amandalal143/github-demo-noval/Grooving Servo Machine/1. Legal/2. Costing Sheet Servo control panel Maadhave.xlsx

Sheet: Sheet6
Row Labels | Sum of Total Price | last quotation
HMI PANEL | 22544.225 | 25000
MAIN PANEL | 180148.9196 | 155000
SERVO PACKAGE | 49295.4 | 72000
(blank)
Grand Total | 251988.5446 | 252000
 |  | 20000

Sheet: BOM
Sr. No. | Item Description | Drawing Nomenculture | Item Specification | Item make | QTY
1 | PLC | PLC | FX5U-32MT/ES | MITSUBISH | 1
2 | HMI | HMI | GS2107-WTBDN | MITSUBISH | 1
3 | SERVO AMPLIFIER | X AXIS SERVO | MR-J4-70C | MITSUBISH | 1
4 | SERVO MOTOR | - | HG-KR73J | MITSUBISH | 1
5 | SERVO MOTOR POWER CABLE | - | MR-PWS2CBL05M-A2-L | MITSUBISH | 1
6 | SERVO MOTOR ENCODER CABLE | - | MR-J3ENCBL5M-A2-L | MITSUBISH | 1
7 | SERVO AMPLIFIER BATTERY | - | MR-J3CN1 | MITSUBISH | 1
8 | VFD | VFD 01 | FR-D740-050-E16 (2.2K) | MITSUBISH | 1
9 | Proximity Sensors | PH01~PH03 | E2B-M12KS04-WP-C1 | OMRON | 3
10 | REED SWITCH | RS1 ~ RS6 | D-M9ML (NPN) | SMC | 6
11 | REED SWITCH BRACKET | - | BM5-020 | SMC | 2
12 | REED SWITCH BRACKET | - | BJ6-016 | SMC | 2
13 | REED SWITCH BRACKET | - | BMB5-032 | SMC | 2
14 | SMPS | SMPS | S8VK-C06024/ED2 | OMORN | 1
15 | MAIN RCCB | RCCB01 | A9N19668 | SCH | 1
16 | SPINDLE MCB | MCB03 | A9N3P10C | SCH | 1
17 | SERVO POWER MCB | MCB04 | A9N2P06C | SCH | 1
18 | UTILITY MCB | MCB01 | A9N2P06C | SCH | 1
19 | SPINDLE BRAKE MCB | MCB06 | A9N2P06C | SCH | 1
20 | MCB PLC & SMPS | MCB05 | A9N2P06C | SCH | 1
21 | MCB EXHAUST FAN | MCB02 | A9N2P06C | SCH | 1
22 | Main Contactor |  | LC1D32M7 220V AC | SCH | 1
23 | Ethernet HUB | HUB01 | FL1005 | Phoenix | 1
24 | 24DC CP | CP01 | CP30FI2A | FUJI | 1
25 | PANEL EX FAN |  | 4" | GM | 1
26 | FAN FILTER WITH ZALI |  | 4" | GM | 2
27 | PANEL LIGHT |  | ASTRA LINE 5-WATT 1-FEET LED | PHILIPS | 1
28 | DOOR SWITCH |  | ESSOS | ESSOS | 1
29 | TOWER LIGHT |  | MR4-302B-RYG | PATLIGHT | 1
30 | EMG Switch |  | XB5AW74B2N | SCH | 1
31 | RELAY MY2N |  | MY4N WITH BASE | Omron | 9
32 | PUSH BUTTON |  | XB5AA42N | SCH | 3
33 | SELECTOR SWITCH |  | XB5AD53N | SCH | 3
34 | NOISE FILTER | NF01 | RSHN-2006 | TDK | 1

Sheet: Sheet1
Sr. No. | Item Description | Item Specification | Item make | Required Quantity | Item List Price | List Total | Discount | Price | LPP | Profit | Final Price | Total Price | Type | Head | Supplier
1 | PLC | FX5U-32MT/ES | MITSUBISH | 1 | 51300 | 51300 | 60 | 20520 | 21033 | 10 | 22572 | 22572 | SPARE | MAIN PANEL | SK
2 | HMI | GS2107-WTBDN | MITSUBISH | 1 | 13000 | 13000 | 0 | 13000 | 13000 | 10 | 14300 | 14300 | SPARE | HMI PANEL | SK
3 | SERVO AMPLIFIER | MR-J4-70C | MITSUBISH | 1 | 52800 | 52800 | 58 | 22176 | NEW | 10 | 24393.6 | 24393.6 | SPARE | SERVO PACKAGE | SK
4 | SERVO MOTOR | HG-KR73J | MITSUBISH | 1 | 45700 | 45700 | 58 | 19194 | NEW | 10 | 21113.4 | 21113.4 | SPARE | SERVO PACKAGE | SK
5 | SERVO MOTOR POWER CABLE | MR-PWS2CBL05M-A2-L | MITSUBISH | 1 | 1800 | 1800 | 58 | 756 | 4300 | 10 | 831.6 | 831.6 | SPARE | SERVO PACKAGE | SK
6 | SERVO MOTOR ENCODER CABLE | MR-J3ENCBL5M-A2-L | MITSUBISH | 1 | 4300 | 4300 | 58 | 1806 | 4300 | 10 | 1986.6 | 1986.6 | SPARE | SERVO PACKAGE | SK
7 | SERVO AMPLIFIER BATTERY | MR-J3CN1 | MITSUBISH | 1 | 2100 | 2100 | 58 | 882 | 1450 | 10 | 970.2 | 970.2 | SPARE | SERVO PACKAGE | SK
8 | VFD | FR-D740-050-E16 (2.2K) | MITSUBISH | 1 | 41200 | 41200 | 65 | 14420 | 0 | 20 | 17304 | 17304 | SPARE | MAIN PANEL
9 | Proximity Sensors |  | OMRON | 3 | 1700 | 5100 | 0 | 1700 |  | 10 | 1870 | 5610 | SPARE | MAIN PANEL
10 | REED SWITCH | D-M9ML (NPN) | SMC | 6 | 1356 | 8136 | 3 | 1315.32 | 0 | 10 | 1446.852 | 8681.112 | SPARE | MAIN PANEL
11 | REED SWITCH BRACKET | BM5-020 | SMC | 2 | 307 | 614 | 3 | 297.79 | 0 | 10 | 327.569 | 655.138 | SPARE | MAIN PANEL
12 | REED SWITCH BRACKET | BJ6-016 | SMC | 2 | 297 | 594 | 3 | 288.09 | 0 | 10 | 316.899 | 633.798 | SPARE | MAIN PANEL
13 | REED SWITCH BRACKET | BMB5-032 | SMC | 2 | 169 | 338 | 3 | 163.93 | 0 | 10 | 180.323 | 360.646 | SPARE | MAIN PANEL
14 | SMPS | S8VK-C06024/ED2 | OMORN | 1 | 1350 | 1350 | 0 | 1350 | 1350 | 10 | 1485 | 1485 | SPARE | MAIN PANEL | IN STOCK
15 | MAIN RCCB | A9N19668 | SCH | 1 | 6465 | 6465 | 72 | 1810.2 | NEW | 10 | 1991.22 | 1991.22 | SPARE | MAIN PANEL | MUNDHRA
16 | SPINDLE MCB | A9N3P10C | FUJI | 1 | 1355 | 1355 | 75 | 338.75 | 544.25 | 10 | 372.625 | 372.625 | SPARE | MAIN PANEL | MUNDHRA
17 | SERVO POWER MCB | A9N2P06C | FUJI | 1 | 1312 | 1312 | 75 | 328 | 338.75 | 10 | 360.8 | 360.8 | SPARE | MAIN PANEL | MUNDHRA
18 | UTILITY MCB | A9N2P06C | SCH | 2 | 1312 | 2624 | 75 | 328 | 338.75 | 10 | 360.8 | 721.6 | SPARE | MAIN PANEL | IN STOCK
19 | SPINDLE BRAKE MCB |  | SCH | 2 | 1312 | 2624 | 75 | 328 | 0 | 10 | 360.8 | 721.6 | SPARE | MAIN PANEL
20 | Main Contactor | LC1D32M7 220V AC | SCH | 1 | 6015 | 6015 | 62 | 2285.7 | 0 | 10 | 2514.27 | 2514.27 | SPARE | MAIN PANEL
21 | Ethernet HUB | FL1005 | Phoenix | 1 | 4500 | 4500 | 0 | 4500 | 0 | 10 | 4950 | 4950 | SPARE | MAIN PANEL
22 | 24DC CP | CP30FI2A | FUJI | 1 | 2256 | 2256 | 0 | 2256 | 2256 | 10 | 2481.6 | 2481.6 | SPARE | MAIN PANEL | IN STOCK
23 | PANEL EX FAN | 4" | HICOOL | 1 | 300 | 300 | 0 | 300 | 300 | 10 | 330 | 330 | SPARE | MAIN PANEL | MUNDHRA
24 | FAN FILTER WITH ZALI | 4" | GM | 2 | 50 | 100 | 0 | 50 | 50 | 10 | 55 | 110 | SPARE | MAIN PANEL | MUNDHRA
25 | PANEL LIGHT | 4" | PHILIPS | 1 | 279 | 279 | 0 | 279 | 200 | 10 | 306.9 | 306.9 | SPARE | MAIN PANEL | MUNDHRA
26 | DOOR SWITCH | ESSOS | ESSOS | 1 | 250 | 250 | 0 | 250 | 276 | 10 | 275 | 275 | SPARE | MAIN PANEL | IN STOCK
27 | TOWER LIGHT | MR4-302B-RYG | PATLIGHT | 1 | 2860 | 2860 | 0 | 2860 | 2650 | 10 | 3146 | 3146 | SPARE | HMI PANEL | SHEORON CONTROLS
28 | CONTROL PANEL | 600x1000x300 | BCH | 1 | 14555 | 14555 | 35 | 14130 | 9485 | 10 | 15543 | 15543 | SPARE | MAIN PANEL | MUNDHRA
29 | MISCELLIONOUS | (Cables, Thimbles, Duct, Channel etc.) | MAINTICS | 1 | 5000 | 5000 | 0 | 5000 | NA | 10 | 5500 | 5500 | SPARE | MAIN PANEL | MUNDHRA
30 | GOT BOX | 300X400X200 | BCH | 1 | 4855 | 4855 | 35 | 3155.75 | NEW | 10 | 3471.325 | 3471.325 | SPARE | HMI PANEL | MUNDHRA
31 | TERMINALS | UKK5 | Phoenix | 100 | 52.87 | 5287 | 30 | 37.009 | 33.15 | 10 | 40.7099 | 4070.99 | SPARE | MAIN PANEL | MUNDHRA
32 | Terminals | TB16 EI | Phoenix | 6 | 33.13 | 198.78 | 30 | 23.191 | 21.53 | 10 | 25.5101 | 153.0606 | SPARE | MAIN PANEL | MUNDHRA
33 | EMG Switch | RED | SCH | 1 | 1086 | 1086 | 50 | 543 | 490 | 10 | 597.3 | 597.3 | SPARE | HMI PANEL | MUNDHRA
34 | RELAY MY4N | MY4N WITH BASE | Omron | 0 | 210 | 0 | 0 | 210 | 230 | 10 | 231 | 0 | SPARE | MAIN PANEL | IN STOCK
35 | RELAY MY2N | MY4N WITH BASE | Omron | 9 | 210 | 1890 | 0 | 210 | 230 | 10 | 231 | 2079 | SPARE | MAIN PANEL | IN STOCK
36 | PUSH BUTTON | MULTICOLOR | SCH | 3 | 180 | 540 | 50 | 90 | 190 | 10 | 99 | 297 | SPARE | HMI PANEL | MUNDHRA
37 | SELECTOR SWITCH | 2 POS | SCH | 3 | 444 | 1332 | 50 | 222 | 190 | 10 | 244.2 | 732.6 | SPARE | HMI PANEL | MUNDHRA
38 | SPINLDE BRAKE CONTACTOR | SC 11 A G-E 10 | FUJI | 1 | 3770 | 3770 | 52 | 1809.6 | NEW | 10 | 1990.56 | 1990.56 | SPARE | MAIN PANEL | MUNDHRA
39 | NOISE FILTER | RSHN-2006 | TDK | 1 | 3250 | 3250 | 0 | 3250 | 3250 | 10 | 3575 | 3575 | SPARE | MAIN PANEL | IN STOCK
40 | PANEL LABOUR |  | MAINTICS | 0 | 22000 | 0 | 10 | 19800 | NA | 0 | 19800 | 0 | SERVICE | MAIN PANEL | MAINTICS
41 | PROGRAMMING LABOUR |  | MAINTICS | 1 | 80000 | 80000 | 6.5 | 74800 | NA | 0 | 74800 | 74800 | SERVICE | MAIN PANEL | MAINTICS
