amandalal143/github-demo-noval/Grooving Servo Machine/4. Drawing and Manual/PLC IO MAPPING.xlsx

Sr. No. | Input No | Description | Output No | Description
 | X0 | AUTO/MANUAL SS | Y00 | AUTO RUN IL
 | X1 | AUTO START PB | Y01 | PATLIGHT RED & BUZZER
 | X2 | AUTO STOP PB | Y02 | PATLIGHT Y
 | X3 | JOG FWD SS | Y03 | PATLIGHT G
 | X4 | JOG REV SS | Y04 | COOLANT PUMP
 | X5 | EMG SWITCH EMG | Y05 | VFD FWD RUN
 | X6 | VFD ALARM | Y06 | VFD ALARM RESET
 | X7 | MACHINE HOME PH | Y07 | FEED CYL RS FWD
 | X10 | FWD LIMIT PH | Y10 | FEED CYL RS REV
 | X11 | REV LIMIT PH | Y11 | MAT CYL RS FWD
 | X12 | FEED CYL RS FWD | Y12 | MAT CYL RS REV
 | X13 | FEED CYL RS REV | Y13 | CLAMP CYL RS FWD
 | X14 | MAT CYL RS FWD | Y14 | CLAMP CYL RS REV
 | X15 | MAT CYL RS REV | Y15
 | X16 | CLAMP CYL RS FWD | Y16
 | X17 | CLAMP CYL RS REV | Y17
