amandalal143/github-demo-noval/(list of files, cad)

Other CAD files:
Grooving Servo Machine/4. Drawing and Manual/Groove cutting machine drawing (1).dwg
