amandalal143/github-demo-noval/Grooving Servo Machine/4. Drawing and Manual/Maadhav Operation Manual.pptx

MAADHAV AUTOMOTIVE
FASTENERS PVT. LTD.

Product Manual

GROOVING MACHINE 02
(Electrical Renewal Project)
Done By
MAINTICS AUTOMATION & ROBOTICS LLP

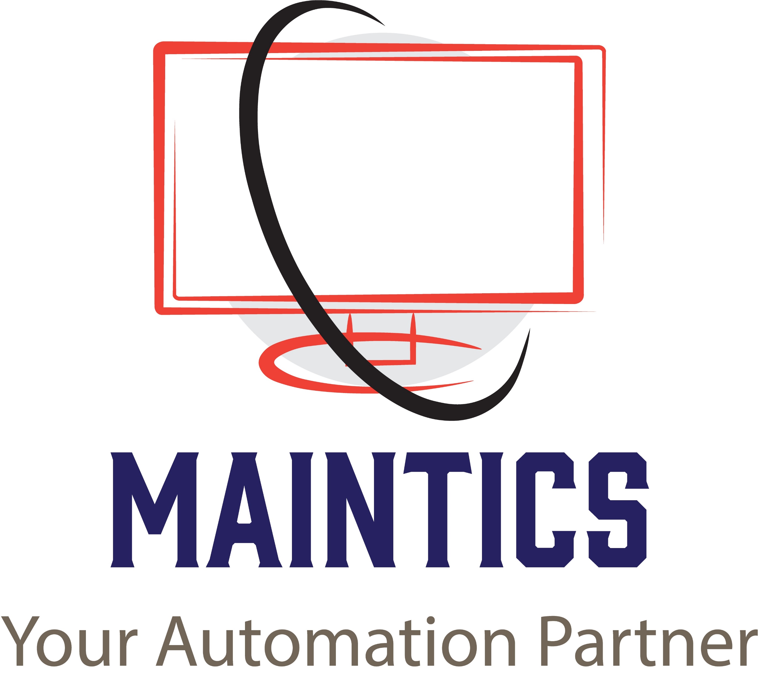
[picture p1: figure]

## Table Of Contents

- Operation Manual
- Electrical Drawing
- Troubleshooting Guide
- BOM (Bill of Material)

(C) Maintics Automation & Robotics LLP

## Slide 3

Operation Manual

## Company Profile Screen

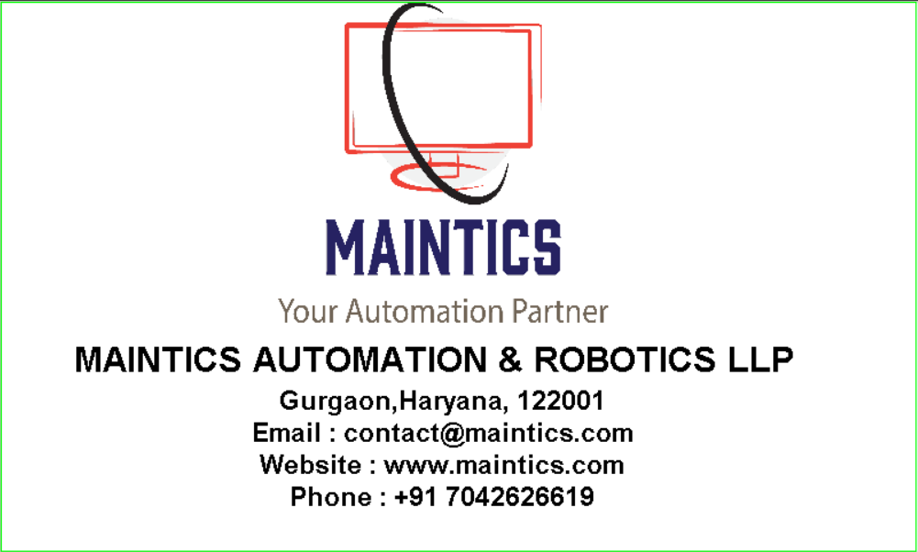
[picture p2: figure]

At first when you turn on the Machine this screen will open.
This is the Company Introduction screen.
Click anywhere in the screen to navigate on Main Menu

## 1. MAIN MENU SCREEN

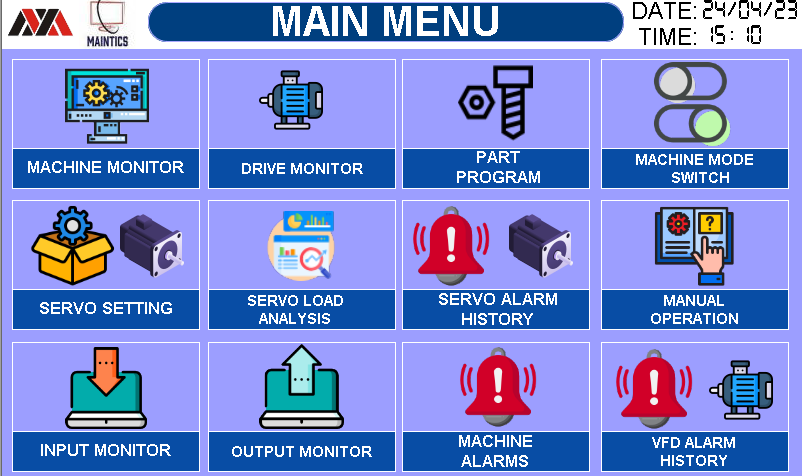
[picture p3: figure]

This Screen is for Navigation inside the HMI of below screens.
Below are the list of all available screen in the HMI.
1. MACHINE MONITOR
2. DRIVE MONITOR
3. PART PROGRAM
4. MACHINE MODE SWITCH
5. SERVO SETTING
6. SERVO LOAD ANALYSIS
7. SERVO ALARM HISTORY
8. MANUAL OPERATION
9. INPUT MONITOR
10. OUTPUT MONITOR
11. MACHINE ALARMS
12. VFD ALARMS HISTORY

## 2. PROCESS MONITOR SCREEN

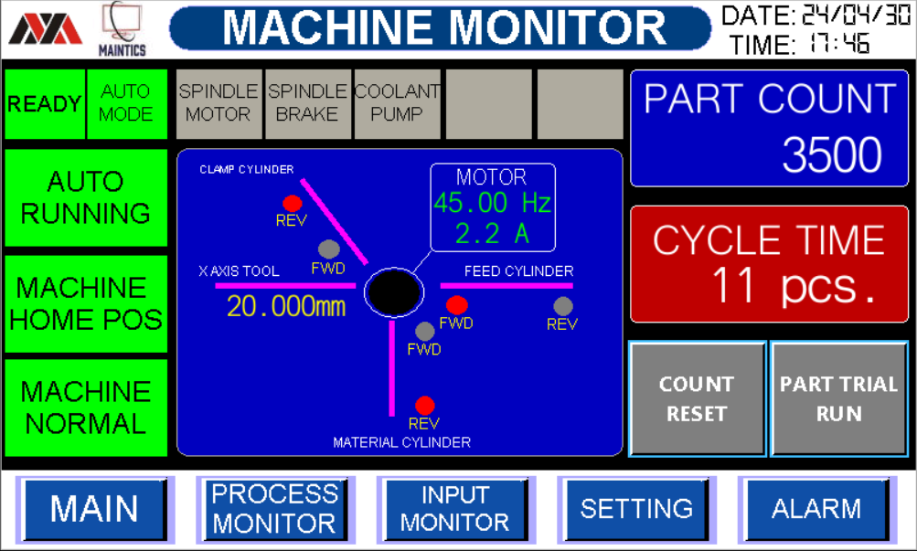
[picture p4: figure]

This screen is to Monitor Whole machine at Single Place

1. Machine Ready Status
2. Machine Auto / Manual Mode Status
3. Machine Auto Running Status
4. Device Running Status
5. Home Position Indication and Fault Indication

Machine Stopped

Not Ready

Ready

Manual Mode

Auto Mode

Auto Running

Device Running

Device OFF

Not at Home

Normal

Fault

Machine at Home

## Slide 7

2. PROCESS MONITOR SCREEN

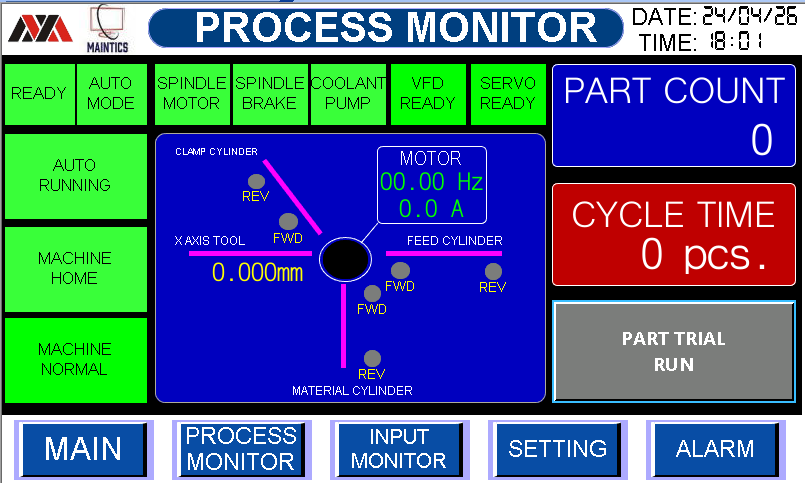
[picture p5: figure]

This screen is to Monitor Whole machine at Single Place

6. Total Parts count Cumulative and Cycle time Parts/min.
7. Machine Inputs Monitoring (Cylinder Reed switch)
8. Navigation Bar

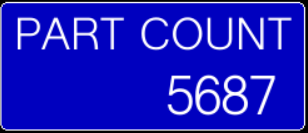
[picture p6: figure]
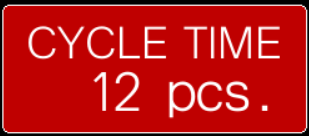
[picture p7: figure]

Here you can monitor all reed switch condition On or Off.
- Feed Cylinder
- Material Cylinder
- Clamp Cylinder
- X Axis Cylinder
- Y Axis Cylinder
- SPINDLE MOTOR STATUS

Used to easily navigate from one screen to another screen

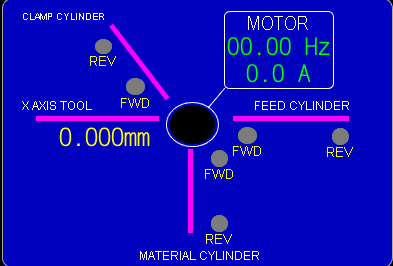
[picture p8: figure]

## Slide 8

3.INPUT MONITOR SCREEN

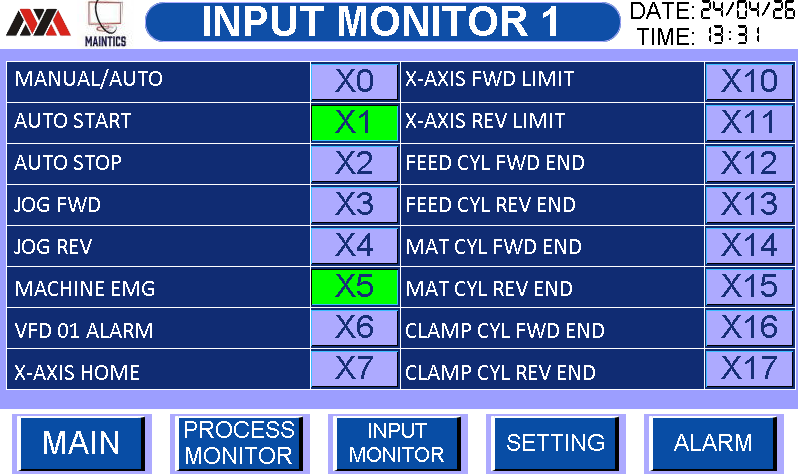
[picture p9: figure]

This screen is to monitor all PLC Inputs total 16 Nos.

1. All inputs status from Off to On is as below

INPUT OFF

INPUT ON

MACHINE EMARGENCY PRESSED

MACHINE EMARGENCY NOT PRRESSED

## Slide 9

4. OUTPUT MONITOR SCREEN

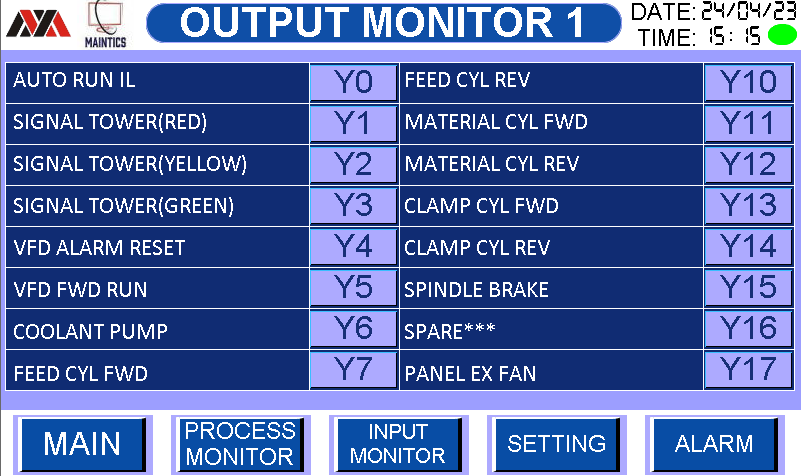
[picture p10: figure]

This screen is to monitor all PLC Outputs total 16Nos.

1. All Output status from Off to On is as below

OFF
ON

## Slide 10

5. ALARM MONITOR SCREEN

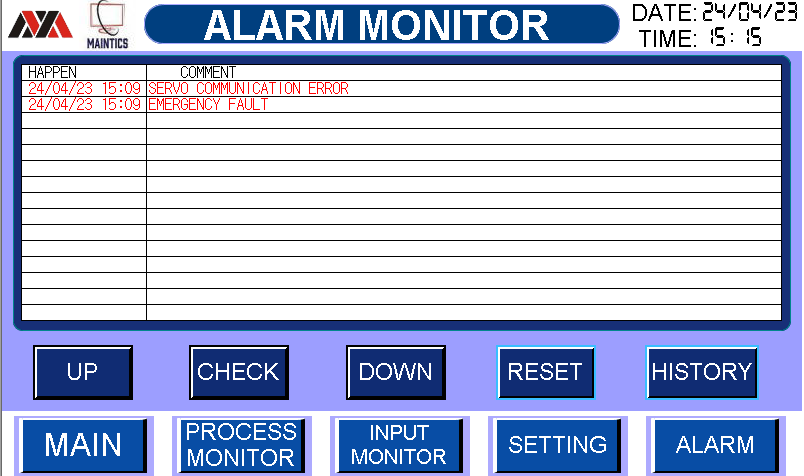
[picture p11: figure]

This screen is used to monitor machine current alarms

1. Alarm screen navigation buttons
2. Reset button to reset current Alarms
3. Alarm History Screen access Button

## Slide 11

5. ALARM HISTORY SCREEN

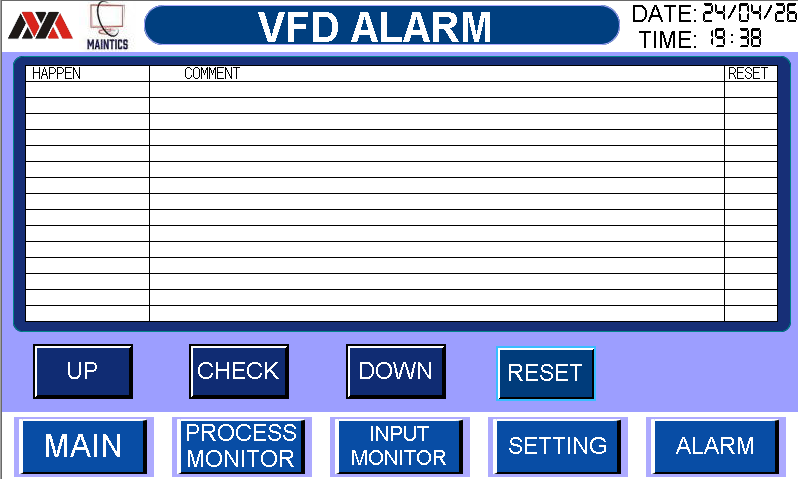
[picture p12: figure]
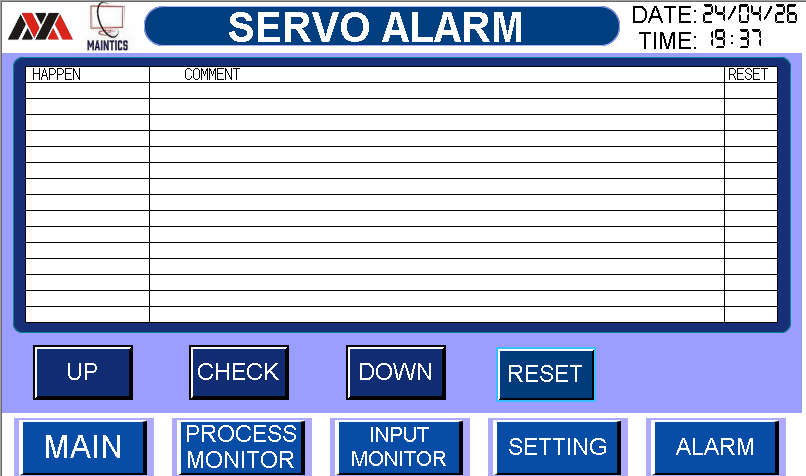
[picture p13: figure]

This screen is used to monitor machine current alarms

1. Alarm screen navigation buttons

## Slide 12

6. MODE SELECT SETTING SCREEN

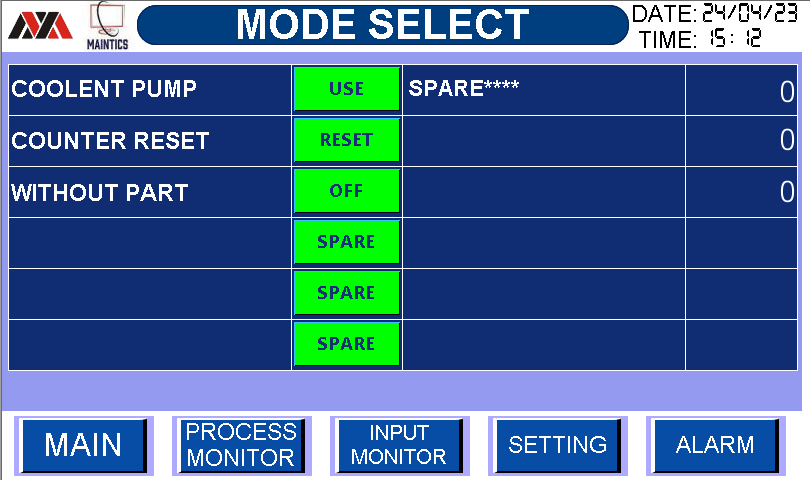
[picture p14: figure]
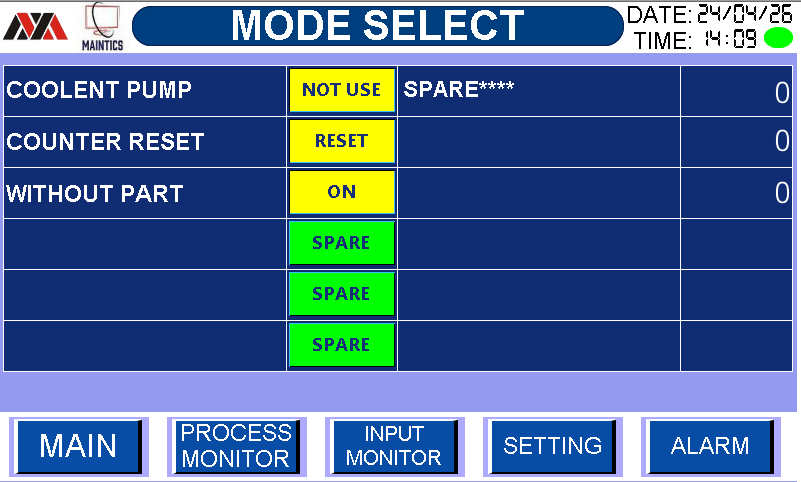
[picture p15: figure]

Machine Settings can be done from this screen.

1. COOLENT PUMP USE
2. COOLENT PUMP NOT USE
3. COUNTER RESET
4. WITHOUT PART OFF
5. WITHOUT PART ON

## Slide 13

7. MANUAL OPEARTION 1 SCREEN

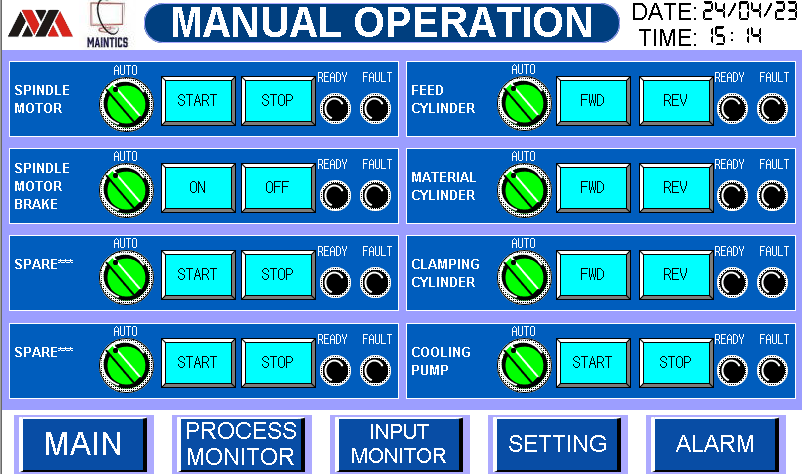
[picture p16: figure]

Manual Operation of all device can be performed using this screen

1. Steps for manual operation
  a. First check Fault Light it should be Off
  b. Now check Ready Light it should be Green
  c. Now press Auto Manual selector switch to change mode from Auto to manual
  d. Now Press Start Button to Start the Device
  e. It will glow green if device is started.

## Slide 14

8. PART PROGRAM SCREEN

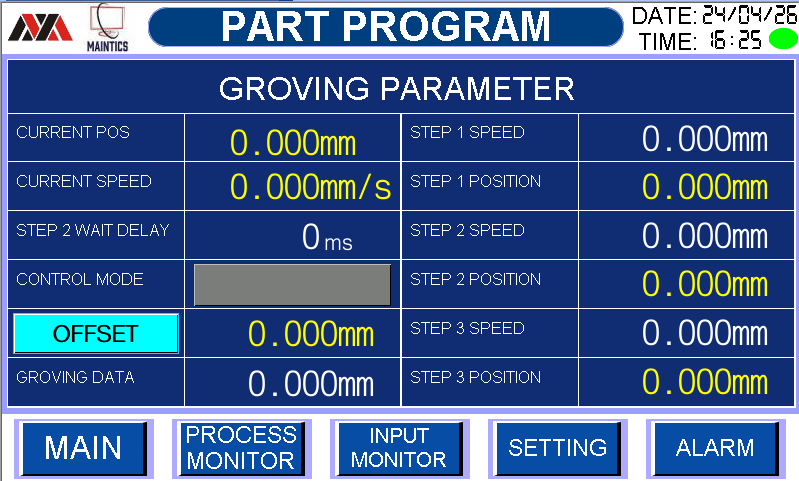
[picture p17: figure]

Here you can change grooving Program
1. STEP 2WAIT DELAY VALUE 6. STEP 3 SPEED VALUE
2. OFFSET VALUE
3. GRONING DATA VALUE
4. STEP 1 SPEE VALUE
5. STEP 2 SPEED VALUE

## Slide 15

8. PART PROGRAM SCREEN

Here you can change grooving Program
1. STEP 2WAIT DELAY VALUE 6. STEP 3 SPEED VALUE
2. OFFSET VALUE
3. GRONING DATA VALUE
4. STEP 1 SPEE VALUE
5. STEP 2 SPEED VALUE

## SERVO LOAD GRAPH

9. SERVO LOAD SCREEN

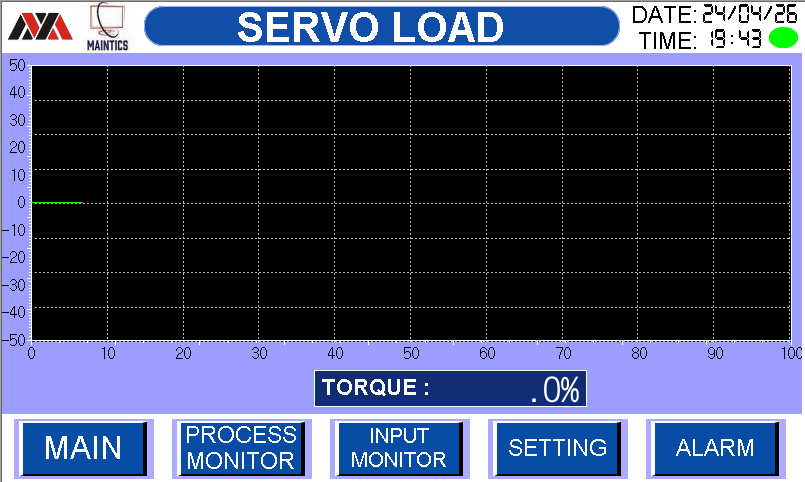
[picture p18: figure]

## Slide 17

10. SERVO SETTING SCREEN

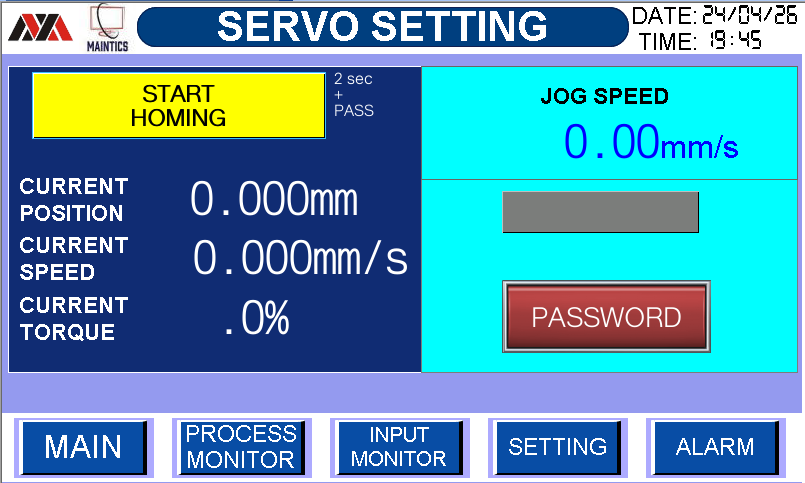
[picture p19: figure]

SERVO MOTOR HOMING STATUS
1. CURRENT OPSOTION (0.000MM)
2. CURRENT SPEED (0.000MM/s)
3. CURRENT TORQUE (0.0%)

SERVO MOTOR JOG SPEED
1. JOG SPEED MIN MAX
(0.01mm/s) (10.00mm/s)

## Slide 18

11. DRIVE MONITOR SCREEN

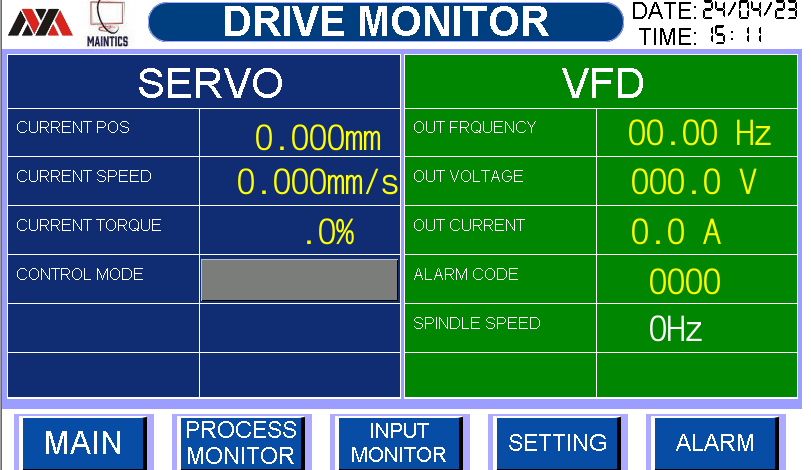
[picture p20: figure]

DRIVE MONITOR STATUS
1. Here you can monitor SERVO & VFD STATUS
2. Here you can change SPINDLE SPEED
MIN MAX
25Hz 60Hz

## Electrical Drawings

## Troubleshooting Guide

## Slide 21

1. HMI ALARM GUIDE

## Slide 22

2. MACHINE AUTO RUNNING FLOW

STOP

START PB

MACHINE HOME

MACHINE AUTO

Check Reed Switch
X20, X22 if NO

NO

YES

Check Manual Screen
If NO

NO

YES

Check Alarm Screen
For any alarm reset alarm before if NO

MACHINE NORMAL

NO (FAULT)

YES

AUTO RUNNING

## BOM (BILL OF MATERIAL)

## Slide 24

1. LIST OF ITEMS USED
