amandalal143/github-demo-noval/Grooving Servo Machine/4. Drawing and Manual/Maadhav Operation Manual02 v3.pptx

MAADHAV AUTOMOTIVE
FASTENERS PVT. LTD.

Product Manual

GROOVING MACHINE 02
(Electrical Renewal Project)
Done By
MAINTICS AUTOMATION & ROBOTICS LLP


## Table Of Contents

1. Operation Manual
2. Electrical Drawing
3. Troubleshooting Guide
4. BOM (Bill of Material)
5. Device Manual/Catalogue

(C) Maintics Automation & Robotics LLP

## Slide 3

Operation Manual

## Company Profile Screen


At first when you turn on the Machine this screen will open.
This is the Company Introduction screen.
Click anywhere in the screen to navigate on Main Menu

## MAIN MENU SCREEN

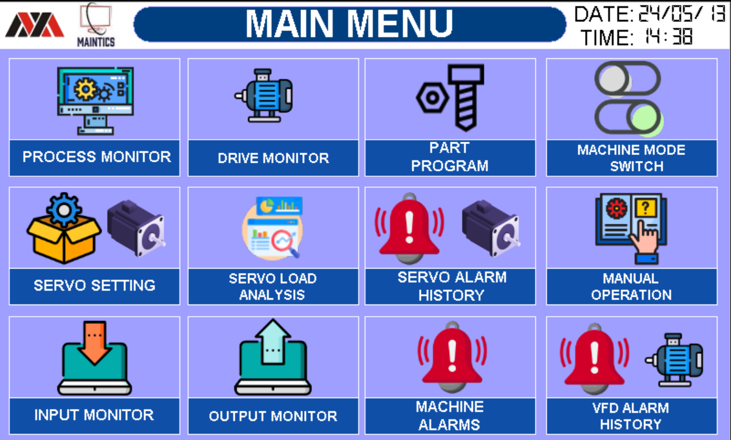
[picture p21: figure]

This Screen is for Navigation inside the HMI of below screens.
Below are the list of all available screen in the HMI.
1. PROCESS MONITOR
2. DRIVE MONITOR
3. PART PROGRAM
4. MACHINE MODE SWITCH
5. SERVO SETTING
6. SERVO LOAD ANALYSIS
7. SERVO ALARM HISTORY
8. MANUAL OPERATION
9. INPUT MONITOR
10. OUTPUT MONITOR
11. MACHINE ALARMS
12. VFD ALARMS HISTORY

## 1. PROCESS MONITOR SCREEN

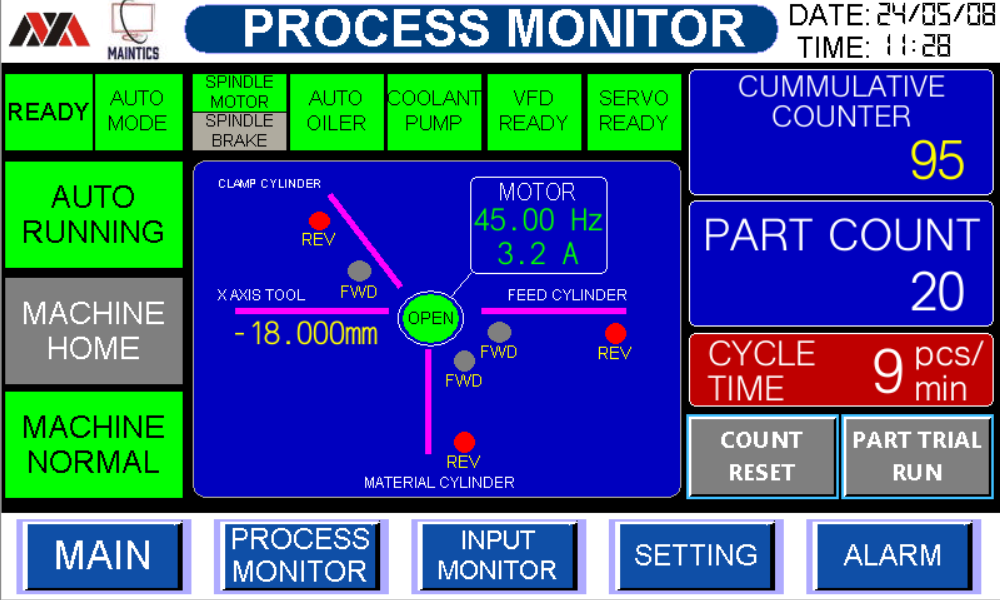
[picture p22: figure]

This screen is to Monitor Whole machine at Single Place

1

2

2

2

Sr. No. | Parameter Name | State 0 | State 1 | State 2 | Remarks
1 | Machine Ready | Not Ready | Ready | | Machine ready status
2 | Manual Mode | Manual Mode | Auto Mode
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
1. Machine Ready Status
2. Machine Auto / Manual Mode Status
3. Machine Auto Running Status
4. Device Running Status
5. Home Position Indication and Fault Indication

Device OFF

Device Running

Not at Home

Normal

Machine at Home

Machine Fault

## Slide 7

1. PROCESS MONITOR SCREEN

This screen is used to Machine Monitor current alarms & Status

6. Servo & VFD Alarm Status

Servo & VFD Alarm ON SERVO & VFD Is Ready to Use

7. COUNTER RESET & PART TRIAL RUN Status

*Counter Reset Button is ON

To Reset Part Count, Press this Button for 2second.

*Part trial Button is ON

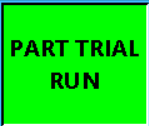
[picture p23: figure]

This Button used for part trial.

(Machine for run for 1cycle only)

## Slide 8

1. PROCESS MONITOR SCREEN

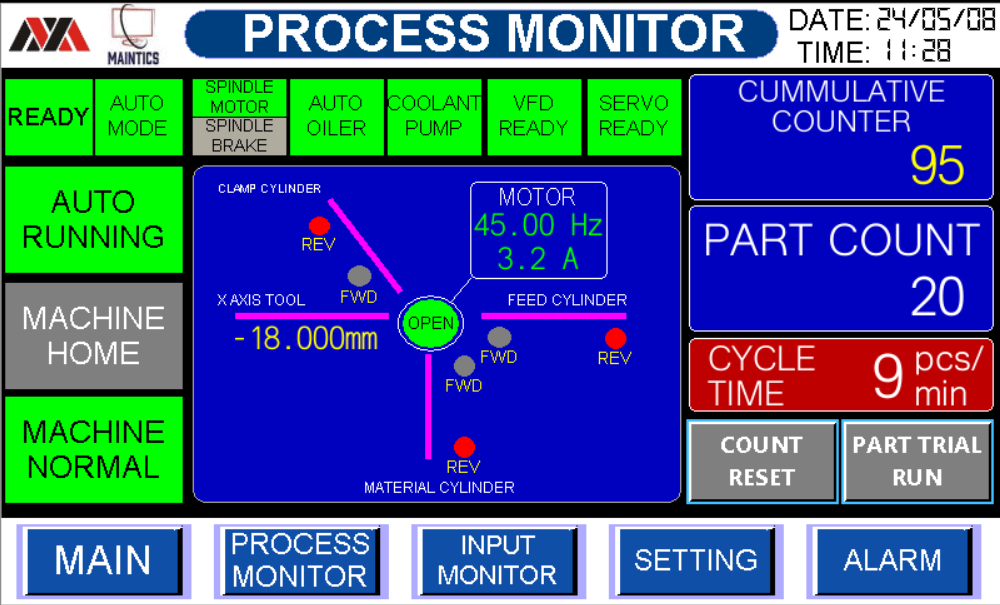
[picture p24: figure]

This screen is to Monitor Whole machine at Single Place

8. Total Parts count & Cumulative Counter and Cycle time … Parts/min.
9. Machine Inputs Monitoring (Cylinder Reed switch)
10. Navigation Bar

Here you can monitor all reed switch condition On or Off.
- Feed Cylinder
- Material Cylinder
- Clamp Cylinder
- X Axis Servo position
- SPINDLE MOTOR STATUS
(Monitor Running Frequency & Current)

Used to easily navigate from one screen to another screen

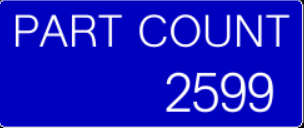
[picture p25: figure]
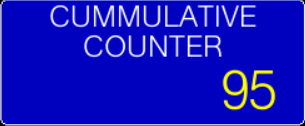
[picture p26: figure]
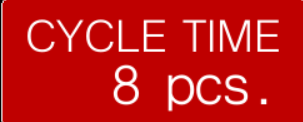
[picture p27: figure]
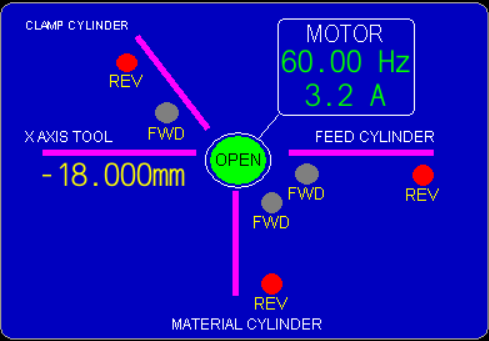
[picture p28: figure]

## Slide 9

2. DRIVE MONITOR SCREEN

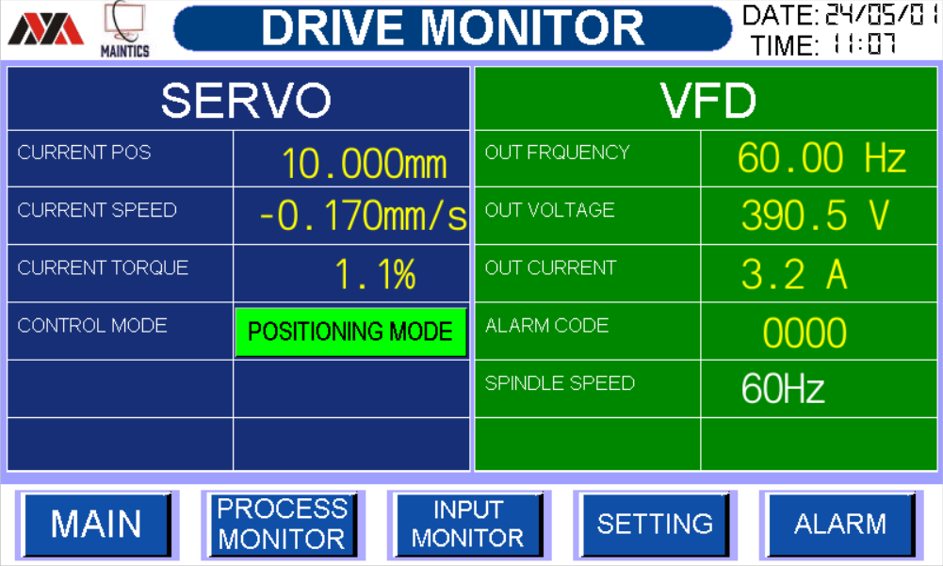
[picture p29: figure]

DRIVE MONITOR STATUS:
1. Here you can monitor SERVO & VFD STATUS.
SERVO:
a) Here you can monitor servo current position.
b) Here you can monitor servo current speed.
c) Here you can monitor servo Current Torque.
VFD:
a) Here you can monitor VFD Frequency.
b) Here you can monitor VFD Voltage.
c) Here you can monitor VFD Current.
d) Here you can monitor VFD Alarm Code.
2. Here you can change SPINDLE SPEED Using Frequency (Hz)
MIN MAX
25Hz 60Hz

## Slide 10

3. PART PROGRAM SCREEN

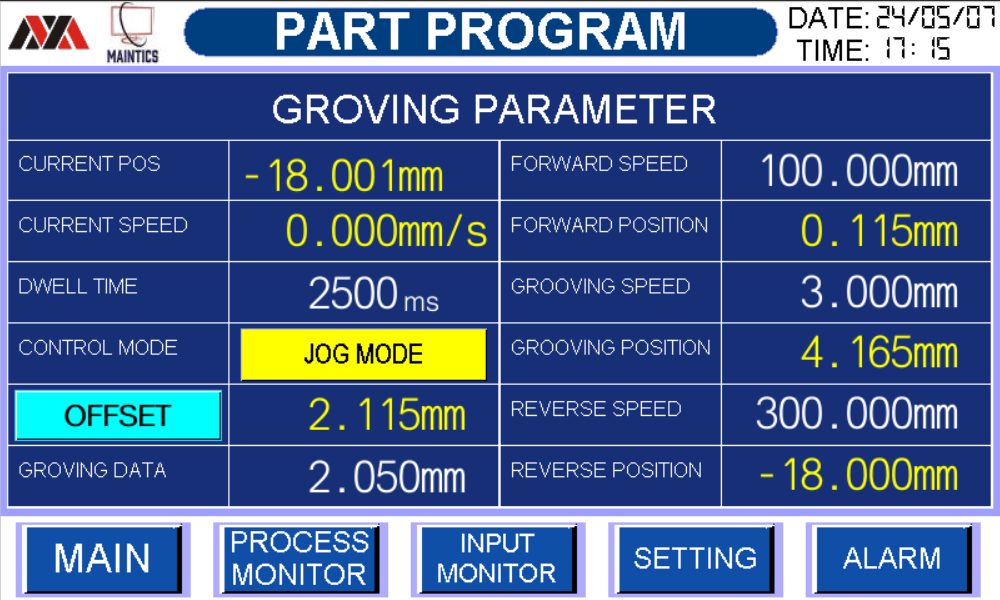
[picture p30: figure]

1. Here you can change grooving Program.
a) DWELL VALUE. * (Here you Can Change Dwell
time in milliseconds )
b) OFFSET VALUE. * (Here you can set Part Offset
Value Press button to get offset value)
c) GROOVING DATA VALUE. * (Here you can set Grooving
Data Value.)
d) FORWARD SPEED VALUE. * (Here you can set Servo
Forward SPEED VALUE.)
e) GROOVING SPEED VALUE. * (Here you can set Servo
Grooving SPEED VALUE.)

## Slide 11

3. PART PROGRAM SCREEN

1. Here you can change grooving Program

f) Reverse SPEED VALUE (Here you can change
Servo Reverse Speed
Value. )

2. Here you can monitor Positioning mode &
Jog mode
a) Here You can Check
POSITION MODE is ON .
b) Here You can Check Jog
MODE is ON .

## Slide 12

4. MODE SELECT SETTING SCREEN

Machine Settings can be done from this screen.

1. COOLENT PUMP ON Condition
2. COOLENT PUMP Off (Bypass) Condition
3. COUNTER RESET BUTTION
4. WITHOUT Part OFF Condition
5. WITHOUT Part ON Condition (Machine run without part also)

## Slide 13

4. MODE SELECT SETTING SCREEN

Machine Settings can be done from this screen.

6. OILER DELAY Cycle
* Here you can change Oiler Delay Cycle value.
(After 1000 parts cycle Oiler pump will ON)
7. OILER RUN TIME Sec.
* Here you can change Oiler Run Time Sec.
(After 1000 parts pump ON for 10sec.)
8. COMMULATIVE COUNTER RESET BUTTION
9. AUTO OILER ON Condition (Press this button to run pump manually )

## Slide 14

4. MODE SELECT SETTING SCREEN

Machine Settings can be done from this screen.

10. Here You can decide the value of current torque ,part detect lower torque and part detect upper torque.
First note down the value of torque when part is available in the machine ,and also note the value of torque when part is not available in the machine. Perform this operation for at least 4 to 5 times. You can observe torque is always greater when part is available with respect to when part is not available in the machine.
Now according to the observation of torque value you can fill the value of
11. PART DETECT LOWER AND PART DETECT UPPER VALUE.
Make sure current torque value (when part is available) is within the range of part detect lower and upper torque value.

## Slide 15

4. MODE SELECT SETTING SCREEN

Machine Settings can be done from this screen.

11. PART DETECT LOWER
* Here You Can Change part Detect Lower Value.
12. PART DETECT UPPER
* Here You Can Change Part Detect Upper Value.
13. Here You Can Check Live SERVO MOTOR TORQUE.
* Make sure current torque(When part is present) is within the range of part detect lower & upper value then it part is counted by counter And if this condition is not
satisfied the part will not count.

## Slide 16

05. SERVO SETTING SCREEN

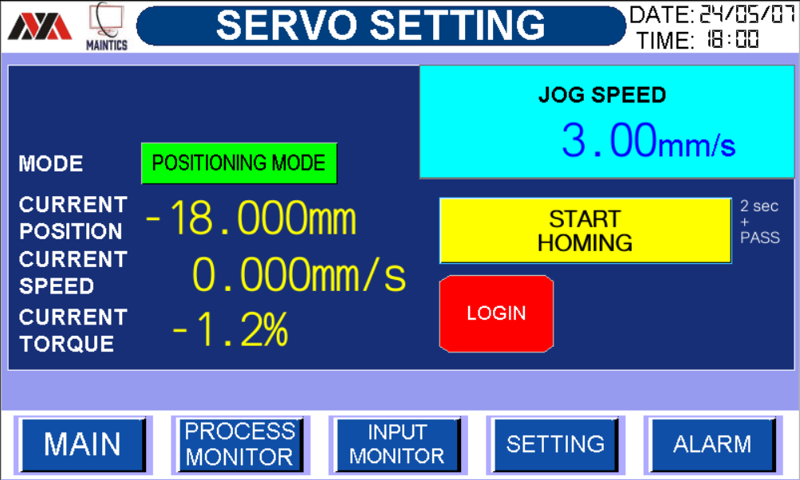
[picture p31: figure]

* Here you can enter the Required Password.

- Here you can monitor entered Password is correct
. And after homing complete 1cycle Logout Automatically.

1. SERVO MOTOR [JOG SPEED.]
JOG SPEED MIN MAX
(0.01mm/s) (25.00mm/s)

## Slide 17

05. SERVO SETTING SCREEN

2. SERVO MOTOR [HOMING MONITORING STATUS]
a) SERVO CURRENT POSITION (-18.000mm)
b) SERVO CURRENT SPEED (0.000mm/s)
c) SERVO CURRENT TORQUE (-1.2%)

3. SERVO HOMING

a) Here you can enter password by clicking on Login Button, Now Press START HOMING Button for 2 Second and servo will Start homing Automatically (Pass: 12345)

* Machine Homing Button OFF.

* Machine Homing is in progress.

* Machine Homing Mode is ON.

## Slide 18

06. SERVO LOAD SCREEN

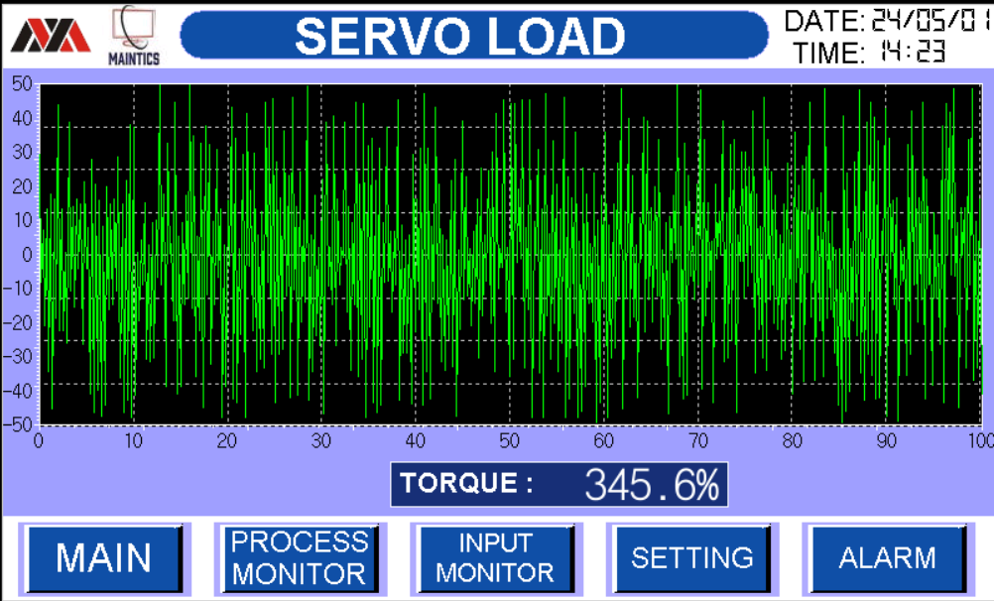
[picture p32: figure]

1. SERVO LOAD GRAPH
  a. You Can monitor servo Torque Live Trend.

## Slide 19

07/12. SERVO+VFD ALARM HISTORY

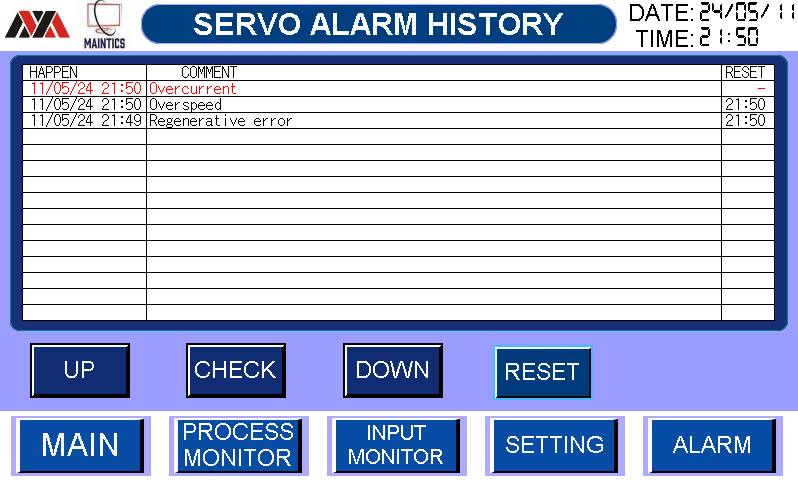
[picture p33: figure]
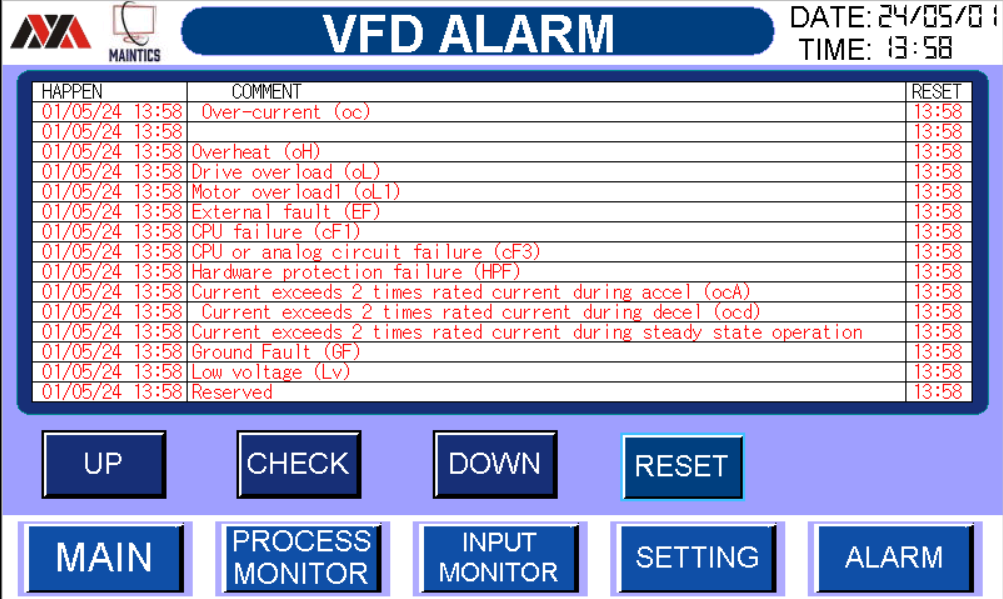
[picture p34: figure]

This screen is used to monitor machine current alarms

1. Alarm screen navigation buttons
2. Reset button to reset current Alarms
3. Alarm History Screen access Button

## Slide 20

08. MANUAL OPEARTION SCREEN


Manual Operation of all device can be performed using this screen

1. Steps for manual operation
  a. First check Fault Light it should be Off(BLACK)
  b. Now check Ready Light it should be Green
  c. Now press Auto Manual selector switch(HMI) to change mode from Auto to manual
  d. Now Press Start Button to Start the Device
  e. It will glow green if device is started.

## Slide 21

09. INPUT MONITOR SCREEN


This screen is to monitor all PLC Inputs total 16 Nos.

1. All inputs status from Off to On is as below.

INPUT OFF

INPUT ON

MACHINE EMARGENCY PRESSED

MACHINE EMARGENCY NOT PRRESSED

## Slide 22

10. OUTPUT MONITOR SCREEN

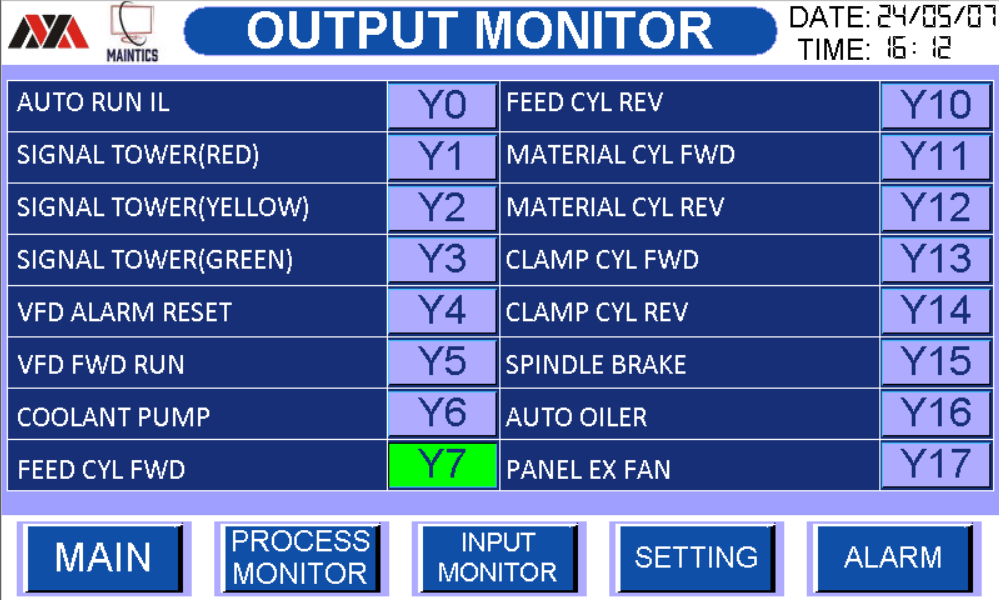
[picture p35: figure]

This screen is to monitor all PLC Outputs total 16Nos.

1. All Output status from Off to On is as below.

OFF
ON

## Slide 23

11. MACHINE ALARM MONITOR

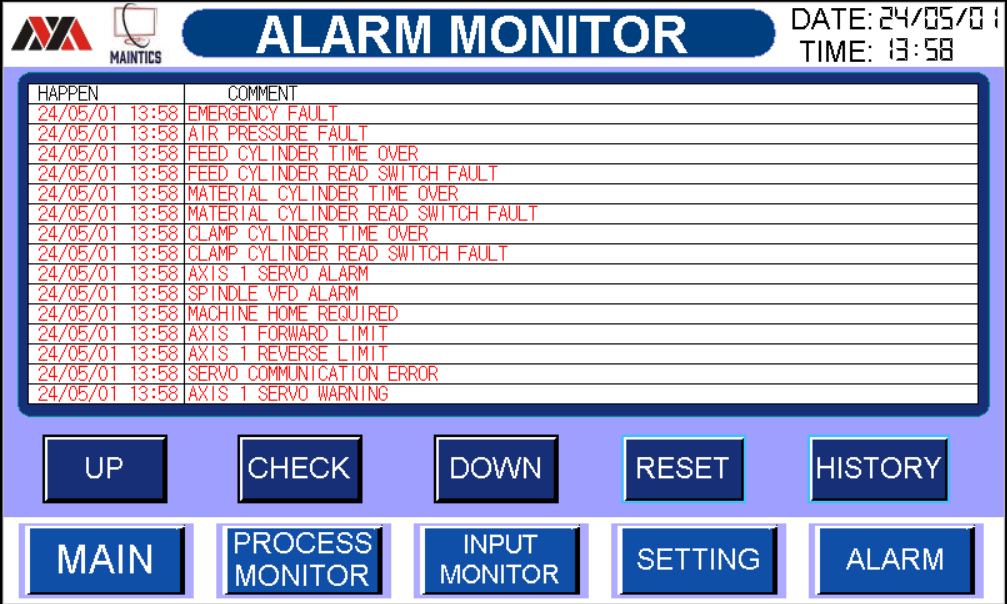
[picture p36: figure]

This screen is used to monitor machine current alarms

1. Alarm screen navigation buttons
2. Reset button to reset current Alarms
3. Alarm History Screen access Button

## Electrical Drawings

## Troubleshooting Guide

## Slide 26

1. HMI ALARM GUIDE

## Slide 27

1. HMI ALARM GUIDE

## Slide 28

2. MACHINE AUTO RUNNING FLOW

STOP

START PB

MACHINE HOME

MACHINE AUTO

Check Reed Switch &
Slide position

NO

YES

Check Manual Screen
If NO

NO

YES

Check Alarm Screen
For any alarm reset alarm before if NO

MACHINE NORMAL

NO (FAULT)

YES

AUTO RUNNING

## BOM (BILL OF MATERIAL)

## Slide 30

1. LIST OF ITEMS USED
