amandalal143/github-demo-noval/Grooving Servo Machine/4. Drawing and Manual/Maadhav Operation Manual02.pptx

## GROOVING MACHINE 02 MANUAL

Project Description : Grooving Machine 02 Hydraulic to Servo
Customer Name :Maadhav Automotive Fasteners Pvt. Ltd.
Order Number : NA
Order Date :15/03/2024

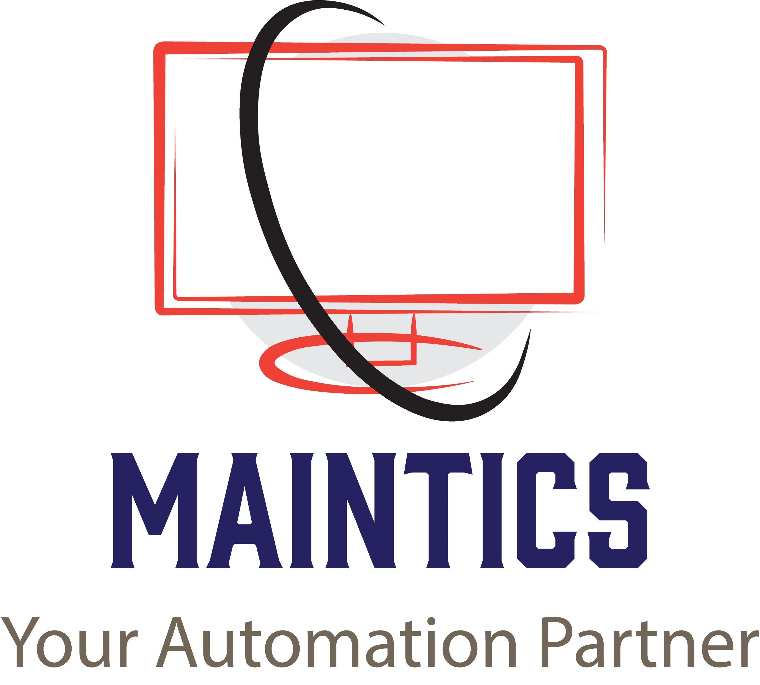
[picture p37: figure]

Developed By:
MAINTICS AUTOMATION & ROBOTICS LLP
Email : contact@maintics.com
Phone: +91 7042626619
Website : www.maintics.com

## GROOVING MACHINE 02 MANUAL

Project Description : Grooving Machine 02 Hydraulic to Servo
Customer Name :Maadhav Automotive Fasteners Pvt. Ltd.
Order Number : NA
Order Date :15/03/2024

© MAINTICS AUTOMATION & ROBOTICS LLP

## Table Of Contents

- Operation Manual
- Electrical Drawing
- Troubleshooting Guide
- BOM (Bill of Material)

(C) Maintics Automation & Robotics LLP

## Slide 4

Operation Manual

## Company Profile Screen


At first when you turn on the Machine this screen will open.
This is the Company Introduction screen.
Click anywhere in the screen to navigate on Main Menu

## 1. MAIN MENU SCREEN


This Screen is for Navigation inside the HMI of below screens.
Below are the list of all available screen in the HMI.
1. MACHINE MONITOR
2. DRIVE MONITOR
3. PART PROGRAM
4. MACHINE MODE SWITCH
5. SERVO SETTING
6. SERVO LOAD ANALYSIS
7. SERVO ALARM HISTORY
8. MANUAL OPERATION
9. INPUT MONITOR
10. OUTPUT MONITOR
11. MACHINE ALARMS
12. VFD ALARMS HISTORY

## 2. PROCESS MONITOR SCREEN

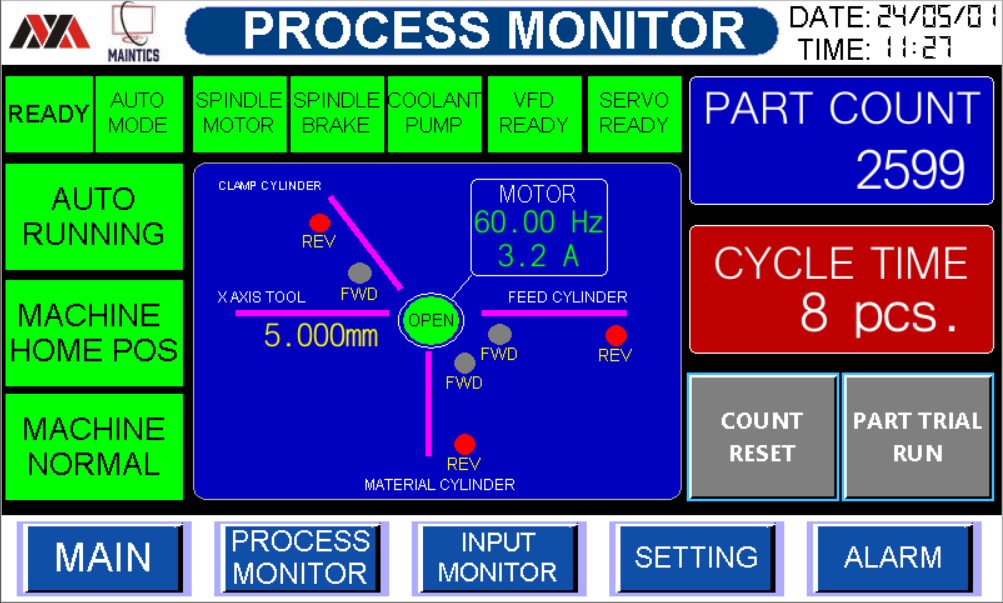
[picture p38: figure]

This screen is to Monitor Whole machine at Single Place

1. Machine Ready Status
2. Machine Auto / Manual Mode Status
3. Machine Auto Running Status
4. Device Running Status
5. Home Position Indication and Fault Indication

Machine Stopped

Not Ready

Ready

Manual Mode

Auto Mode

Auto Running

Machine at Home

Device Running

Device OFF

Not at Home

Normal

Fault

## Slide 8

2. PROCESS MONITOR SCREEN

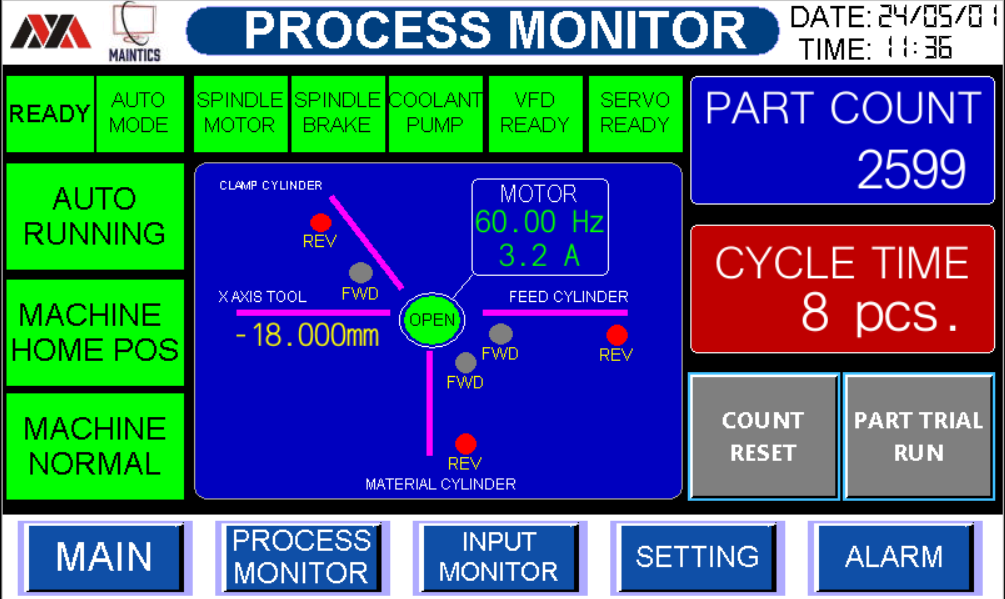
[picture p39: figure]

This screen is to Monitor Whole machine at Single Place

6. Total Parts count Cumulative and Cycle time Parts/min.
7. Machine Inputs Monitoring (Cylinder Reed switch)
8. Navigation Bar

Here you can monitor all reed switch condition On or Off.
- Feed Cylinder
- Material Cylinder
- Clamp Cylinder
- X Axis Cylinder
- Y Axis Cylinder
- SPINDLE MOTOR STATUS

Used to easily navigate from one screen to another screen


## Slide 9

2. PROCESS MONITOR SCREEN

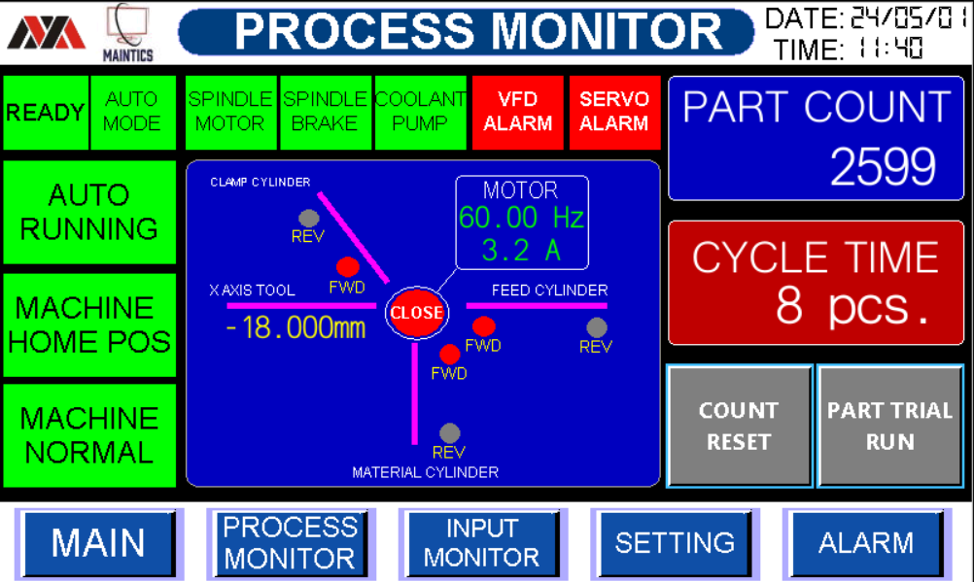
[picture p40: figure]

This screen is used to Machine Monitor current alarms & Status

1. Servo & VFD Alarm Status

Servo & VFD Alarm ON SERVO & VFD Is Ready to Use

2. COUNTER RESET & PART TRIAL RUN Status

Counter Reset Buttion is ON

Part triali Buttion is ON


Here you can Press
PART COUNTER RESET ON

Here you can Press PART TRIAL is ON

## Slide 10

3.INPUT MONITOR SCREEN


This screen is to monitor all PLC Inputs total 16 Nos.

1. All inputs status from Off to On is as below

INPUT OFF

INPUT ON

MACHINE EMARGENCY PRESSED

MACHINE EMARGENCY NOT PRRESSED

## Slide 11

4. OUTPUT MONITOR SCREEN


This screen is to monitor all PLC Outputs total 16Nos.

1. All Output status from Off to On is as below

OFF
ON

## Slide 12

5. ALARM MONITOR SCREEN


This screen is used to monitor machine current alarms

1. Alarm screen navigation buttons
2. Reset button to reset current Alarms
3. Alarm History Screen access Button

## Slide 13

5. ALARM HISTORY SCREEN

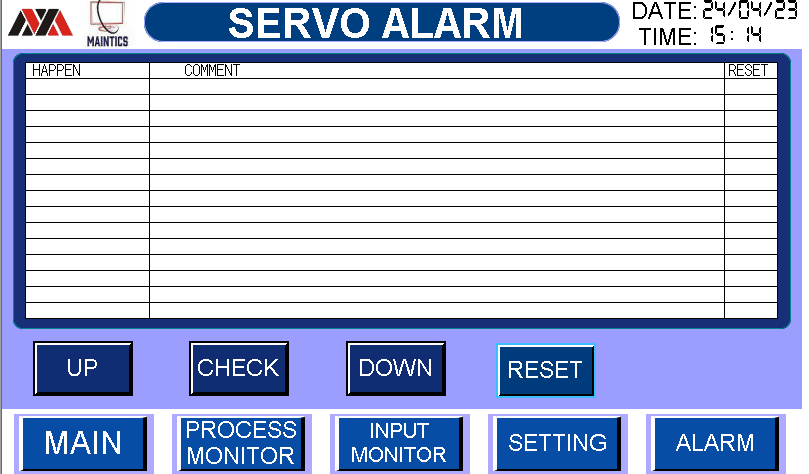
[picture p41: figure]

This screen is used to monitor machine current alarms

1. Alarm screen navigation buttons
2. Reset button to reset current Alarms
3. Alarm History Screen access Button

## Slide 14

6. MODE SELECT SETTING SCREEN


Machine Settings can be done from this screen.

1. COOLENT PUMP ON Condition
2. COOLENT PUMP Off Condition
3. COUNTER RESET ON
4. WITHOUT PART OFF
5. WITHOUT PART TRIAL ON

## Slide 15

7. MANUAL OPEARTION 1 SCREEN


Manual Operation of all device can be performed using this screen

1. Steps for manual operation
  a. First check Fault Light it should be Off
  b. Now check Ready Light it should be Green
  c. Now press Auto Manual selector switch to change mode from Auto to manual
  d. Now Press Start Button to Start the Device
  e. It will glow green if device is started.

## Slide 16

8. PART PROGRAM SCREEN

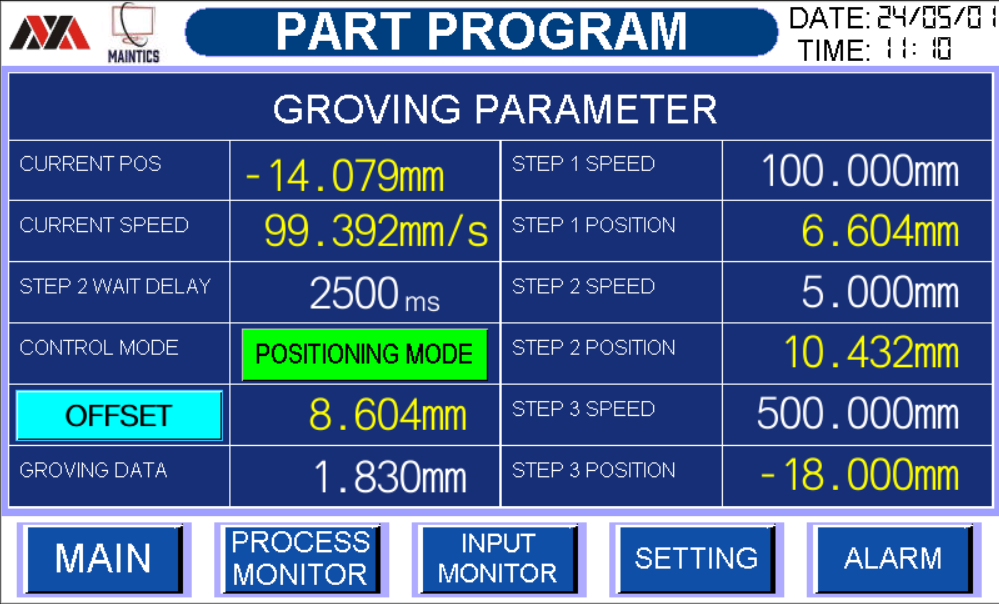
[picture p42: figure]

1. Here you can change grooving Program
a) WAIT DELAY VALUE (Here you Can Changr Groving
Data 1sec wait Delay Value.)
b) OFFSET VALUE (Here you can Set Offset
Material Value.)
c) GRONING DATA VALUE (Here you can set Groving
Value.)
d) STEP 1 SPEED VALUE (Here you can set the
step 1 SPEED VALUE)
e) STEP 2 SPEED VALUE (Here you can set the
step 2 SPEED VALUE)

## Slide 17

8. PART PROGRAM SCREEN

1. Here you can change grooving Program

f) STEP 3 SPEED VALUE (Here you can change
step 3 Speed Value )

2. Here you can monitor POSITIONING MODE &
JOG MODE
a) Herer you can monitor
POSITION MOSE is ON
b) Here you can monitor
JOG MODE is ON

## Slide 18

9. SERVO LOAD SCREEN


1. SERVO LOAD GRAPH
  a. Here you can monitor servo Load Graphically
  b. You Can monitor servo Troque Graphically
c) You Can monitor servo Speed Graphically.

## Slide 19

10. SERVO SETTING SCREEN

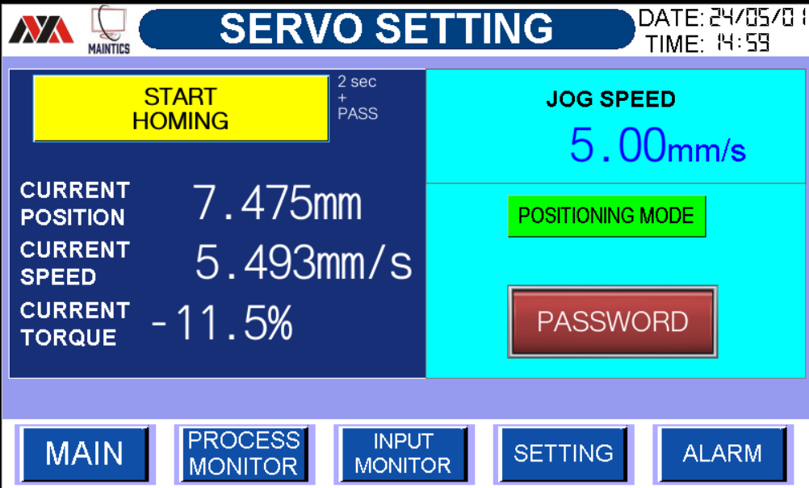
[picture p43: figure]

1 SERVO MOTOR HOMING STATUS
a) SERVO CURRENT OPSOTION (10.000mm)
b) SERVO CURRENT SPEED (-0.170mm/s)
c) SERVO CURRENT TORQUE (1.1%)

2 SERVO MOTOR JOG SPEED
JOG SPEED MIN MAX
(0.01mm/s) (10.00mm/s)

3 Servo Homing

a. Here you can enter password and Press 2 Second and servo Start homing Automatically

## Slide 20

11. DRIVE MONITOR SCREEN


DRIVE MONITOR STATUS
1. Here you can monitor SERVO & VFD STATUS
SERVO
a) Here you can monitor servo current position.
b) Here you can monitor servo current speed.
c) Here you can monitor servo Current Torque.
VFD
a) Here you can monitor VFD Frequency.
b) Here you can monitor VFD Voltage.
c)Here you can monitor VFD Current.
d)Here you can monitor VFD Alarm Code.
2. Here you can change SPINDLE SPEED Using Hz
MIN MAX
25Hz 60Hz

## Electrical Drawings

## Troubleshooting Guide

## Slide 23

1. HMI ALARM GUIDE

## Slide 24

2. MACHINE AUTO RUNNING FLOW

STOP

START PB

MACHINE HOME

MACHINE AUTO

Check Reed Switch
X20, X22 if NO

NO

YES

Check Manual Screen
If NO

NO

YES

Check Alarm Screen
For any alarm reset alarm before if NO

MACHINE NORMAL

NO (FAULT)

YES

AUTO RUNNING

## BOM (BILL OF MATERIAL)

## Slide 26

1. LIST OF ITEMS USED
