amandalal143/github-demo-noval/Grooving Servo Machine/4. Drawing and Manual/final drawing 070424.pdf

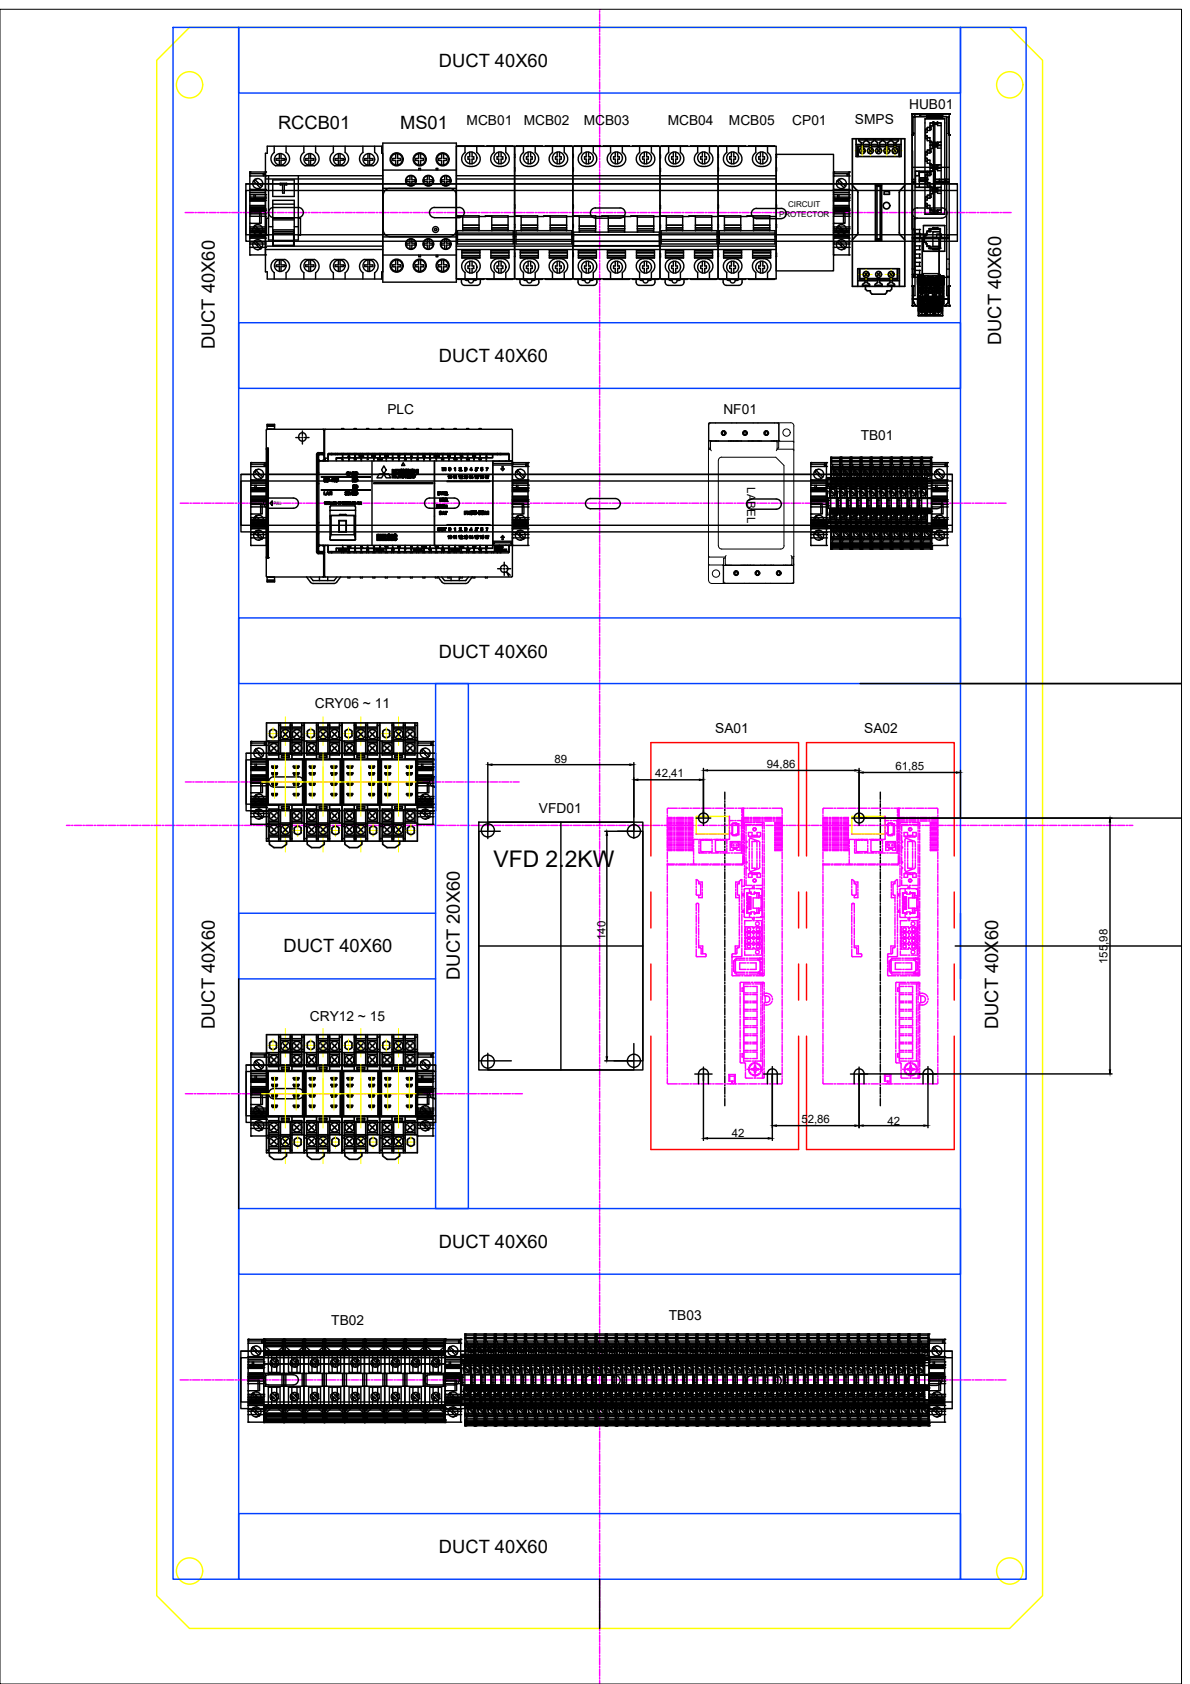
[picture p44: page 1]
CIRCUIT PROTECTOR; VFD 2.2KW; LABEL; RCCB01; MS01 MCB01 MCB02 MCB03; MCB04 MCB05; SMPS; CRY06 ~ 11; CRY12 ~ 15; DUCT 40X60; DUCT 40X60 DUCT 40X60; DUCT 40X60 DUCT 20X60

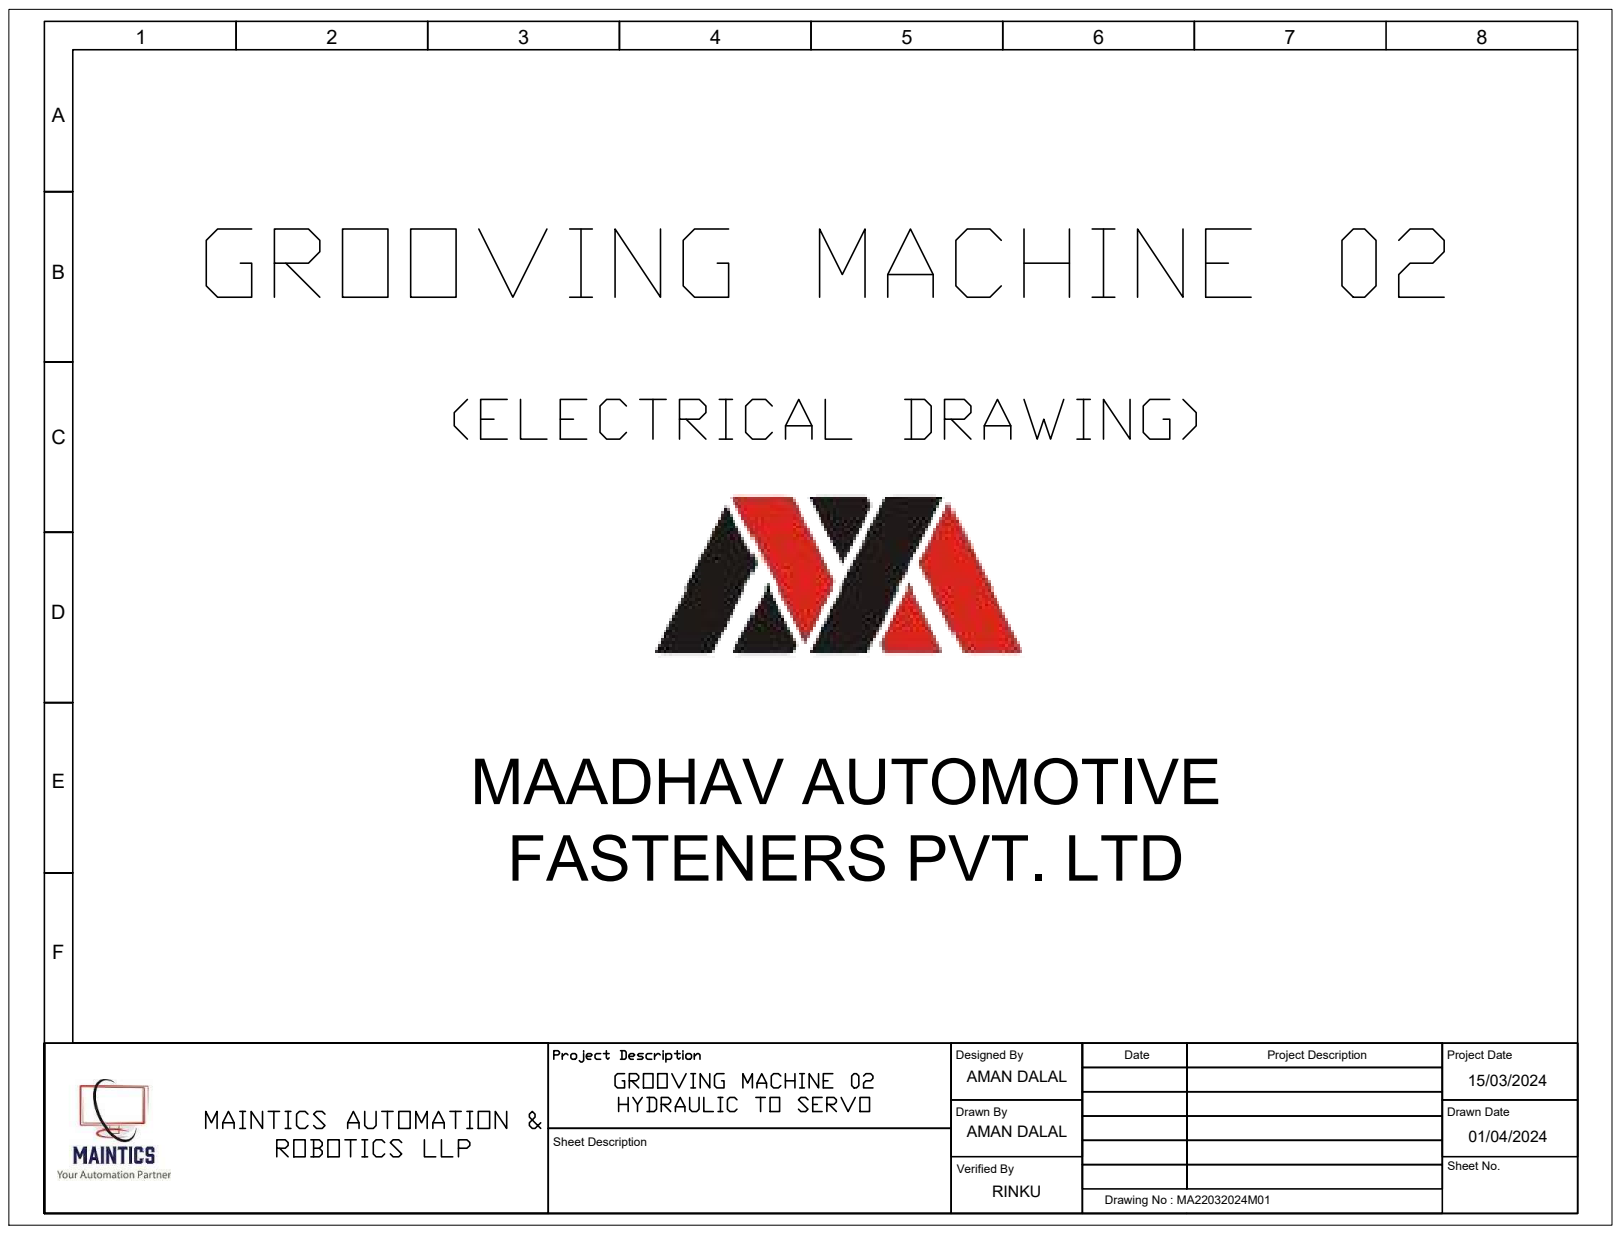
[picture p45: page 2]
ABCDEF; 8 Sheet Description; Designed By Drawn By Verified By; Date; Project Description; Project Date Drawn Date Sheet No. AMAN DALAL AMAN DALAL RINKU; 15/03/2024 01/04/2024 Drawing No : MA22032024M01 MAADHAV AUTOMOTIVE FASTENERS PVT. LTD

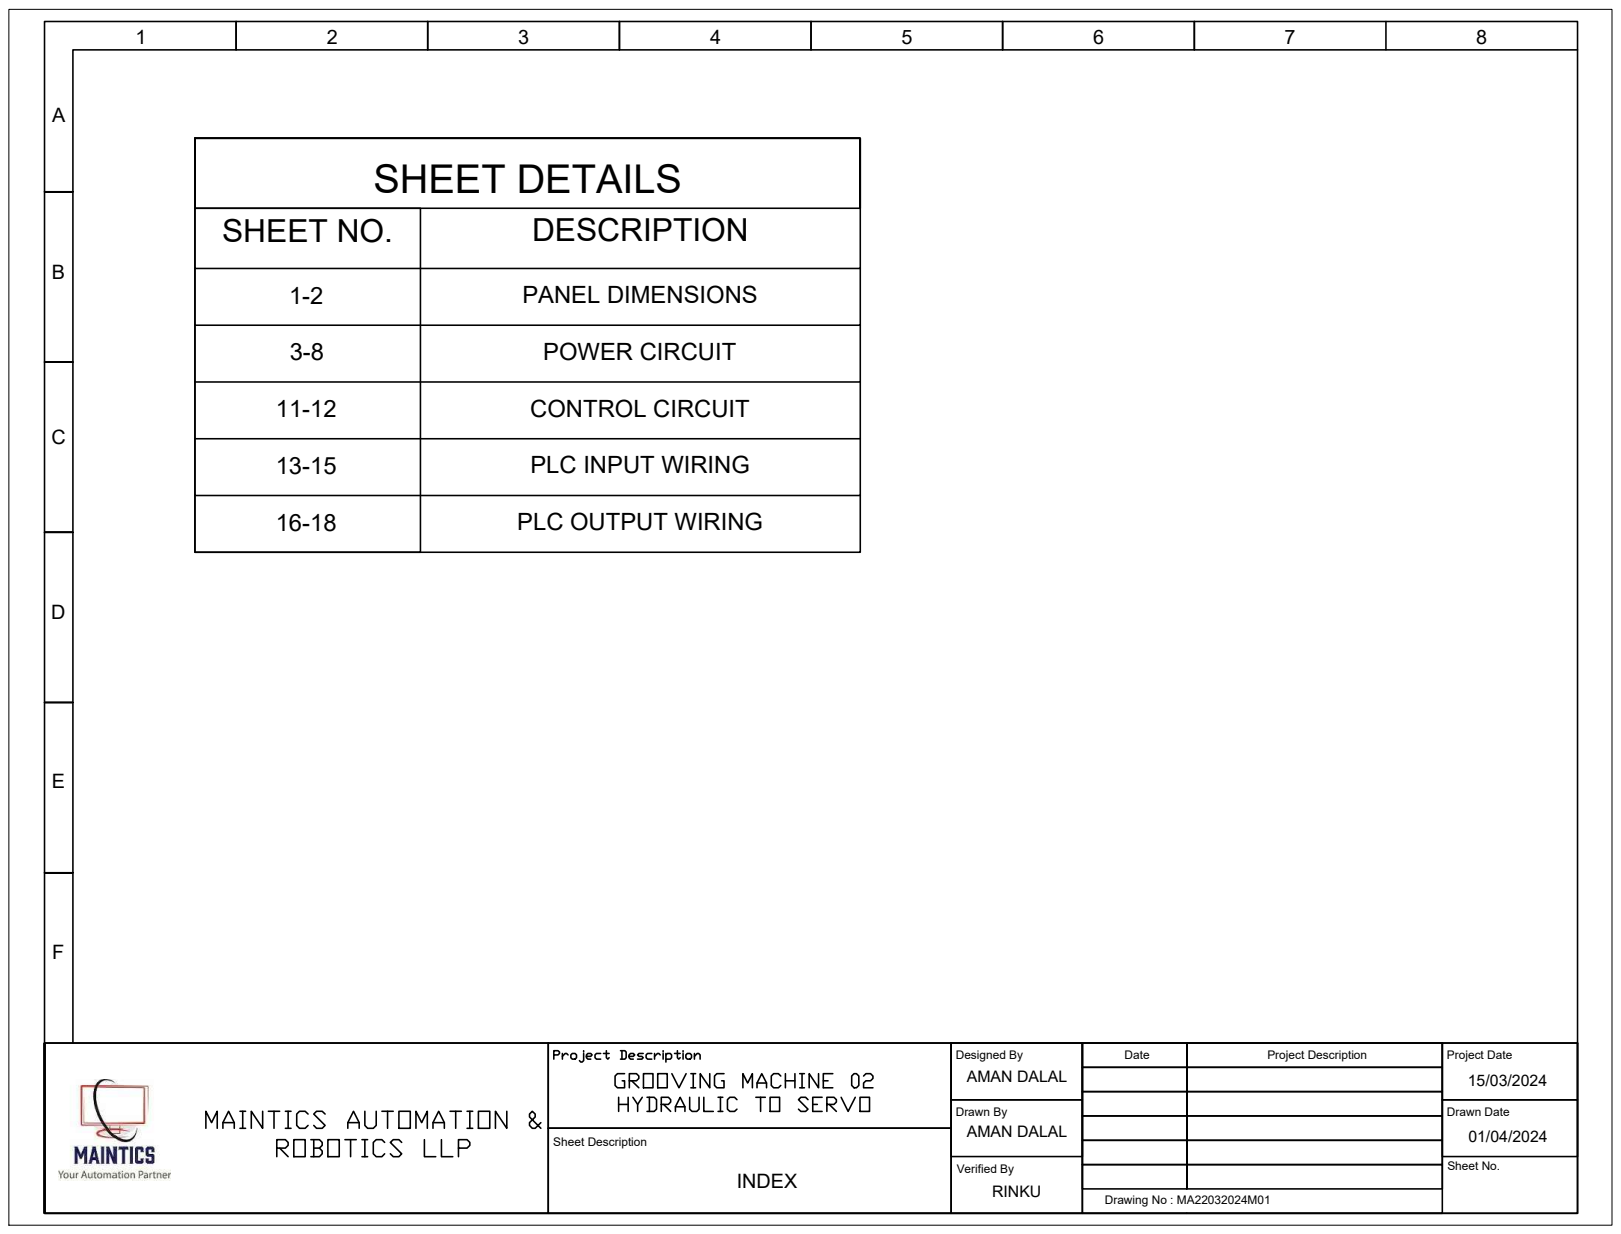
[picture p46: page 3]
ABCDEF; 8 SHEET DETAILS SHEET NO.; DESCRIPTION 1-2; PANEL DIMENSIONS 3-8; POWER CIRCUIT 11-12; CONTROL CIRCUIT 13-15; PLC INPUT WIRING 16-18; PLC OUTPUT WIRING Sheet Description; Designed By Drawn By Verified By; Date; Project Description; Project Date Drawn Date Sheet No. AMAN DALAL AMAN DALAL RINKU; 15/03/2024 01/04/2024 Drawing No : MA22032024M01 INDEX

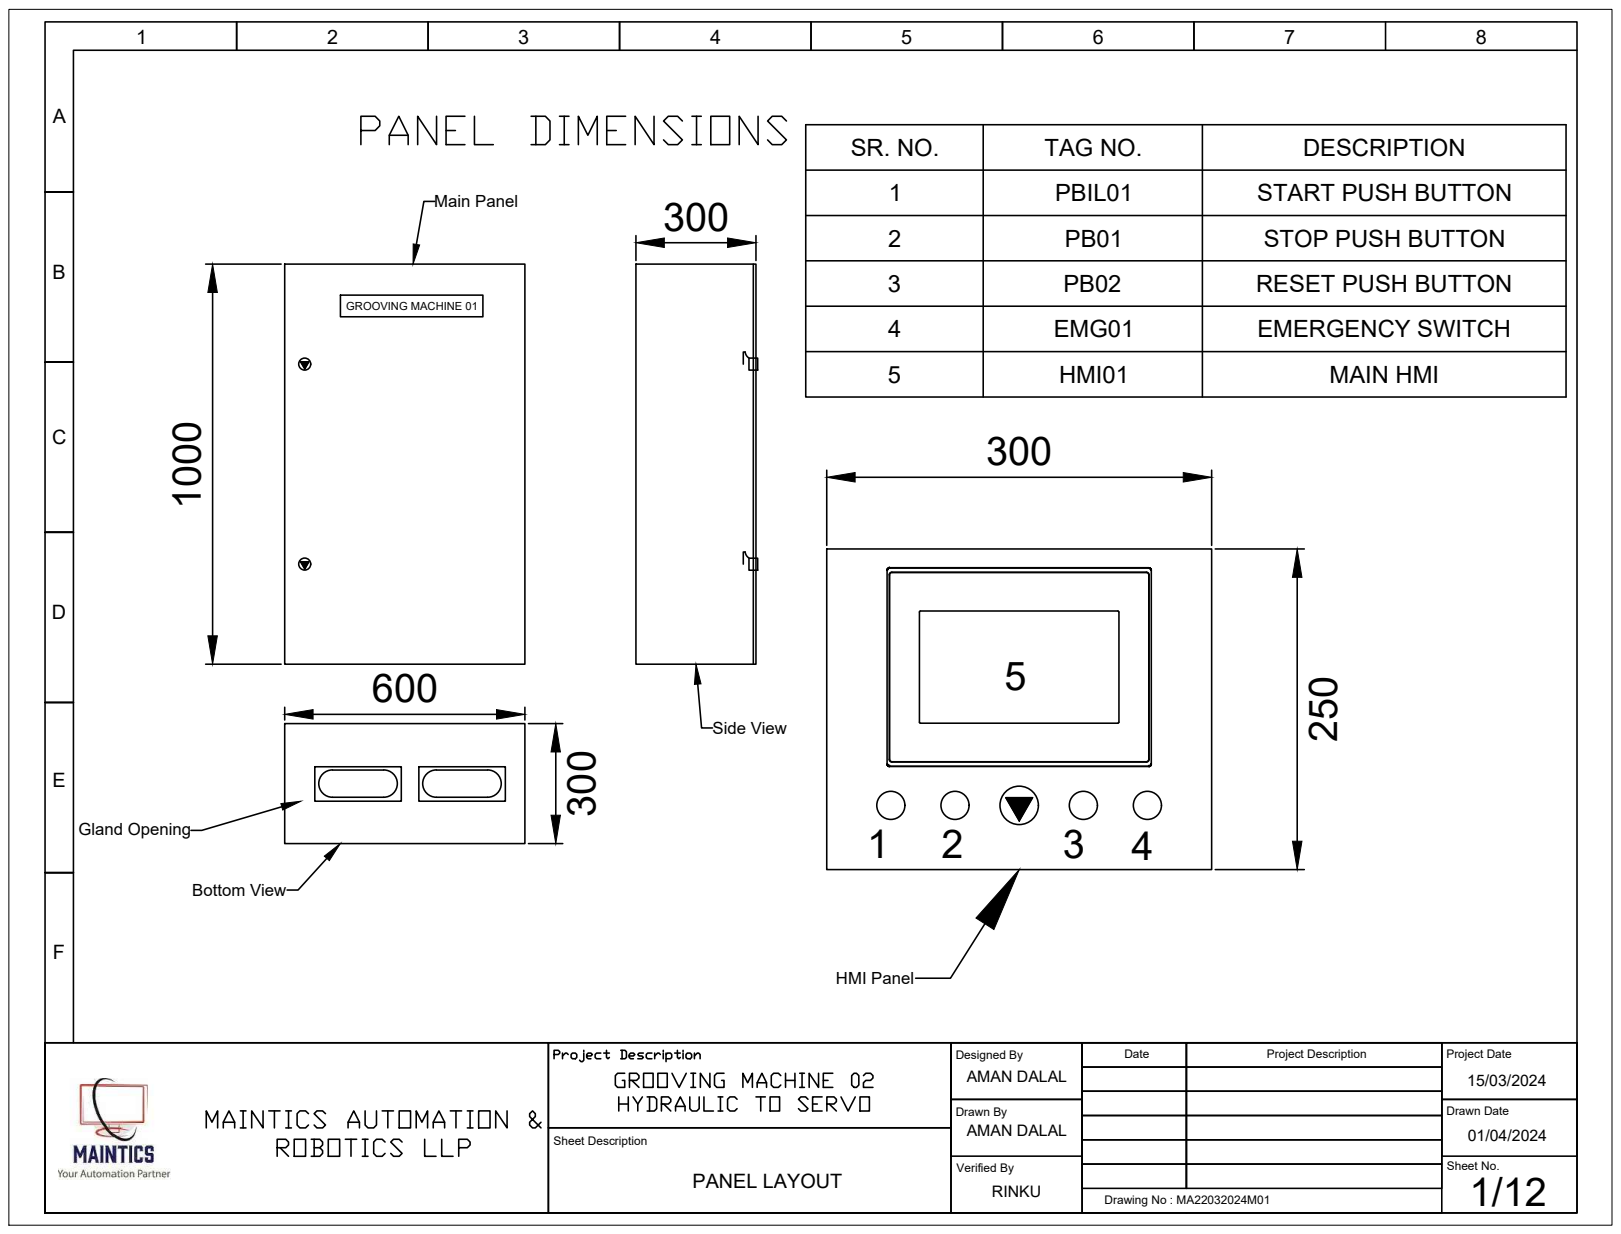
[picture p47: page 4]
ABCDEF; 8 GROOVING MACHINE 01

250 HMI Panel 5 SR. NO. TAG NO. DESCRIPTION 1 PBIL01 START PUSH BUTTON 2 PB01 STOP PUSH BUTTON 3 PB02 RESET PUSH BUTTON 4 EMG01 EMERGENCY SWITCH 5 HMI01 MAIN HMI Sheet Description Designed By Drawn By Verified By Date Project Description Project Date Drawn Date Sheet No. AMAN DALAL AMAN DALAL RINKU 15/03/2024 01/04/2024 Drawing No : MA22032024M01 PANEL LAYOUT 1/12

1000 300 Main Panel Bottom View Gland Opening Side View 1 2 3 4 300

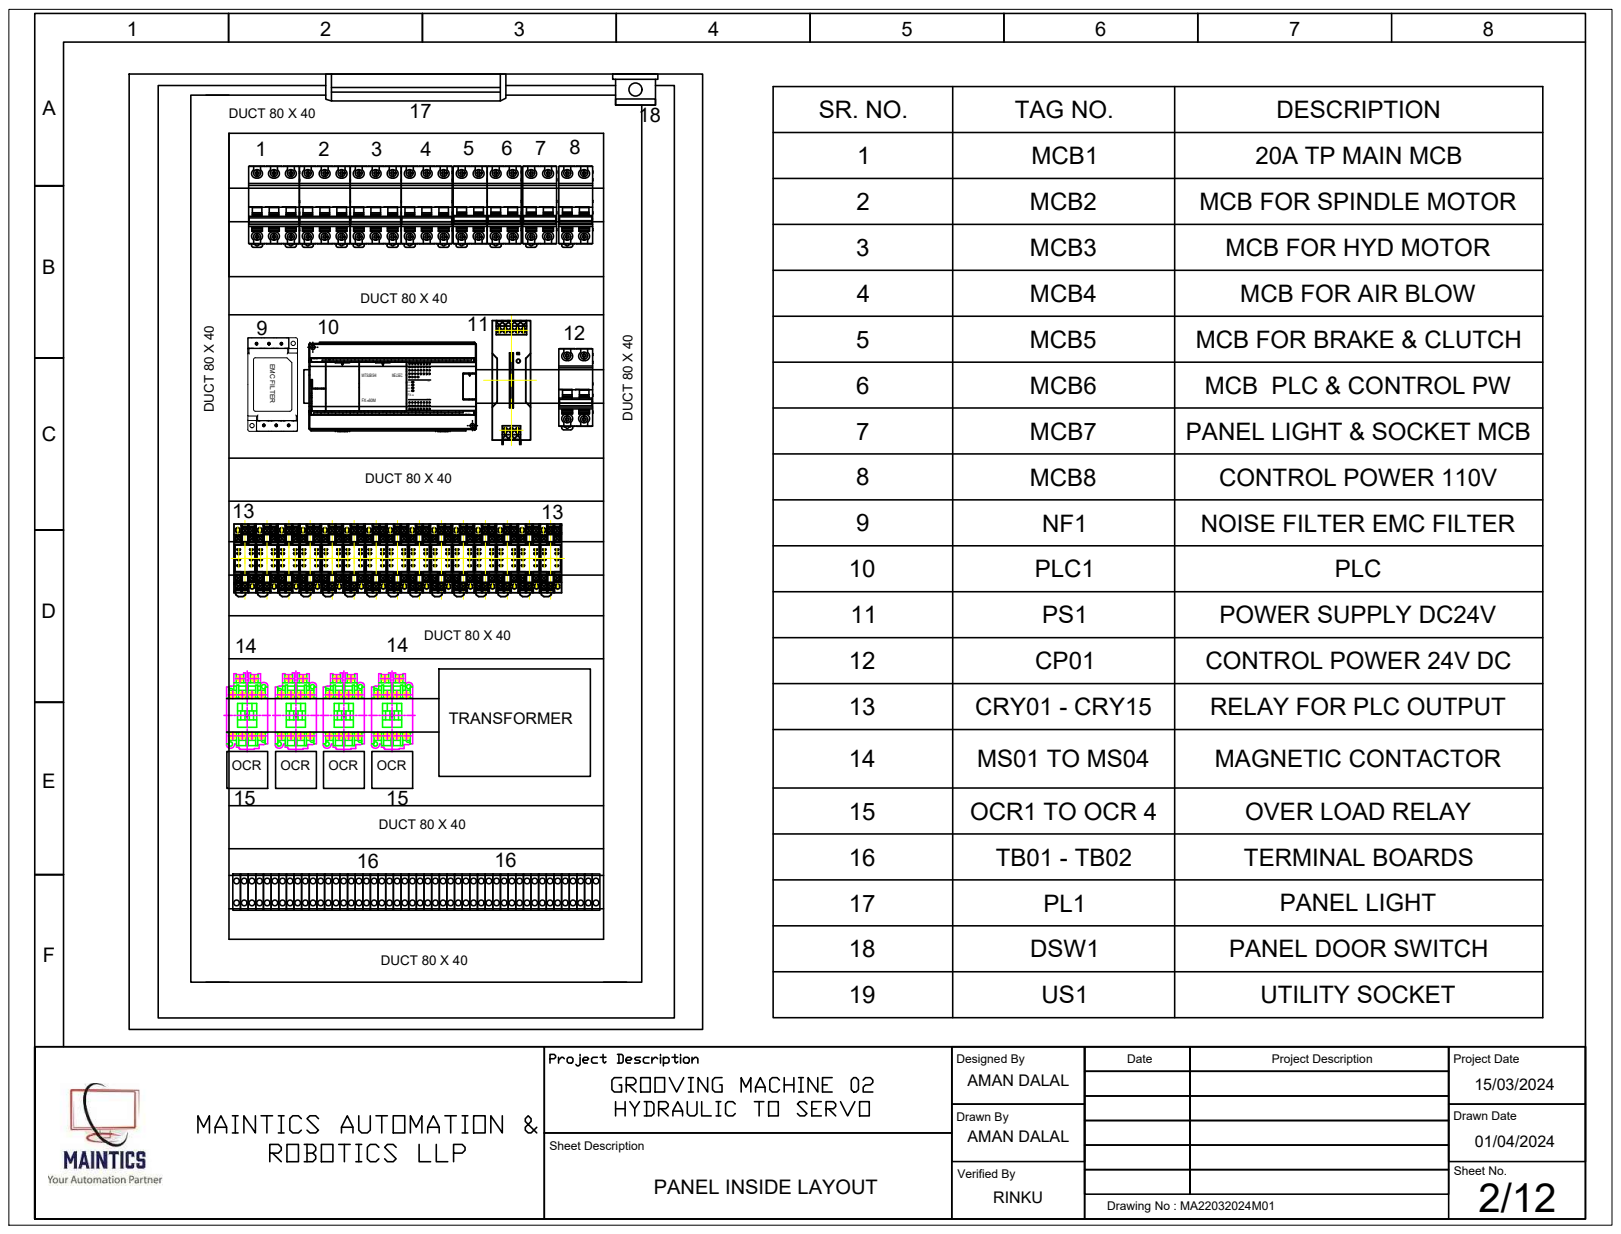
[picture p48: page 5]
ABCDEF; 8 Sheet Description; Designed By Drawn By Verified By; Date; Project Description; Project Date Drawn Date Sheet No. AMAN DALAL PANEL INSIDE LAYOUT; 2/12 AMAN DALAL RINKU; DUCT 80 X 40

EMC FILTER 1 2 3 4 5 6 7 10 11 12 13 14 15 16 17 20 21 22 23 24 25 26 27 10 11 12 13 14 15 16 17 20 21 22 23 24 25 26 27 Y11 Y12 Y13 COM5 Y14 Y15 Y16 Y17 FX 3G POW RUN ERR ALM 100-240 VAC 60MT/ES 24V 0V COM0 Y0 Y1 COM1 COM2 Y2 Y3 COM3 Y4 Y6 Y5 Y7 Y10 COM4 OUTIN 030 31 32 33 34 35 36 37 40 41 42 43 0 1 2 3 4 5 6 7 L N S/S X0 X1 X2 X3 X4 X5 X6 X7 X10 X11 X12 X13 X14 X15 X16 X17 X20 X21 X22 X23 X24 X25 X26 X27 X30 X31 X32 X33 X34 X35 X36 X37 X40 X41 X42 X43 COM6 Y20 Y21 Y22 Y23 COM7 Y24 Y25 Y26 Y27 MITSUBISHI MELSEC FX -60M 3G OCR OCR OCR OCR 1 2 3 4 5 6 7 17 18 8 9 10 13 13 1415 16DUCT 80 X 40 DUCT 80 X 40 DUCT 80 X 40 DUCT 80 X 40 DUCT 80 X 40 DUCT 80 X 40

DUCT 80 X 40 SR. NO. TAG NO. DESCRIPTION 1 MCB1 20A TP MAIN MCB 2 MCB2 MCB FOR SPINDLE MOTOR 3 MCB3 MCB FOR HYD MOTOR 4 MCB4 MCB FOR AIR BLOW 5 MCB5 MCB FOR BRAKE & CLUTCH 6 MCB6 MCB PLC & CONTROL PW 7 MCB7 PANEL LIGHT & SOCKET MCB 8 MCB8 CONTROL POWER 110V 9 NF1 NOISE FILTER EMC FILTER 10 PLC1 PLC 11 PS1 POWER SUPPLY DC24V 12 CP01 CONTROL POWER 24V DC 13 CRY01 - CRY15 RELAY FOR PLC OUTPUT 14 MS01 TO MS04 MAGNETIC CONTACTOR 15 OCR1 TO OCR 4 OVER LOAD RELAY 16 TB01 - TB02 TERMINAL BOARDS 17 PL1 PANEL LIGHT 18 DSW1 PANEL DOOR SWITCH 19 US1 UTILITY SOCKET 1415 11 12 16 TRANSFORMER 15/03/2024 01/04/2024 Drawing No : MA22032024M01

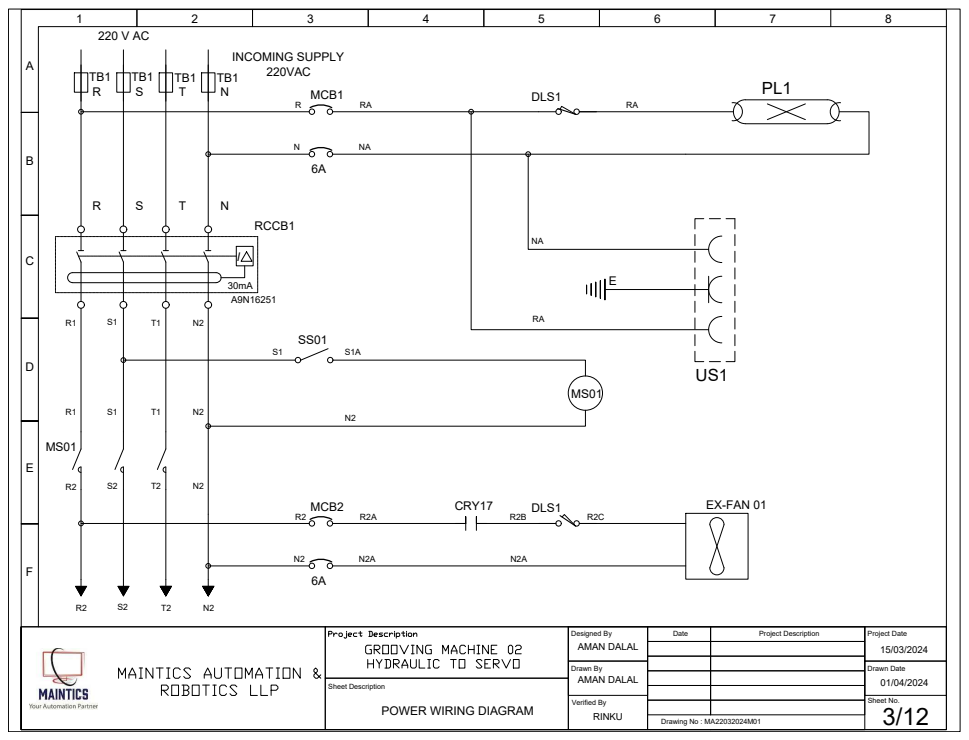
[picture p49: page 6]
ABCDEF; INCOMING SUPPLY 220VAC; MCB1 6A; PL1 DLS1 RA NA; RCCB1 30mA; R2 N2 MCB2 6A; DLS1; R2C CRY17; EX-FAN 01 R2B N2A Sheet Description; Designed By Drawn By Verified By; Date; Project Description; Project Date Drawn Date Sheet No. AMAN DALAL POWER WIRING DIAGRAM; AMAN DALAL RINKU; 15/03/2024 01/04/2024 Drawing No : MA22032024M01

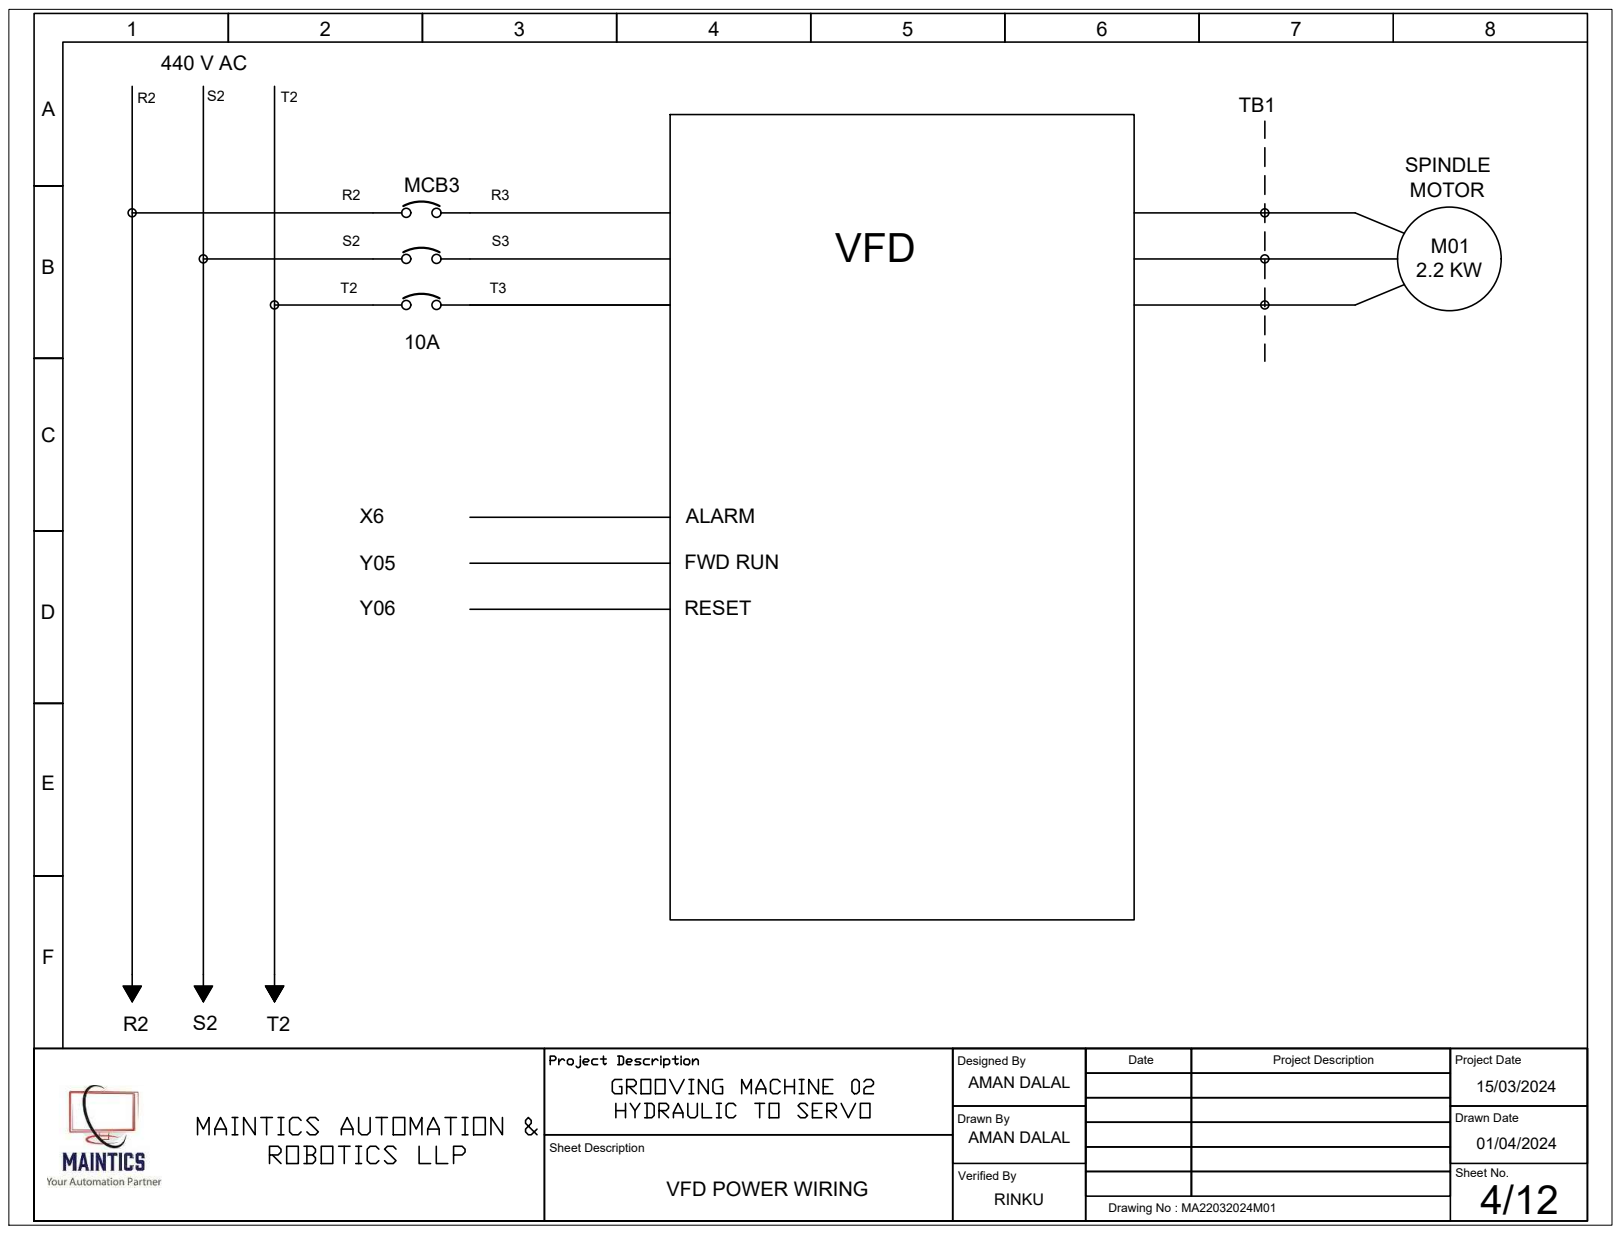
[picture p50: page 7]
ABCDEF; 8 VFD POWER WIRING; MCB3 10A; SPINDLE MOTOR TB1; VFD ALARM FWD RUN RESET X6Y05 Y06; Sheet Description; Designed By Drawn By Verified By; Date; Project Description; Project Date Drawn Date Sheet No. AMAN DALAL AMAN DALAL RINKU; 15/03/2024 01/04/2024 Drawing No : MA22032024M01

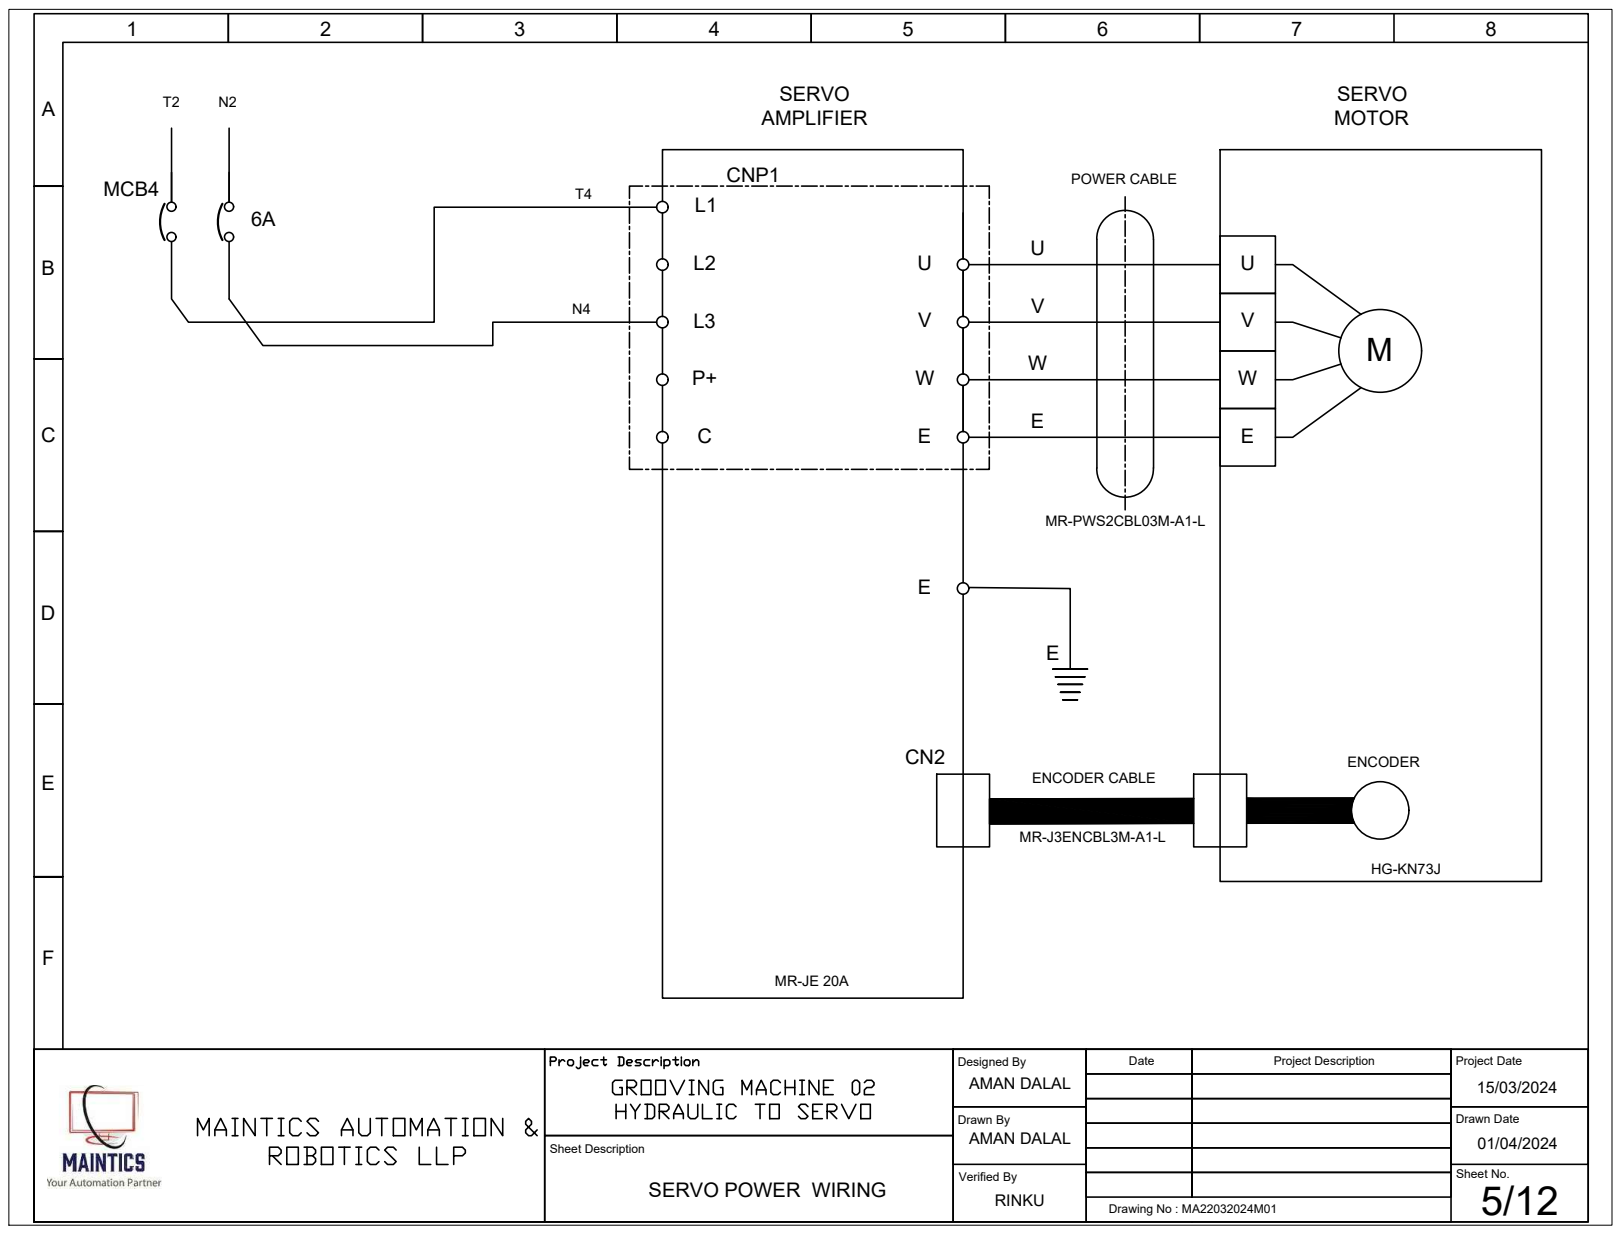
[picture p51: page 8]
ABCDEF; 8 SERVO POWER WIRING; SERVO AMPLIFIER L1L2L3P+C; UVWEE T4 N4; E CNP1; SERVO MOTOR UVWE; UVWEENCODER CABLE MR-J3ENCBL3M-A1-L POWER CABLE MR-PWS2CBL03M-A1-L MR-JE 20A; HG-KN73J ENCODER MCB4; Sheet Description; Designed By Drawn By Verified By; Date; Project Description; Project Date Drawn Date Sheet No. AMAN DALAL AMAN DALAL RINKU; 15/03/2024 01/04/2024 Drawing No : MA22032024M01

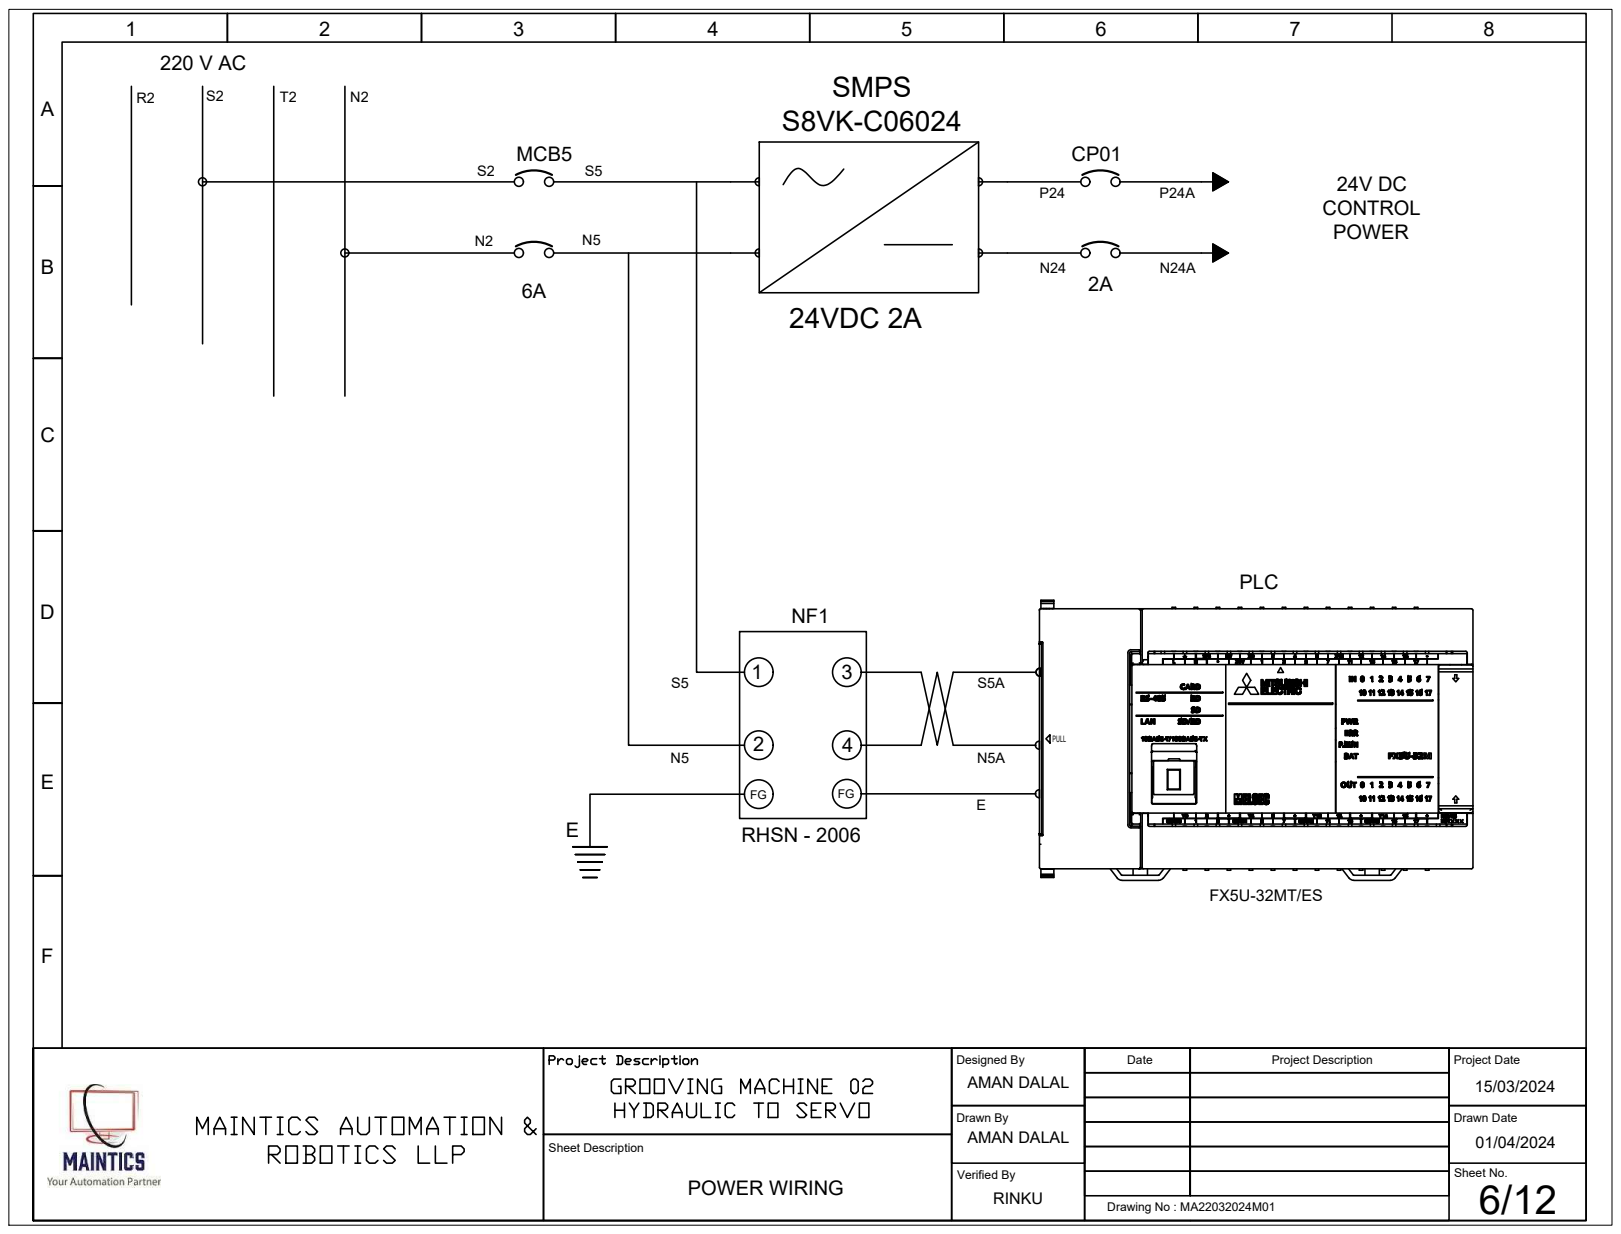
[picture p52: page 9]
ABCDEF; 8 S5A N5A POWER WIRING; MCB5 S5 N5; SMPS S8VK-C06024 24VDC 2A; 24V DC CONTROL POWER 12; RHSN - 2006 220 V AC; PULL; PLC FX5U-32MT/ES Sheet Description; Designed By Drawn By Verified By; Date; Project Description; Project Date Drawn Date Sheet No. AMAN DALAL AMAN DALAL RINKU; 15/03/2024 01/04/2024 Drawing No : MA22032024M01

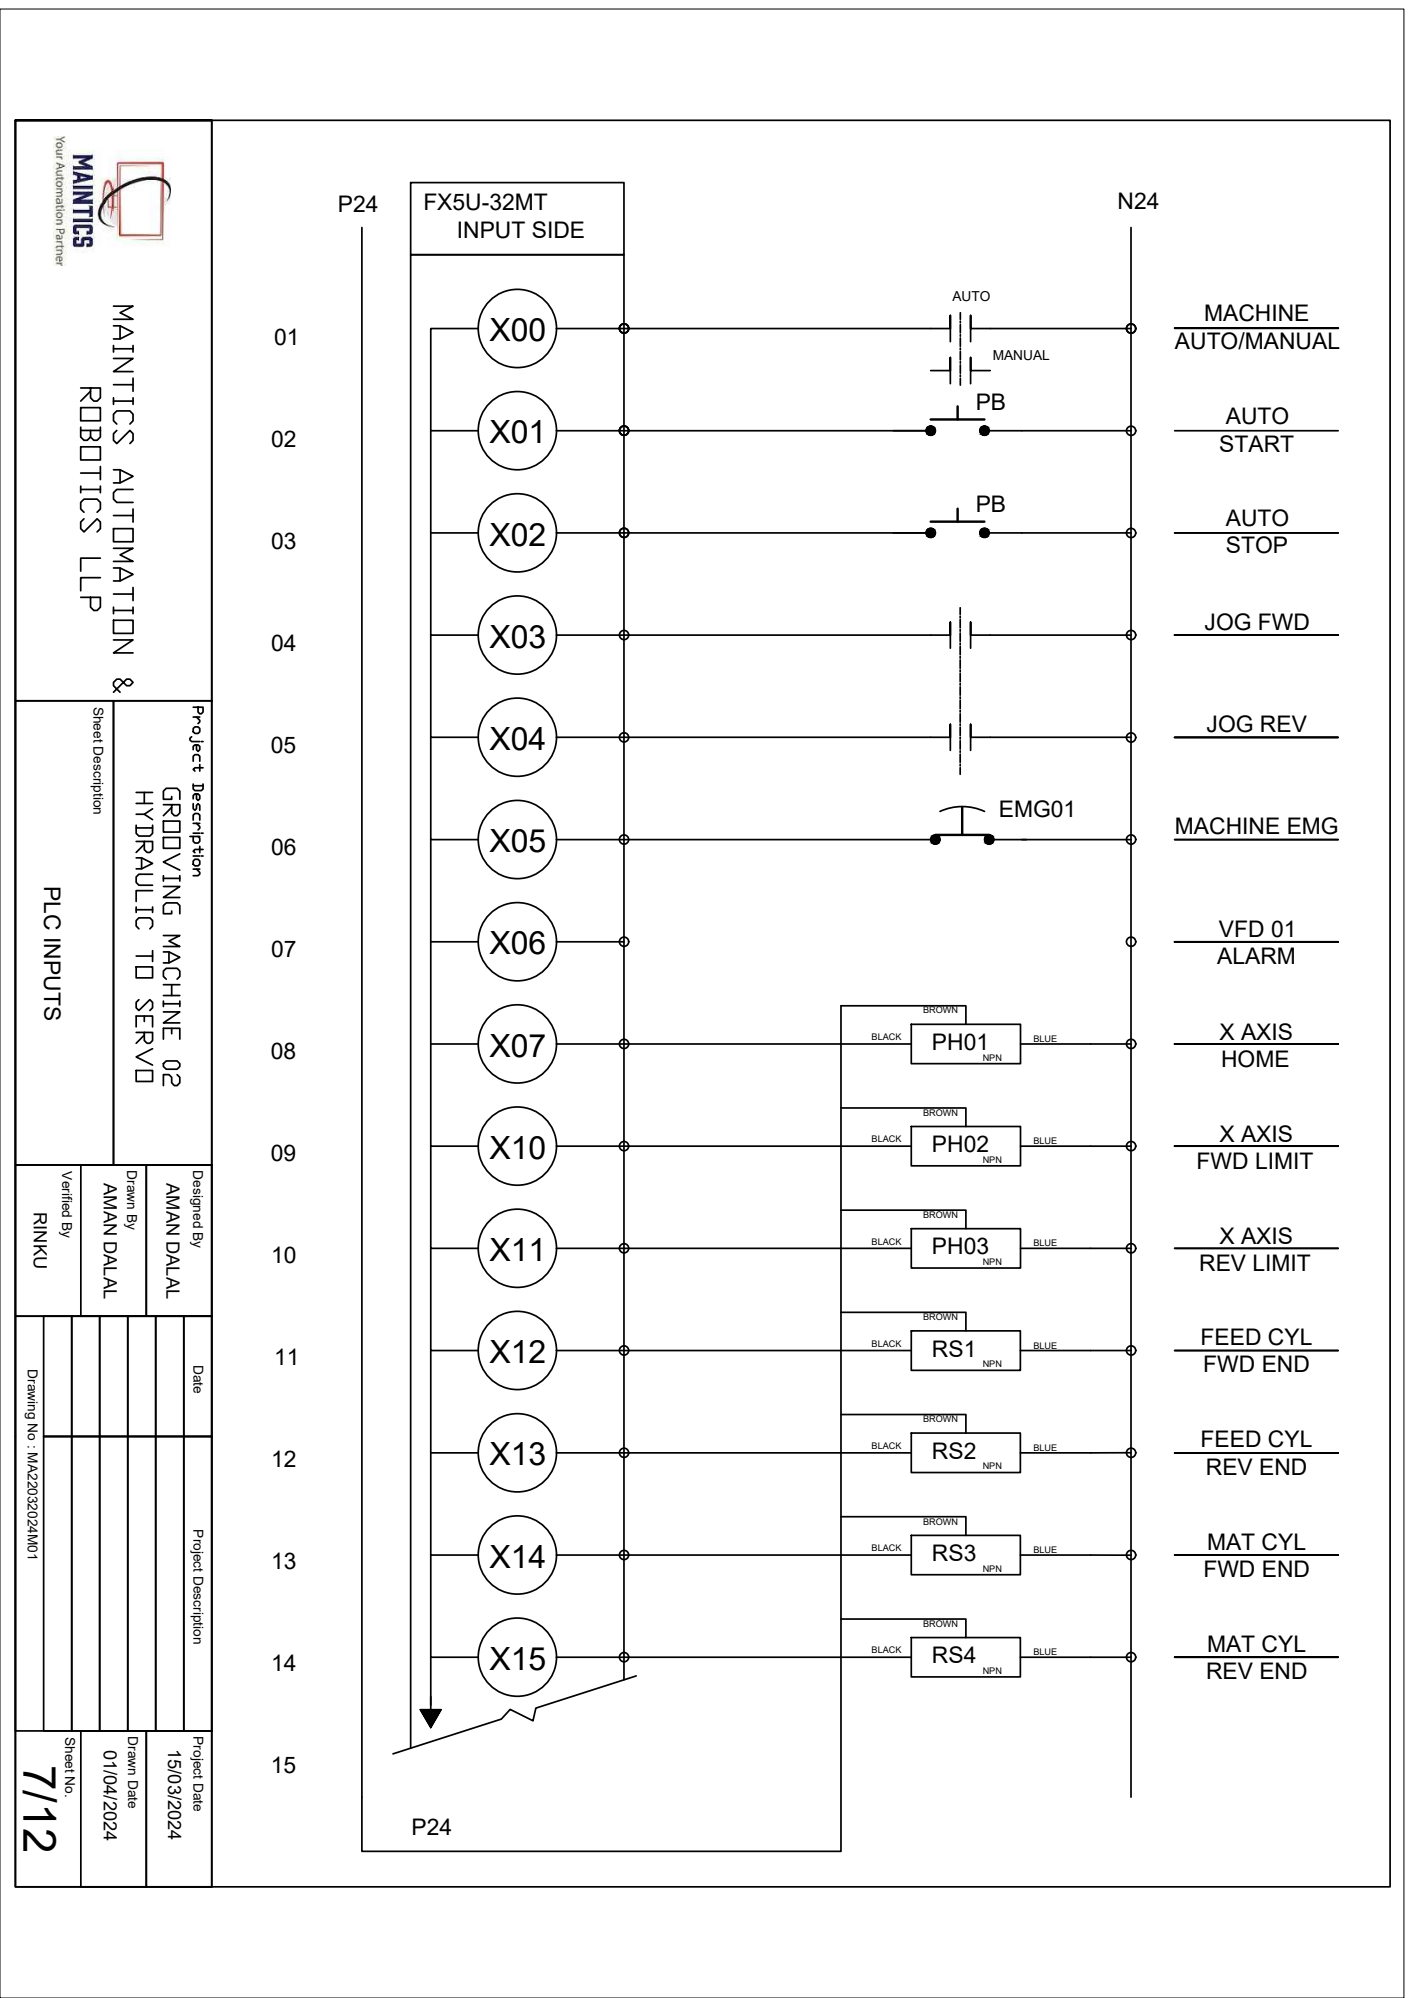
[picture p53: page 10]
INPUT SIDE; VFD 01; FEED CYL FWD END; MACHINE EMG; JOG REV; JOG FWD; AUTO/MANUAL Verified By; Drawn By; Designed By Date Project Description Sheet No.; Drawn Date; Project Date AMAN DALAL; AMAN DALAL RINKU; RS1 BLACK; BLUE; NPN RS2 BLACK; NPN RS3 BLACK; NPN RS4 BLACK; NPN P24; PH01 BLACK; FEED CYL REV END; MAT CYL FWD END; MAT CYL REV END; PH02 BLACK; NPN PH03 BLACK; X AXIS; X AXIS FWD LIMIT; X AXIS REV LIMIT; AUTO MANUAL 01/04/2024; 15/03/2024 Drawing No : MA22032024M01

X15 Sheet Description PLC INPUTS 7/12

BROWN

NPN

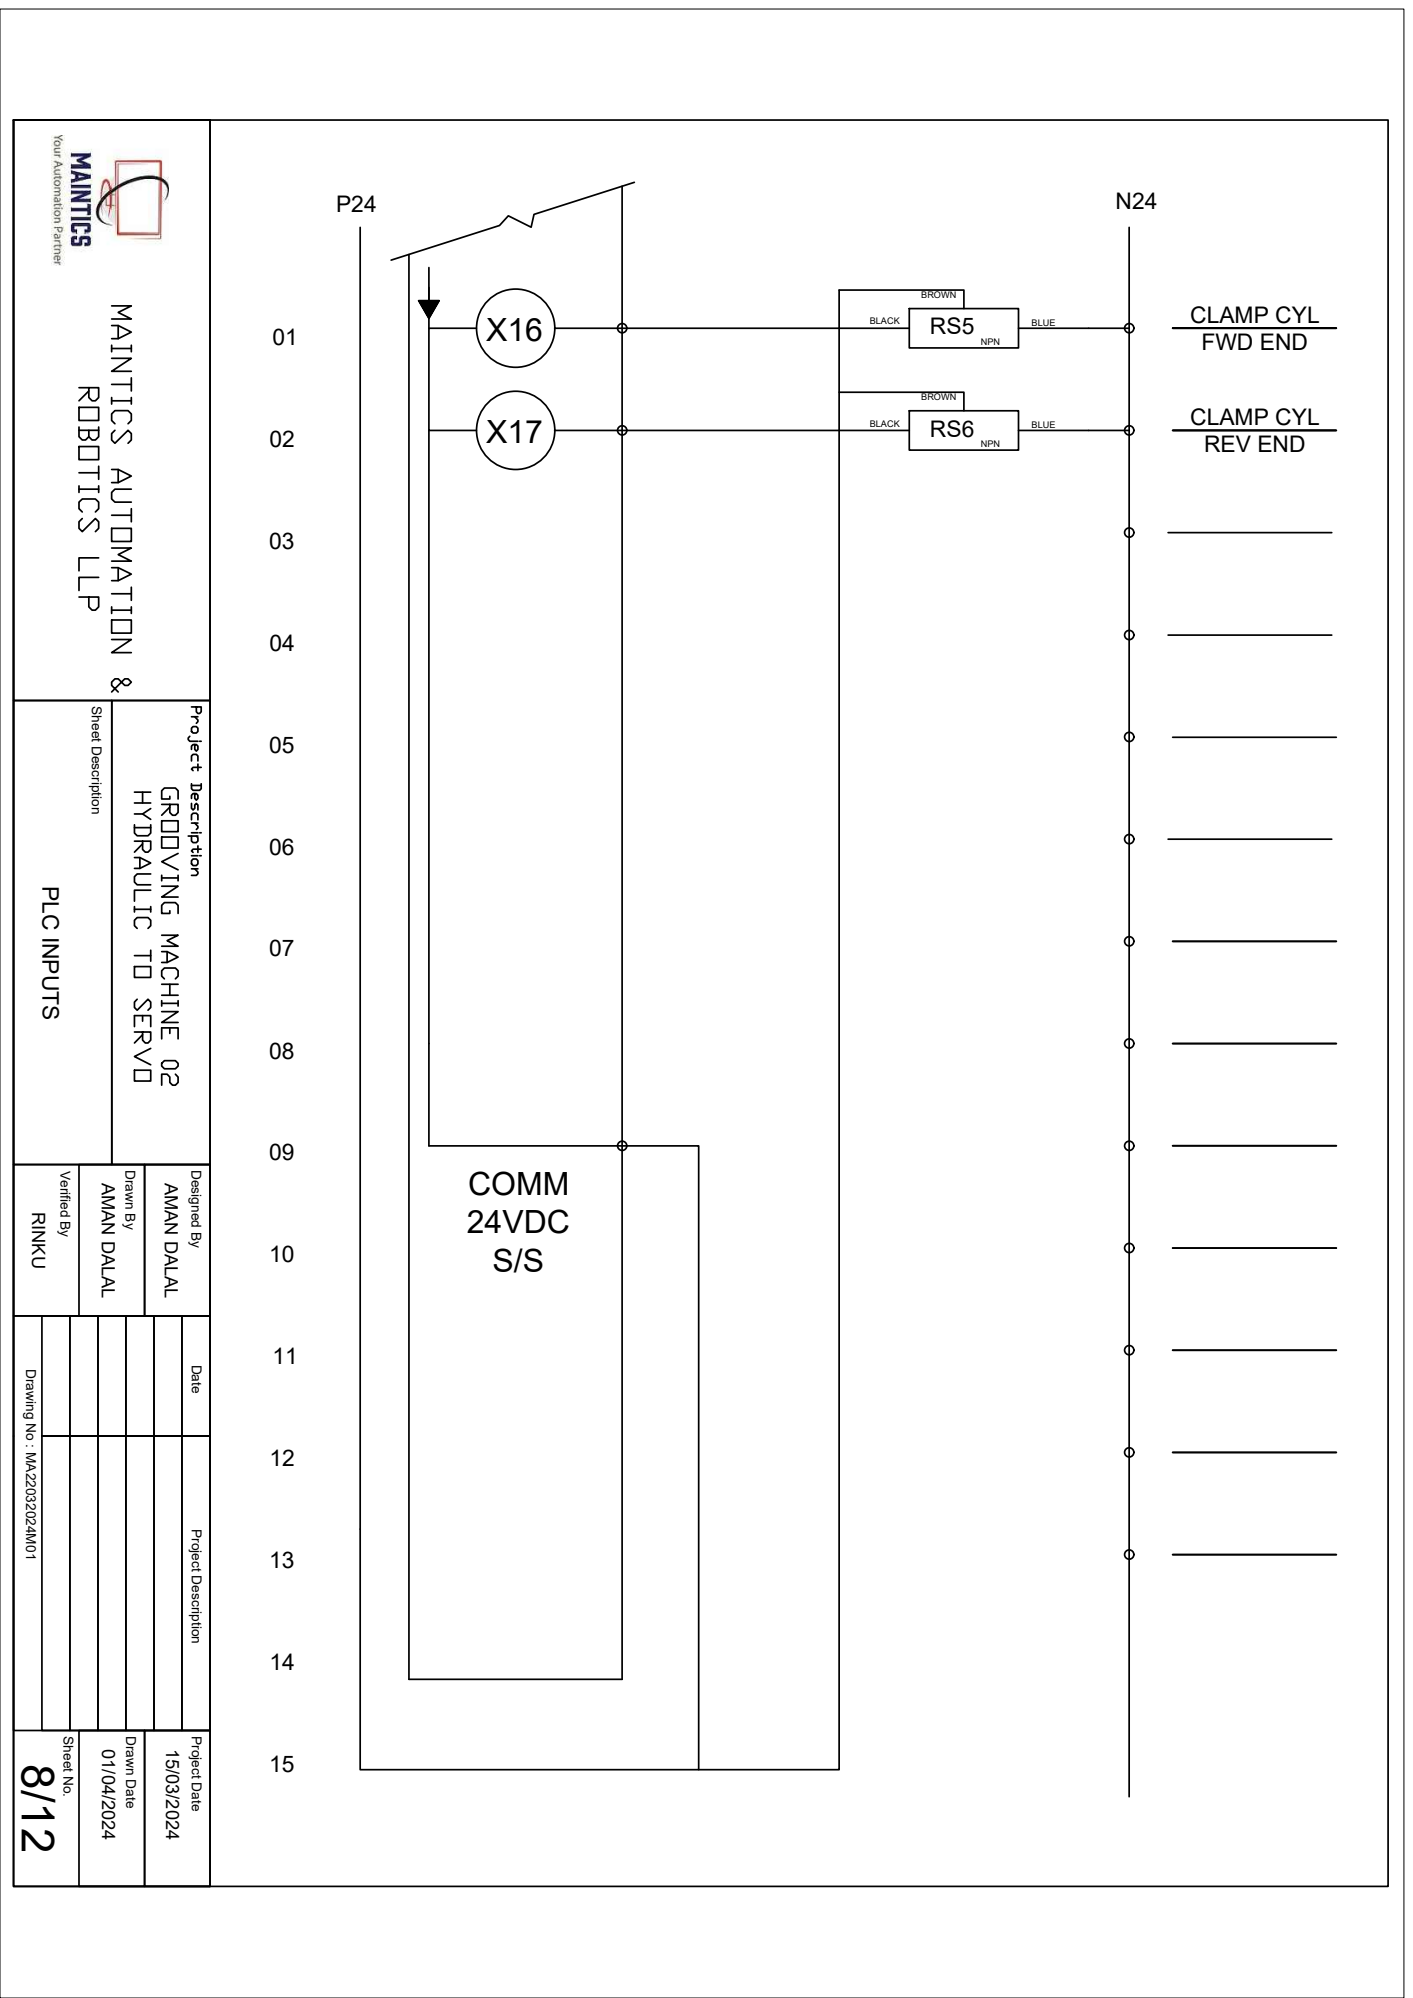
[picture p54: page 11]
RS5 BLACK; BLUE; NPN RS6 BLACK; NPN; CLAMP CYL; FWD END; REV END Sheet Description PLC INPUTS Verified By; Drawn By; Designed By Date Project Description Sheet No.; Drawn Date; Project Date AMAN DALAL; AMAN DALAL RINKU; 15/03/2024 Drawing No : MA22032024M01

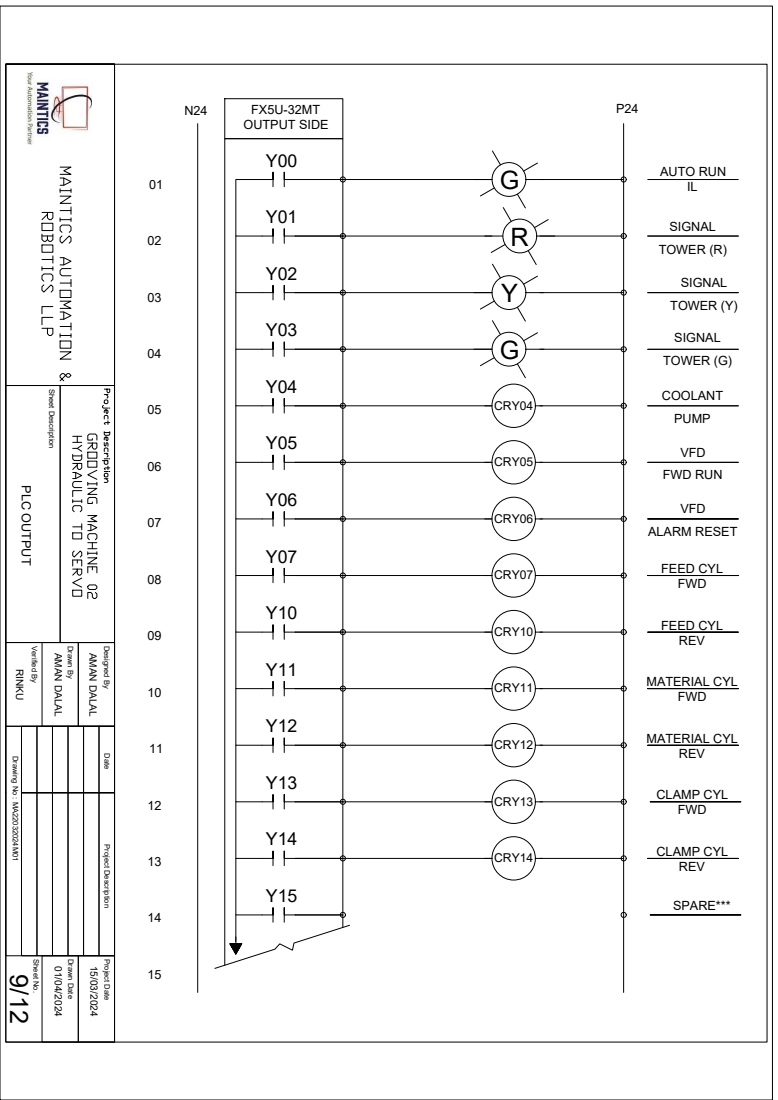
[picture p55: page 12]
TOWER (R); TOWER (Y); TOWER (G) RYG; OUTPUT SIDE; AUTO RUN G; FEED CYL; MATERIAL CYL; CLAMP CYL; FWD RUN; ALARM RESET; SPARE*** Sheet Description PLC OUTPUT 9/12 Verified By; Drawn By; Designed By Date Project Description Sheet No.; Drawn Date; Project Date AMAN DALAL; AMAN DALAL RINKU; 15/03/2024 Drawing No : MA22032024M01

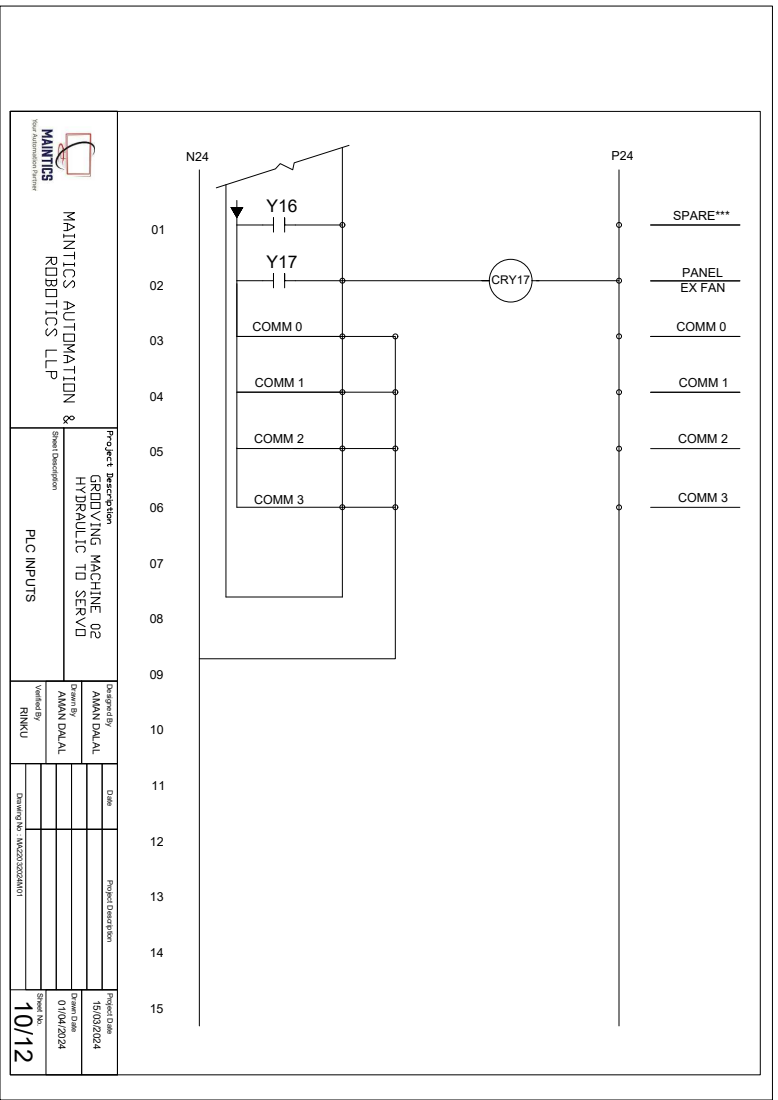
[picture p56: page 13]
COMM 0; COMM 1; COMM 2; COMM 3; EX FAN CRY17 Sheet Description PLC INPUTS 10/12 Verified By; Drawn By; Designed By Date Project Description Sheet No.; Drawn Date; Project Date AMAN DALAL; AMAN DALAL RINKU; 15/03/2024 Drawing No : MA22032024M01

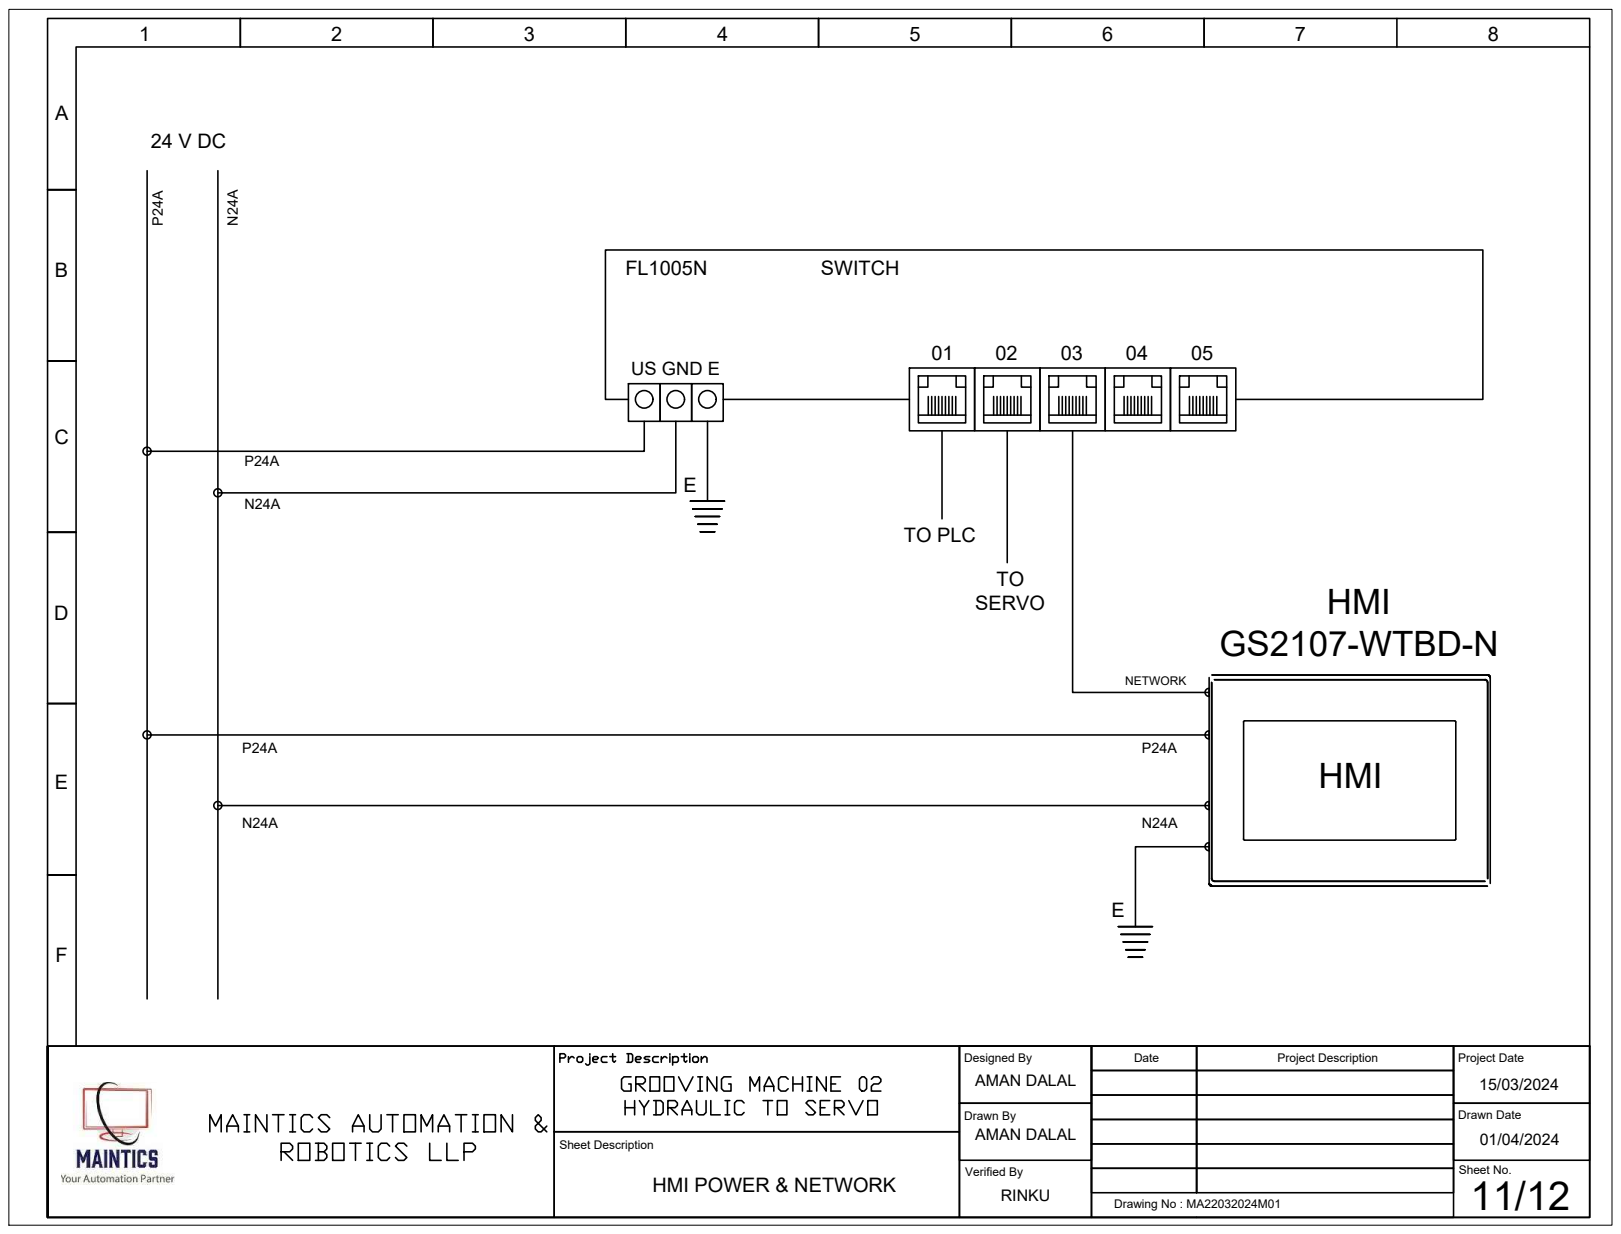
[picture p57: page 14]

N24A HMI GS2107-WTBD-N P24A N24A HMI HMI POWER & NETWORK 11/12 24 V DC US GND E E E P24A N24A P24A N24A FL1005N SWITCH 01 02 03 04 05 NETWORK TO PLC TO SERVO Sheet Description Designed By Drawn By Verified By Date Project Description Project Date Drawn Date Sheet No. AMAN DALAL AMAN DALAL RINKU 15/03/2024 01/04/2024 Drawing No : MA22032024M01

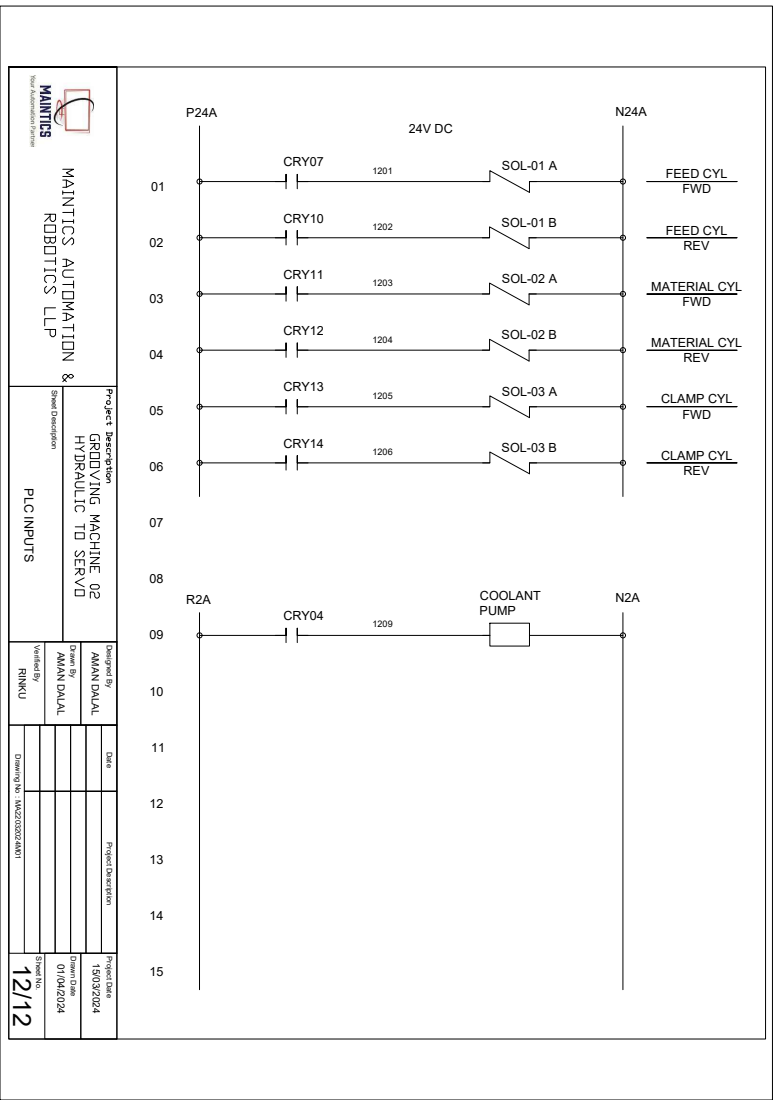
[picture p58: page 15]
SOL-01 A; SOL-01 B; FEED CYL; MATERIAL CYL; CLAMP CYL; SOL-02 A; SOL-02 B; SOL-03 A; SOL-03 B; PUMP CRY04; CRY14 Sheet Description PLC INPUTS 12/12 Verified By; Drawn By; Designed By Date Project Description Sheet No.; Drawn Date; Project Date AMAN DALAL; AMAN DALAL RINKU; 15/03/2024 Drawing No : MA22032024M01
