amandalal143/github-demo-noval/Grooving Servo Machine/4. Drawing and Manual/Grooving Machine 02 Electrcial Drawing.pdf

ABCDEF; 8 Sheet Description; Designed By Drawn By Verified By; Date; Project Description; Project Date Drawn Date Sheet No. AMAN DALAL AMAN DALAL RINKU; 15/03/2024 01/04/2024 Drawing No : MA22032024M01 MAADHAV AUTOMOTIVE FASTENERS PVT. LTD

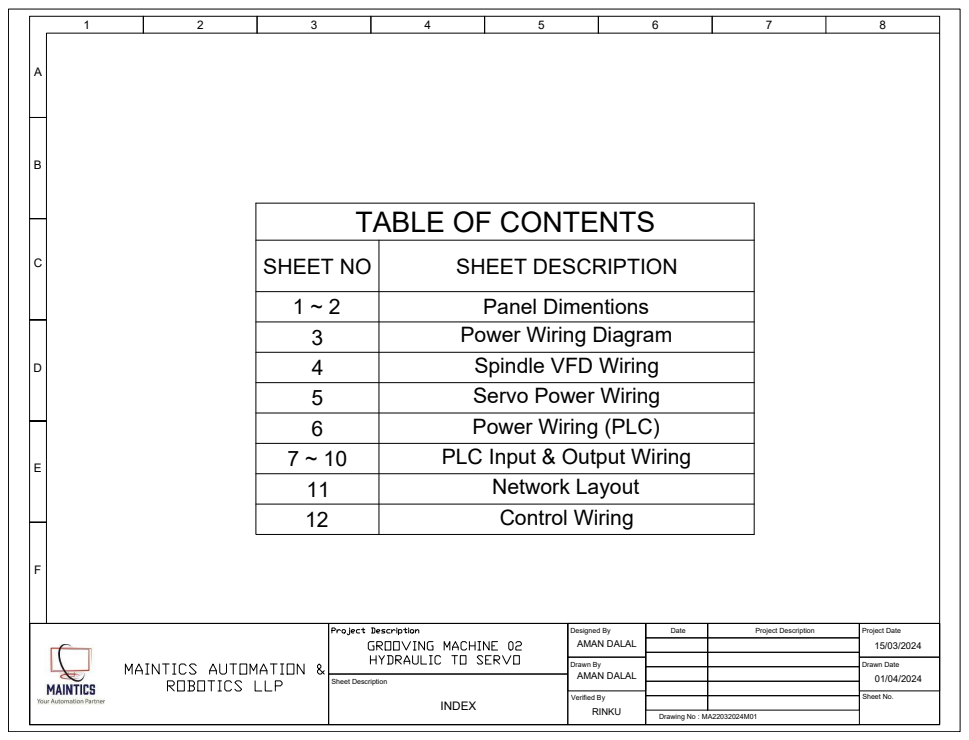
[picture p61: page 2]
ABCDEF; 8 Sheet Description; Designed By Drawn By Verified By; Date; Project Description; Project Date Drawn Date Sheet No. AMAN DALAL AMAN DALAL RINKU; 15/03/2024 01/04/2024 Drawing No : MA22032024M01 INDEX TABLE OF CONTENTS SHEET NO; SHEET DESCRIPTION 1 ~ 2; Panel Dimentions 3; Power Wiring Diagram 4; Spindle VFD Wiring 5; Servo Power Wiring 6; Power Wiring (PLC) 7 ~ 10; PLC Input & Output Wiring 11; Network Layout 12; Control Wiring

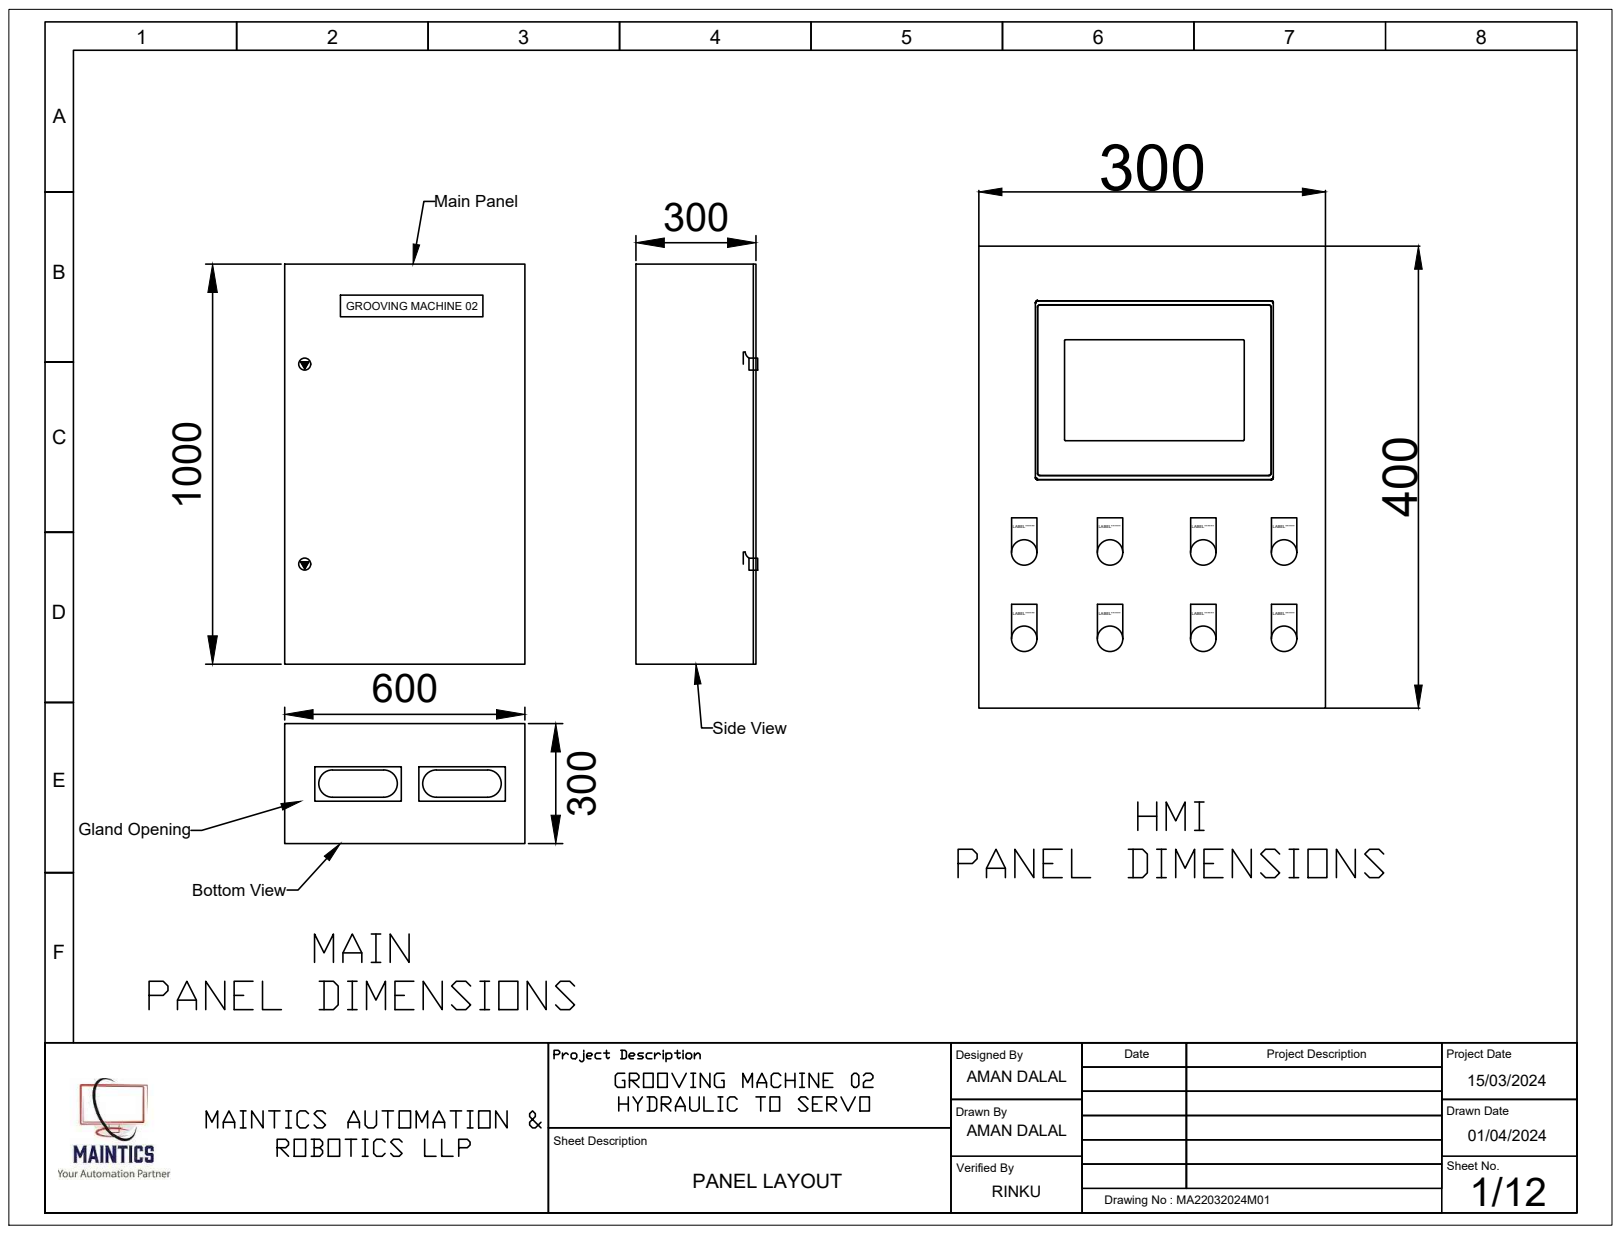
[picture p62: page 3]
ABCDEF; 8 GROOVING MACHINE 02

1000 300 Main Panel Bottom View Gland Opening Side View Sheet Description Designed By Drawn By Verified By Date Project Description Project Date Drawn Date Sheet No. AMAN DALAL AMAN DALAL RINKU 15/03/2024 01/04/2024 Drawing No : MA22032024M01 PANEL LAYOUT 1/12 LABEL****** LABEL****** LABEL****** LABEL****** LABEL****** LABEL****** LABEL****** LABEL******

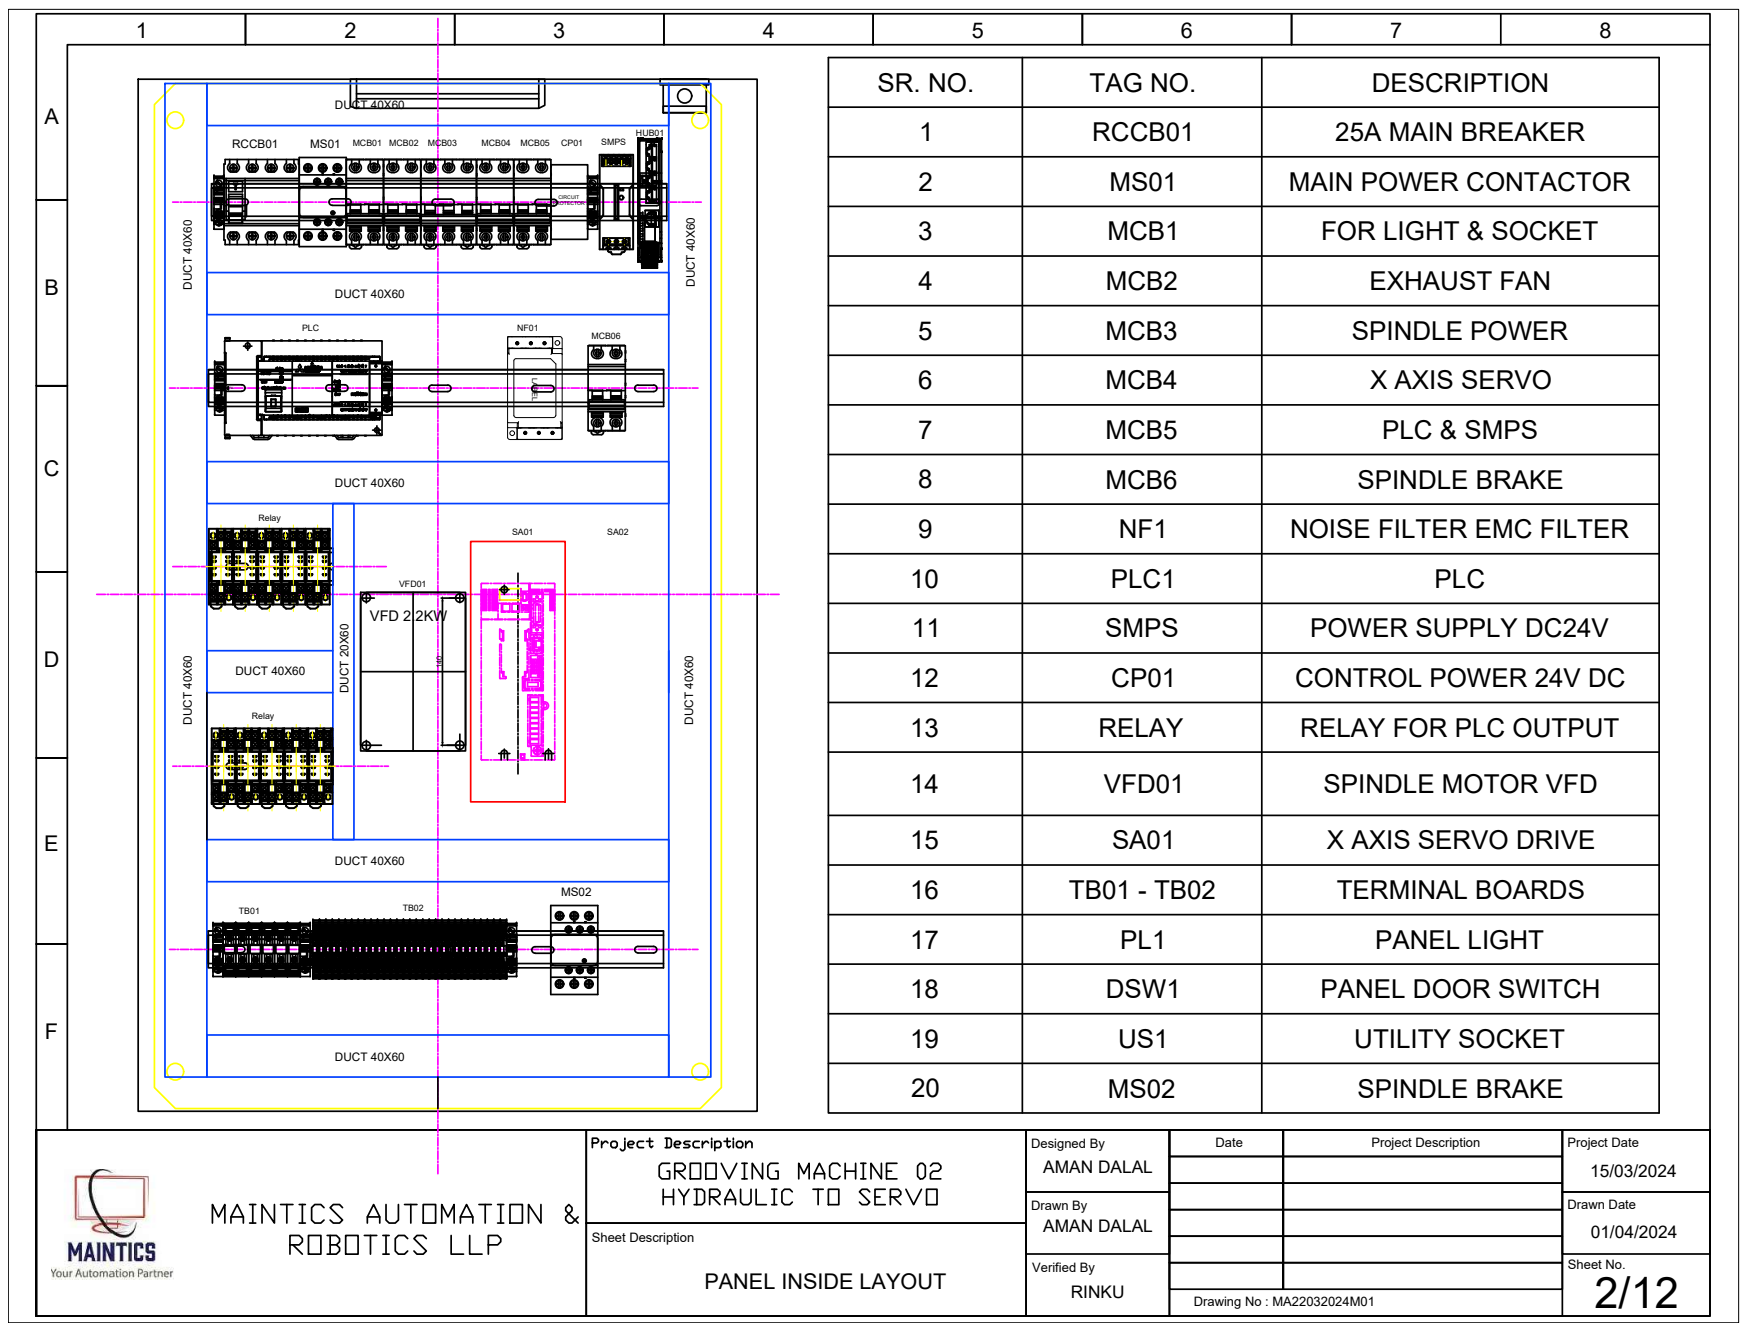
[picture p63: page 4]
ABCDEF; 8 Sheet Description; Designed By Drawn By Verified By; Date; Project Description; Project Date Drawn Date Sheet No. AMAN DALAL PANEL INSIDE LAYOUT; 2/12 AMAN DALAL RINKU SR. NO.; TAG NO.; DESCRIPTION 1; RCCB01; 25A MAIN BREAKER 2; MAIN POWER CONTACTOR 3; MCB1; FOR LIGHT & SOCKET 4; MCB2; EXHAUST FAN 5; MCB3; SPINDLE POWER 6; MCB4; X AXIS SERVO 7; MCB5; PLC & SMPS 8; MCB6; SPINDLE BRAKE 9; NOISE FILTER EMC FILTER 10; PLC1; PLC 11; SMPS; POWER SUPPLY DC24V 12; CONTROL POWER 24V DC 13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

LABEL RCCB01 MS01 MCB01 MCB02 MCB03 MCB04 MCB05 CP01 SMPS HUB01 PLC NF01 Relay VFD01 SA01 SA02 TB01 TB02 DUCT 40X60 DUCT 40X60 DUCT 40X60 DUCT 40X60 DUCT 40X60 DUCT 40X60 DUCT 40X60

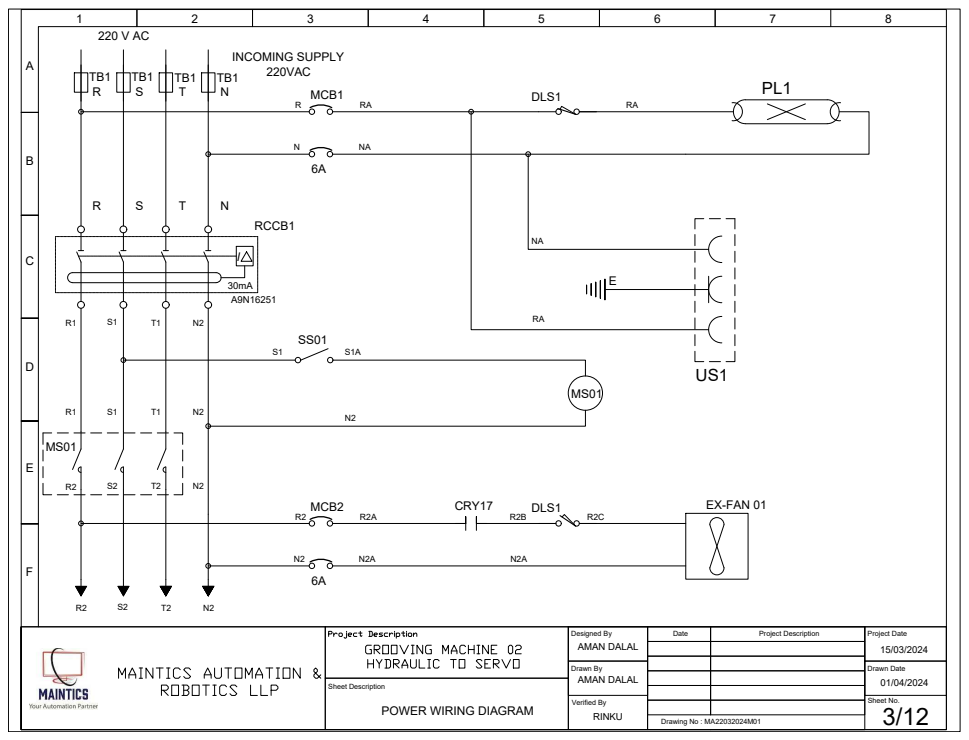
[picture p64: page 5]
ABCDEF; INCOMING SUPPLY 220VAC; MCB1 6A; PL1 DLS1 RA NA; RCCB1 30mA; R2 N2 MCB2 6A; DLS1; R2C CRY17; EX-FAN 01 R2B N2A Sheet Description; Designed By Drawn By Verified By; Date; Project Description; Project Date Drawn Date Sheet No. AMAN DALAL POWER WIRING DIAGRAM; AMAN DALAL RINKU; 15/03/2024 01/04/2024 Drawing No : MA22032024M01

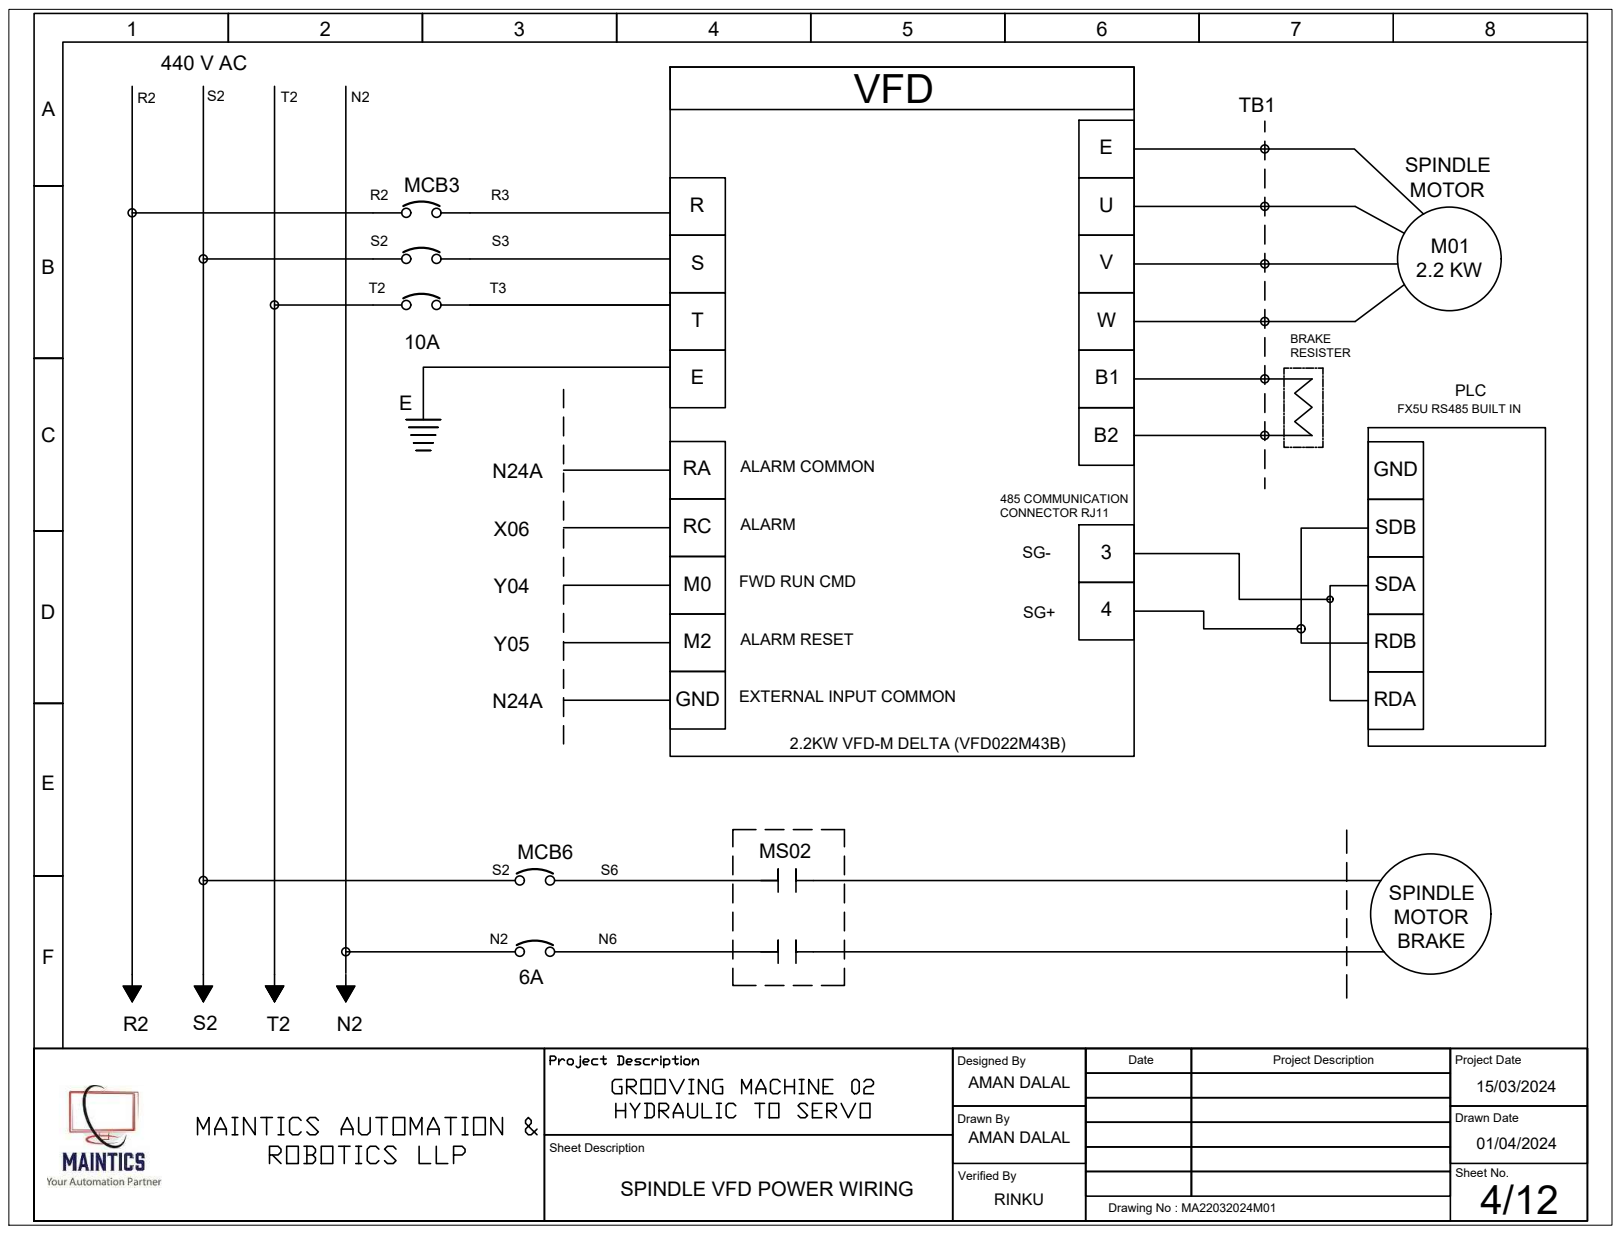
[picture p65: page 6]
ABCDEF; 8 SPINDLE VFD POWER WIRING; MCB3 10A; SPINDLE MOTOR TB1; VFD N24A; Sheet Description; Designed By Drawn By Verified By; Date; Project Description; Project Date Drawn Date Sheet No. AMAN DALAL AMAN DALAL RINKU; 15/03/2024 01/04/2024 Drawing No : MA22032024M01 N2N2; S2 N2 MCB6 6A; SPINDLE MOTOR BRAKE RARCM0 M2 GND X06 Y04 Y05 N24A; ALARM COMMON ALARM FWD RUN CMD ALARM RESET EXTERNAL INPUT COMMON; UVW RST; 34 SG- SG+ 485 COMMUNICATION CONNECTOR RJ11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

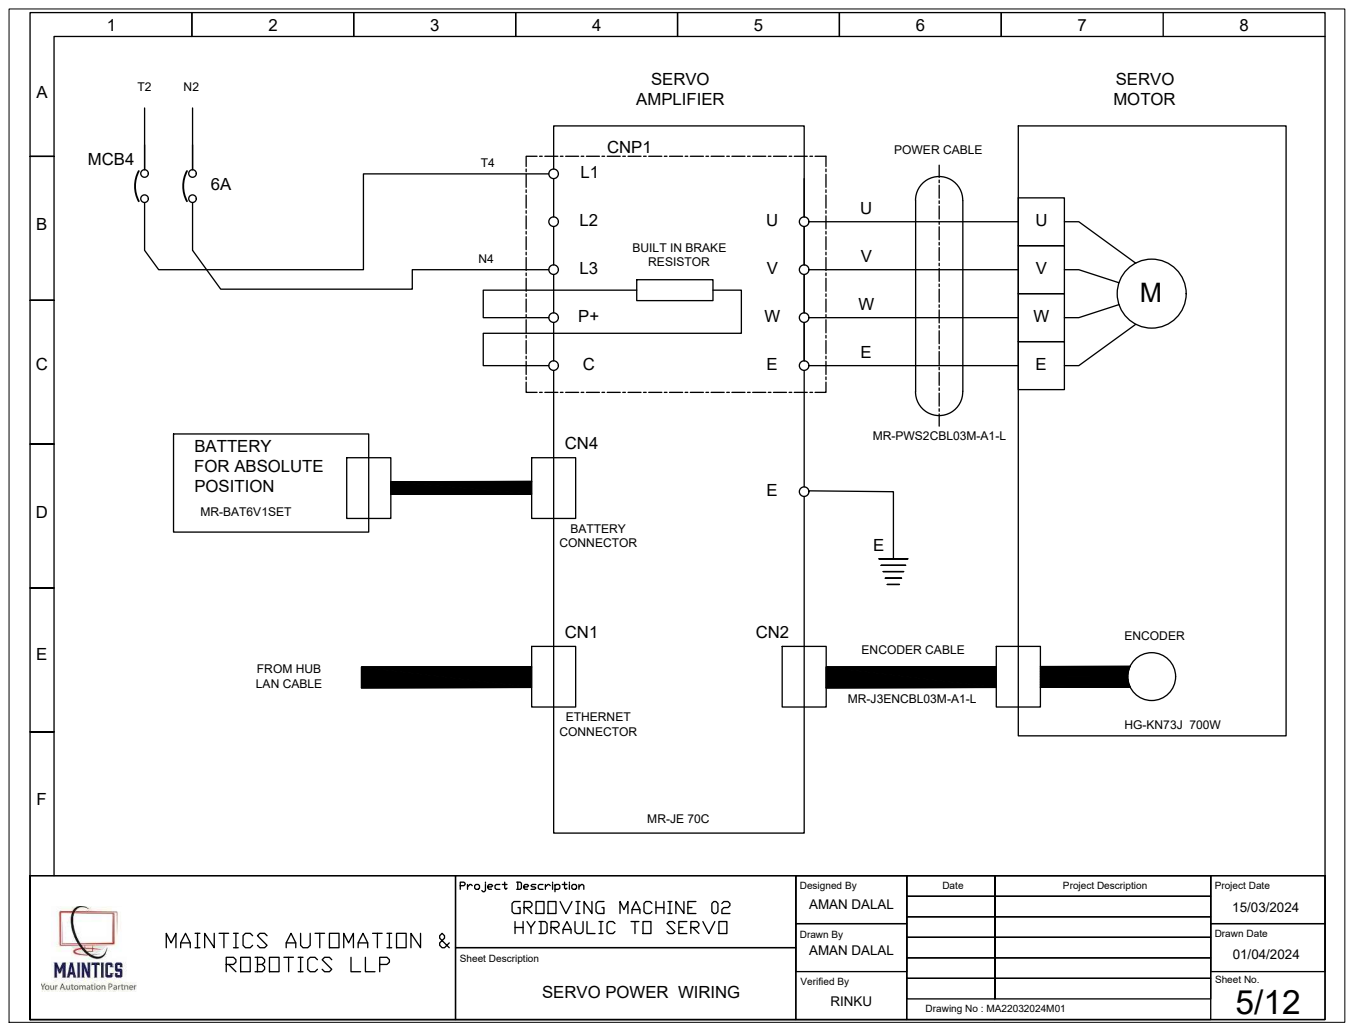
[picture p66: page 7]
ABCDEF; 8 SERVO POWER WIRING; SERVO AMPLIFIER L1L2L3P+C; UVWEE T4 N4; E CNP1; SERVO MOTOR UVWE; UVWEENCODER CABLE MR-J3ENCBL03M-A1-L POWER CABLE MR-PWS2CBL03M-A1-L MR-JE 70C; HG-KN73J 700W ENCODER MCB4; Sheet Description; Designed By Drawn By Verified By; Date; Project Description; Project Date Drawn Date Sheet No. AMAN DALAL AMAN DALAL RINKU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

ABCDEF; 8 S5A N5A POWER WIRING; MCB5 S5 N5; SMPS S8VK-C06024 24VDC 2A; 24V DC CONTROL POWER 12; RHSN - 2006 220 V AC; PULL; PLC FX5U-32MT/ES Sheet Description; Designed By Drawn By Verified By; Date; Project Description; Project Date Drawn Date Sheet No. AMAN DALAL AMAN DALAL RINKU; 15/03/2024 01/04/2024 Drawing No : MA22032024M01

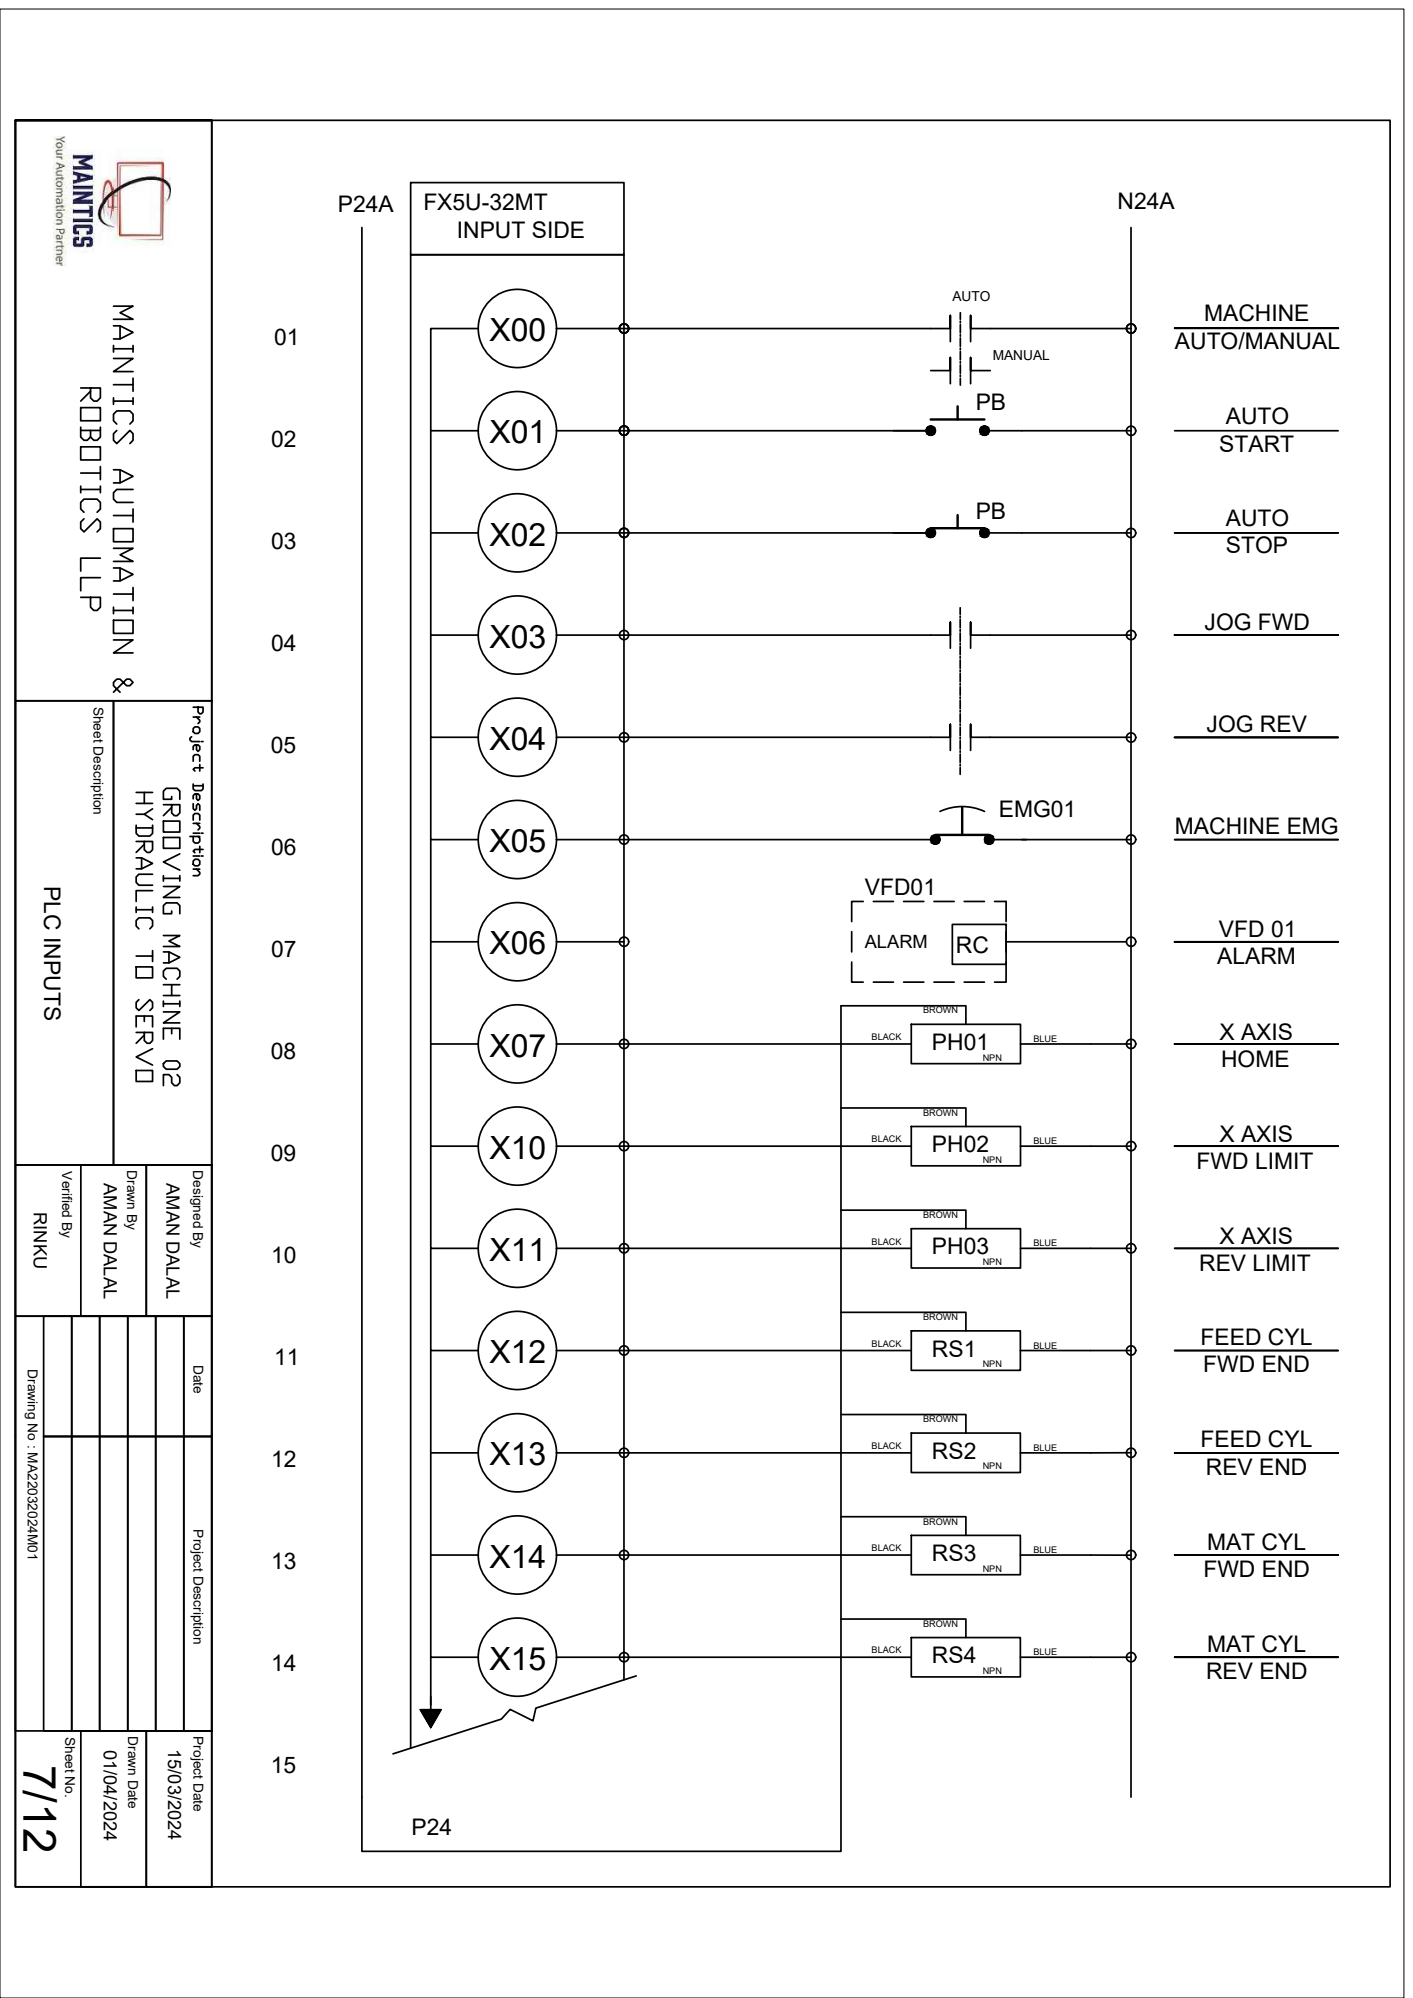
[picture p67: page 9]
INPUT SIDE; VFD 01; FEED CYL FWD END; MACHINE EMG; JOG REV; JOG FWD; AUTO/MANUAL Verified By; Drawn By; Designed By Date Project Description Sheet No.; Drawn Date; Project Date AMAN DALAL; AMAN DALAL RINKU; RS1 BLACK; BLUE; NPN RS2 BLACK; NPN RS3 BLACK; NPN RS4 BLACK; NPN P24; PH01 BLACK; FEED CYL REV END; MAT CYL FWD END; MAT CYL REV END; PH02 BLACK; NPN PH03 BLACK; X AXIS; X AXIS FWD LIMIT; X AXIS REV LIMIT; AUTO MANUAL 01/04/2024; 15/03/2024 Drawing No : MA22032024M01

X15 Sheet Description PLC INPUTS 7/12

BROWN

NPN

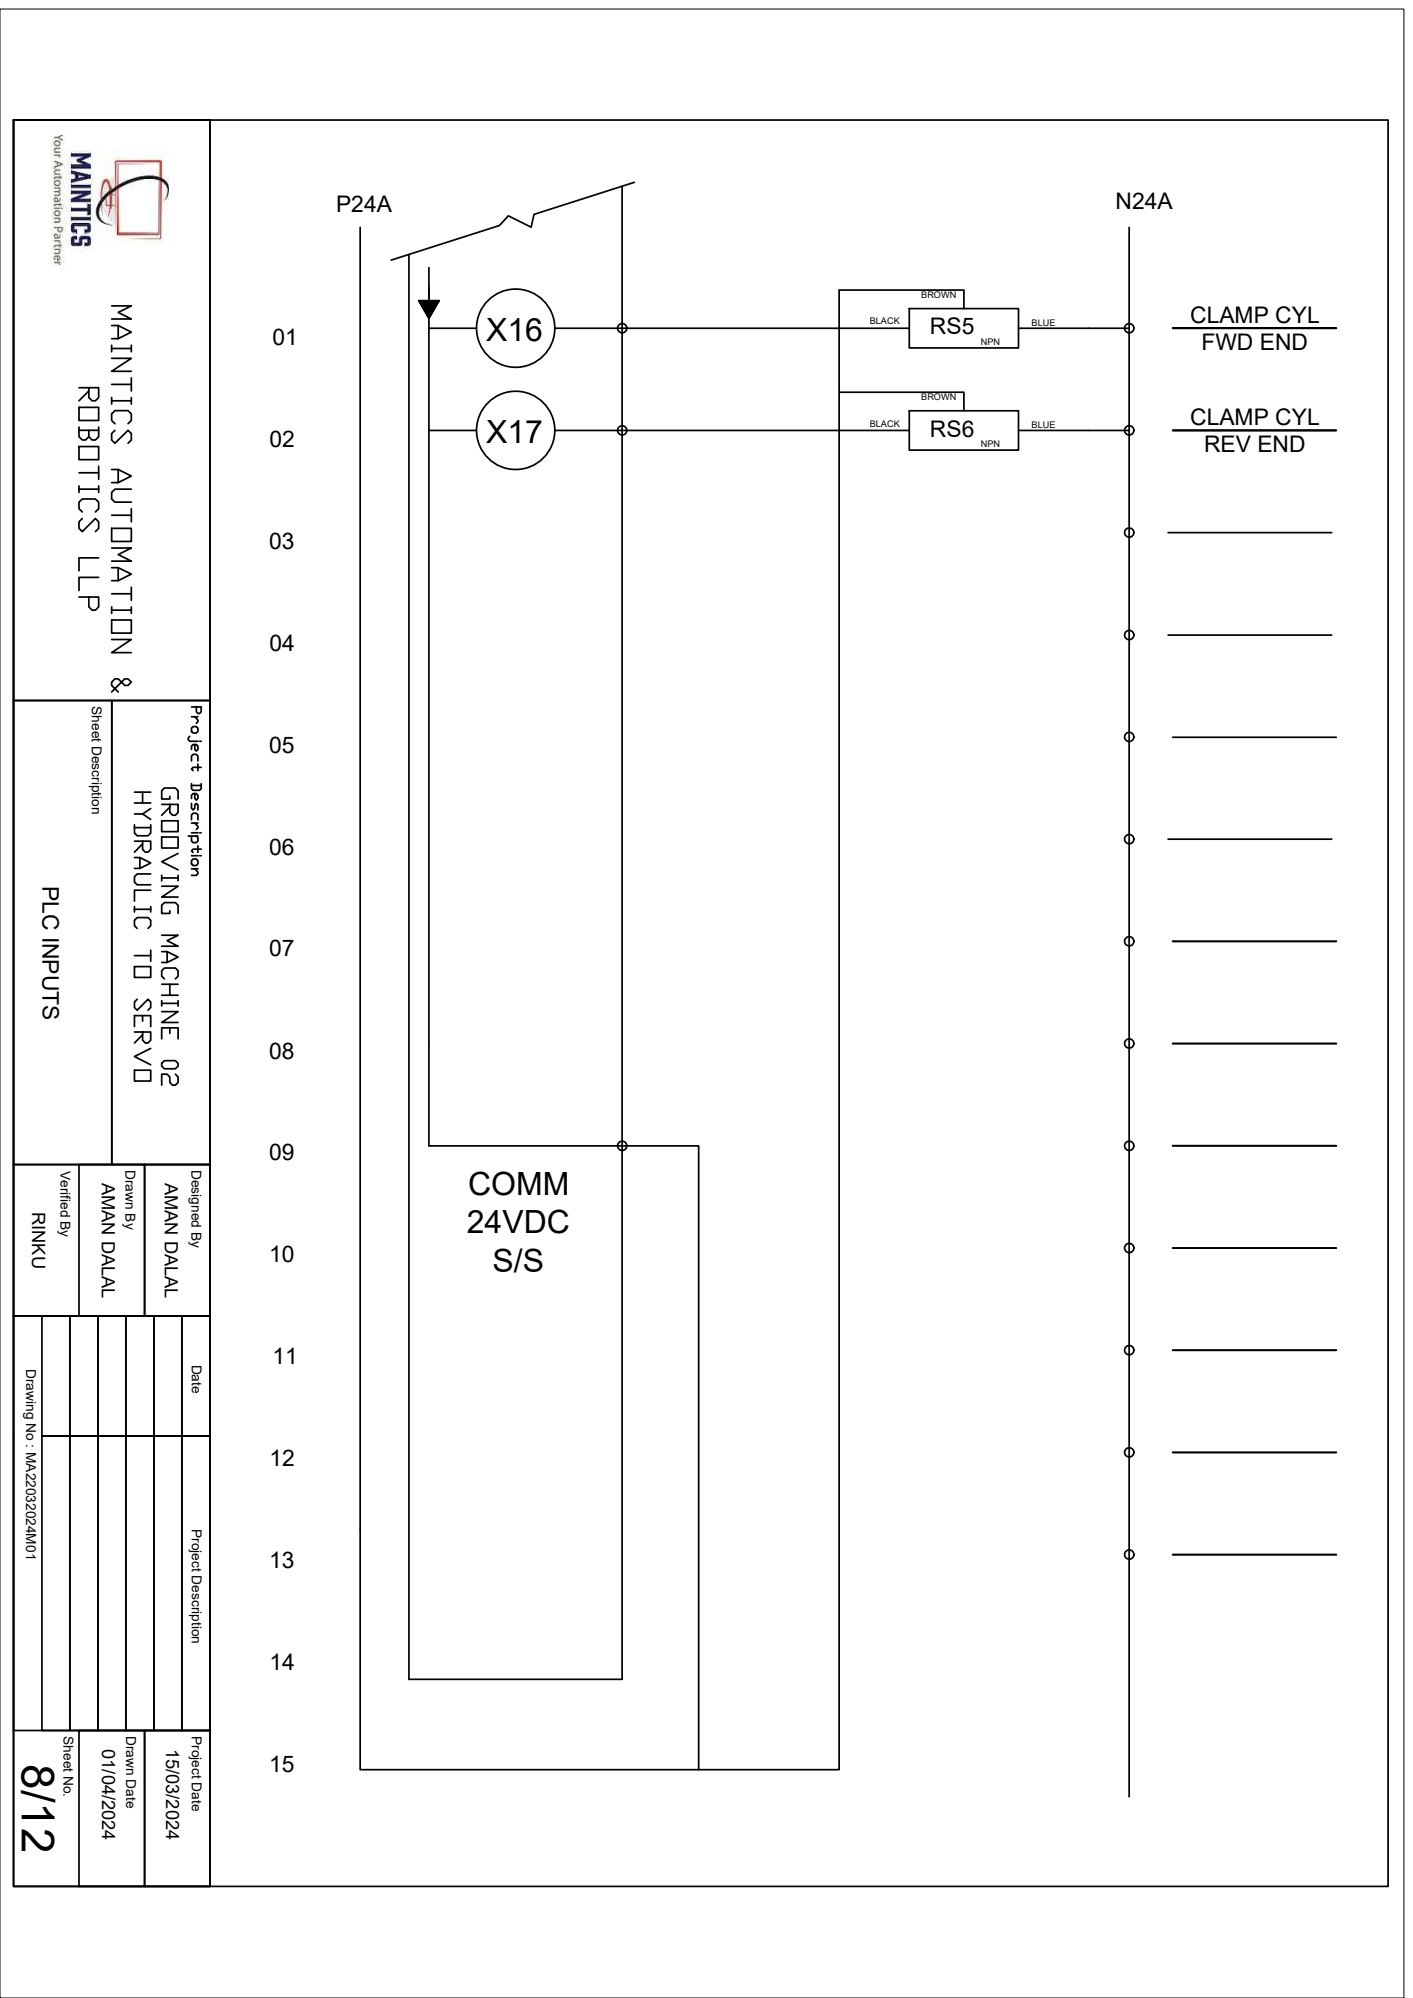
[picture p68: page 10]
RS5 BLACK; BLUE; NPN RS6 BLACK; NPN; CLAMP CYL; FWD END; REV END Sheet Description PLC INPUTS Verified By; Drawn By; Designed By Date Project Description Sheet No.; Drawn Date; Project Date AMAN DALAL; AMAN DALAL RINKU; 15/03/2024 Drawing No : MA22032024M01

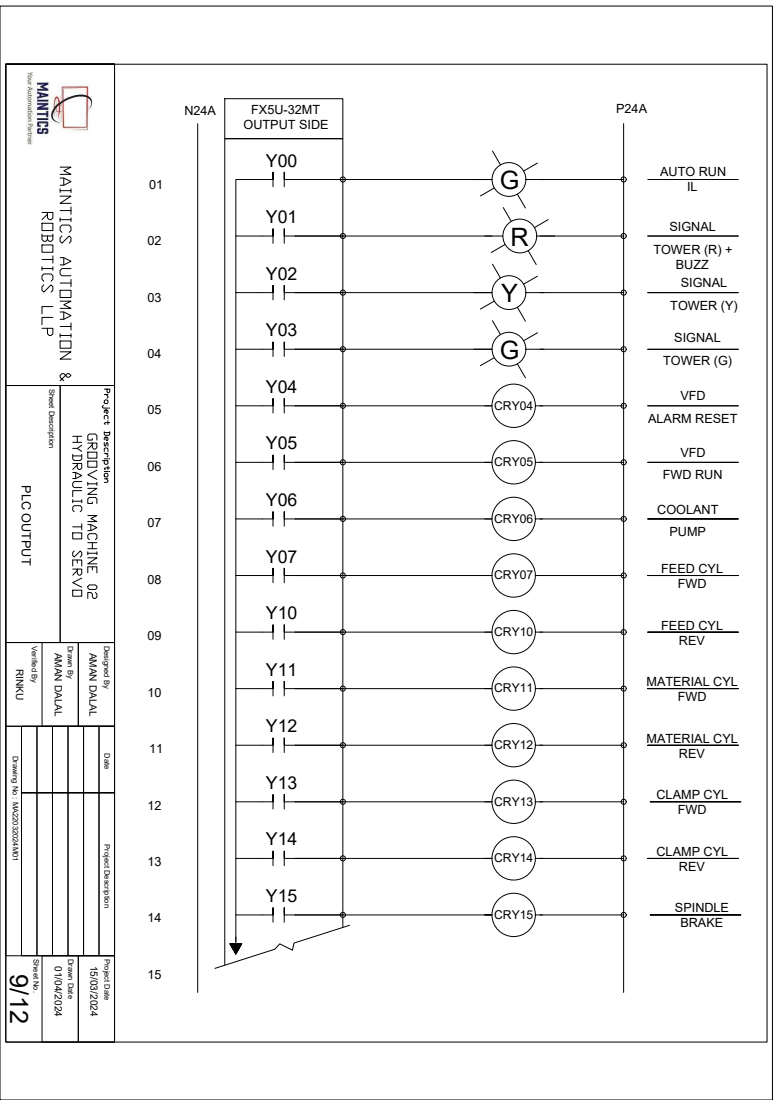
[picture p69: page 11]
TOWER (R) +; TOWER (Y); TOWER (G) RYG; OUTPUT SIDE; AUTO RUN G; FEED CYL; MATERIAL CYL; CLAMP CYL; FWD RUN; ALARM RESET; BRAKE Sheet Description PLC OUTPUT 9/12 Verified By; Drawn By; Designed By Date Project Description Sheet No.; Drawn Date; Project Date AMAN DALAL; AMAN DALAL RINKU; 15/03/2024 Drawing No : MA22032024M01

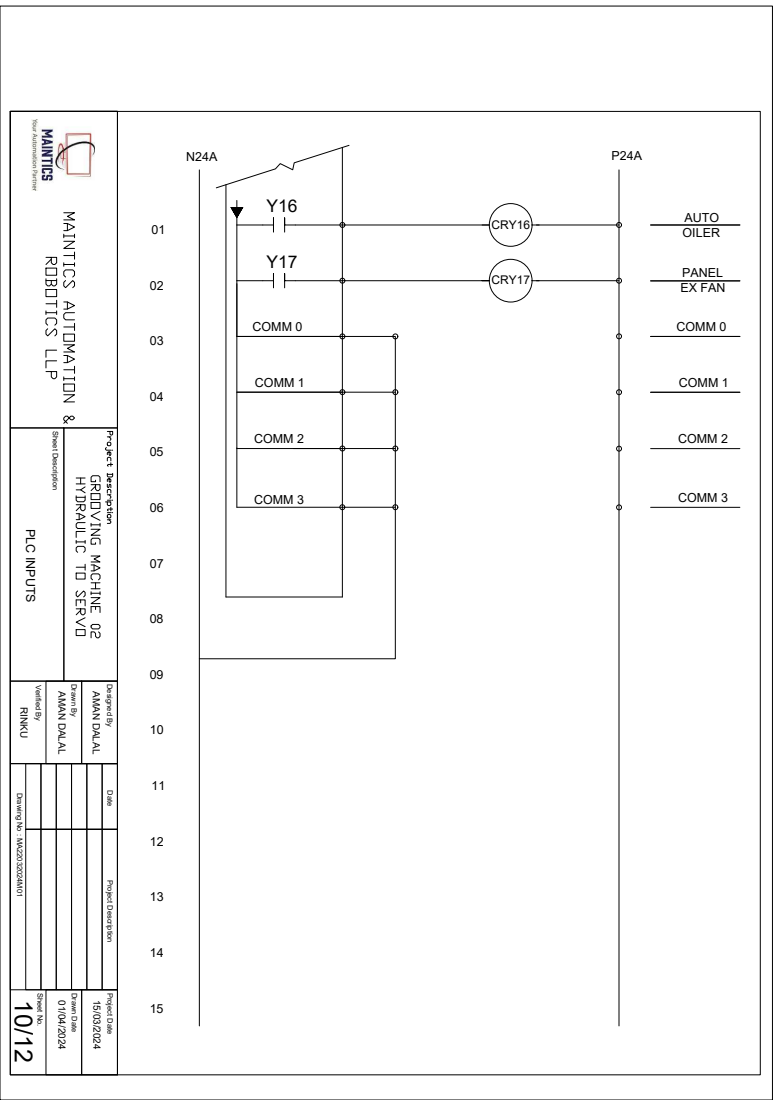
[picture p70: page 12]
COMM 0; COMM 1; COMM 2; COMM 3; EX FAN CRY17 Sheet Description PLC INPUTS 10/12 Verified By; Drawn By; Designed By Date Project Description Sheet No.; Drawn Date; Project Date AMAN DALAL; AMAN DALAL RINKU; 15/03/2024 Drawing No : MA22032024M01


N24A HMI GS2107-WTBD-N P24A N24A HMI HMI POWER & NETWORK 11/12 24 V DC US GND E E E P24A N24A P24A N24A FL1005N SWITCH 01 02 03 04 05 NETWORK TO PLC TO SERVO Sheet Description Designed By Drawn By Verified By Date Project Description Project Date Drawn Date Sheet No. AMAN DALAL AMAN DALAL RINKU 15/03/2024 01/04/2024 Drawing No : MA22032024M01

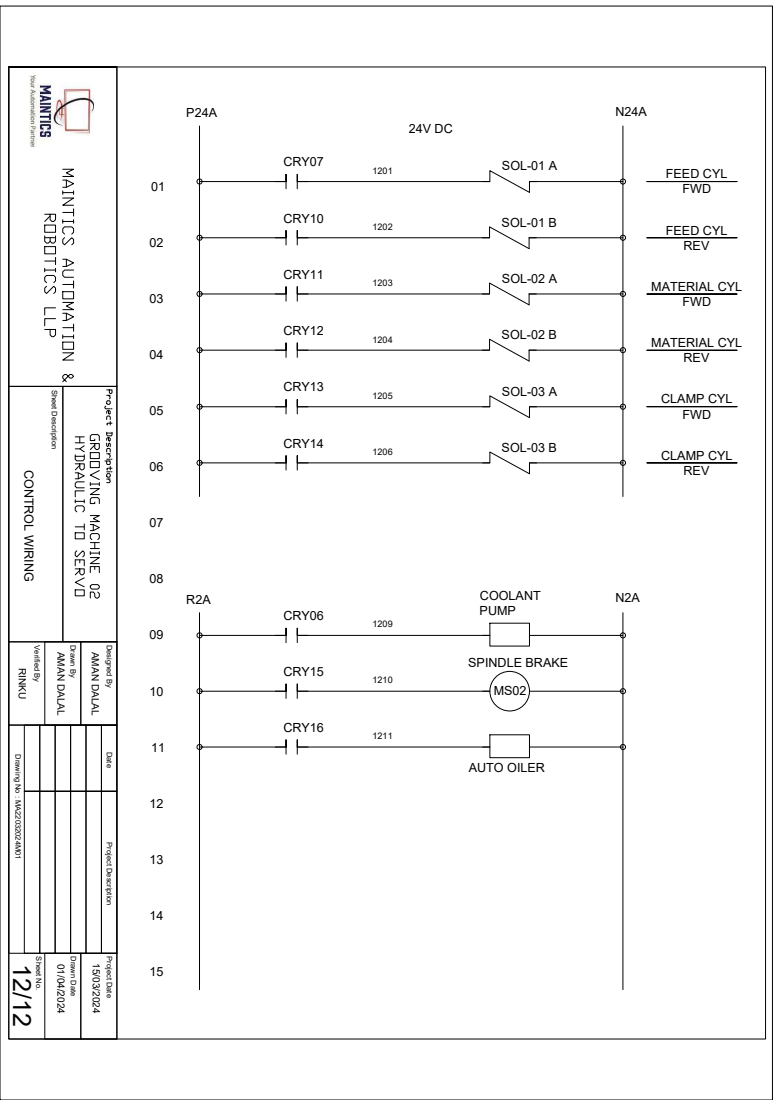
[picture p71: page 14]
SOL-01 A; SOL-01 B; FEED CYL; MATERIAL CYL; CLAMP CYL; SOL-02 A; SOL-02 B; SOL-03 A; SOL-03 B; PUMP CRY06; CRY14 Sheet Description CONTROL WIRING 12/12 Verified By; Drawn By; Designed By Date Project Description Sheet No.; Drawn Date; Project Date AMAN DALAL; AMAN DALAL RINKU; 15/03/2024 Drawing No : MA22032024M01; SPINDLE BRAKE CRY15; AUTO OILER
