amandalal143/github-demo-noval/Grooving Servo Machine/4. Drawing and Manual/Ladder Logic 01052024.pdf

& [GROOVING MACHINE 02] | 30-04-2024

## DONE BY : & [MAINTICS]

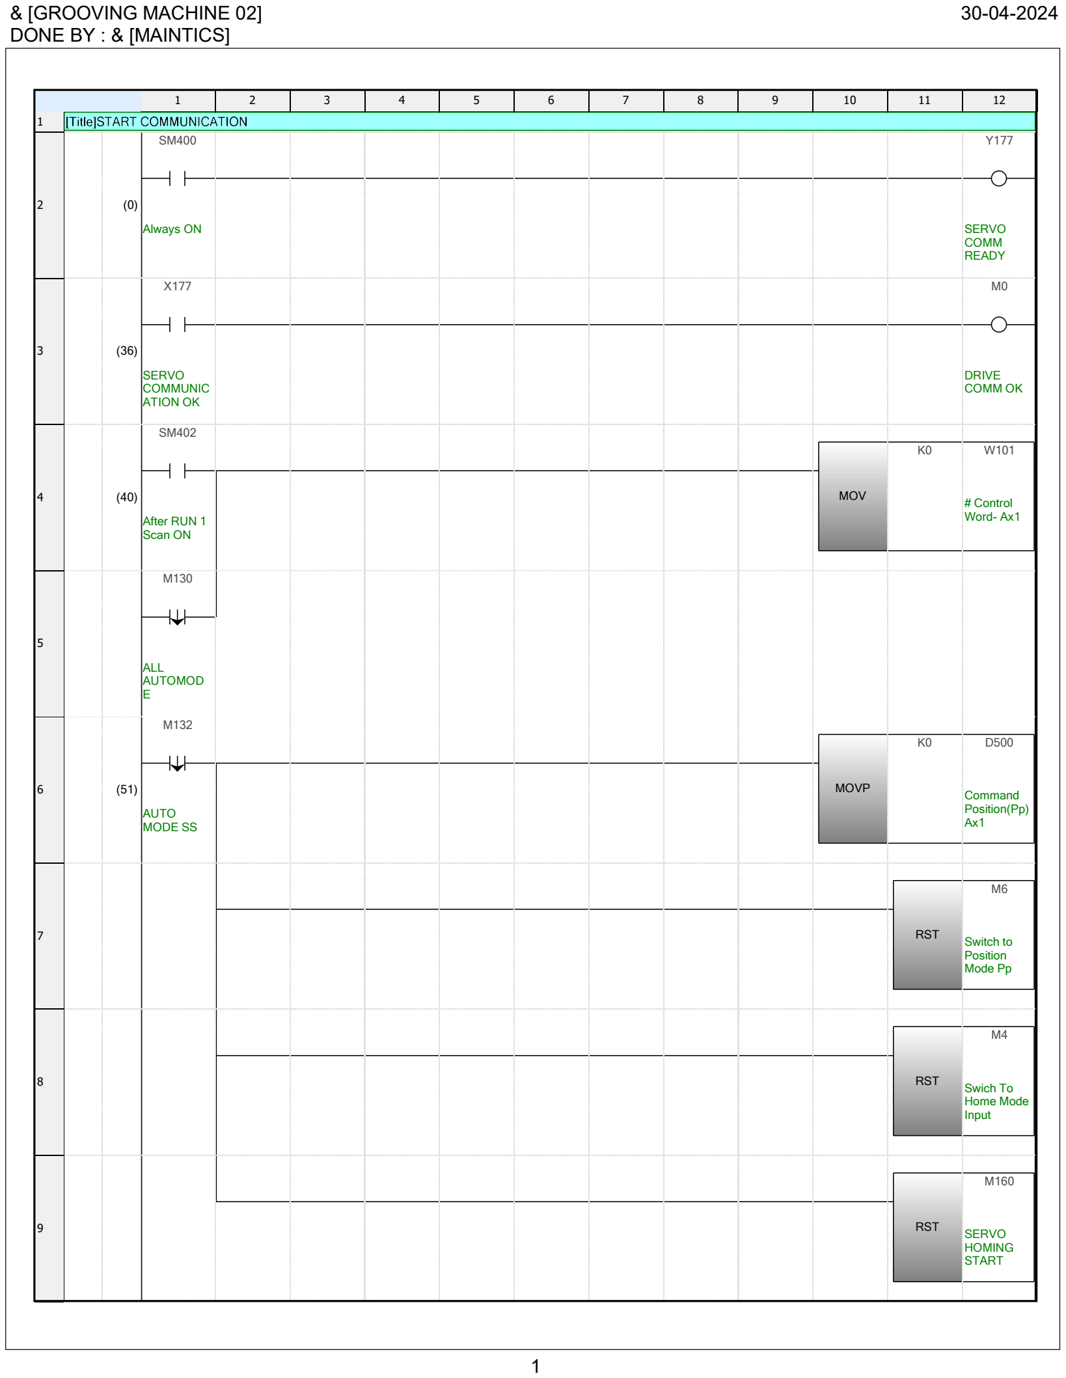
[picture p91: page 1]

1

1 | 2 | 3 | 4 | 5 | 6 | 7 | 8 | 9 | 10 | 11 | 12
1

2 (0)

SM400

Always ON

Y177

SERVO
COMM
READY

3 (36)

X177

SERVO
COMMUNIC
ATION OK

M0

DRIVE
COMM OK

4 (40)

SM402

After RUN 1
Scan ON

MOV

K0 | W101

# Control

Word- Ax1

5

M130

ALL
AUTOMOD
E

6 (51)

M132

AUTO
MODE SS

MOVP

K0 | D500

Command
Position(Pp)
Ax1

### 7 RST

M6

Switch to
Position
Mode Pp

### 8 RST

M4

Swich To
Home Mode
Input

### 9 RST

M160

SERVO
HOMING
START

& [GROOVING MACHINE 02] | 30-04-2024

## DONE BY : & [MAINTICS]

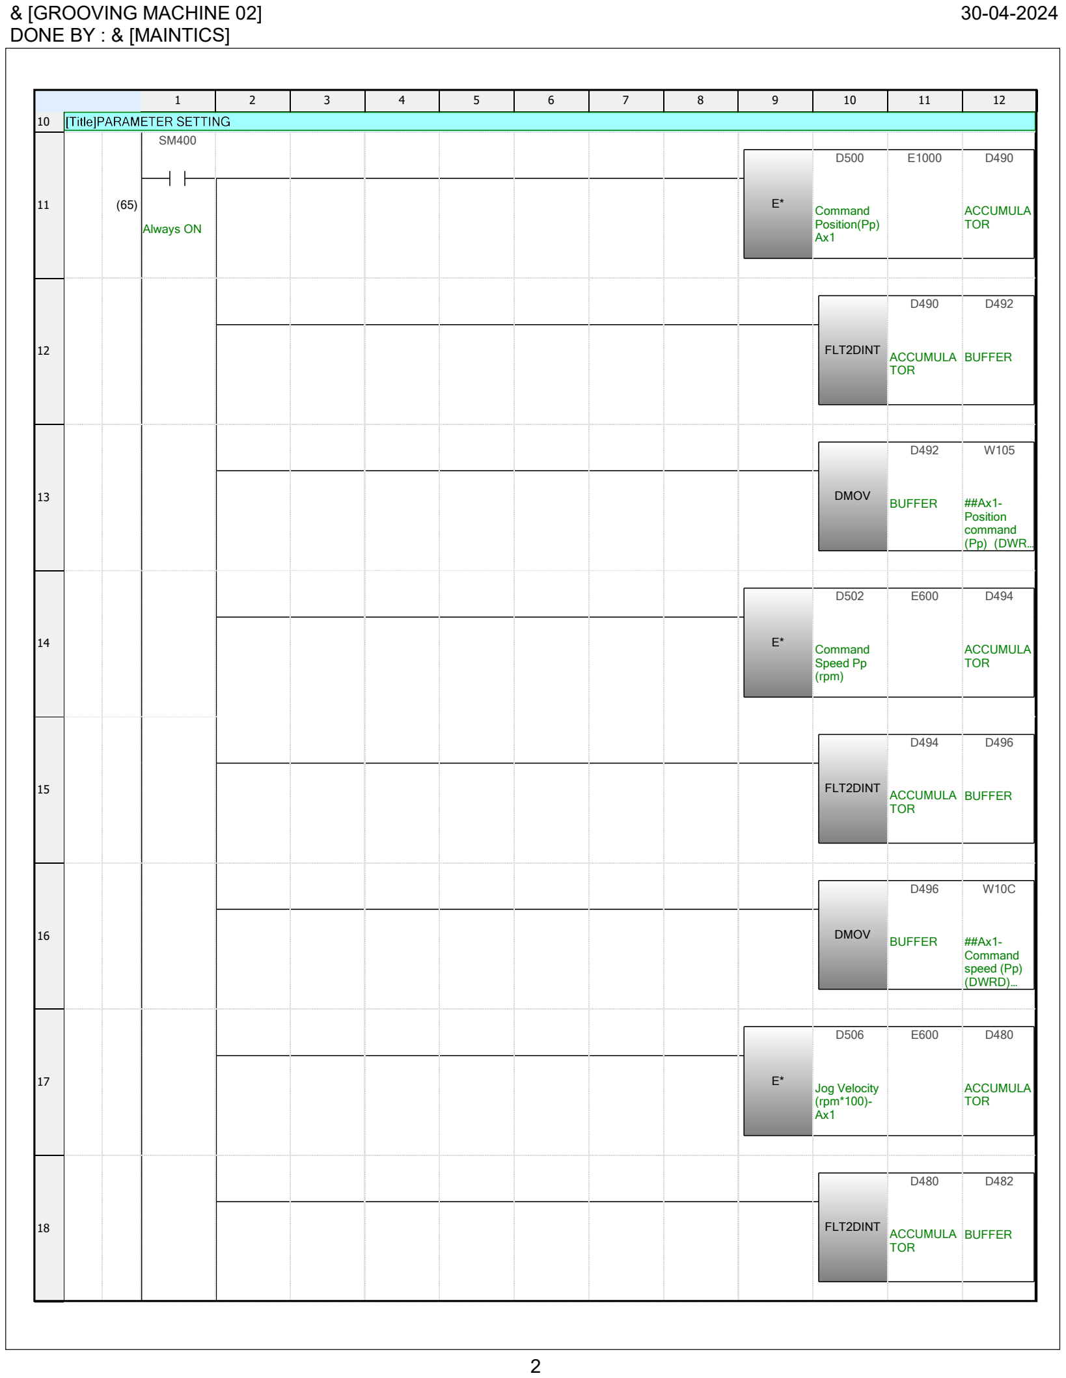
[picture p92: page 2]

2

1 | 2 | 3 | 4 | 5 | 6 | 7 | 8 | 9 | 10 | 11 | 12
10

11 (65)

SM400

Always ON

E*

D500

Command
Position(Pp)
Ax1
E1000 | D490

ACCUMULA
TOR

### 12 FLT2DINT

D490

ACCUMULA
TOR

D492

BUFFER

### 13 DMOV

D492

BUFFER

W105

##Ax1-

Position
command
(Pp) (DWR…

### 14 E*

D502

Command
Speed Pp
(rpm)
E600 | D494

ACCUMULA
TOR

### 15 FLT2DINT

D494

ACCUMULA
TOR

D496

BUFFER

### 16 DMOV

D496

BUFFER

W10C

##Ax1-

Command
speed (Pp)
(DWRD)…

### 17 E*

D506

Jog Velocity
(rpm*100)-
Ax1
E600 | D480

ACCUMULA
TOR

### 18 FLT2DINT

D480

ACCUMULA
TOR

D482

BUFFER

& [GROOVING MACHINE 02] | 30-04-2024

## DONE BY : & [MAINTICS]

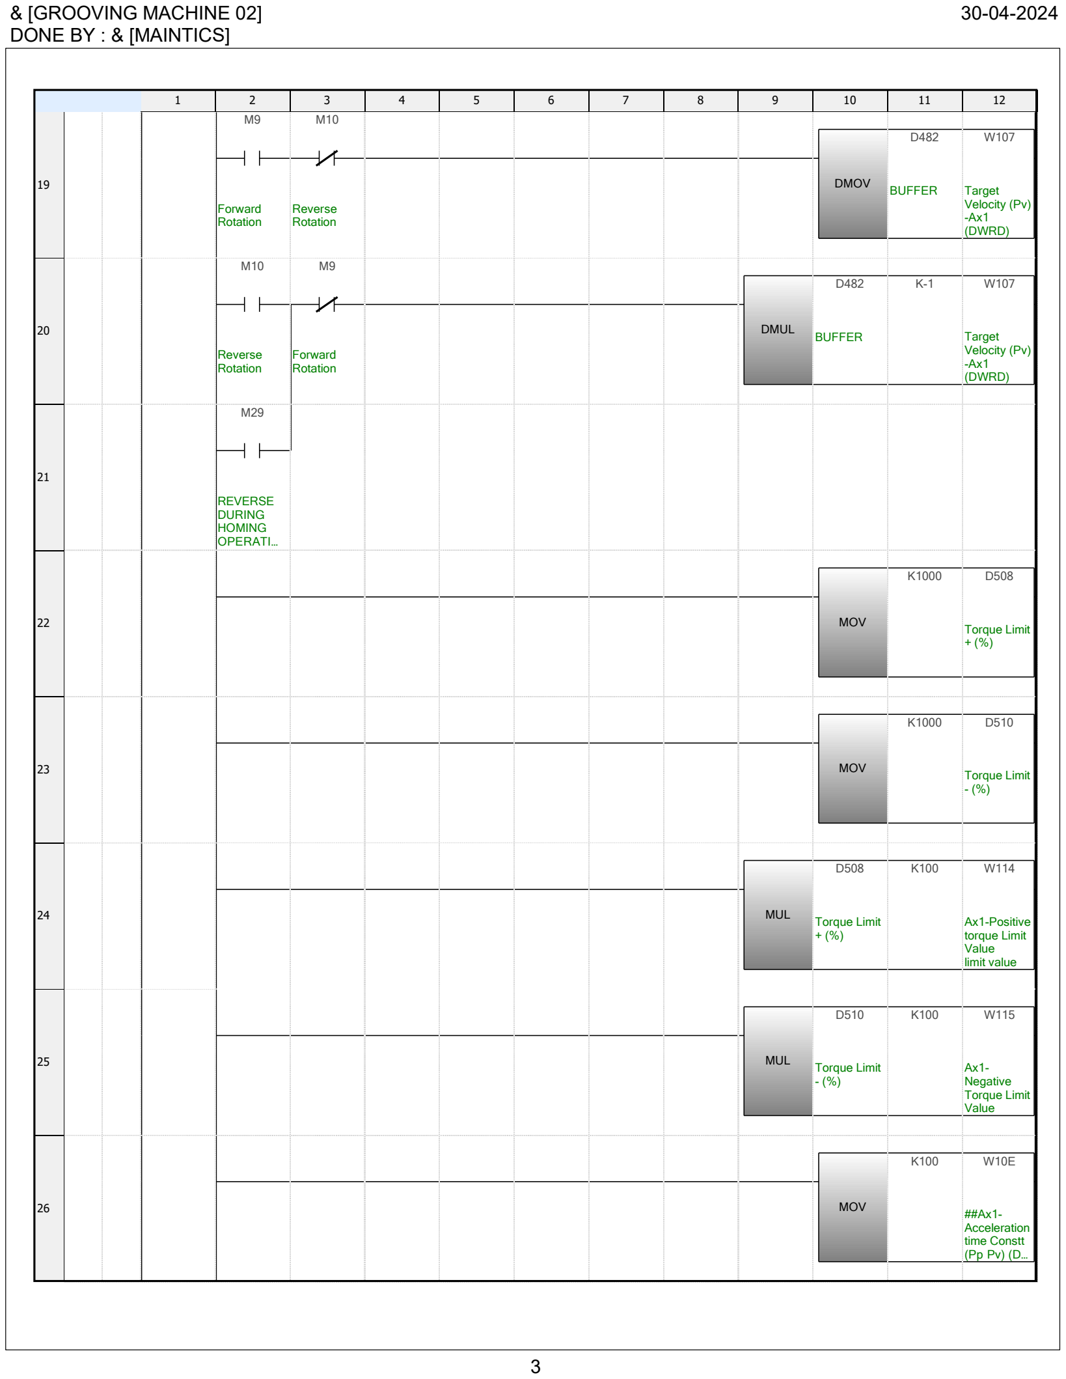
[picture p93: page 3]

3

1 | 2 | 3 | 4 | 5 | 6 | 7 | 8 | 9 | 10 | 11 | 12

19

M9

Forward
Rotation

M10

Reverse
Rotation

DMOV

D482

BUFFER

W107

Target
Velocity (Pv)
-Ax1
(DWRD)

20

M10

Reverse
Rotation

M9

Forward
Rotation

DMUL

D482

BUFFER

K-1 | W107

Target
Velocity (Pv)
-Ax1
(DWRD)

21

M29

REVERSE
DURING
HOMING
OPERATI…

### 22 MOV

K1000 | D508

Torque Limit
+ (%)

### 23 MOV

K1000 | D510

Torque Limit
- (%)

### 24 MUL

D508

Torque Limit
+ (%)
K100 | W114

Ax1-Positive
torque Limit
Value
limit value

### 25 MUL

D510

Torque Limit
- (%)
K100 | W115

Ax1-
Negative
Torque Limit
Value

### 26 MOV

K100 | W10E

##Ax1-

Acceleration
time Constt
(Pp Pv) (D…

& [GROOVING MACHINE 02] | 30-04-2024

## DONE BY : & [MAINTICS]

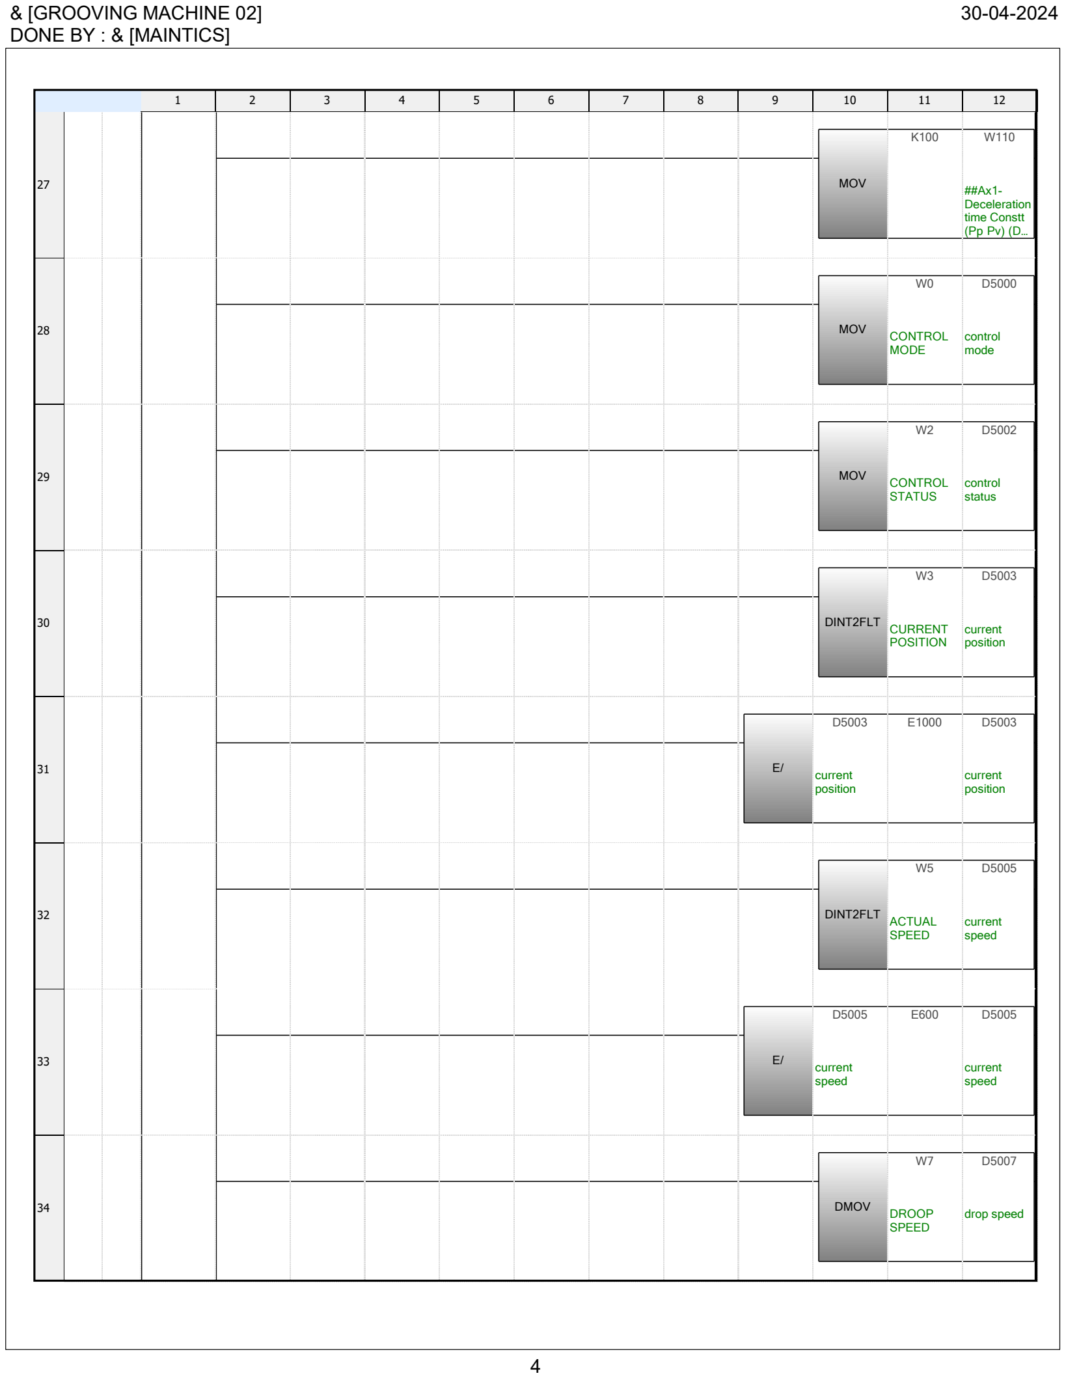
[picture p94: page 4]

4

1 | 2 | 3 | 4 | 5 | 6 | 7 | 8 | 9 | 10 | 11 | 12

### 27 MOV

K100 | W110

##Ax1-

Deceleration
time Constt
(Pp Pv) (D…

### 28 MOV

W0

CONTROL
MODE

D5000

control
mode

### 29 MOV

W2

CONTROL
STATUS

D5002

control
status

### 30 DINT2FLT

W3

CURRENT
POSITION

D5003

current
position

### 31 E/

D5003

current
position

E1000 D5003

current
position

### 32 DINT2FLT

W5

ACTUAL
SPEED

D5005

current
speed

### 33 E/

D5005

current
speed
E600 | D5005

current
speed

### 34 DMOV

W7

DROOP
SPEED

D5007

drop speed

& [GROOVING MACHINE 02] | 30-04-2024

## DONE BY : & [MAINTICS]

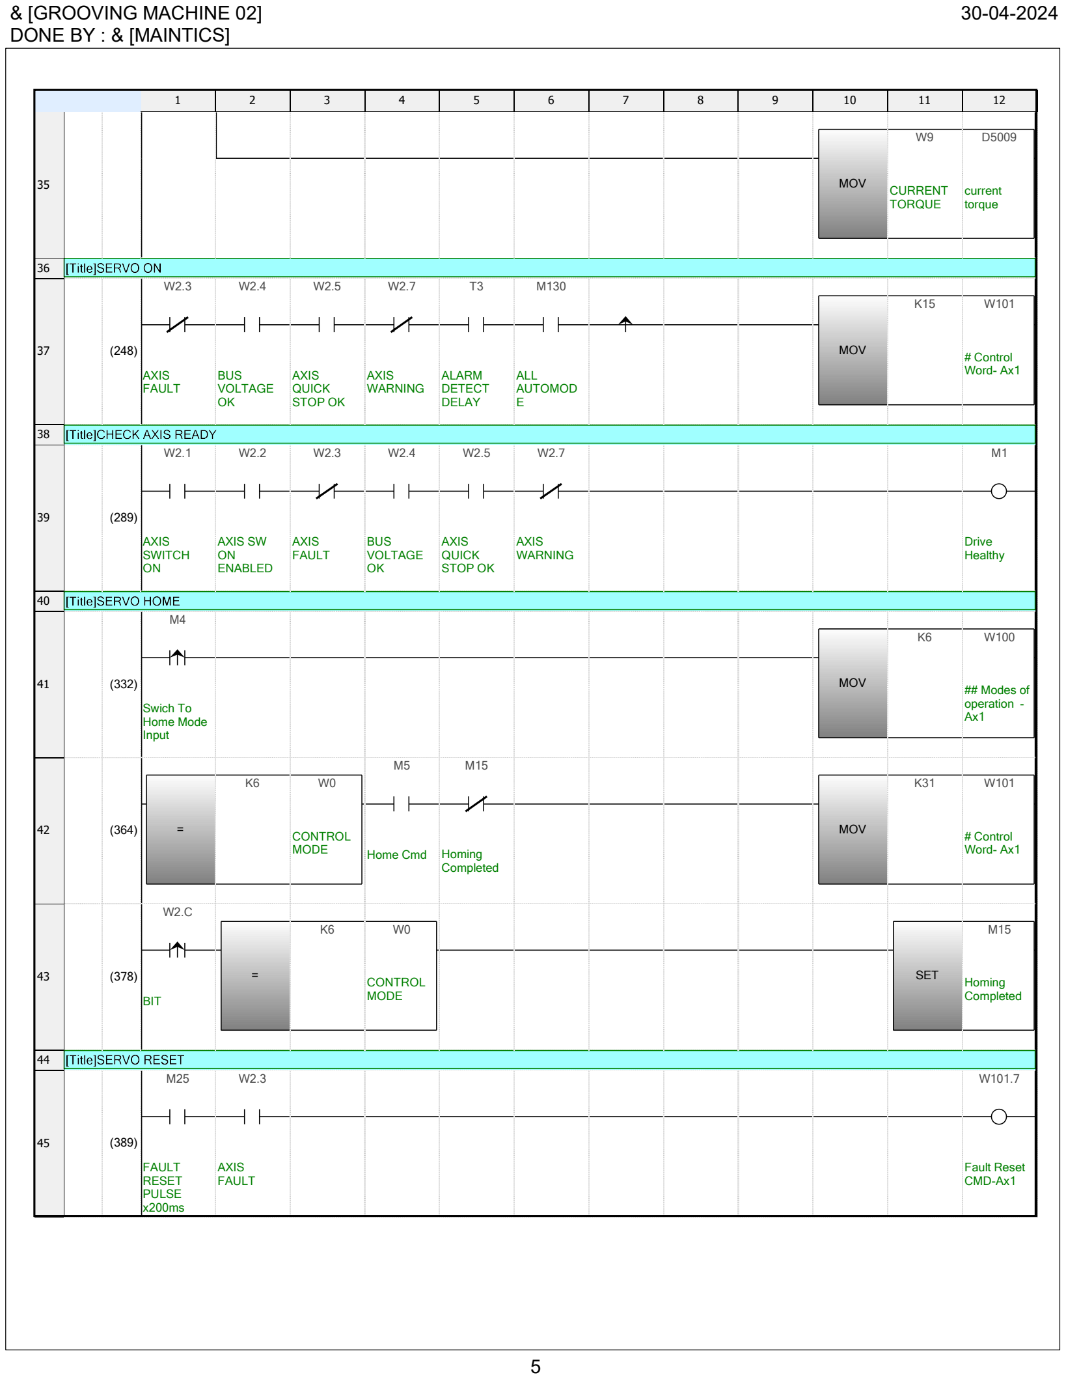
[picture p95: page 5]

5

1 | 2 | 3 | 4 | 5 | 6 | 7 | 8 | 9 | 10 | 11 | 12

### 35 MOV

W9

CURRENT
TORQUE

D5009

current
torque

36

37 (248)

W2.3

AXIS
FAULT

W2.4

BUS
VOLTAGE
OK

W2.5

AXIS
QUICK
STOP OK

W2.7

AXIS
WARNING

T3

ALARM
DETECT
DELAY

M130

ALL
AUTOMOD
E

MOV

K15 | W101

# Control

Word- Ax1

38

39 (289)

W2.1

AXIS
SWITCH
ON

W2.2

AXIS SW
ON
ENABLED

W2.3

AXIS
FAULT

W2.4

BUS
VOLTAGE
OK

W2.5

AXIS
QUICK
STOP OK

W2.7

AXIS
WARNING

M1

Drive
Healthy

40

41 (332)

M4

Swich To
Home Mode
Input

MOV

K6 | W100

## Modes of

operation -
Ax1
42 | (364) | =
K6 | W0

CONTROL
MODE

M5

Home Cmd

M15

Homing
Completed

MOV

K31 | W101

# Control

Word- Ax1

43 (378)

W2.C

BIT

=

K6 | W0

CONTROL
MODE

SET

M15

Homing
Completed

44

45 (389)

M25

FAULT
RESET
PULSE
x200ms

W2.3

AXIS
FAULT

W101.7

Fault Reset
CMD-Ax1

& [GROOVING MACHINE 02] | 30-04-2024

## DONE BY : & [MAINTICS]

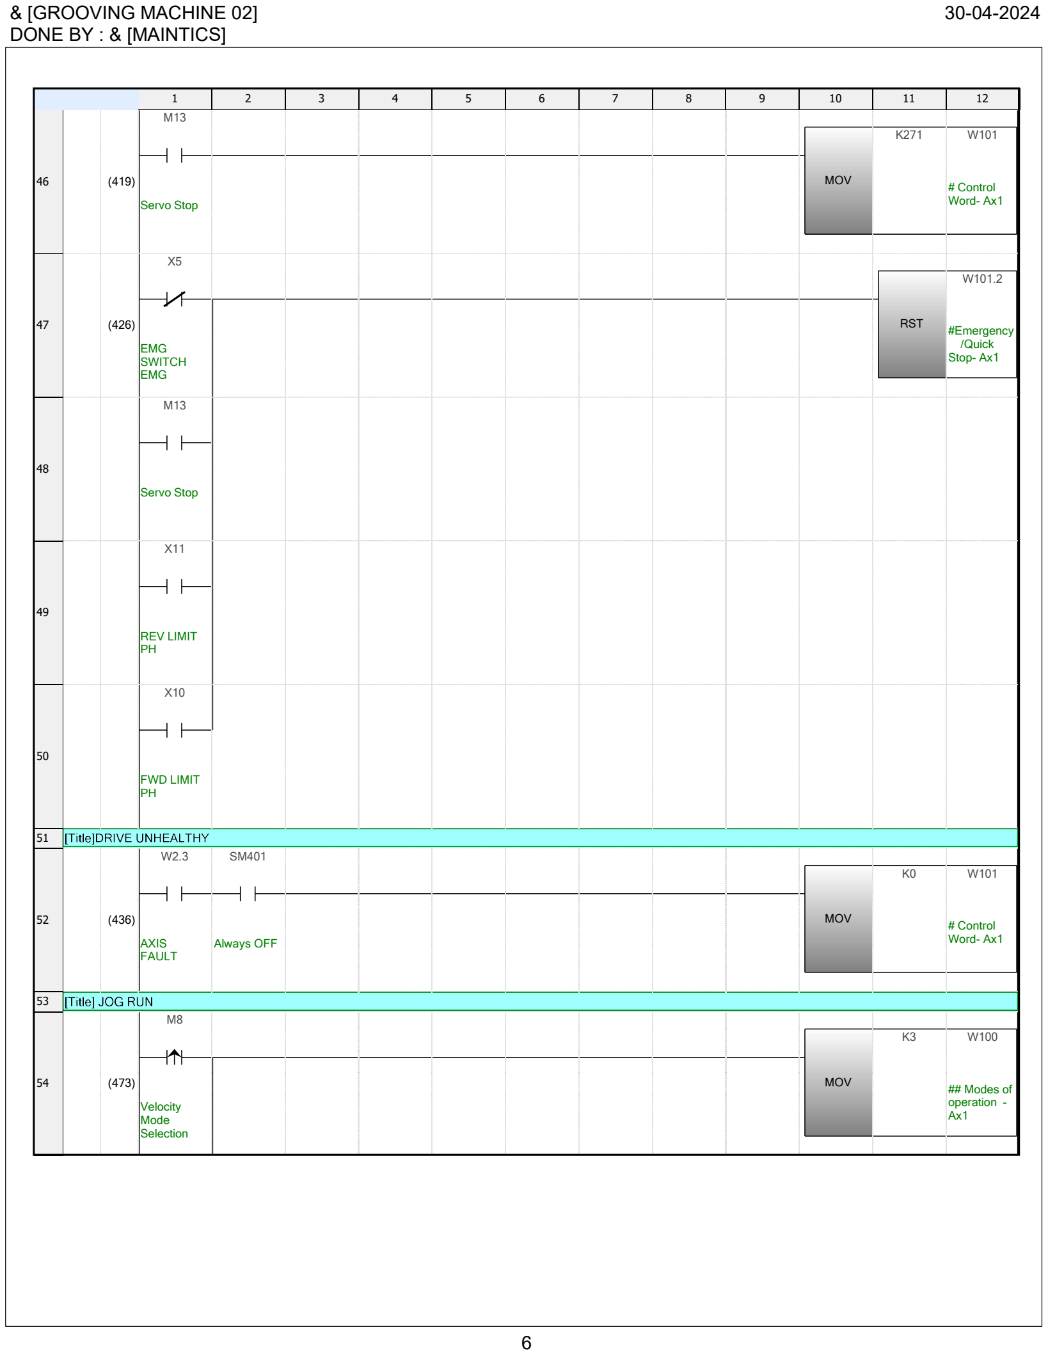
[picture p96: page 6]

6

1 | 2 | 3 | 4 | 5 | 6 | 7 | 8 | 9 | 10 | 11 | 12

46 (419)

M13

Servo Stop

MOV

K271 | W101

# Control

Word- Ax1

47 (426)

X5

EMG
SWITCH
EMG

RST

W101.2

#Emergency

/Quick
Stop- Ax1

48

M13

Servo Stop

49

X11

REV LIMIT
PH

50

X10

FWD LIMIT
PH

51

52 (436)

W2.3

AXIS
FAULT

SM401

Always OFF

MOV

K0 | W101

# Control

Word- Ax1

53

54 (473)

M8

Velocity
Mode
Selection

MOV

K3 | W100

## Modes of

operation -
Ax1

& [GROOVING MACHINE 02] | 30-04-2024

## DONE BY : & [MAINTICS]

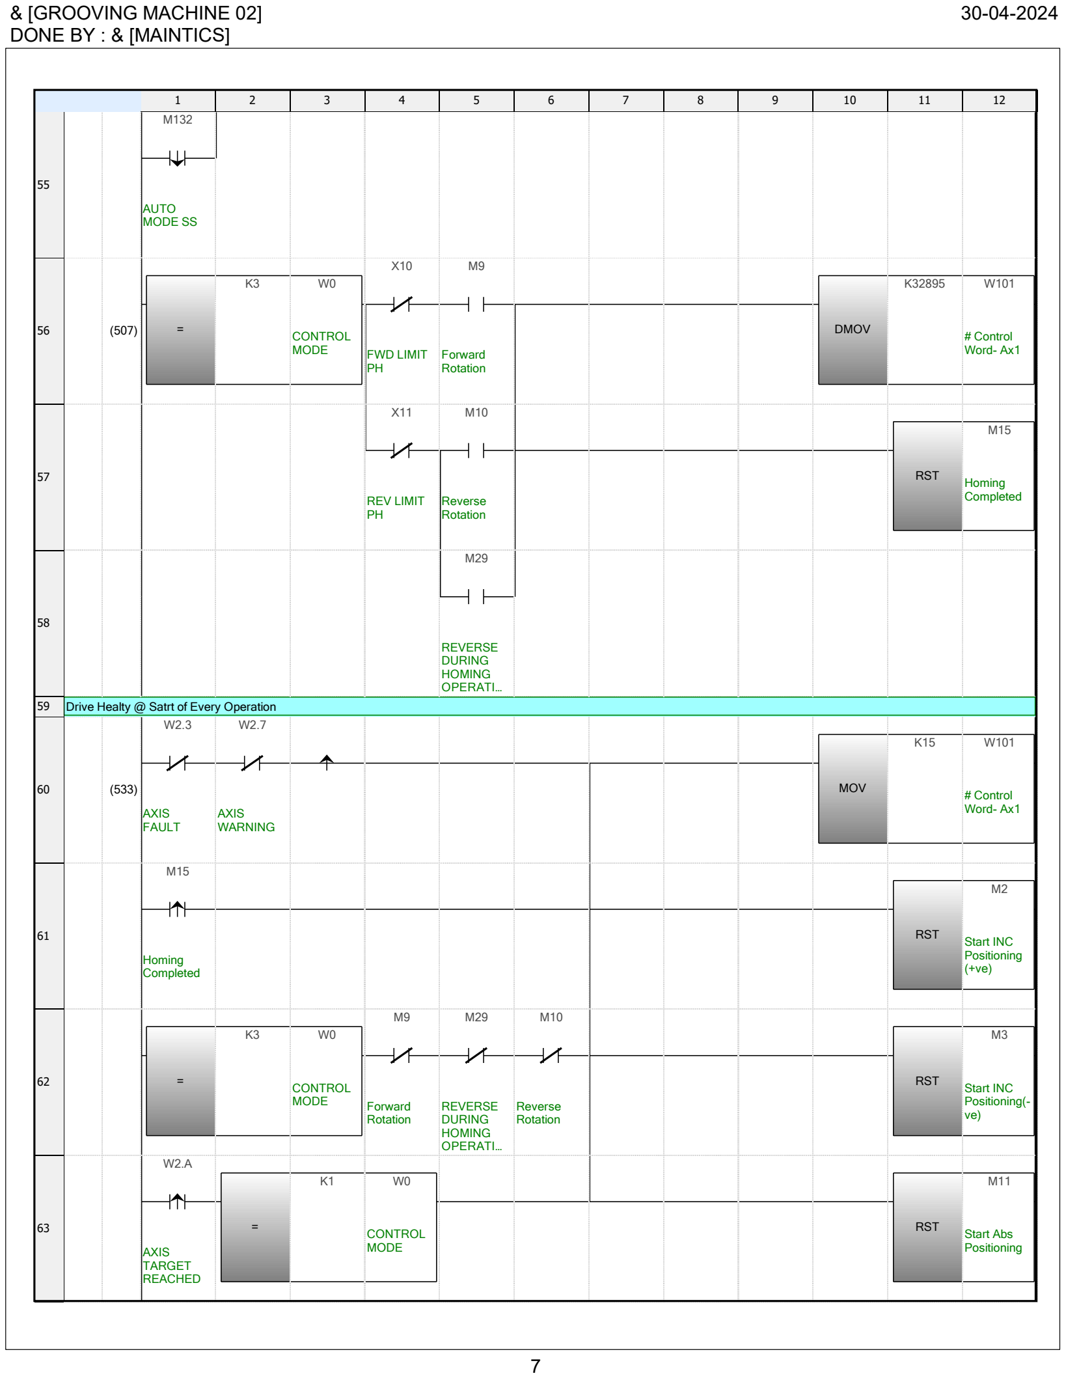
[picture p97: page 7]

7

1 | 2 | 3 | 4 | 5 | 6 | 7 | 8 | 9 | 10 | 11 | 12

55

M132

AUTO
MODE SS
56 | (507) | =
K3 | W0

CONTROL
MODE

X10

FWD LIMIT
PH

M9

Forward
Rotation

DMOV

K32895 W101

# Control

Word- Ax1

57

X11

REV LIMIT
PH

M10

Reverse
Rotation

RST

M15

Homing
Completed

58

M29

REVERSE
DURING
HOMING
OPERATI…

### 59 Drive Healty @ Satrt of Every Operation

60 (533)

W2.3

AXIS
FAULT

W2.7

AXIS
WARNING

MOV

K15 | W101

# Control

Word- Ax1

61

M15

Homing
Completed

RST

M2

Start INC
Positioning
(+ve)

62 =

K3 | W0

CONTROL
MODE

M9

Forward
Rotation

M29

REVERSE
DURING
HOMING
OPERATI…

M10

Reverse
Rotation

RST

M3

Start INC
Positioning(-
ve)

63

W2.A

AXIS
TARGET
REACHED

=

K1 | W0

CONTROL
MODE

RST

M11

Start Abs
Positioning

& [GROOVING MACHINE 02] | 30-04-2024

## DONE BY : & [MAINTICS]

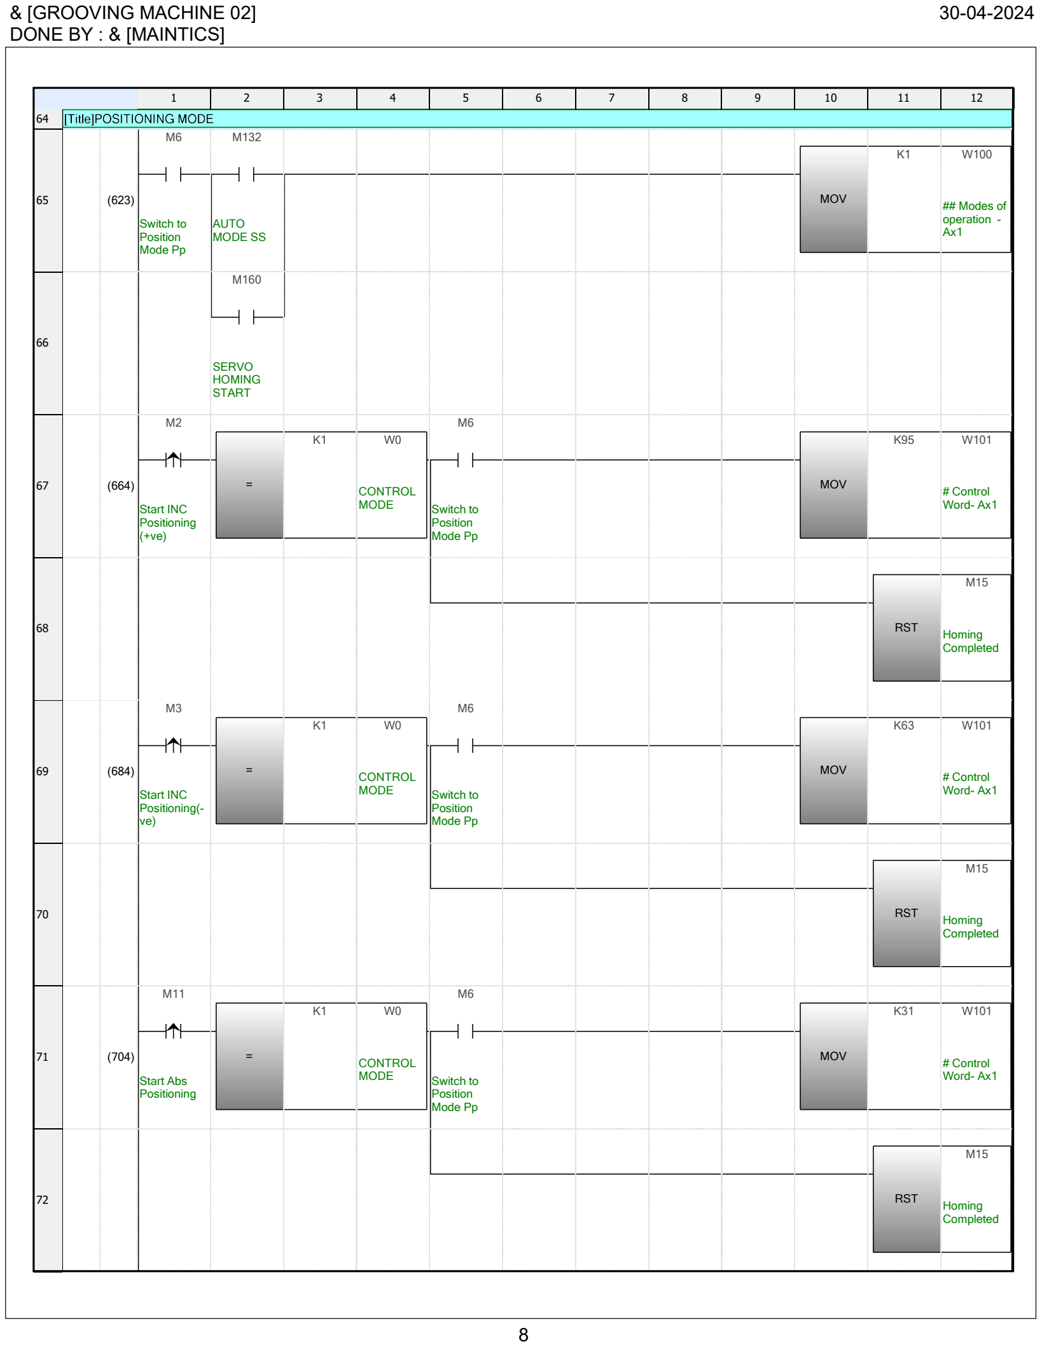
[picture p98: page 8]

8

1 | 2 | 3 | 4 | 5 | 6 | 7 | 8 | 9 | 10 | 11 | 12
64

65 (623)

M6

Switch to
Position
Mode Pp

M132

AUTO
MODE SS

MOV

K1 | W100

## Modes of

operation -
Ax1

66

M160

SERVO
HOMING
START

67 (664)

M2

Start INC
Positioning
(+ve)

=

K1 | W0

CONTROL
MODE

M6

| M6
| M6

Switch to
Position
Mode Pp

MOV

K95 | W101

# Control

Word- Ax1

### 68 RST

M15

Homing
Completed

69 (684)

M3

Start INC
Positioning(-
ve)

=

K1 | W0

CONTROL
MODE
Switch to
Position
Mode Pp

MOV

K63 | W101

# Control

Word- Ax1

### 70 RST

M15

Homing
Completed

71 (704)

M11

Start Abs
Positioning

=

K1 | W0

CONTROL
MODE
Switch to
Position
Mode Pp

MOV

K31 | W101

# Control

Word- Ax1

### 72 RST

M15

Homing
Completed

& [GROOVING MACHINE 02] | 30-04-2024

## DONE BY : & [MAINTICS]

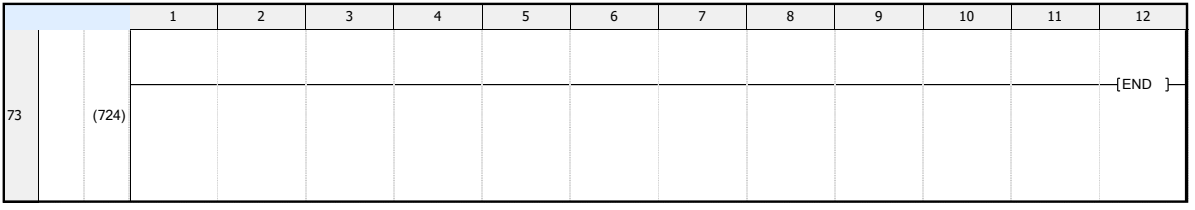
[picture p99: figure]
END

9

& [GROOVING MACHINE 02] | 30-04-2024

## DONE BY : & [MAINTICS]

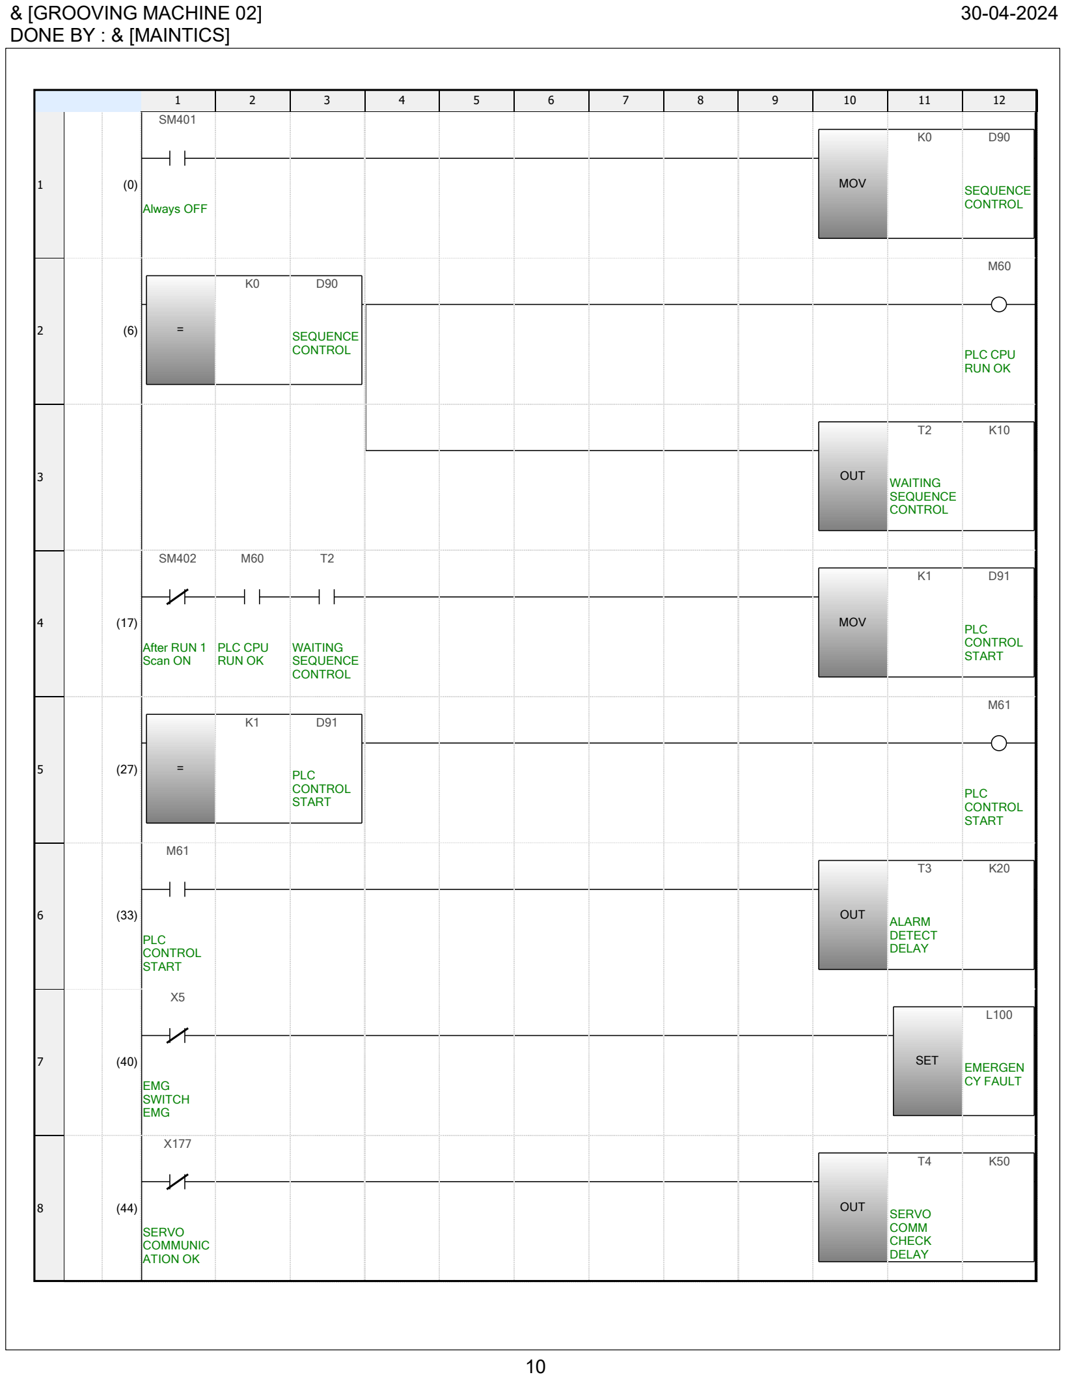
[picture p100: page 10]

10

1 | 2 | 3 | 4 | 5 | 6 | 7 | 8 | 9 | 10 | 11 | 12

1 (0)

SM401

Always OFF

MOV

K0 | D90

SEQUENCE
CONTROL
2 | (6) | =
K0 | D90

SEQUENCE
CONTROL

M60

PLC CPU
RUN OK

### 3 OUT

T2

WAITING
SEQUENCE
CONTROL

K10

4 (17)

SM402

After RUN 1
Scan ON

M60

PLC CPU
RUN OK

T2

WAITING
SEQUENCE
CONTROL

MOV

K1 | D91

PLC
CONTROL
START
5 | (27) | =
K1 | D91

PLC
CONTROL
START

M61

PLC
CONTROL
START

6 (33)

M61

PLC
CONTROL
START

OUT

T3

ALARM
DETECT
DELAY

K20

7 (40)

X5

EMG
SWITCH
EMG

SET

L100

EMERGEN
CY FAULT

8 (44)

X177

SERVO
COMMUNIC
ATION OK

OUT

T4

SERVO
COMM
CHECK
DELAY

K50

& [GROOVING MACHINE 02] | 30-04-2024

## DONE BY : & [MAINTICS]

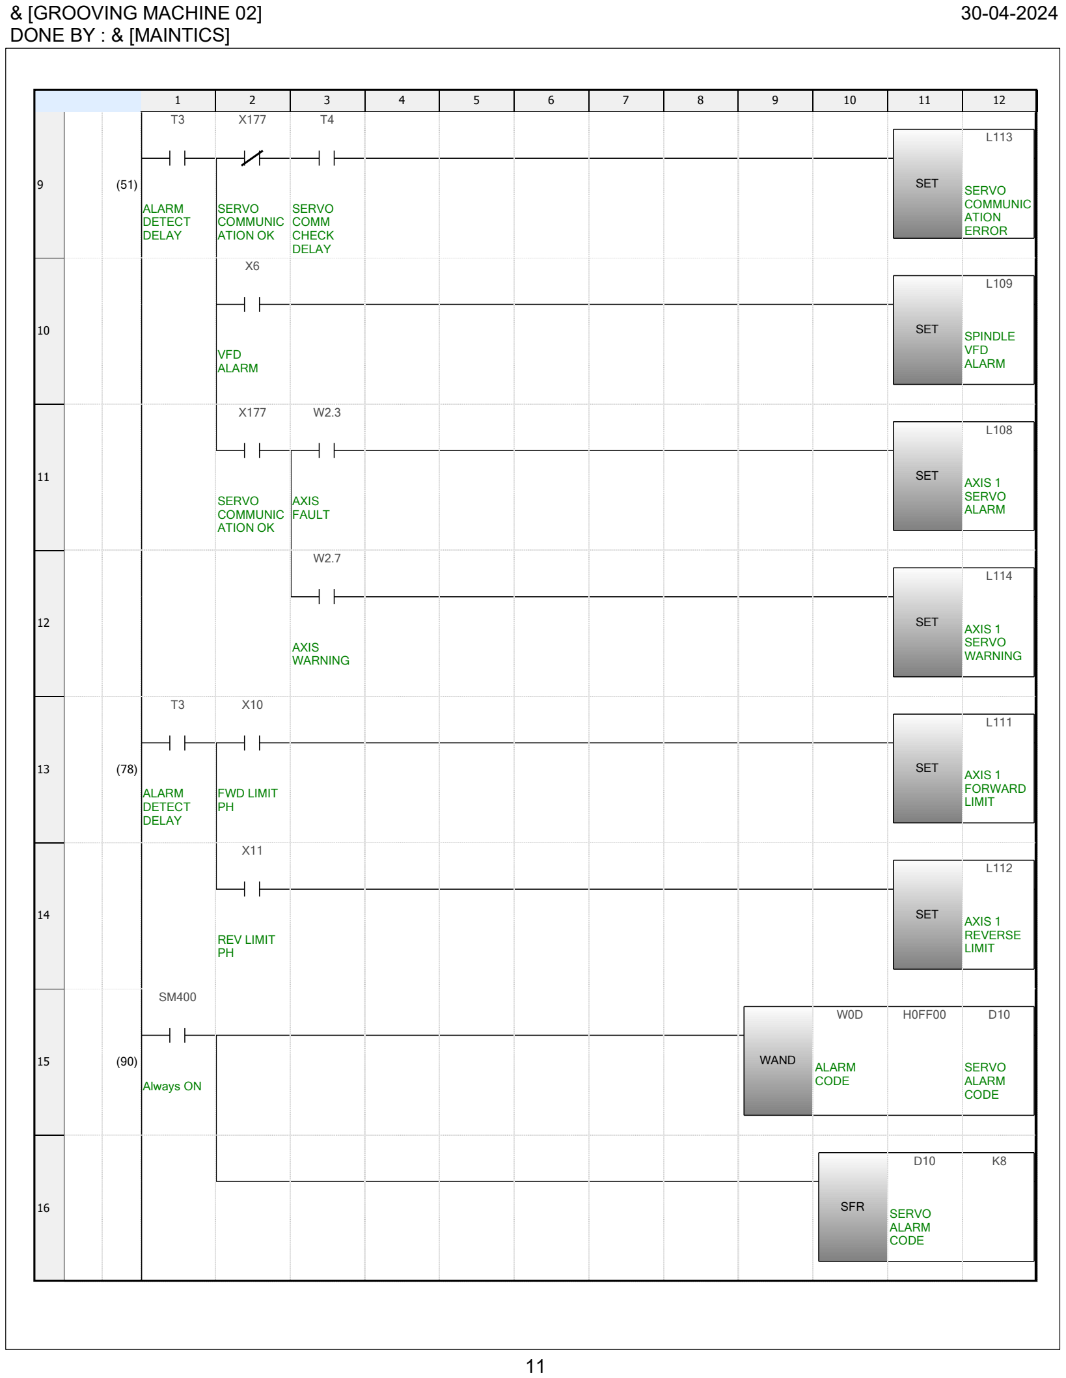
[picture p101: page 11]

11

1 | 2 | 3 | 4 | 5 | 6 | 7 | 8 | 9 | 10 | 11 | 12

9 (51)

T3

ALARM
DETECT
DELAY

X177

SERVO
COMMUNIC
ATION OK

T4

SERVO
COMM
CHECK
DELAY

SET

L113

SERVO
COMMUNIC
ATION
ERROR

10

X6

VFD
ALARM

SET

L109

SPINDLE
VFD
ALARM

11

X177

SERVO
COMMUNIC
ATION OK

W2.3

AXIS
FAULT

SET

L108

AXIS 1
SERVO
ALARM

12

W2.7

AXIS
WARNING

SET

L114

AXIS 1
SERVO
WARNING

13 (78)

T3

ALARM
DETECT
DELAY

X10

FWD LIMIT
PH

SET

L111

AXIS 1
FORWARD
LIMIT

14

X11

REV LIMIT
PH

SET

L112

AXIS 1
REVERSE
LIMIT

15 (90)

SM400

Always ON

WAND

W0D

ALARM
CODE
H0FF00 | D10

SERVO
ALARM
CODE

### 16 SFR

D10

SERVO
ALARM
CODE

K8

& [GROOVING MACHINE 02] | 30-04-2024

## DONE BY : & [MAINTICS]

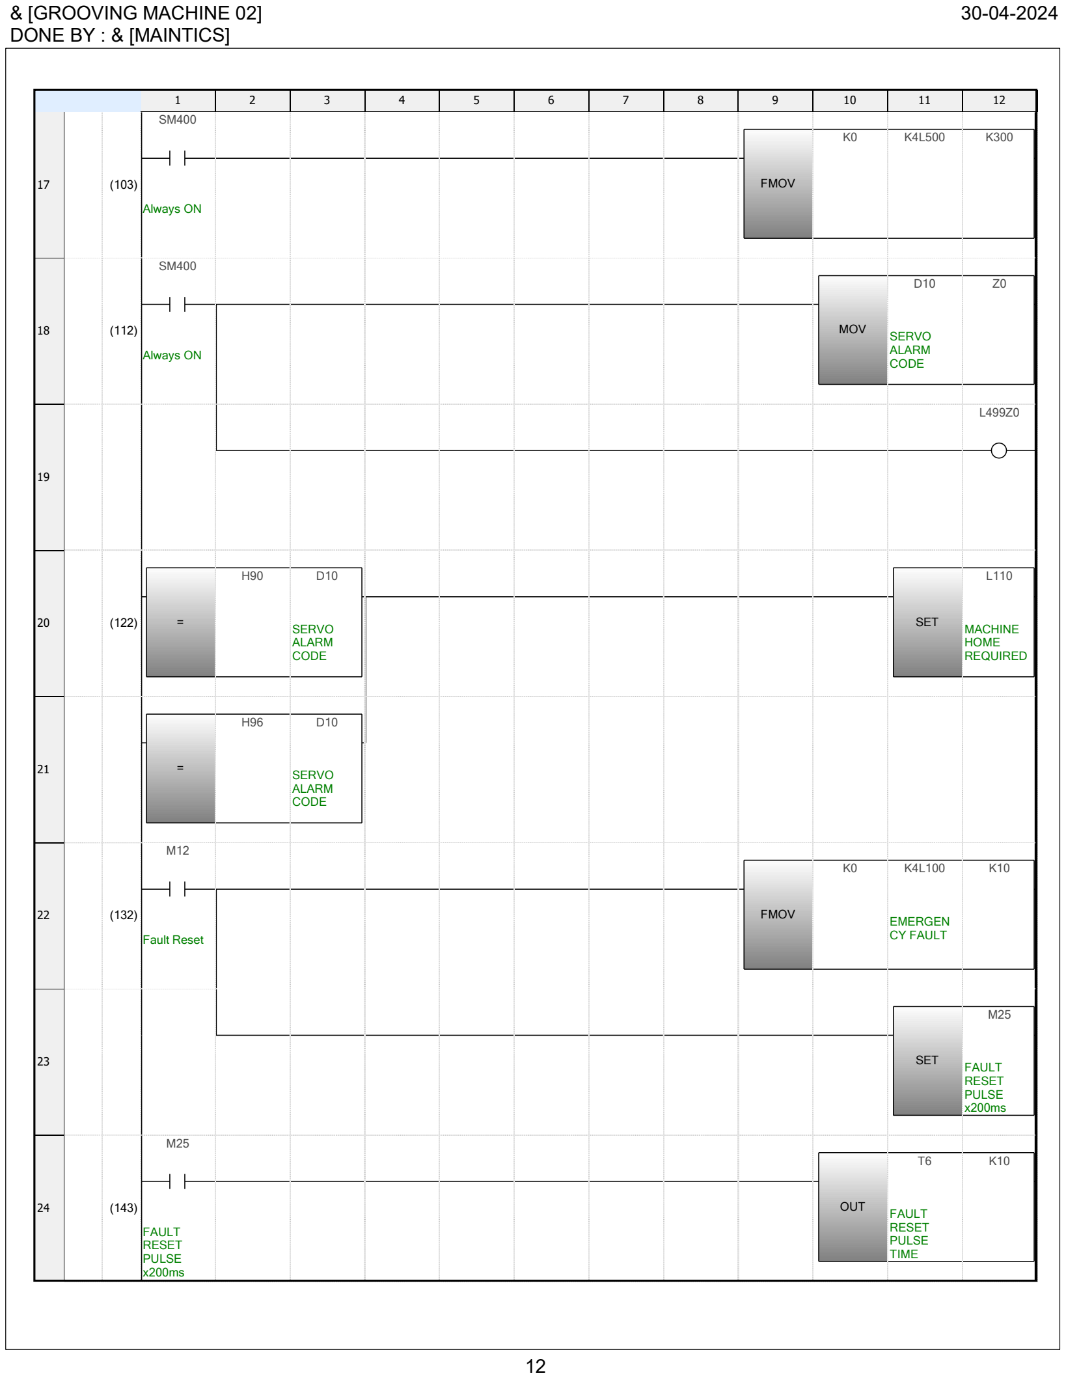
[picture p102: page 12]

12

1 | 2 | 3 | 4 | 5 | 6 | 7 | 8 | 9 | 10 | 11 | 12

17 (103)

SM400

Always ON

FMOV

K0 | K4L500 | K300

18 (112)

SM400

Always ON

MOV

D10

SERVO
ALARM
CODE

Z0

19

L499Z0

20 | (122) | =
H90 | D10

SERVO
ALARM
CODE

SET

L110

MACHINE
HOME
REQUIRED

21 =

H96 | D10

SERVO
ALARM
CODE

22 (132)

M12

Fault Reset

FMOV

K0 | K4L100

EMERGEN
CY FAULT

K10

### 23 SET

M25

FAULT
RESET
PULSE
x200ms

24 (143)

M25

FAULT
RESET
PULSE
x200ms

OUT

T6

FAULT
RESET
PULSE
TIME

K10

& [GROOVING MACHINE 02] | 30-04-2024

## DONE BY : & [MAINTICS]

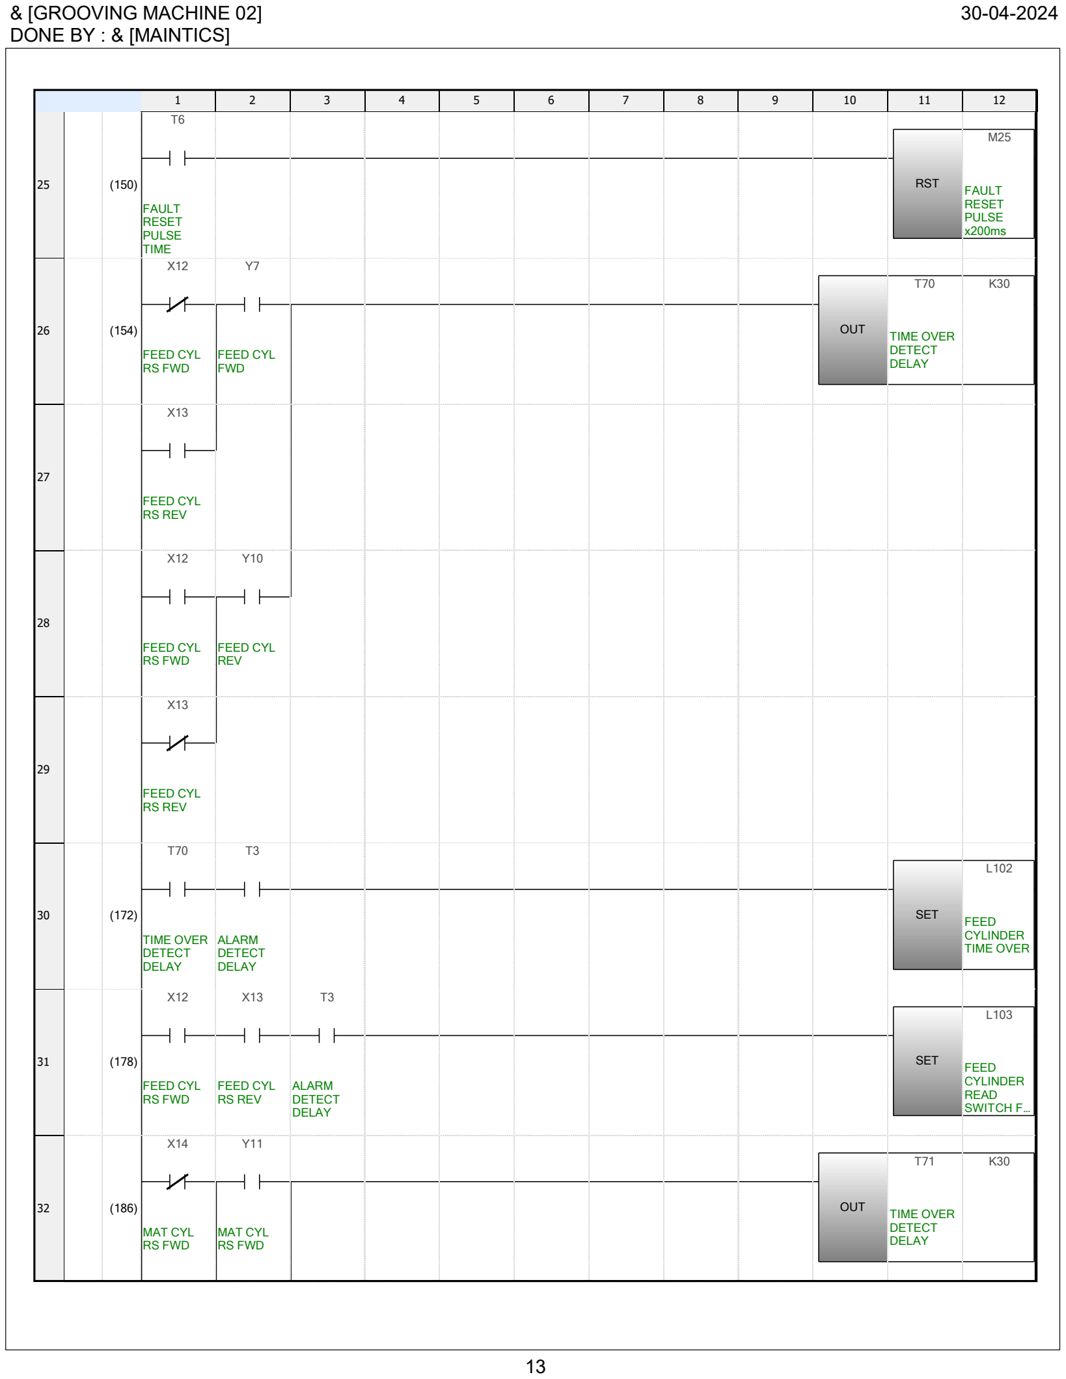
[picture p103: page 13]

13

1 | 2 | 3 | 4 | 5 | 6 | 7 | 8 | 9 | 10 | 11 | 12

25 (150)

T6

FAULT
RESET
PULSE
TIME

RST

M25

FAULT
RESET
PULSE
x200ms

26 (154)

X12

FEED CYL
RS FWD

Y7

FEED CYL
FWD

OUT

T70

TIME OVER
DETECT
DELAY

K30

27

X13

FEED CYL
RS REV

28

X12

FEED CYL
RS FWD

Y10

FEED CYL
REV

29

X13

FEED CYL
RS REV

30 (172)

T70

TIME OVER
DETECT
DELAY

T3

ALARM
DETECT
DELAY

SET

L102

FEED
CYLINDER
TIME OVER

31 (178)

X12

FEED CYL
RS FWD

X13

FEED CYL
RS REV

T3

ALARM
DETECT
DELAY

SET

L103

FEED
CYLINDER
READ
SWITCH F…

32 (186)

X14

MAT CYL
RS FWD

Y11

MAT CYL
RS FWD

OUT

T71

TIME OVER
DETECT
DELAY

K30

& [GROOVING MACHINE 02] | 30-04-2024

## DONE BY : & [MAINTICS]

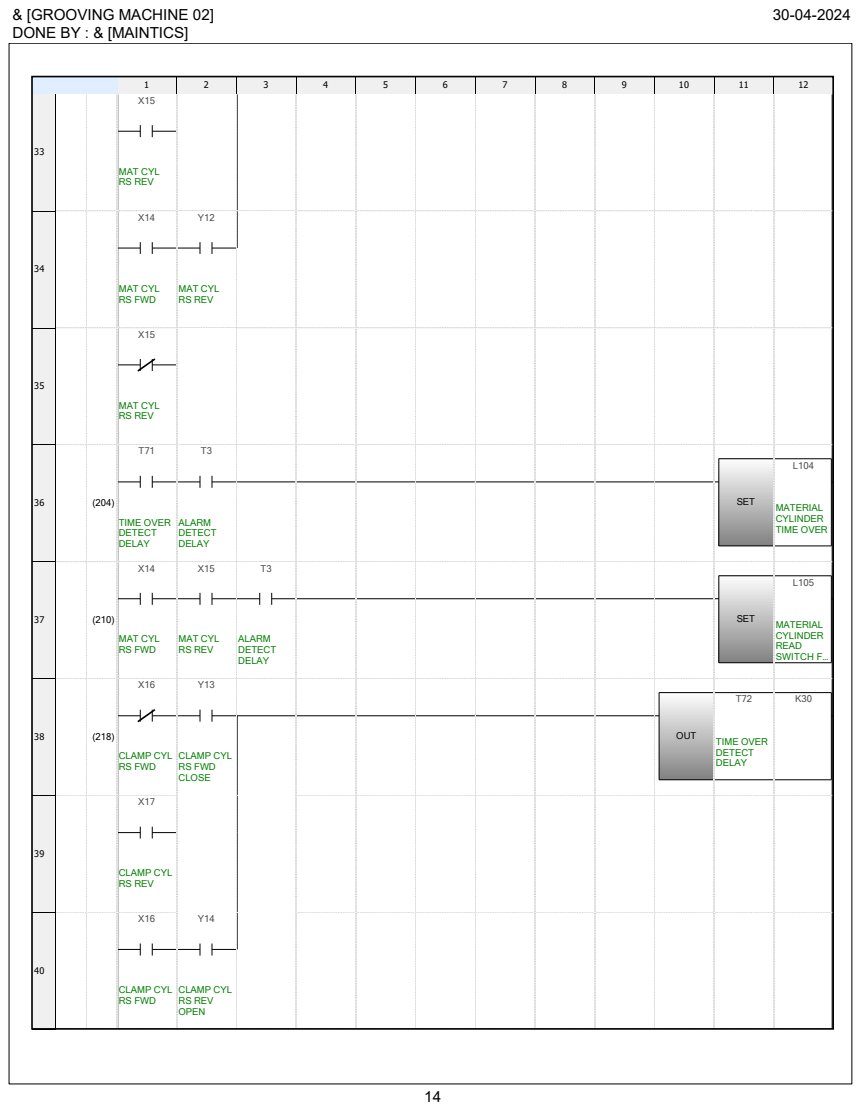
[picture p104: page 14]
MAT CYL RS REV; MAT CYL RS FWD; TIME OVER DETECT DELAY; ALARM DETECT DELAY; SET; MATERIAL CYLINDER TIME OVER; MATERIAL CYLINDER READ SWITCH F…; CLAMP CYL RS FWD; CLAMP CYL RS FWD CLOSE; OUT; CLAMP CYL RS REV; CLAMP CYL RS REV OPEN

& [GROOVING MACHINE 02] | 30-04-2024

## DONE BY : & [MAINTICS]

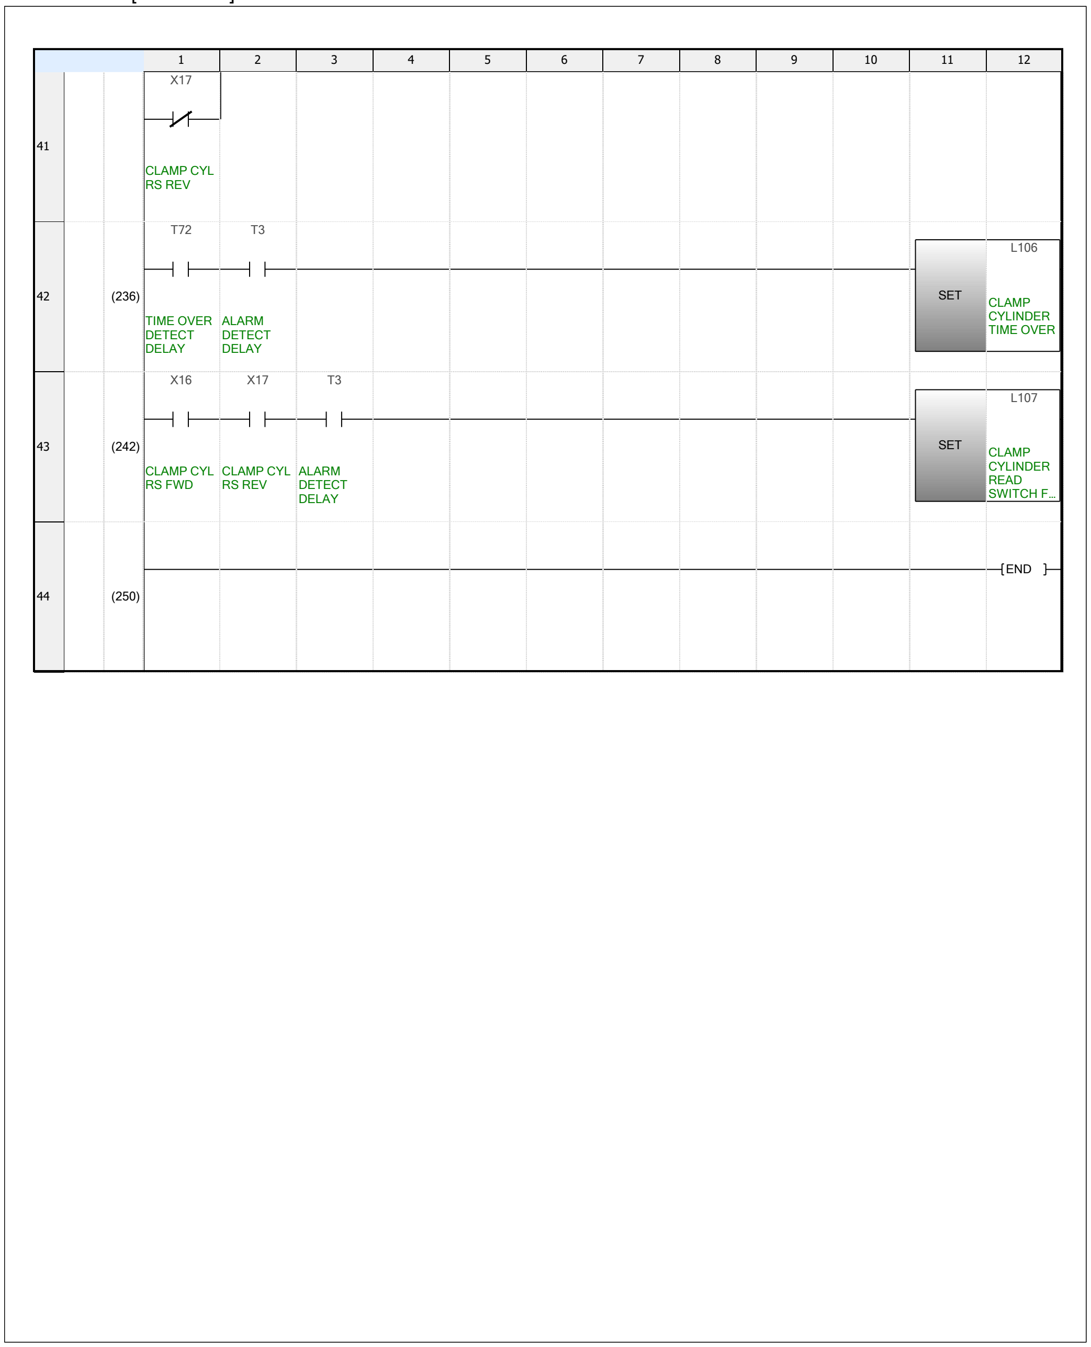
[picture p105: figure]
CLAMP CYL RS REV; TIME OVER DETECT DELAY; ALARM DETECT DELAY; SET; CLAMP CYLINDER TIME OVER; CLAMP CYL RS FWD; CLAMP CYLINDER READ SWITCH F…; END

15

& [GROOVING MACHINE 02] | 30-04-2024

## DONE BY : & [MAINTICS]

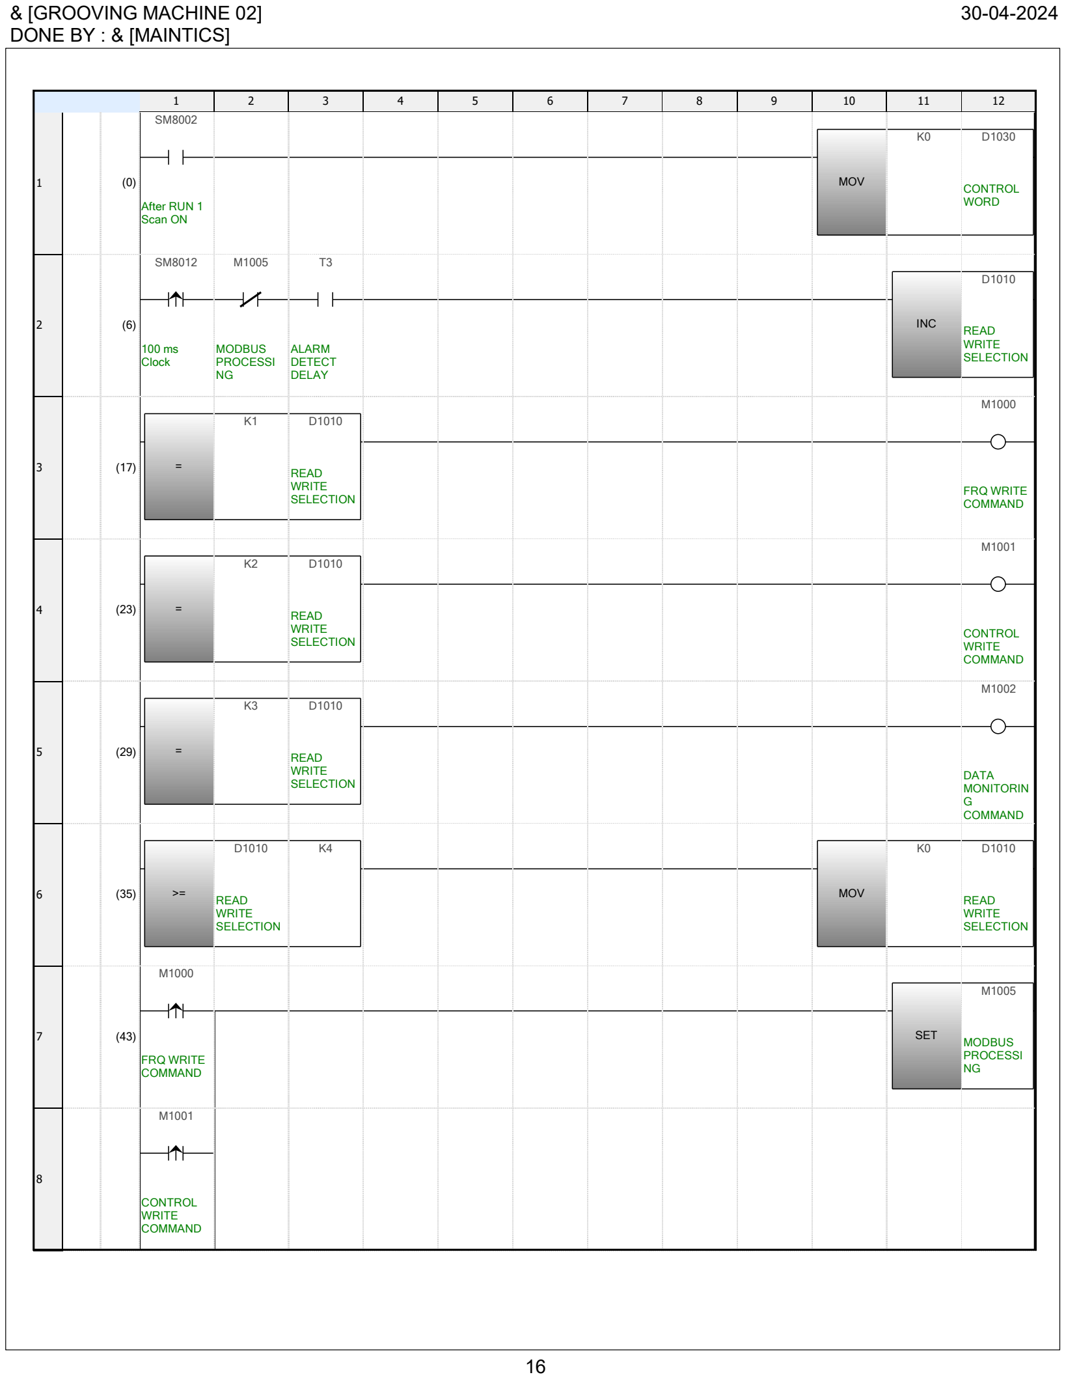
[picture p106: page 16]

16

1 | 2 | 3 | 4 | 5 | 6 | 7 | 8 | 9 | 10 | 11 | 12

1 (0)

SM8002

After RUN 1
Scan ON

MOV

K0 | D1030

CONTROL
WORD

2 (6)

SM8012

100 ms
Clock

M1005

MODBUS
PROCESSI
NG

T3

ALARM
DETECT
DELAY

INC

D1010

READ
WRITE
SELECTION
3 | (17) | =
K1 | D1010

READ
WRITE
SELECTION

M1000

FRQ WRITE
COMMAND
4 | (23) | =
K2 | D1010

READ
WRITE
SELECTION

M1001

CONTROL
WRITE
COMMAND
5 | (29) | =
K3 | D1010

READ
WRITE
SELECTION

M1002

DATA
MONITORIN
G
COMMAND
6 | (35) | >=

D1010

READ
WRITE
SELECTION

K4

MOV

K0 | D1010

READ
WRITE
SELECTION

7 (43)

M1000

FRQ WRITE
COMMAND

SET

M1005

MODBUS
PROCESSI
NG

8

M1001

CONTROL
WRITE
COMMAND

& [GROOVING MACHINE 02] | 30-04-2024

## DONE BY : & [MAINTICS]

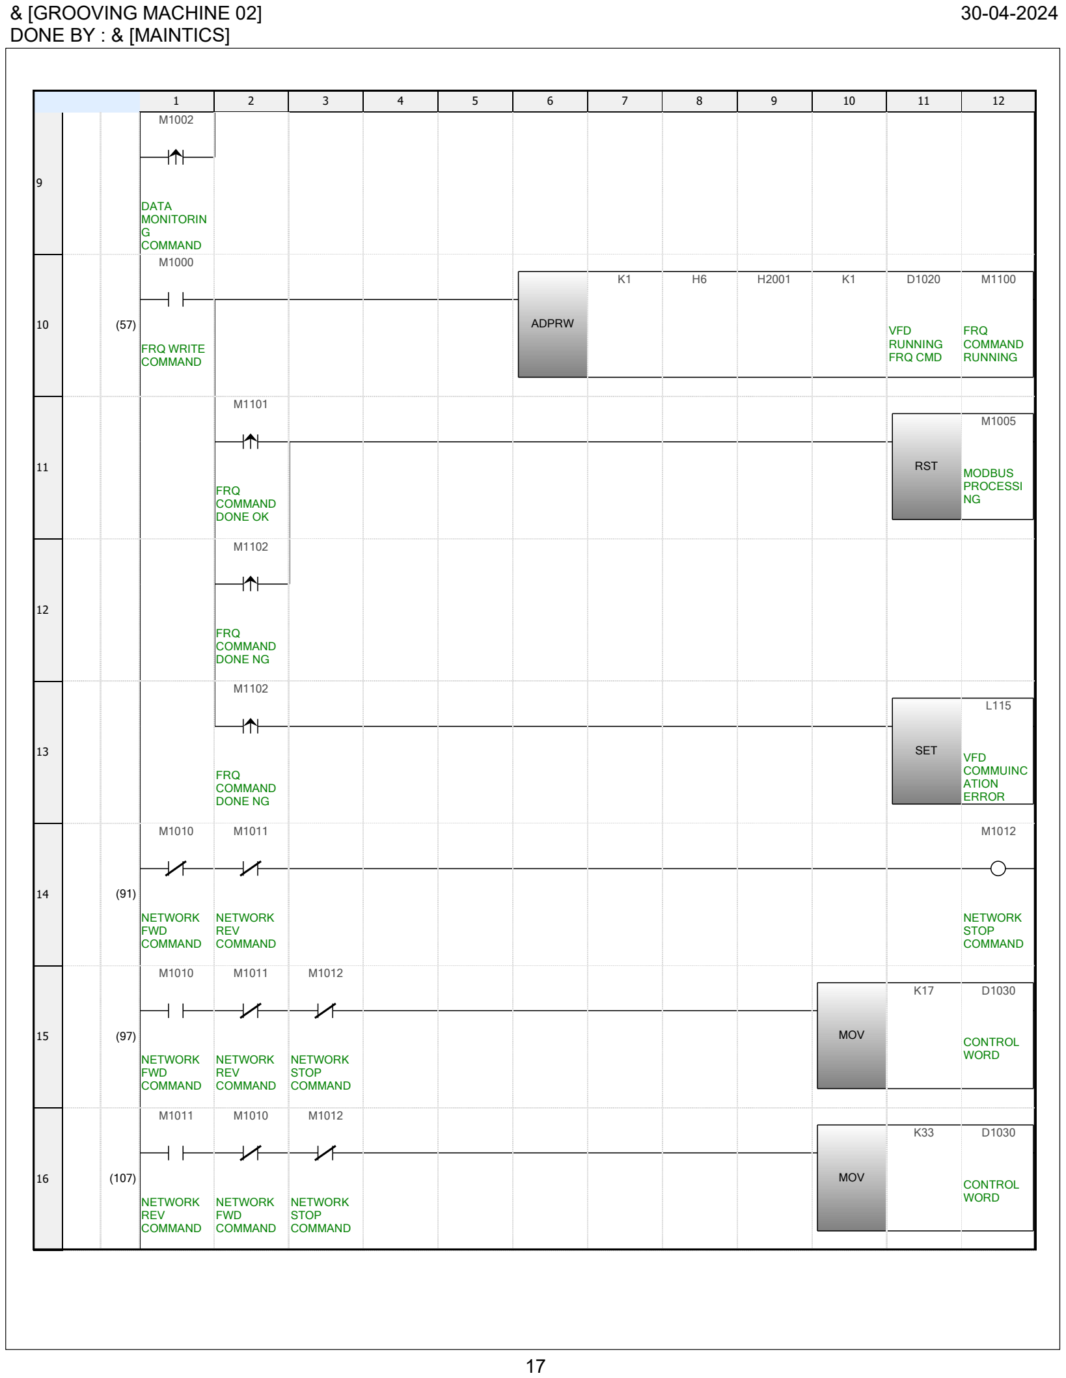
[picture p107: page 17]

17

1 | 2 | 3 | 4 | 5 | 6 | 7 | 8 | 9 | 10 | 11 | 12

9

M1002

DATA
MONITORIN
G
COMMAND

10 (57)

M1000

FRQ WRITE
COMMAND

ADPRW

K1 | H6 | H2001 | K1 | D1020

VFD
RUNNING
FRQ CMD

M1100

FRQ
COMMAND
RUNNING

11

M1101

FRQ
COMMAND
DONE OK

RST

M1005

MODBUS
PROCESSI
NG

12

M1102

FRQ
COMMAND
DONE NG

13

M1102

FRQ
COMMAND
DONE NG

SET

L115

VFD
COMMUINC
ATION
ERROR

14 (91)

M1010

NETWORK
FWD
COMMAND

M1011

NETWORK
REV
COMMAND

M1012

NETWORK
STOP
COMMAND

15 (97)

M1010

NETWORK
FWD
COMMAND

M1011

NETWORK
REV
COMMAND

M1012

NETWORK
STOP
COMMAND

MOV

K17 | D1030

CONTROL
WORD

16 (107)

M1011

NETWORK
REV
COMMAND

M1010

NETWORK
FWD
COMMAND

M1012

NETWORK
STOP
COMMAND

MOV

K33 | D1030

CONTROL
WORD

& [GROOVING MACHINE 02] | 30-04-2024

## DONE BY : & [MAINTICS]

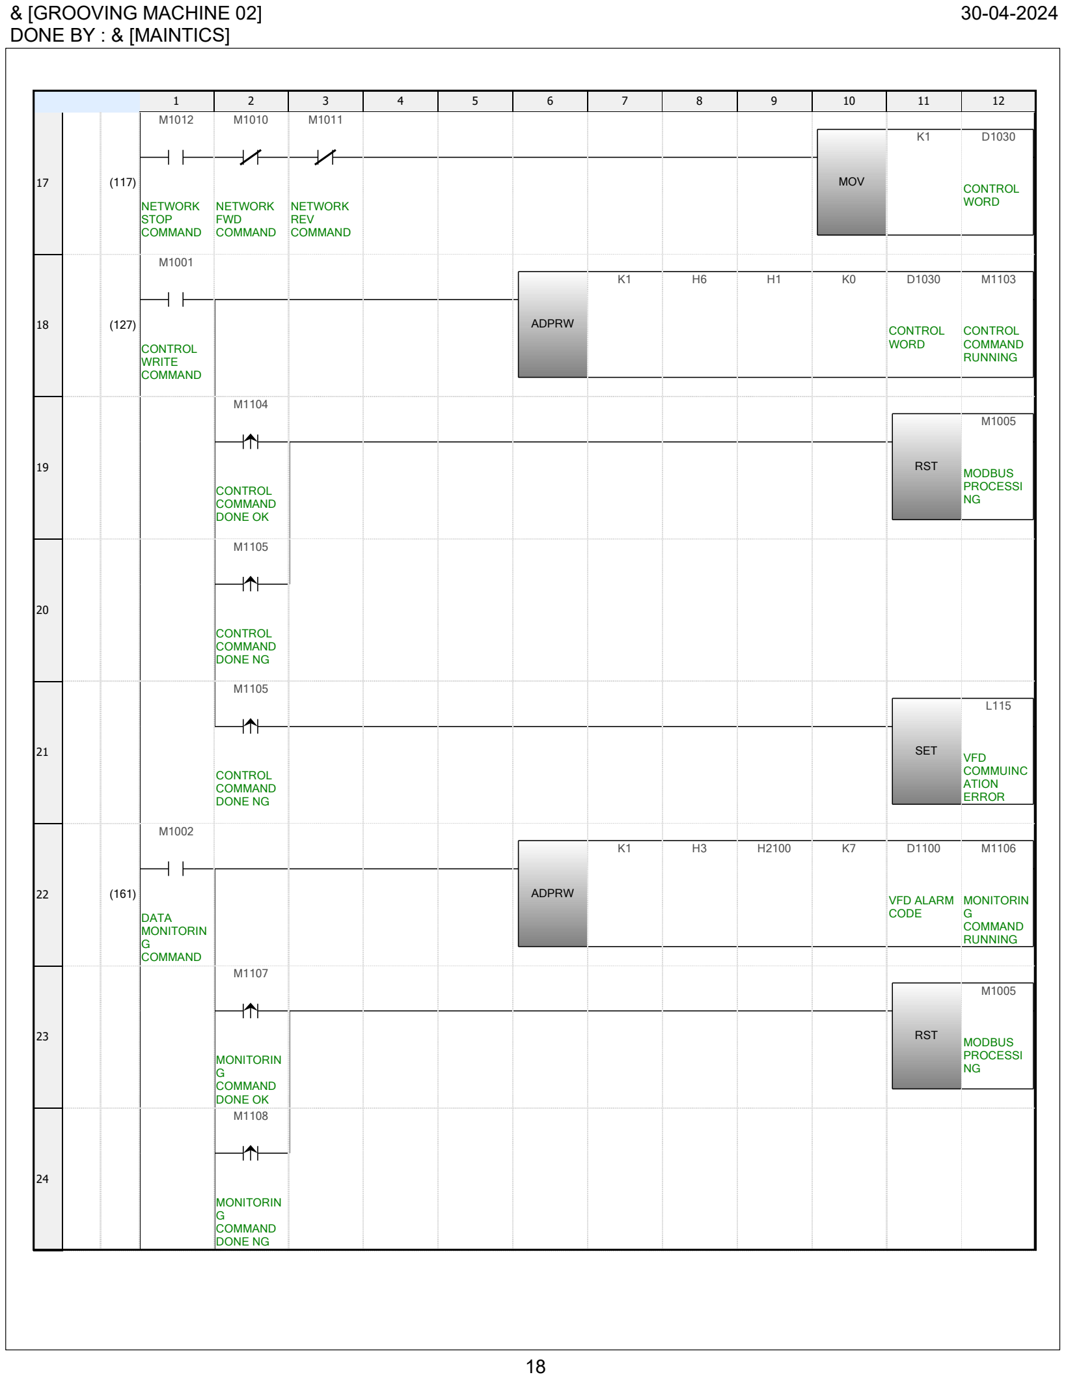
[picture p108: page 18]

18

1 | 2 | 3 | 4 | 5 | 6 | 7 | 8 | 9 | 10 | 11 | 12

17 (117)

M1012

NETWORK
STOP
COMMAND

M1010

NETWORK
FWD
COMMAND

M1011

NETWORK
REV
COMMAND

MOV

K1 | D1030

CONTROL
WORD

18 (127)

M1001

CONTROL
WRITE
COMMAND

ADPRW

K1 | H6 | H1 | K0 | D1030

CONTROL
WORD

M1103

CONTROL
COMMAND
RUNNING

19

M1104

CONTROL
COMMAND
DONE OK

RST

M1005

MODBUS
PROCESSI
NG

20

M1105

CONTROL
COMMAND
DONE NG

21

M1105

CONTROL
COMMAND
DONE NG

SET

L115

VFD
COMMUINC
ATION
ERROR

22 (161)

M1002

DATA
MONITORIN
G
COMMAND

ADPRW

K1 | H3 | H2100 | K7 | D1100

VFD ALARM
CODE

M1106

MONITORIN
G
COMMAND
RUNNING

23

M1107

MONITORIN
G
COMMAND
DONE OK

RST

M1005

MODBUS
PROCESSI
NG

24

M1108

MONITORIN
G
COMMAND
DONE NG

& [GROOVING MACHINE 02] | 30-04-2024

## DONE BY : & [MAINTICS]

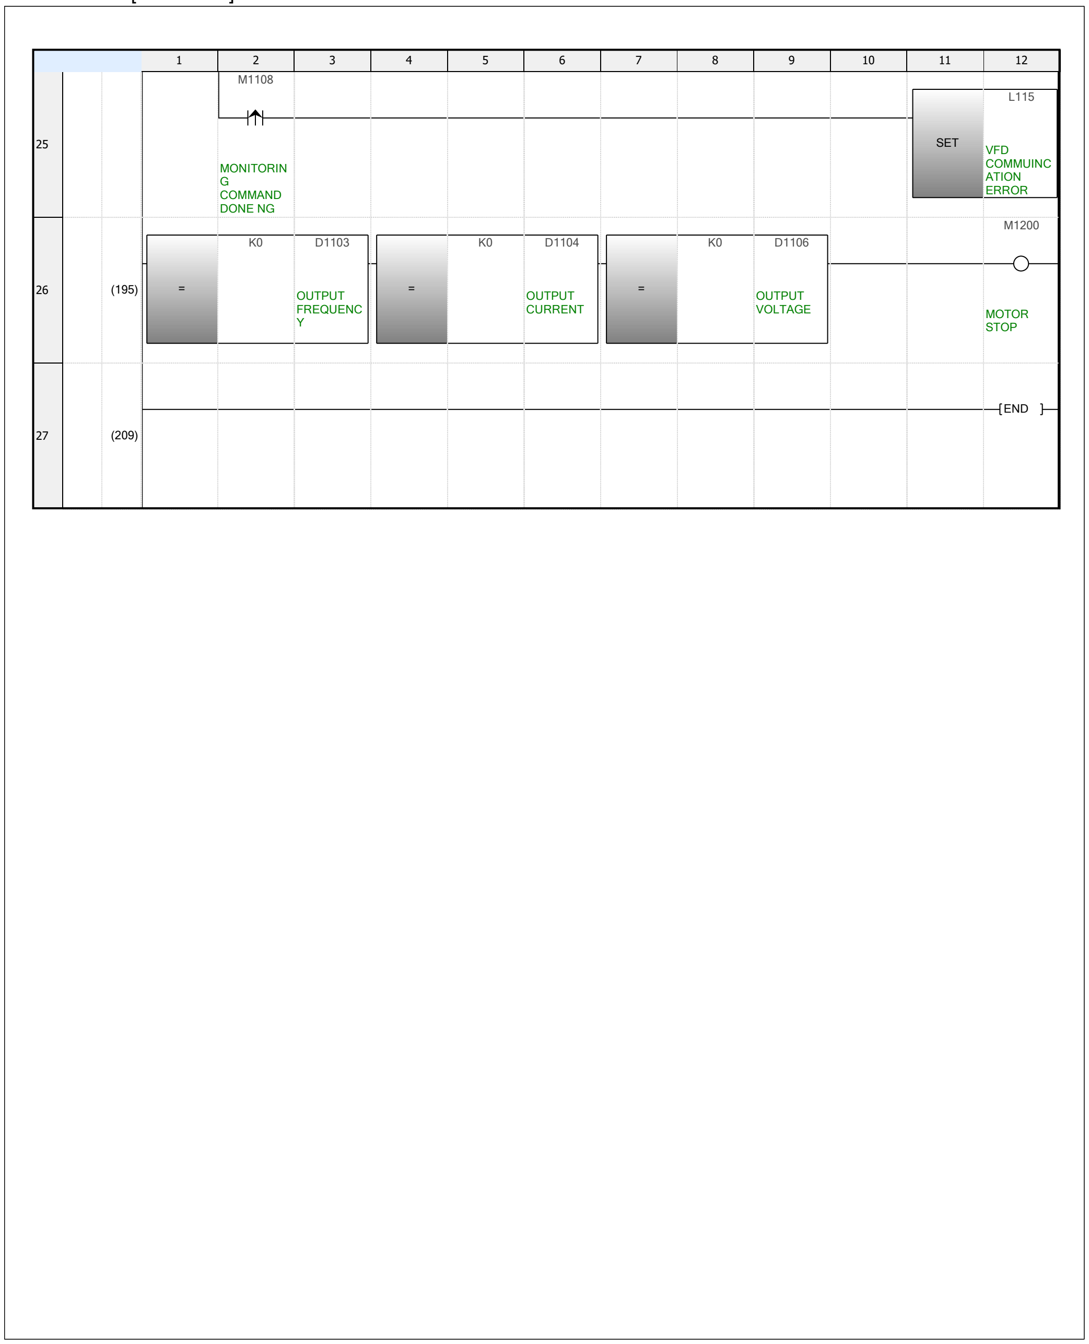
[picture p109: figure]
MONITORIN G COMMAND DONE NG; SET; VFD COMMUINC ATION ERROR; OUTPUT FREQUENC Y; OUTPUT CURRENT; OUTPUT VOLTAGE; MOTOR STOP; END

19

& [GROOVING MACHINE 02] | 30-04-2024

## DONE BY : & [MAINTICS]

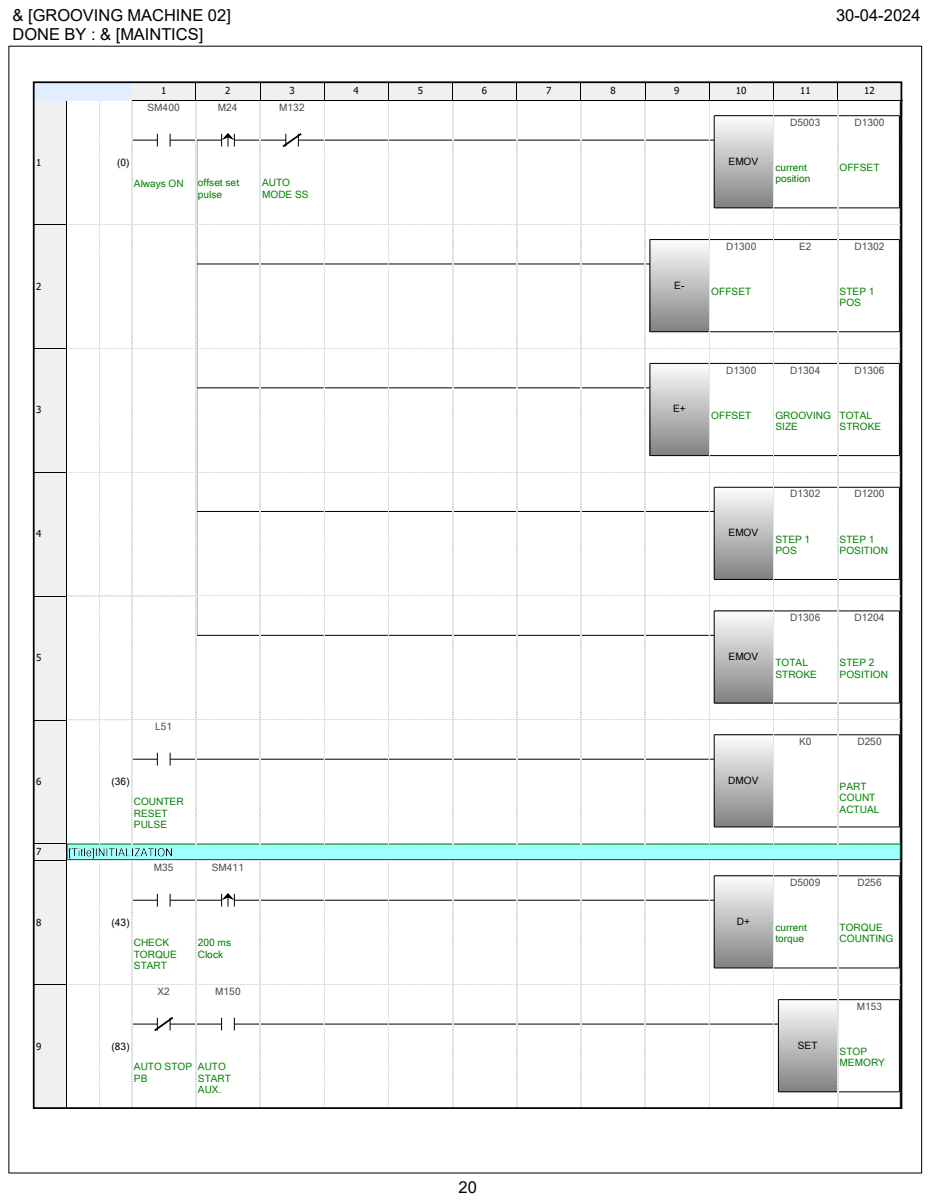
[picture p110: page 20]

& [GROOVING MACHINE 02] | 30-04-2024

## DONE BY : & [MAINTICS]

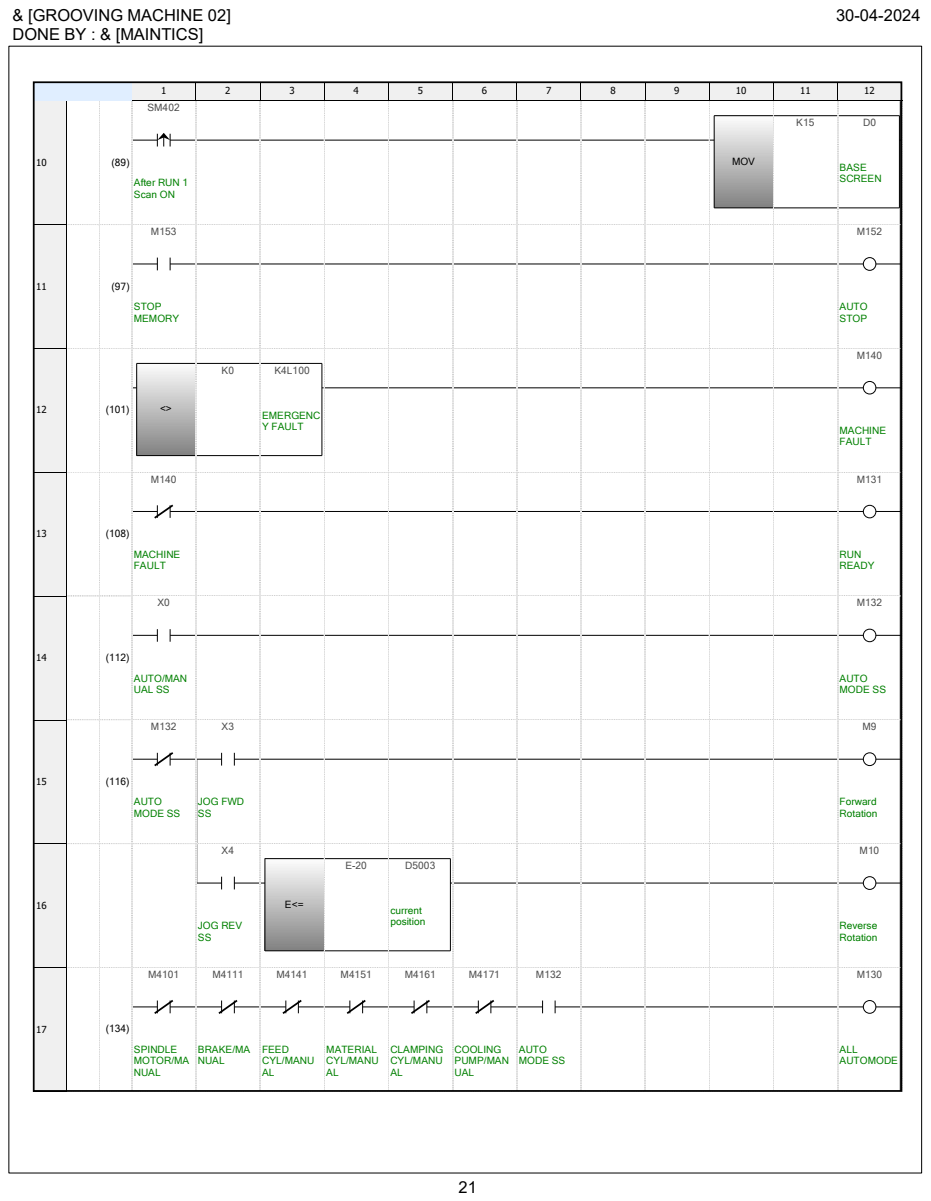
[picture p111: page 21]
After RUN 1 Scan ON; MOV; BASE SCREEN; STOP MEMORY; AUTO STOP; EMERGENC Y FAULT; MACHINE FAULT; RUN READY; AUTO/MAN UAL SS; AUTO MODE SS; JOG FWD SS; Forward Rotation; JOG REV SS; current position; Reverse Rotation; SPINDLE MOTOR/MA NUAL; BRAKE/MA NUAL; FEED CYL/MANU AL; MATERIAL CYL/MANU AL; CLAMPING CYL/MANU AL; COOLING PUMP/MAN UAL; ALL AUTOMODE

& [GROOVING MACHINE 02] | 30-04-2024

## DONE BY : & [MAINTICS]

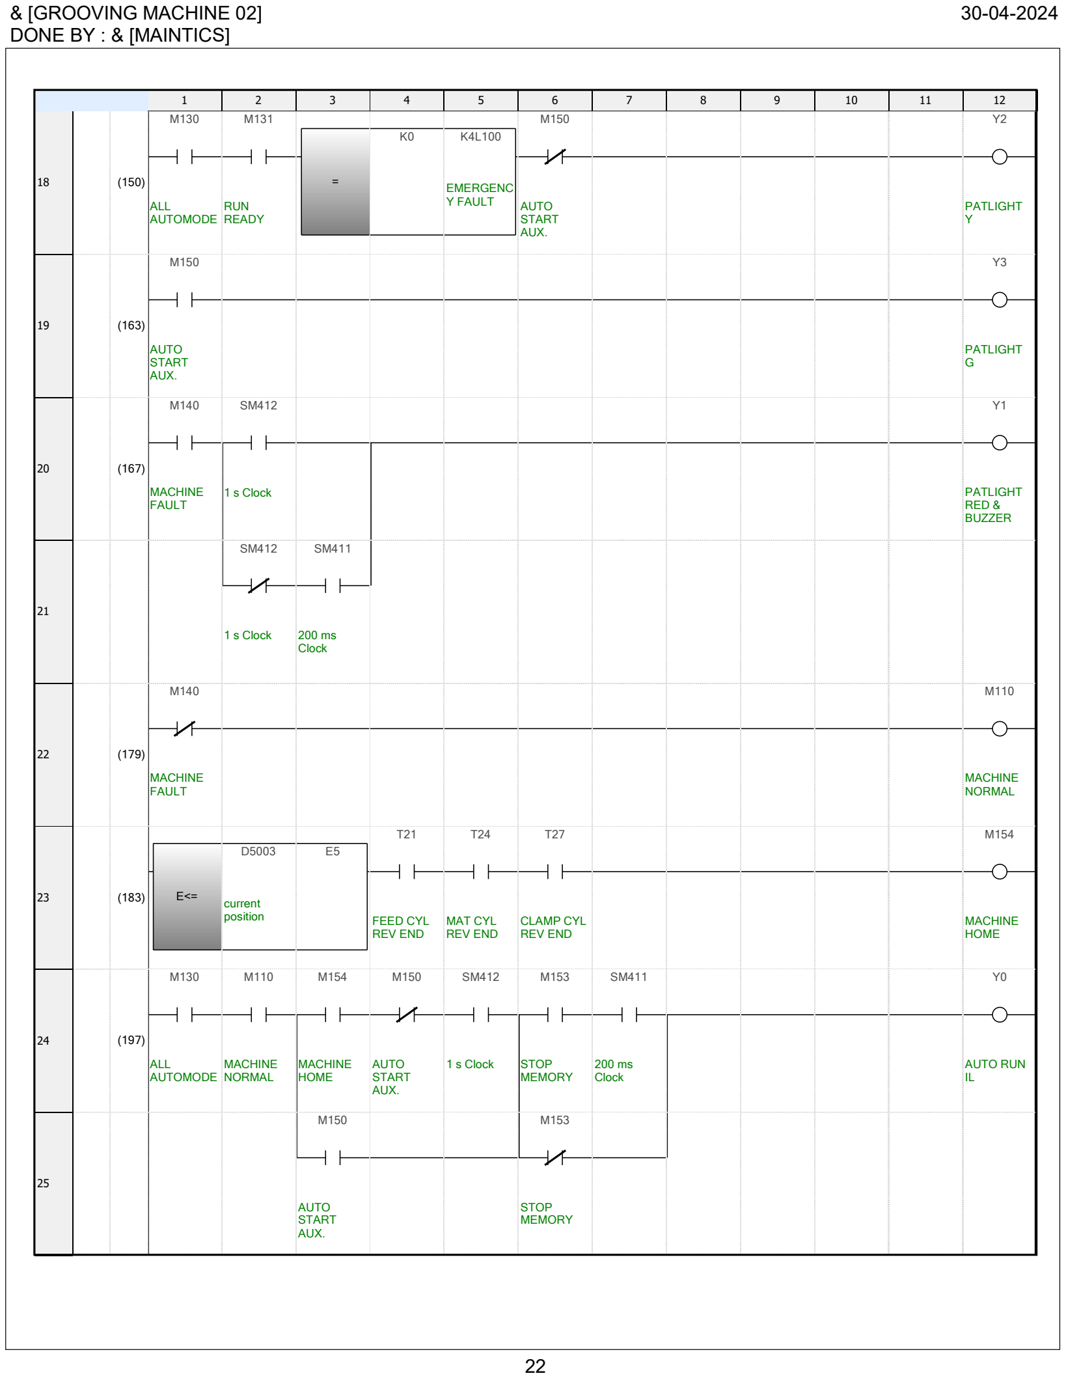
[picture p112: page 22]

22

1 | 2 | 3 | 4 | 5 | 6 | 7 | 8 | 9 | 10 | 11 | 12

18 (150)

M130

ALL
AUTOMODE

M131

RUN
READY

=

K0 | K4L100

EMERGENC
Y FAULT

M150

AUTO
START
AUX.

Y2

PATLIGHT
Y

19 (163)

M150

AUTO
START
AUX.

Y3

PATLIGHT
G

20 (167)

M140

MACHINE
FAULT

SM412

### 1 s Clock

Y1

PATLIGHT
RED &
BUZZER

21

SM412

### 1 s Clock

SM411

200 ms
Clock

22 (179)

M140

MACHINE
FAULT

M110

MACHINE
NORMAL
23 | (183) | E<=

D5003

current
position

E5

T21

FEED CYL
REV END

T24

MAT CYL
REV END

T27

CLAMP CYL
REV END

M154

MACHINE
HOME

24 (197)

M130

ALL
AUTOMODE

M110

MACHINE
NORMAL

M154

MACHINE
HOME

M150

AUTO
START
AUX.

SM412

### 1 s Clock

M153

STOP
MEMORY

SM411

200 ms
Clock

Y0

AUTO RUN
IL

25

M150

AUTO
START
AUX.

M153

STOP
MEMORY

& [GROOVING MACHINE 02] | 30-04-2024

## DONE BY : & [MAINTICS]

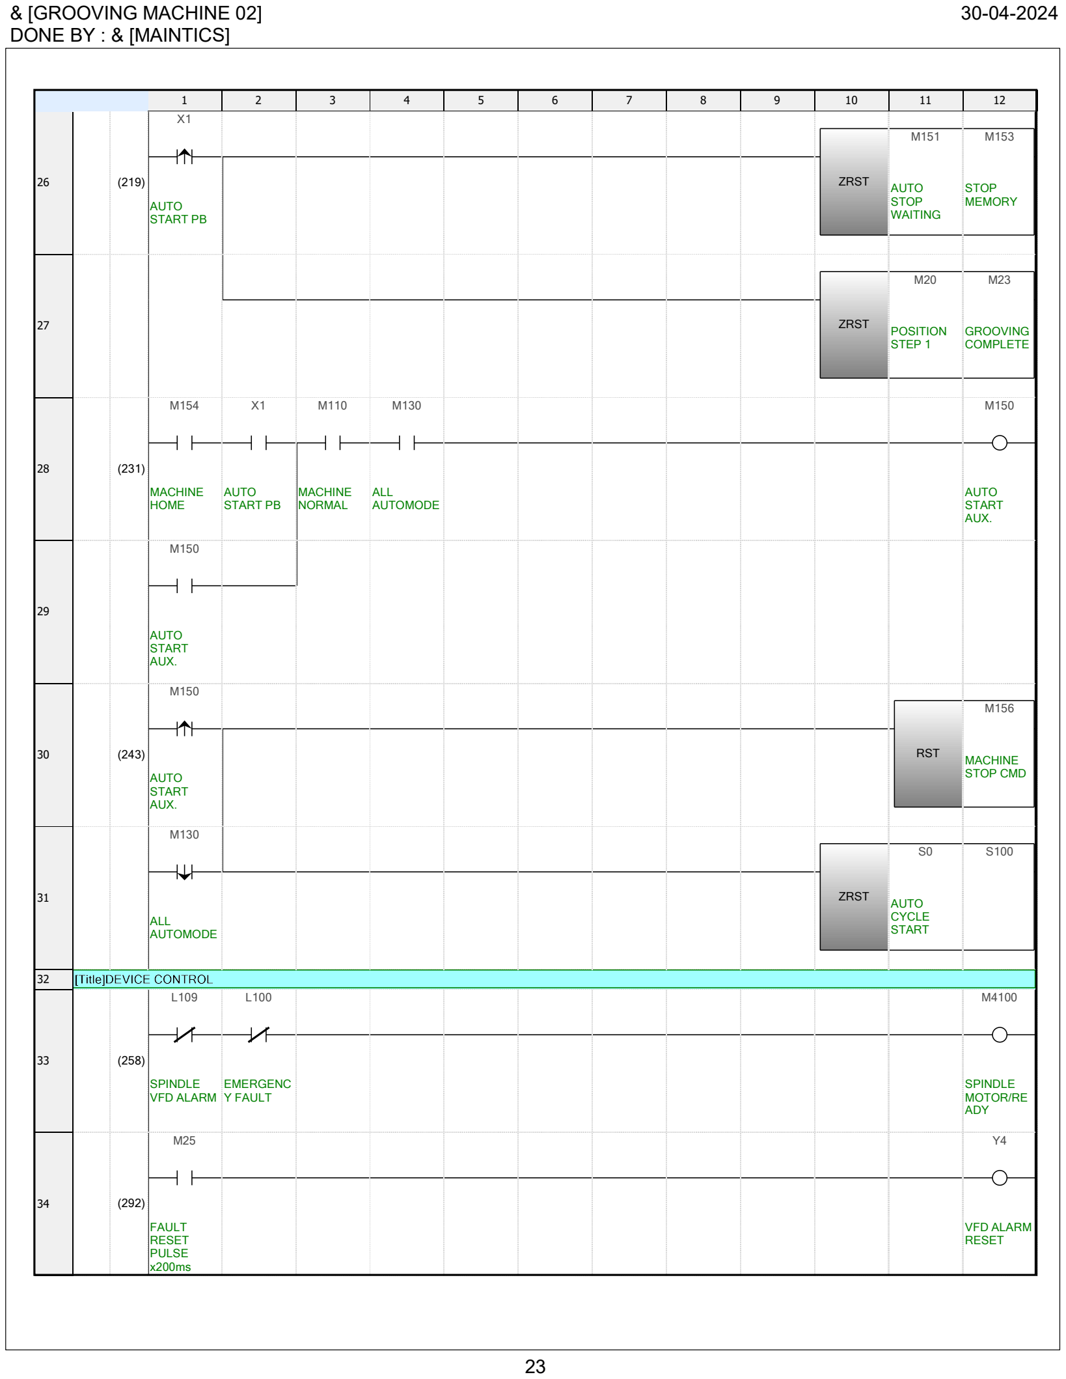
[picture p113: page 23]

23

1 | 2 | 3 | 4 | 5 | 6 | 7 | 8 | 9 | 10 | 11 | 12

26 (219)

X1

AUTO
START PB

ZRST

M151

AUTO
STOP
WAITING

M153

STOP
MEMORY

### 27 ZRST

M20

POSITION
STEP 1

M23

GROOVING
COMPLETE

28 (231)

M154

MACHINE
HOME

X1

AUTO
START PB

M110

MACHINE
NORMAL

M130

ALL
AUTOMODE

M150

AUTO
START
AUX.

29

M150

AUTO
START
AUX.

30 (243)

M150

AUTO
START
AUX.

RST

M156

MACHINE
STOP CMD

31

M130

ALL
AUTOMODE

ZRST

S0

AUTO
CYCLE
START

S100

32

33 (258)

L109

SPINDLE
VFD ALARM

L100

EMERGENC
Y FAULT

M4100

SPINDLE
MOTOR/RE
ADY

34 (292)

M25

FAULT
RESET
PULSE
x200ms

Y4

VFD ALARM
RESET

& [GROOVING MACHINE 02] | 30-04-2024

## DONE BY : & [MAINTICS]

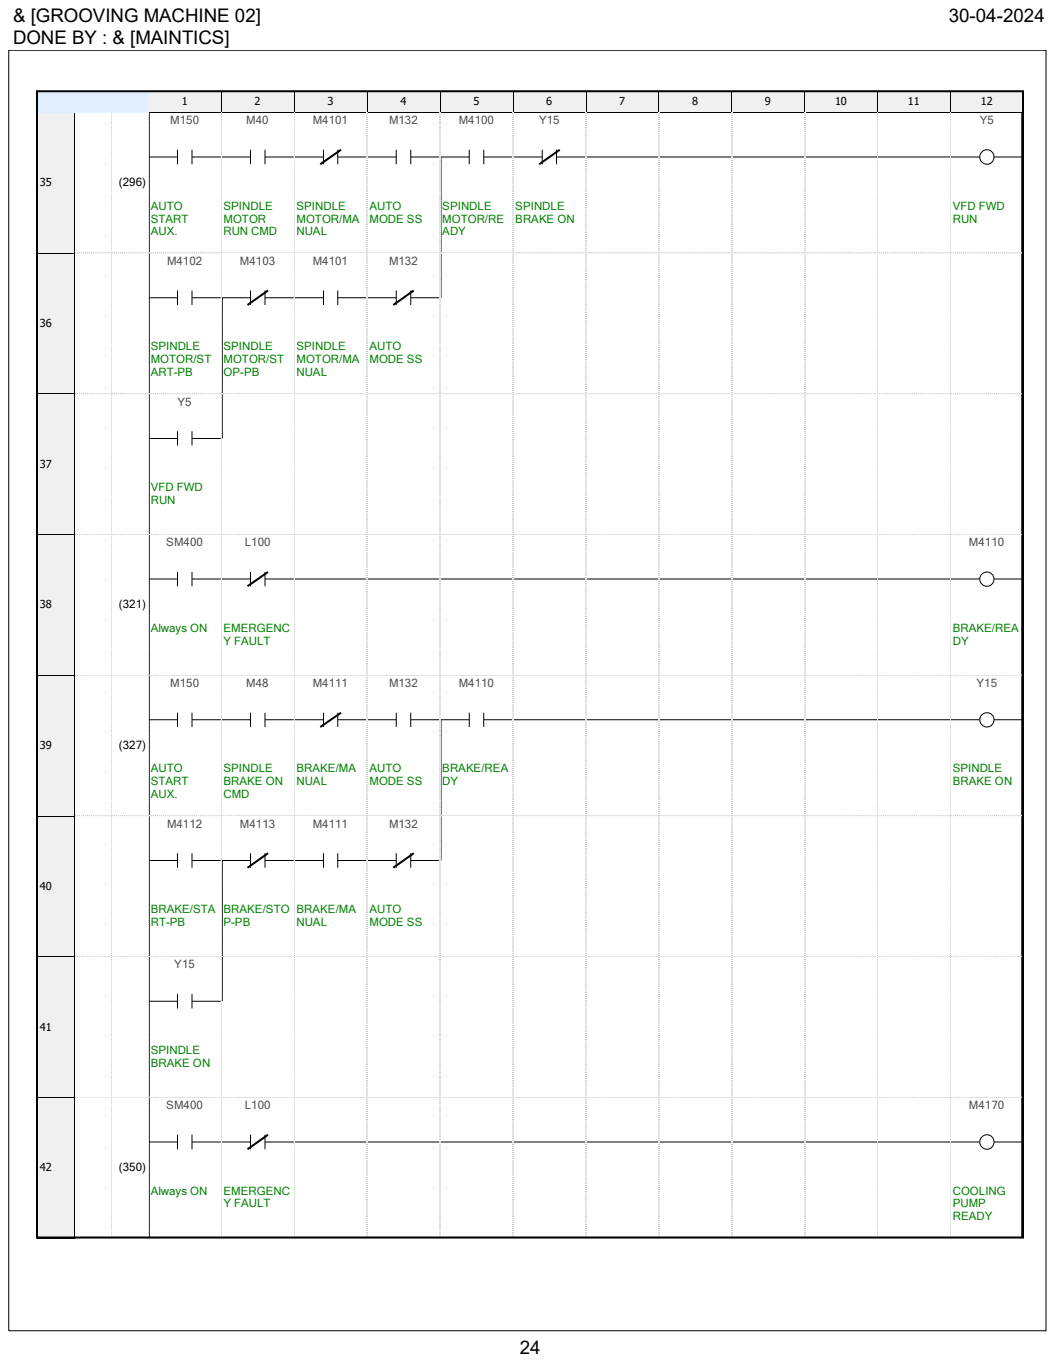
[picture p114: page 24]

24

1 | 2 | 3 | 4 | 5 | 6 | 7 | 8 | 9 | 10 | 11 | 12

35 (296)

M150

AUTO
START
AUX.

M40

SPINDLE
MOTOR
RUN CMD

M4101

SPINDLE
MOTOR/MA
NUAL

M132

AUTO
MODE SS

M4100

SPINDLE
MOTOR/RE
ADY

Y15

SPINDLE
BRAKE ON

Y5

VFD FWD
RUN

36

M4102

SPINDLE
MOTOR/ST
ART-PB

M4103

SPINDLE
MOTOR/ST
OP-PB

M4101

SPINDLE
MOTOR/MA
NUAL

M132

AUTO
MODE SS

37

Y5

VFD FWD
RUN

38 (321)

SM400

Always ON

L100

EMERGENC
Y FAULT

M4110

BRAKE/REA
DY

39 (327)

M150

AUTO
START
AUX.

M48

SPINDLE
BRAKE ON
CMD

M4111

BRAKE/MA
NUAL

M132

AUTO
MODE SS

M4110

BRAKE/REA
DY

Y15

SPINDLE
BRAKE ON

40

M4112

BRAKE/STA
RT-PB

M4113

BRAKE/STO
P-PB

M4111

BRAKE/MA
NUAL

M132

AUTO
MODE SS

41

Y15

SPINDLE
BRAKE ON

42 (350)

SM400

Always ON

L100

EMERGENC
Y FAULT

M4170

COOLING
PUMP
READY

& [GROOVING MACHINE 02] | 30-04-2024

## DONE BY : & [MAINTICS]

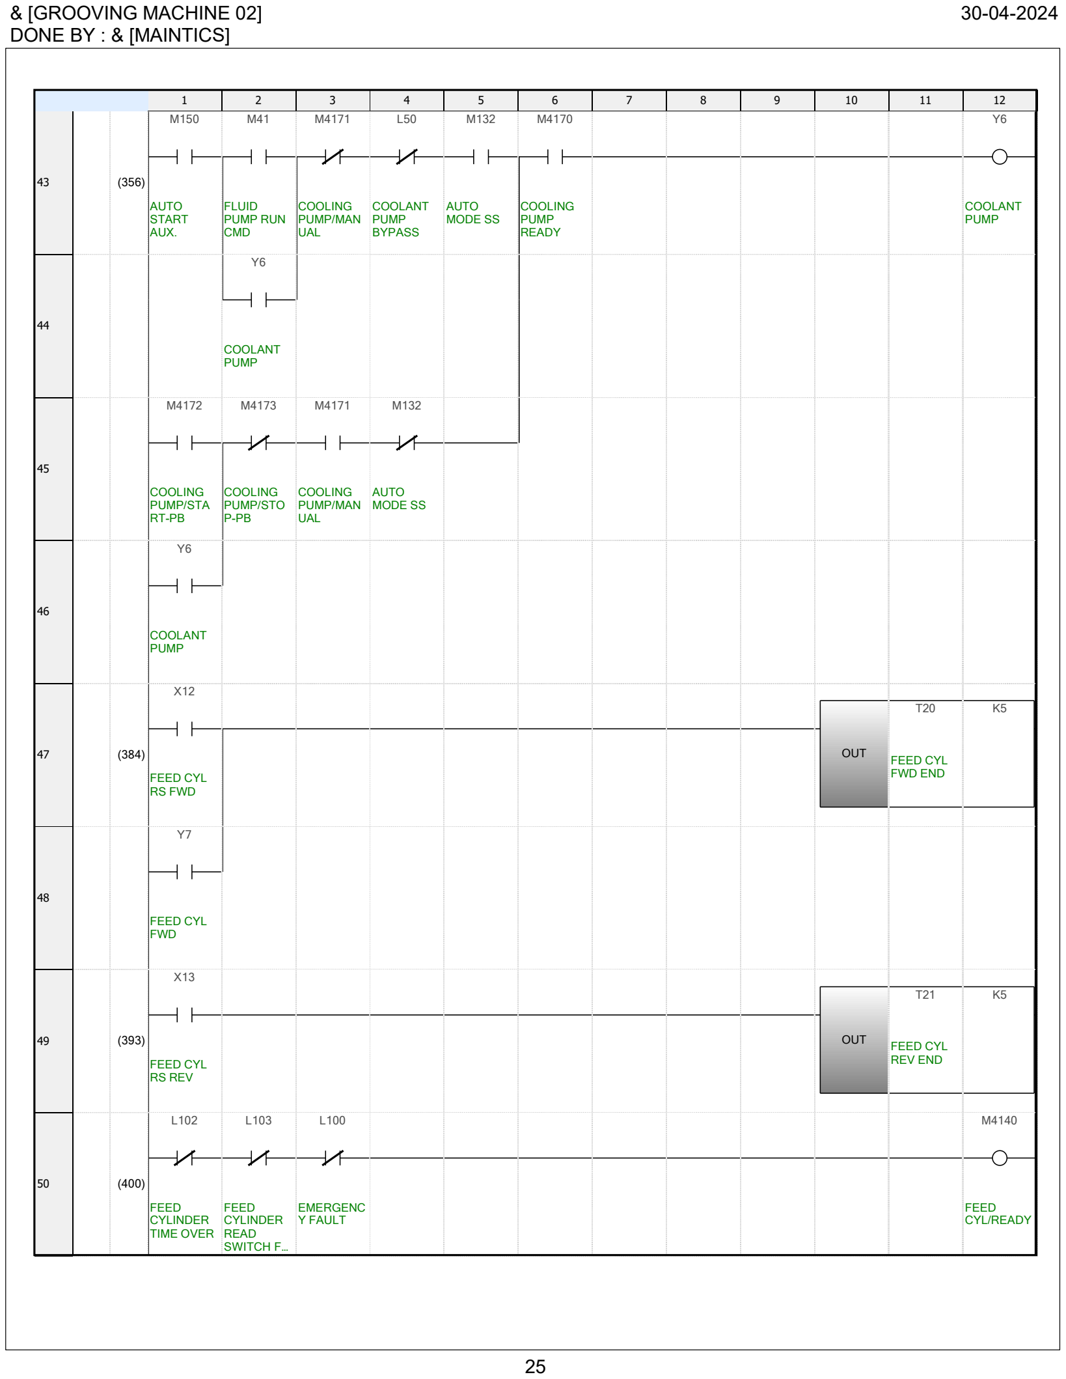
[picture p115: page 25]

25

1 | 2 | 3 | 4 | 5 | 6 | 7 | 8 | 9 | 10 | 11 | 12

43 (356)

M150

AUTO
START
AUX.

M41

FLUID
PUMP RUN
CMD

M4171

COOLING
PUMP/MAN
UAL

L50

COOLANT
PUMP
BYPASS

M132

AUTO
MODE SS

M4170

COOLING
PUMP
READY

Y6

COOLANT
PUMP

44

Y6

COOLANT
PUMP

45

M4172

COOLING
PUMP/STA
RT-PB

M4173

COOLING
PUMP/STO
P-PB

M4171

COOLING
PUMP/MAN
UAL

M132

AUTO
MODE SS

46

Y6

COOLANT
PUMP

47 (384)

X12

FEED CYL
RS FWD

OUT

T20

FEED CYL
FWD END

K5

48

Y7

FEED CYL
FWD

49 (393)

X13

FEED CYL
RS REV

OUT

T21

FEED CYL
REV END

K5

50 (400)

L102

FEED
CYLINDER
TIME OVER

L103

FEED
CYLINDER
READ
SWITCH F…

L100

EMERGENC
Y FAULT

M4140

FEED
CYL/READY

& [GROOVING MACHINE 02] | 30-04-2024

## DONE BY : & [MAINTICS]

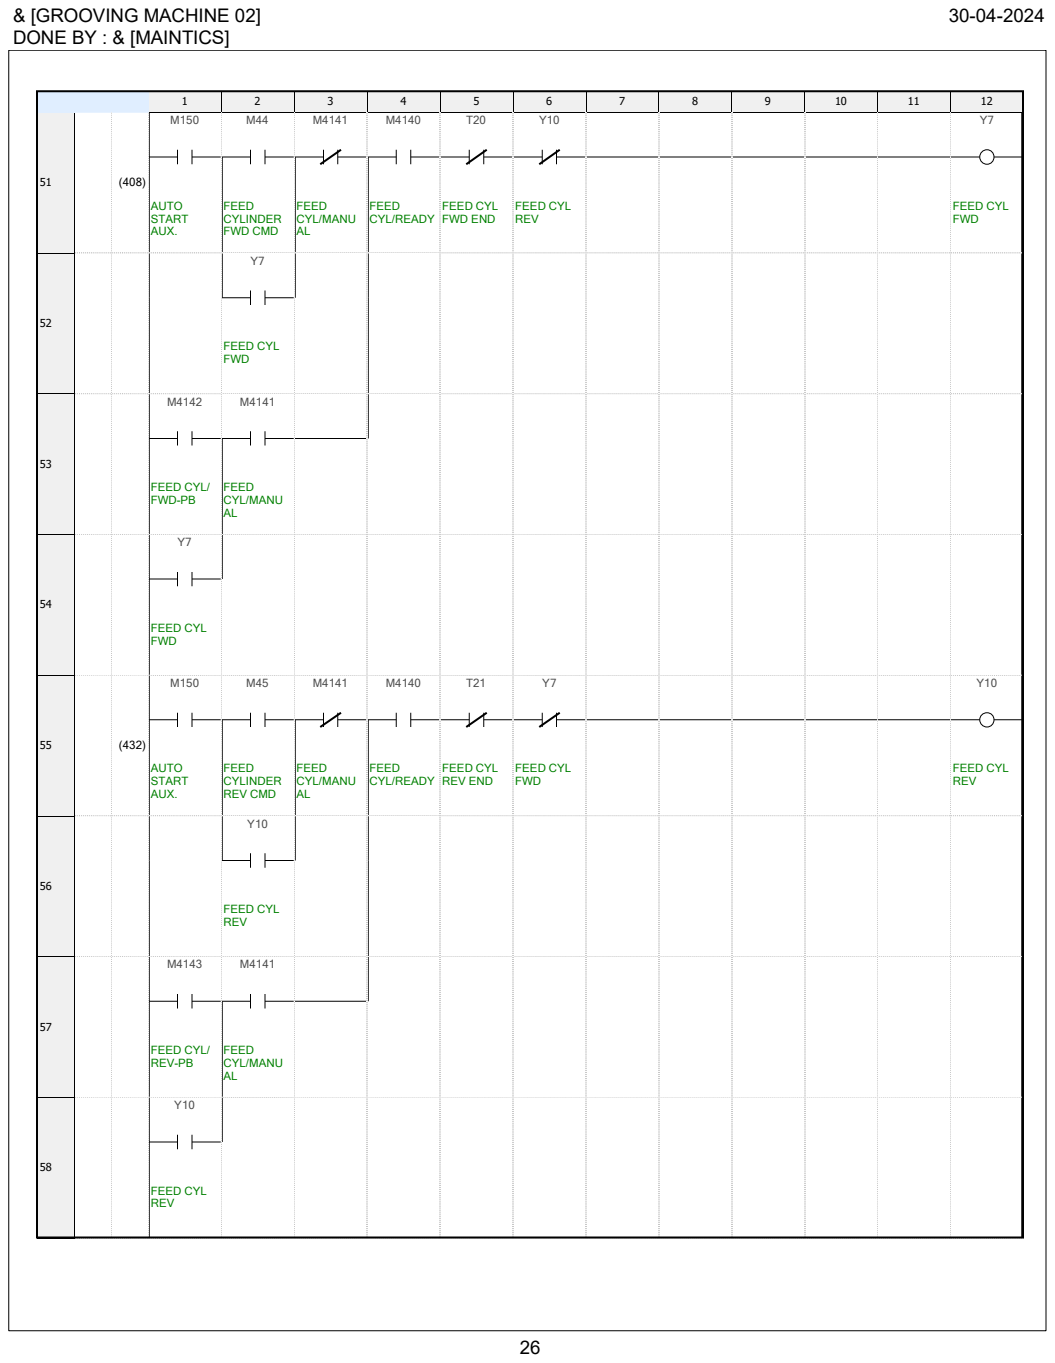
[picture p116: page 26]

26

1 | 2 | 3 | 4 | 5 | 6 | 7 | 8 | 9 | 10 | 11 | 12

51 (408)

M150

AUTO
START
AUX.

M44

FEED
CYLINDER
FWD CMD

M4141

FEED
CYL/MANU
AL

M4140

FEED
CYL/READY

T20

FEED CYL
FWD END

Y10

FEED CYL
REV

Y7

FEED CYL
FWD

52

Y7

FEED CYL
FWD

53

M4142

FEED CYL/
FWD-PB

M4141

FEED
CYL/MANU
AL

54

Y7

FEED CYL
FWD

55 (432)

M150

AUTO
START
AUX.

M45

FEED
CYLINDER
REV CMD

M4141

FEED
CYL/MANU
AL

M4140

FEED
CYL/READY

T21

FEED CYL
REV END

Y7

FEED CYL
FWD

Y10

FEED CYL
REV

56

Y10

FEED CYL
REV

57

M4143

FEED CYL/
REV-PB

M4141

FEED
CYL/MANU
AL

58

Y10

FEED CYL
REV

& [GROOVING MACHINE 02] | 30-04-2024

## DONE BY : & [MAINTICS]

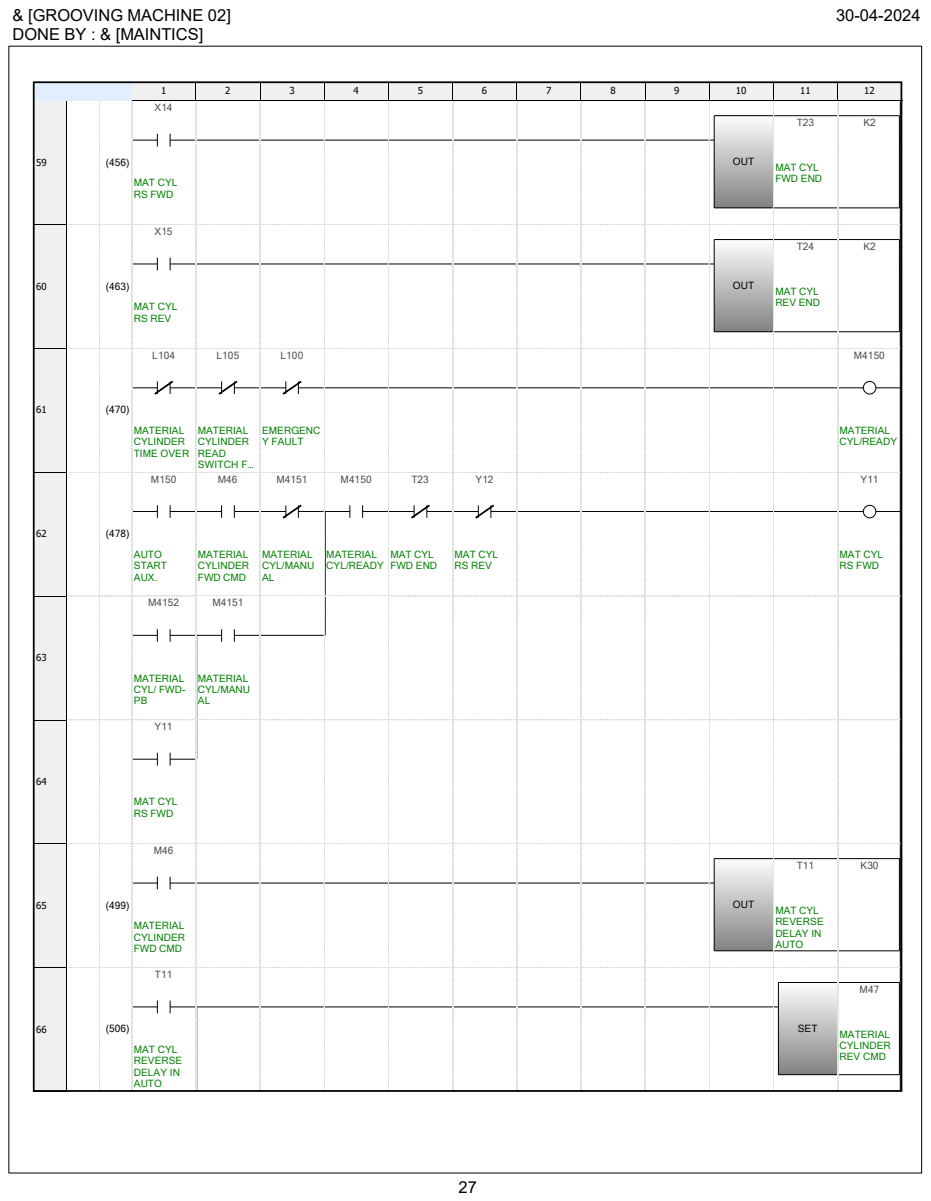
[picture p117: page 27]
MAT CYL RS FWD; OUT; MAT CYL FWD END; MAT CYL RS REV; MAT CYL REV END; MATERIAL CYLINDER TIME OVER; MATERIAL CYLINDER READ SWITCH F…; EMERGENC Y FAULT; MATERIAL CYL/READY; AUTO START AUX.; MATERIAL CYLINDER FWD CMD; MATERIAL CYL/MANU AL; MATERIAL CYL/ FWD- PB; MAT CYL REVERSE DELAY IN AUTO; SET; MATERIAL CYLINDER REV CMD

& [GROOVING MACHINE 02] | 30-04-2024

## DONE BY : & [MAINTICS]

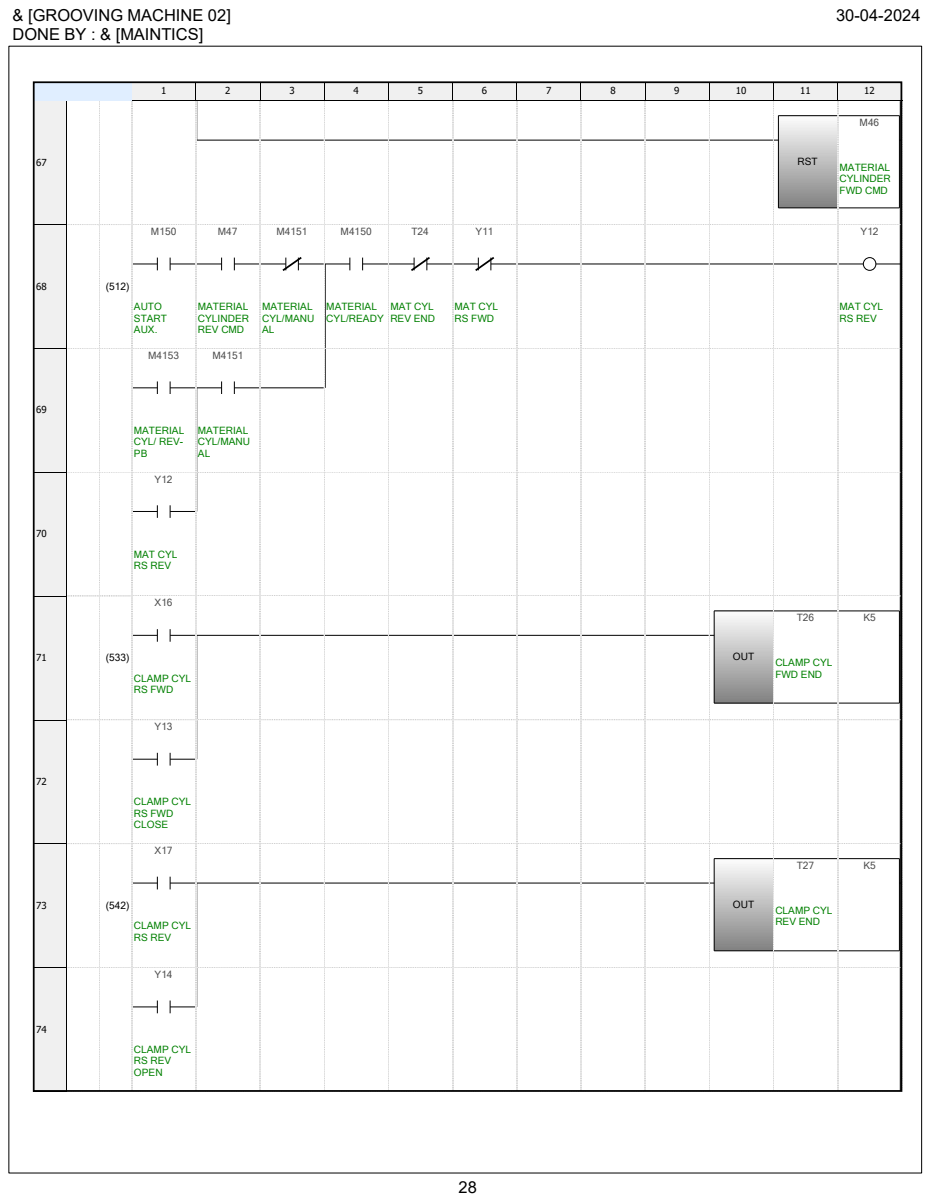
[picture p118: page 28]
67 RST; MATERIAL CYLINDER FWD CMD; AUTO START AUX.; MATERIAL CYLINDER REV CMD; MATERIAL CYL/MANU AL; MATERIAL CYL/READY; MAT CYL REV END; MAT CYL RS FWD; MAT CYL RS REV; MATERIAL CYL/ REV- PB; CLAMP CYL RS FWD; OUT; CLAMP CYL FWD END; CLAMP CYL RS FWD CLOSE; CLAMP CYL RS REV; CLAMP CYL REV END; CLAMP CYL RS REV OPEN

& [GROOVING MACHINE 02] | 30-04-2024

## DONE BY : & [MAINTICS]

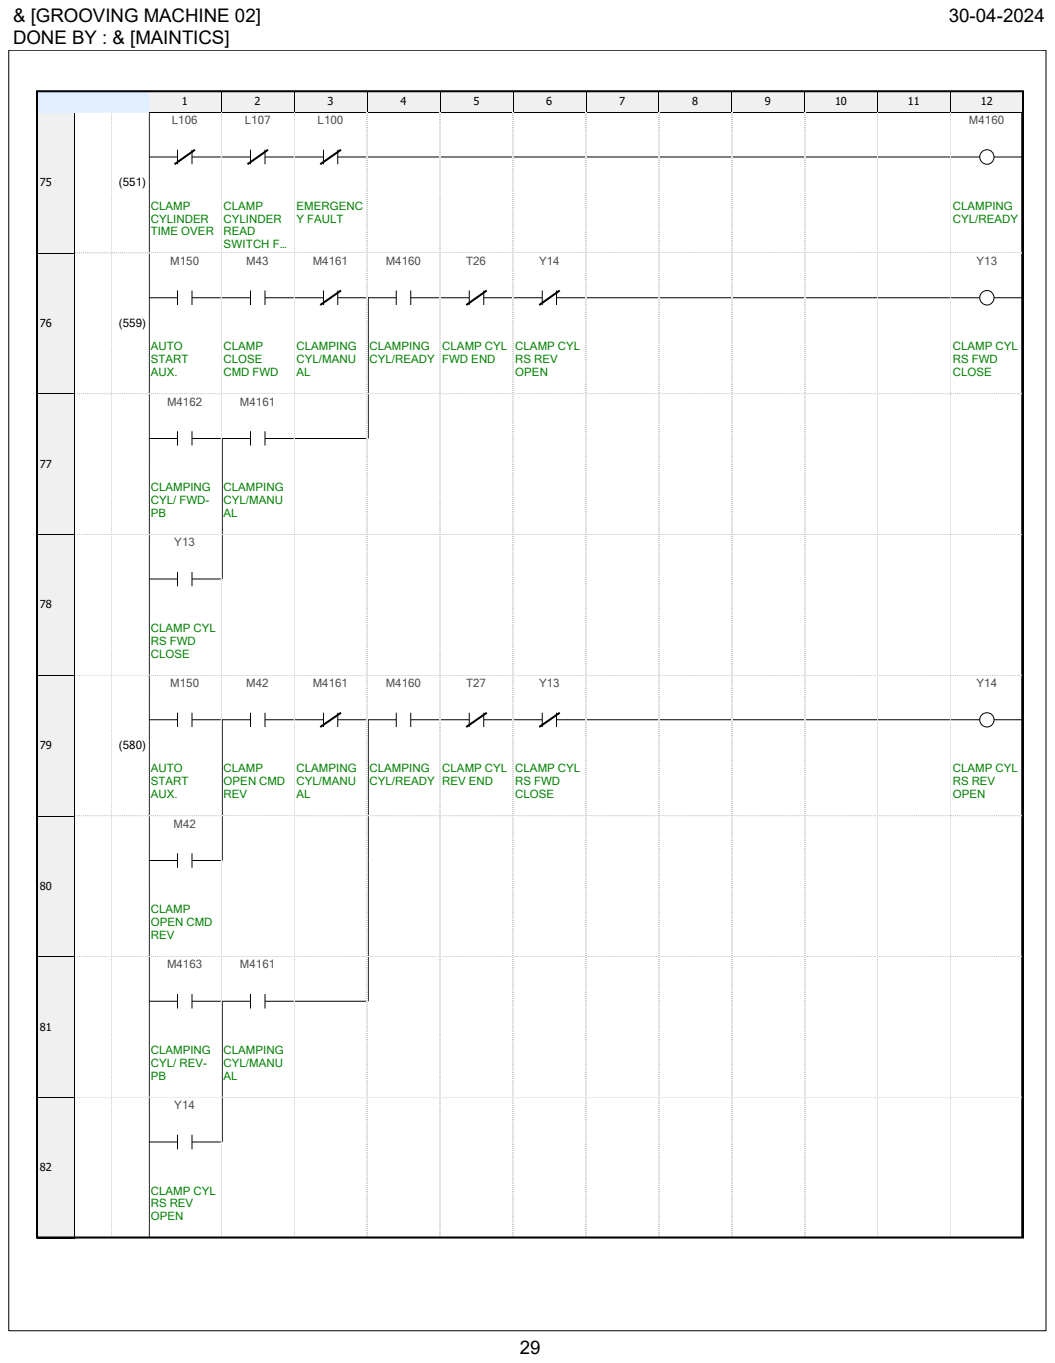
[picture p119: page 29]

29

1 | 2 | 3 | 4 | 5 | 6 | 7 | 8 | 9 | 10 | 11 | 12

75 (551)

L106

CLAMP
CYLINDER
TIME OVER

L107

CLAMP
CYLINDER
READ
SWITCH F…

L100

EMERGENC
Y FAULT

M4160

CLAMPING
CYL/READY

76 (559)

M150

AUTO
START
AUX.

M43

CLAMP
CLOSE
CMD FWD

M4161

CLAMPING
CYL/MANU
AL

M4160

CLAMPING
CYL/READY

T26

CLAMP CYL
FWD END

Y14

CLAMP CYL
RS REV
OPEN

Y13

CLAMP CYL
RS FWD
CLOSE

77

M4162

CLAMPING
CYL/ FWD-PB

M4161

CLAMPING
CYL/MANU
AL

78

Y13

CLAMP CYL
RS FWD
CLOSE

79 (580)

M150

AUTO
START
AUX.

M42

CLAMP
OPEN CMD
REV

M4161

CLAMPING
CYL/MANU
AL

M4160

CLAMPING
CYL/READY

T27

CLAMP CYL
REV END

Y13

CLAMP CYL
RS FWD
CLOSE

Y14

CLAMP CYL
RS REV
OPEN

80

M42

CLAMP
OPEN CMD
REV

81

M4163

CLAMPING
CYL/ REV-PB

M4161

CLAMPING
CYL/MANU
AL

82

Y14

CLAMP CYL
RS REV
OPEN

& [GROOVING MACHINE 02] | 30-04-2024

## DONE BY : & [MAINTICS]

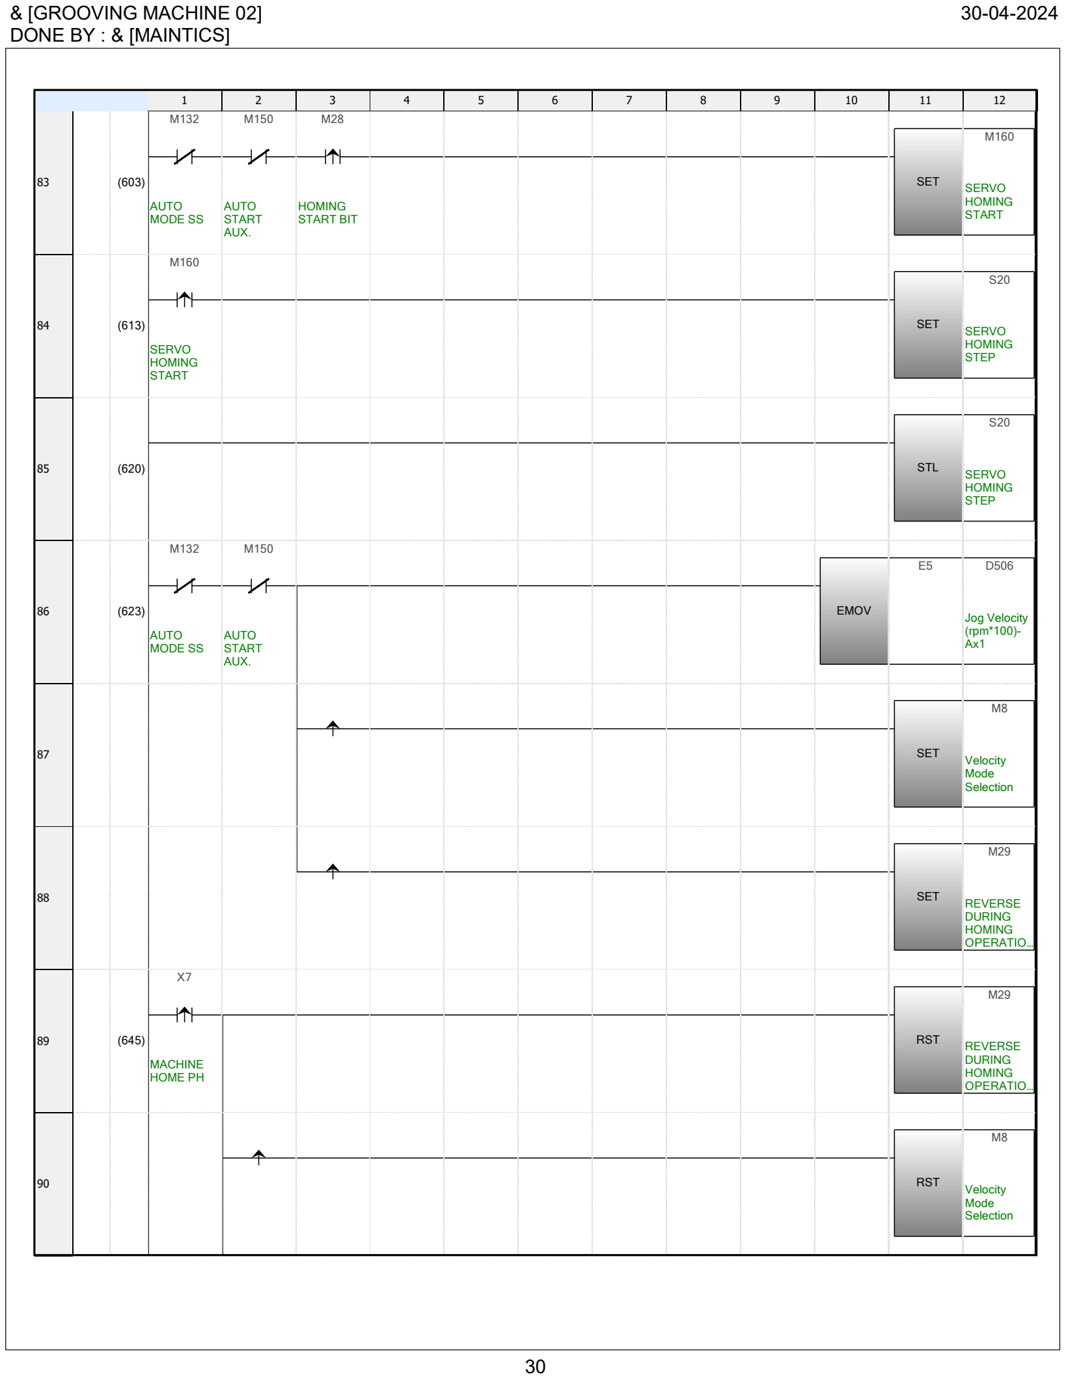
[picture p120: page 30]

30

1 | 2 | 3 | 4 | 5 | 6 | 7 | 8 | 9 | 10 | 11 | 12

83 (603)

M132

AUTO
MODE SS

M150

AUTO
START
AUX.

M28

HOMING
START BIT

SET

M160

SERVO
HOMING
START

84 (613)

M160

SERVO
HOMING
START

SET

S20

SERVO
HOMING
STEP
85 | (620) | STL

S20

SERVO
HOMING
STEP

86 (623)

M132

AUTO
MODE SS

M150

AUTO
START
AUX.

EMOV

E5 | D506

Jog Velocity
(rpm*100)-
Ax1

### 87 SET

M8

Velocity
Mode
Selection

### 88 SET

M29

REVERSE
DURING
HOMING
OPERATIO…

89 (645)

X7

MACHINE
HOME PH

RST

M29

REVERSE
DURING
HOMING
OPERATIO…

### 90 RST

M8

Velocity
Mode
Selection

& [GROOVING MACHINE 02] | 30-04-2024

## DONE BY : & [MAINTICS]

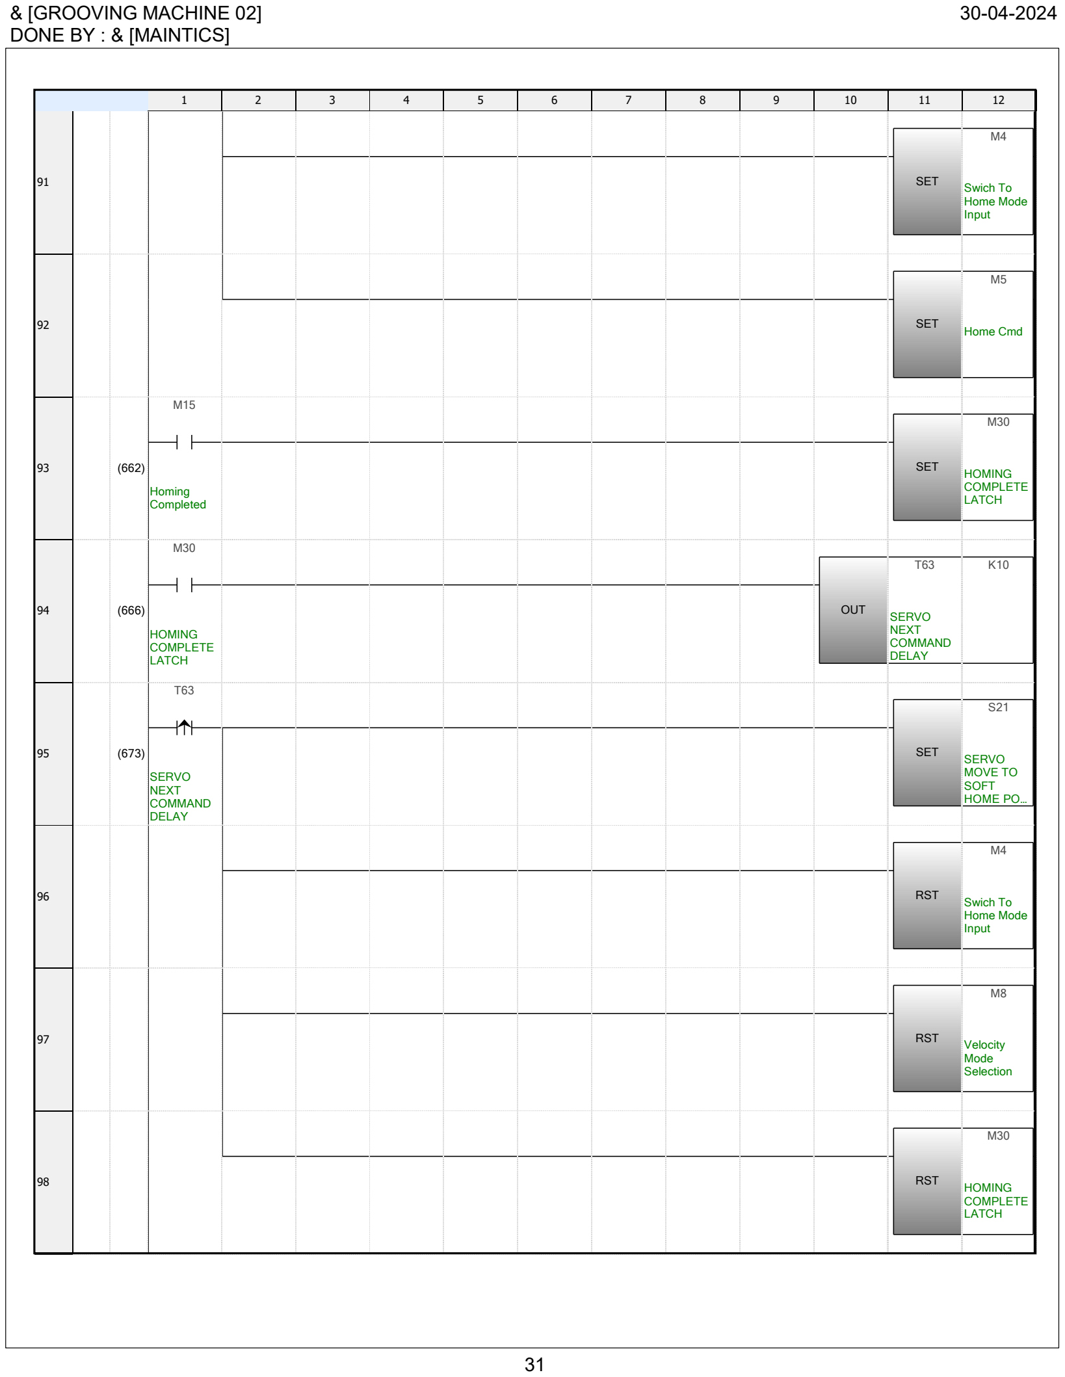
[picture p121: page 31]

31

1 | 2 | 3 | 4 | 5 | 6 | 7 | 8 | 9 | 10 | 11 | 12

### 91 SET

M4

Swich To
Home Mode
Input

### 92 SET

M5

Home Cmd

93 (662)

M15

Homing
Completed

SET

M30

HOMING
COMPLETE
LATCH

94 (666)

M30

HOMING
COMPLETE
LATCH

OUT

T63

SERVO
NEXT
COMMAND
DELAY

K10

95 (673)

T63

SERVO
NEXT
COMMAND
DELAY

SET

S21

SERVO
MOVE TO
SOFT
HOME PO…

### 96 RST

M4

Swich To
Home Mode
Input

### 97 RST

M8

Velocity
Mode
Selection

### 98 RST

M30

HOMING
COMPLETE
LATCH

& [GROOVING MACHINE 02] | 30-04-2024

## DONE BY : & [MAINTICS]

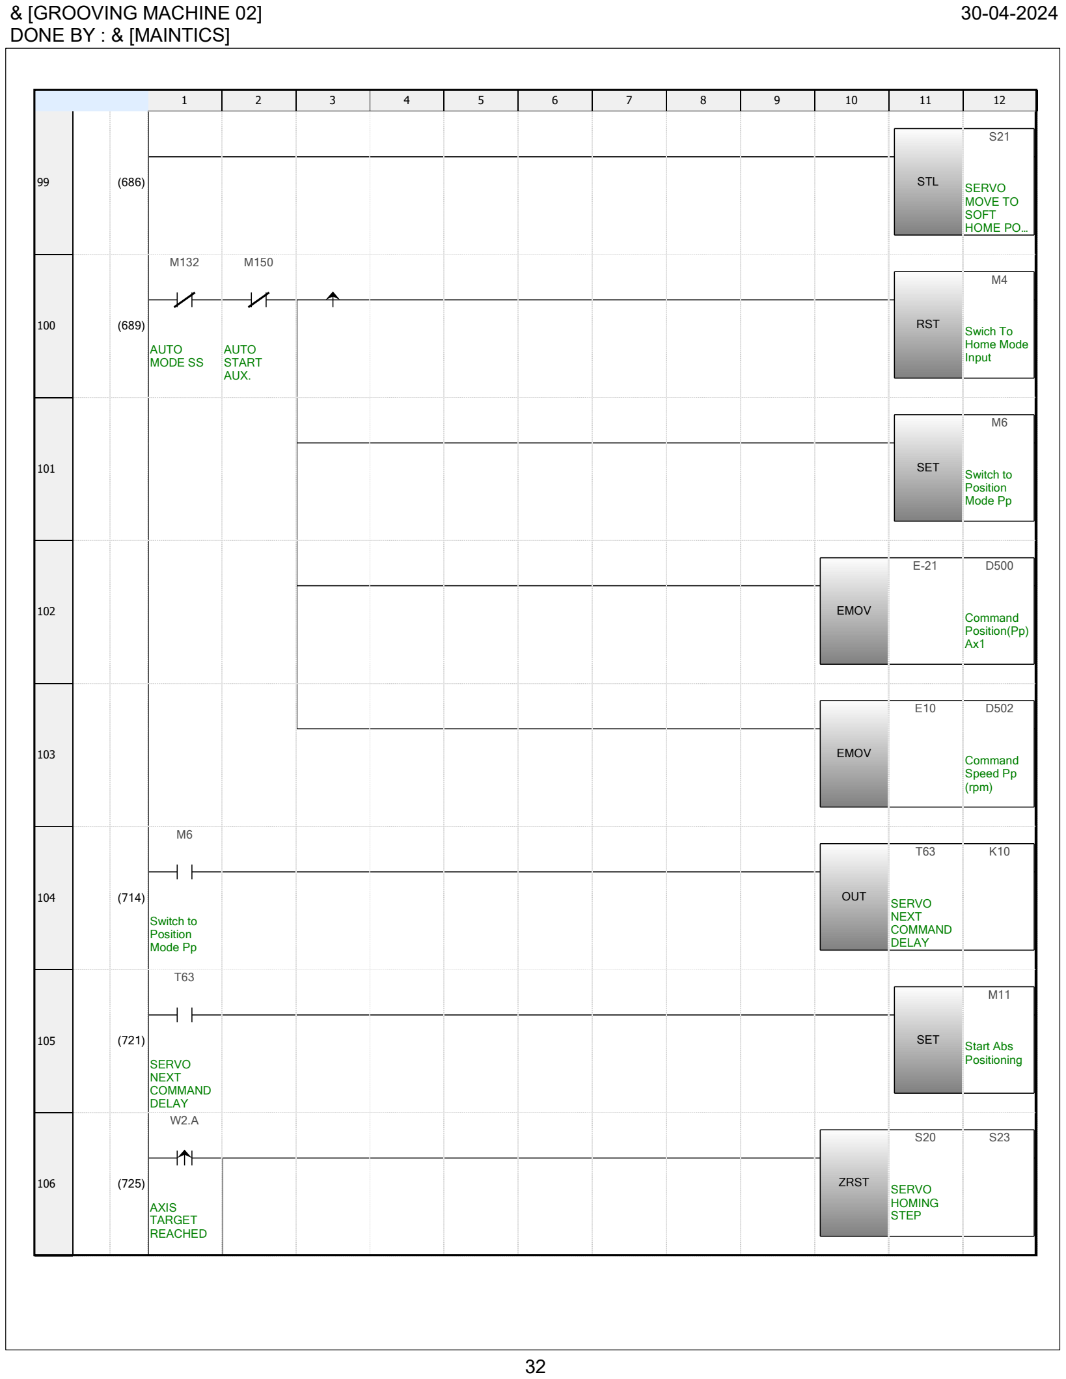
[picture p122: page 32]

32

1 | 2 | 3 | 4 | 5 | 6 | 7 | 8 | 9 | 10 | 11 | 12
99 | (686) | STL

S21

SERVO
MOVE TO
SOFT
HOME PO…

100 (689)

M132

AUTO
MODE SS

M150

AUTO
START
AUX.

RST

M4

Swich To
Home Mode
Input

101 SET

M6

Switch to
Position
Mode Pp

102 EMOV

E-21 | D500

Command
Position(Pp)
Ax1

103 EMOV

E10 | D502

Command
Speed Pp
(rpm)

104 (714)

M6

Switch to
Position
Mode Pp

OUT

T63

SERVO
NEXT
COMMAND
DELAY

K10

105 (721)

T63

SERVO
NEXT
COMMAND
DELAY

SET

M11

Start Abs
Positioning

106 (725)

W2.A

AXIS
TARGET
REACHED

ZRST

S20

SERVO
HOMING
STEP

S23

& [GROOVING MACHINE 02] | 30-04-2024

## DONE BY : & [MAINTICS]

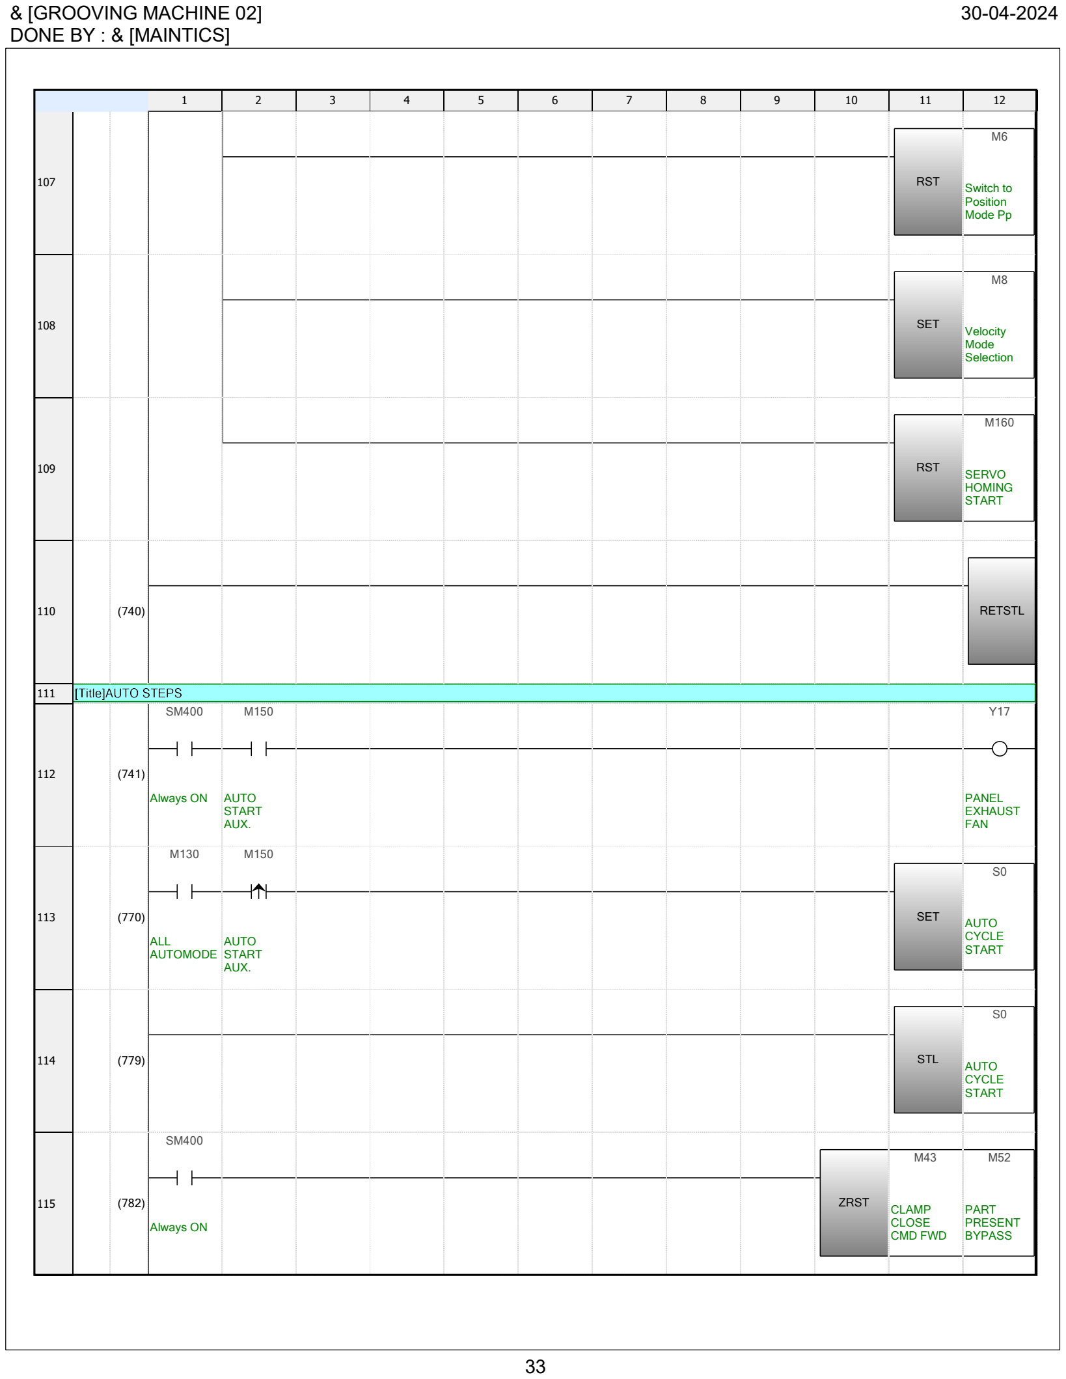
[picture p123: page 33]

33

1 | 2 | 3 | 4 | 5 | 6 | 7 | 8 | 9 | 10 | 11 | 12

107 RST

M6

Switch to
Position
Mode Pp

108 SET

M8

Velocity
Mode
Selection

109 RST

M160

SERVO
HOMING
START
110 | (740) | RETSTL

111

112 (741)

SM400

Always ON

M150

AUTO
START
AUX.

Y17

PANEL
EXHAUST
FAN

113 (770)

M130

ALL
AUTOMODE

M150

AUTO
START
AUX.

SET

S0

AUTO
CYCLE
START
114 | (779) | STL

S0

AUTO
CYCLE
START

115 (782)

SM400

Always ON

ZRST

M43

CLAMP
CLOSE
CMD FWD

M52

PART
PRESENT
BYPASS

& [GROOVING MACHINE 02] | 30-04-2024

## DONE BY : & [MAINTICS]

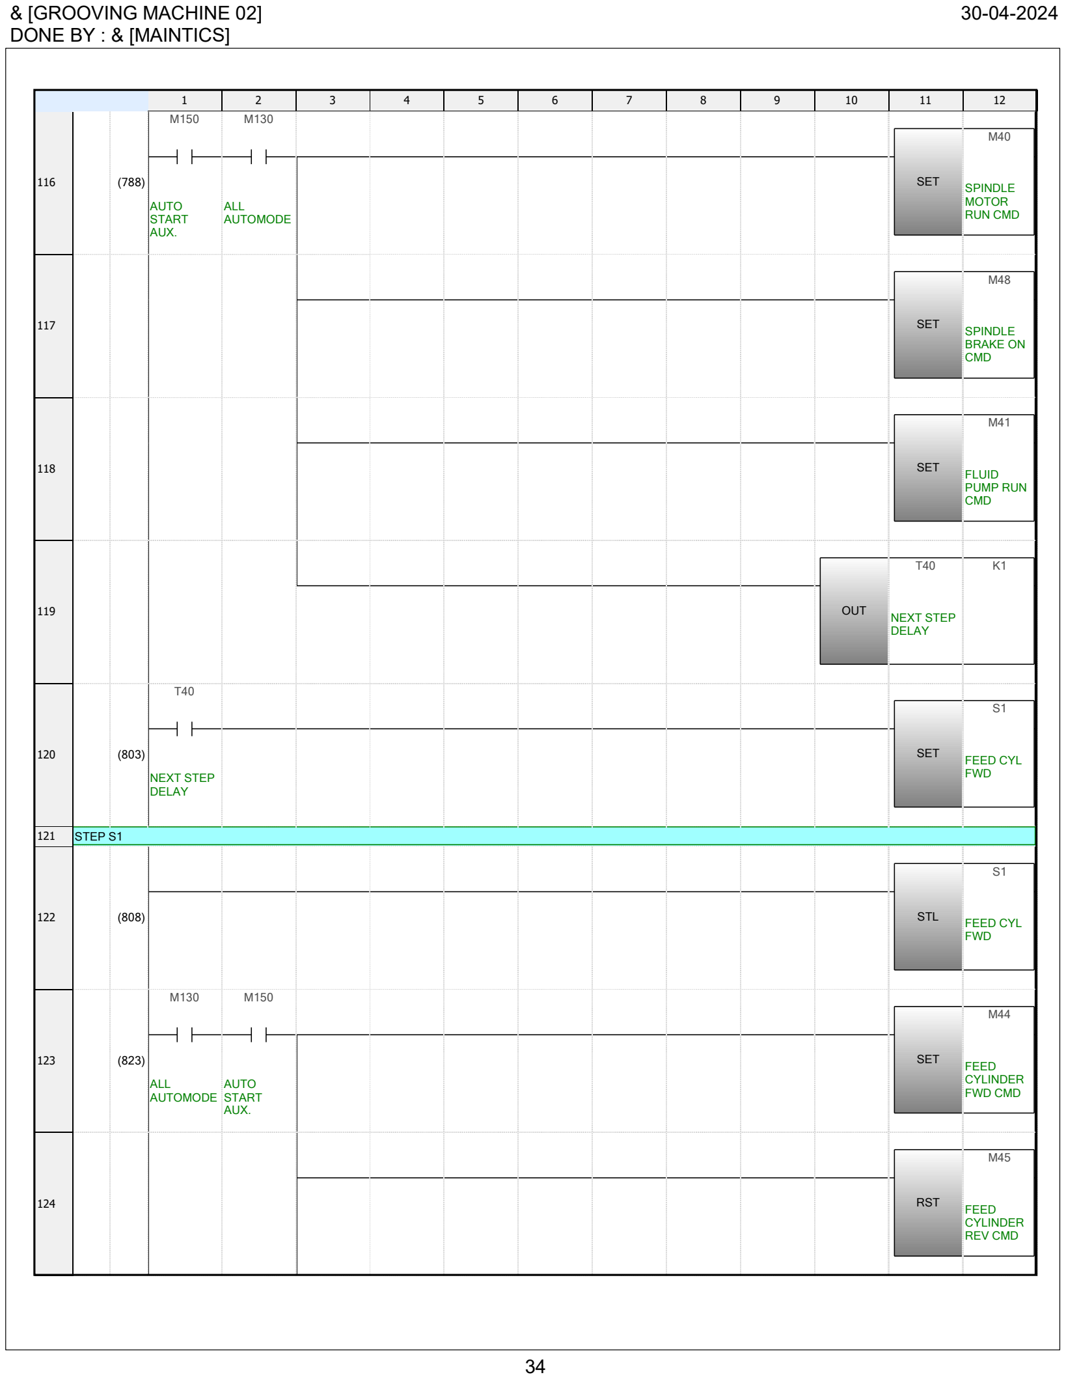
[picture p124: page 34]

34

1 | 2 | 3 | 4 | 5 | 6 | 7 | 8 | 9 | 10 | 11 | 12

116 (788)

M150

AUTO
START
AUX.

M130

ALL
AUTOMODE

SET

M40

SPINDLE
MOTOR
RUN CMD

117 SET

M48

SPINDLE
BRAKE ON
CMD

118 SET

M41

FLUID
PUMP RUN
CMD

119 OUT

T40

NEXT STEP
DELAY

K1

120 (803)

T40

NEXT STEP
DELAY

SET

S1

FEED CYL
FWD

121 STEP S1

122 | (808) | STL

S1

FEED CYL
FWD

123 (823)

M130

ALL
AUTOMODE

M150

AUTO
START
AUX.

SET

M44

FEED
CYLINDER
FWD CMD

124 RST

M45

FEED
CYLINDER
REV CMD

& [GROOVING MACHINE 02] | 30-04-2024

## DONE BY : & [MAINTICS]

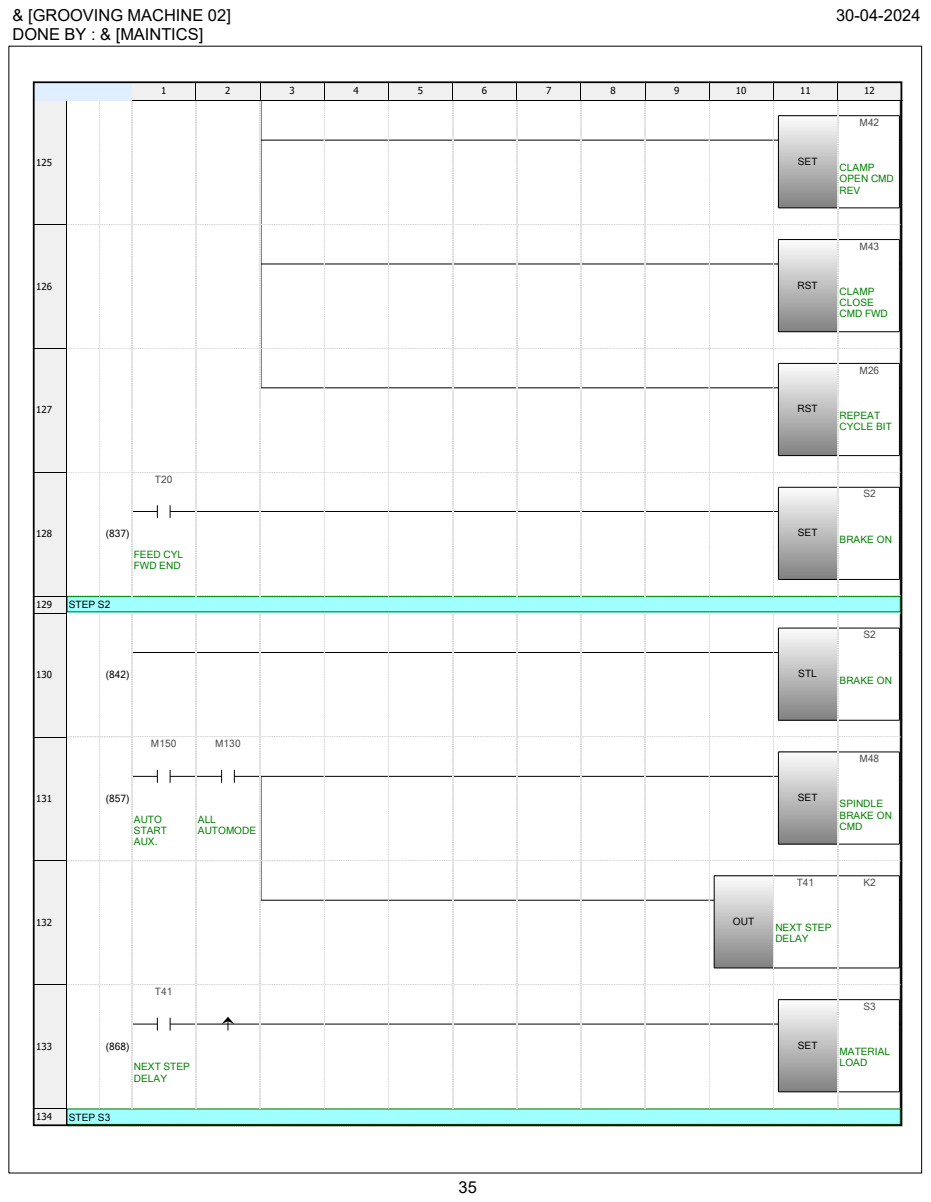
[picture p125: page 35]
125 SET; CLAMP OPEN CMD REV; 126 RST; CLAMP CLOSE CMD FWD; 127 RST; REPEAT CYCLE BIT; FEED CYL FWD END; SET; BRAKE ON; 129 STEP S2; STL; AUTO START AUX.; ALL AUTOMODE; SPINDLE BRAKE ON CMD; 132 OUT; NEXT STEP DELAY; MATERIAL LOAD; 134 STEP S3

& [GROOVING MACHINE 02] | 30-04-2024

## DONE BY : & [MAINTICS]

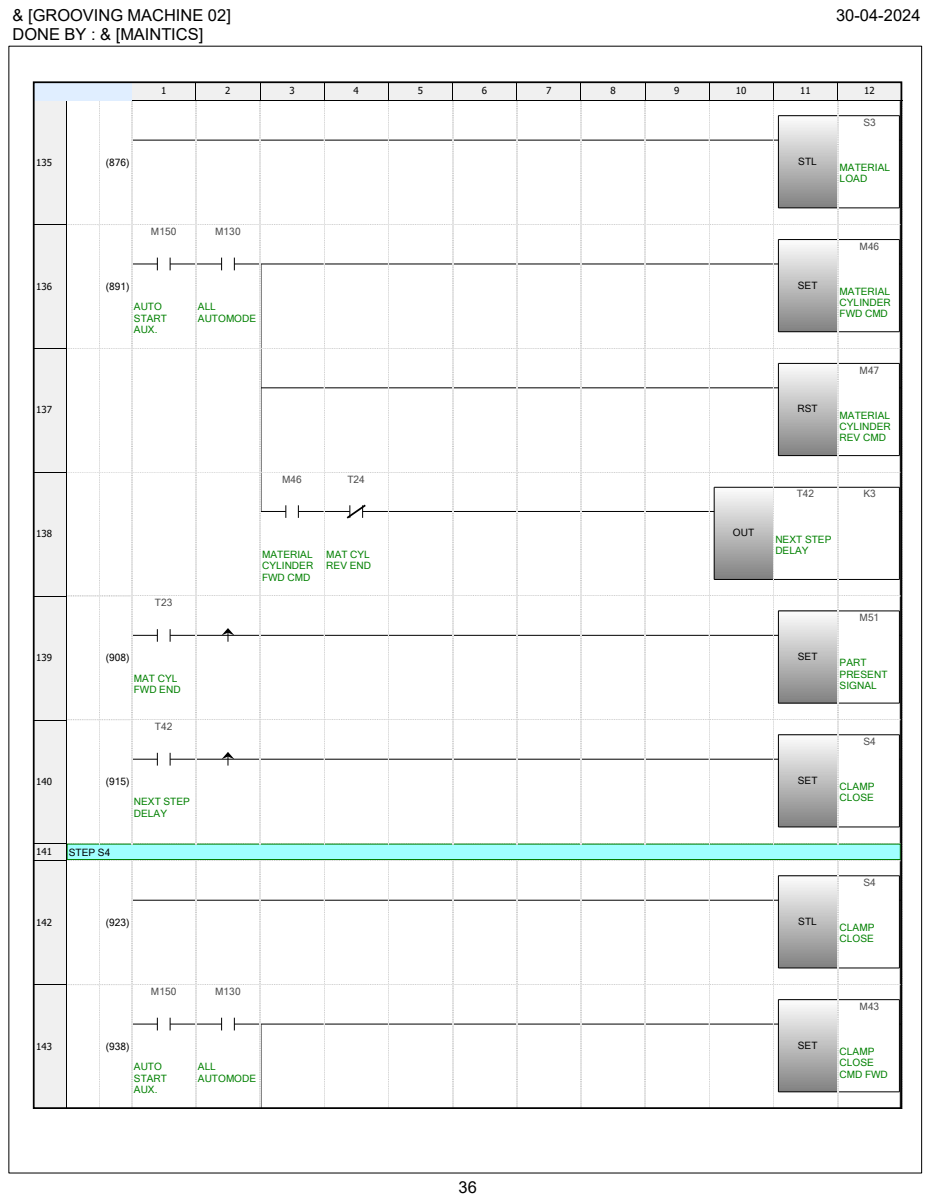
[picture p126: page 36]
STL; MATERIAL LOAD; AUTO START AUX.; ALL AUTOMODE; SET; MATERIAL CYLINDER FWD CMD; 137 RST; MATERIAL CYLINDER REV CMD; MAT CYL REV END; OUT; NEXT STEP DELAY; MAT CYL FWD END; PART PRESENT SIGNAL; CLAMP CLOSE; 141 STEP S4; CLAMP CLOSE CMD FWD

& [GROOVING MACHINE 02] | 30-04-2024

## DONE BY : & [MAINTICS]

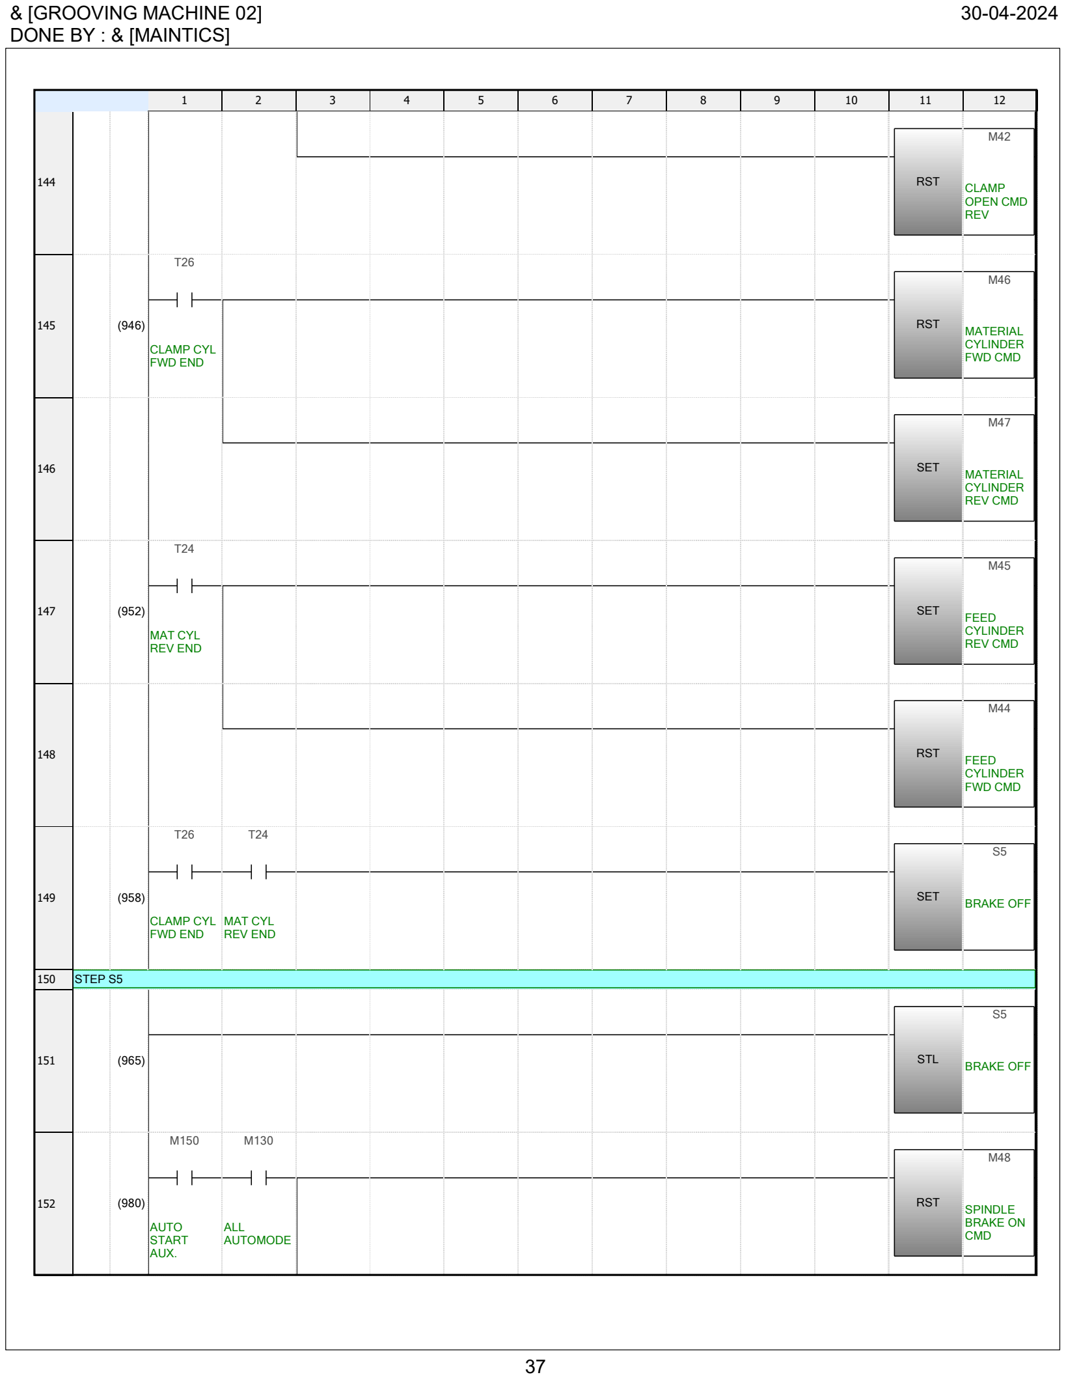
[picture p127: page 37]

37

1 | 2 | 3 | 4 | 5 | 6 | 7 | 8 | 9 | 10 | 11 | 12

144 RST

M42

CLAMP
OPEN CMD
REV

145 (946)

T26

T24

CLAMP CYL
FWD END

RST

M46

MATERIAL
CYLINDER
FWD CMD

146 SET

M47

MATERIAL
CYLINDER
REV CMD

147 (952)

MAT CYL
REV END

SET

M45

FEED
CYLINDER
REV CMD

148 RST

M44

FEED
CYLINDER
FWD CMD

149 (958)

T26

CLAMP CYL
FWD END

T24

MAT CYL
REV END

SET

S5

BRAKE OFF

150 STEP S5

151 | (965) | STL

S5

BRAKE OFF

152 (980)

M150

AUTO
START
AUX.

M130

ALL
AUTOMODE

RST

M48

SPINDLE
BRAKE ON
CMD

& [GROOVING MACHINE 02] | 30-04-2024

## DONE BY : & [MAINTICS]

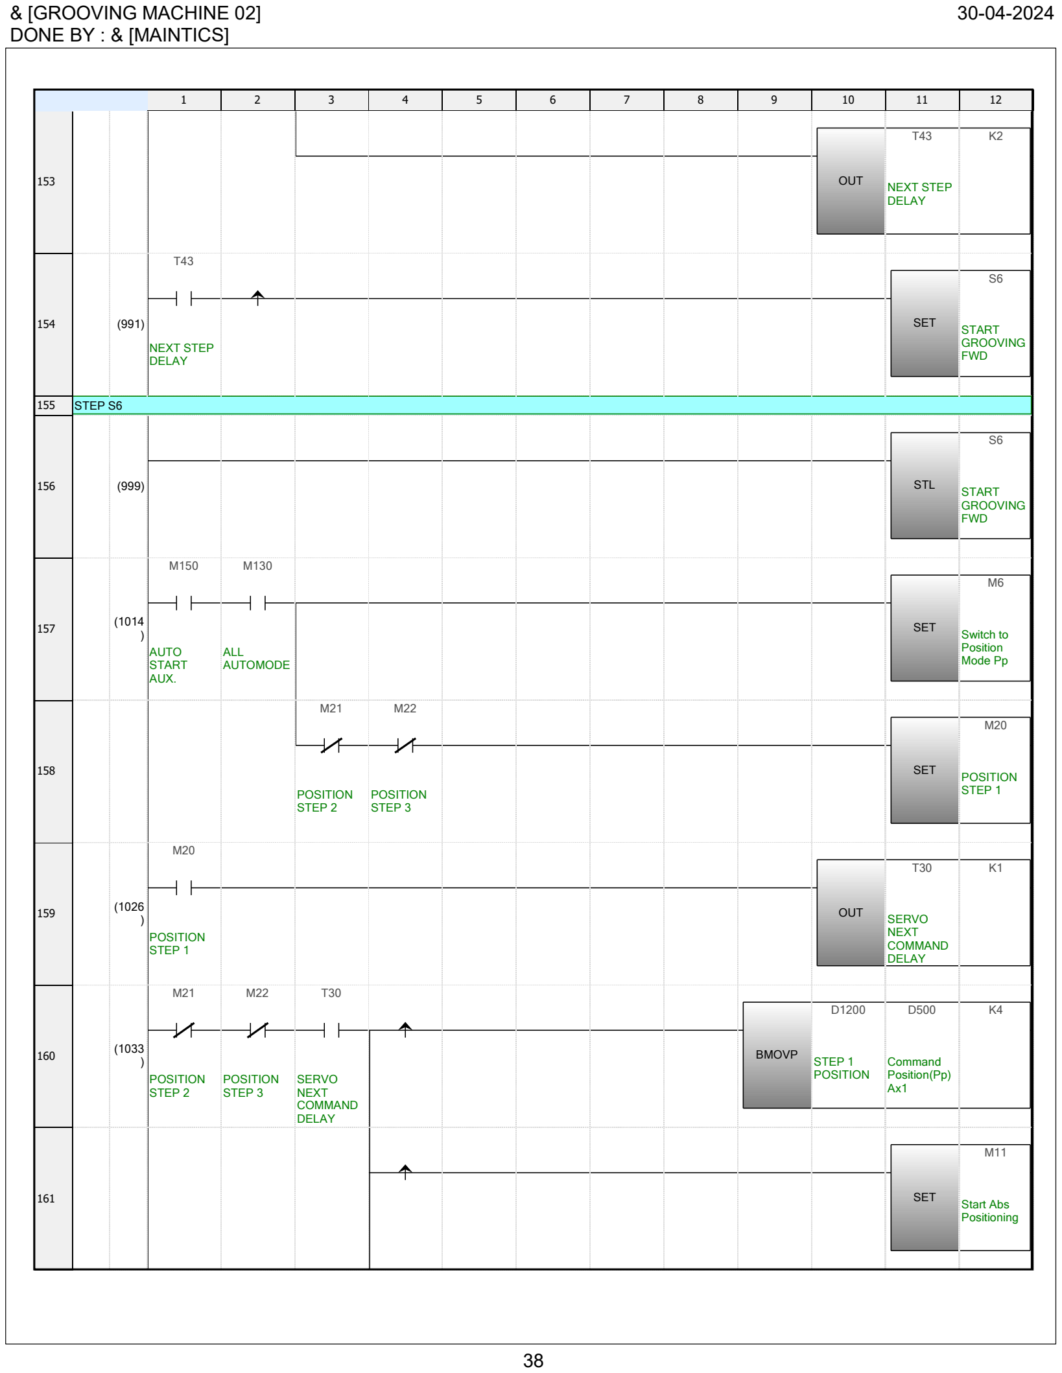
[picture p128: page 38]

38

1 | 2 | 3 | 4 | 5 | 6 | 7 | 8 | 9 | 10 | 11 | 12

153 OUT

T43

NEXT STEP
DELAY

K2

154 (991)

T43

NEXT STEP
DELAY

SET

S6

START
GROOVING
FWD

155 STEP S6

156 | (999) | STL

S6

START
GROOVING
FWD

157 (1014
)

M150

AUTO
START
AUX.

M130

ALL
AUTOMODE

SET

M6

Switch to
Position
Mode Pp

158

M21

POSITION
STEP 2

M22

POSITION
STEP 3

SET

M20

POSITION
STEP 1

159 (1026
)

M20

POSITION
STEP 1

OUT

T30

SERVO
NEXT
COMMAND
DELAY

K1

160 (1033
)

M21

POSITION
STEP 2

M22

POSITION
STEP 3

T30

SERVO
NEXT
COMMAND
DELAY

BMOVP

D1200

STEP 1
POSITION

D500

Command
Position(Pp)
Ax1

K4

161 SET

M11

Start Abs
Positioning

& [GROOVING MACHINE 02] | 30-04-2024

## DONE BY : & [MAINTICS]

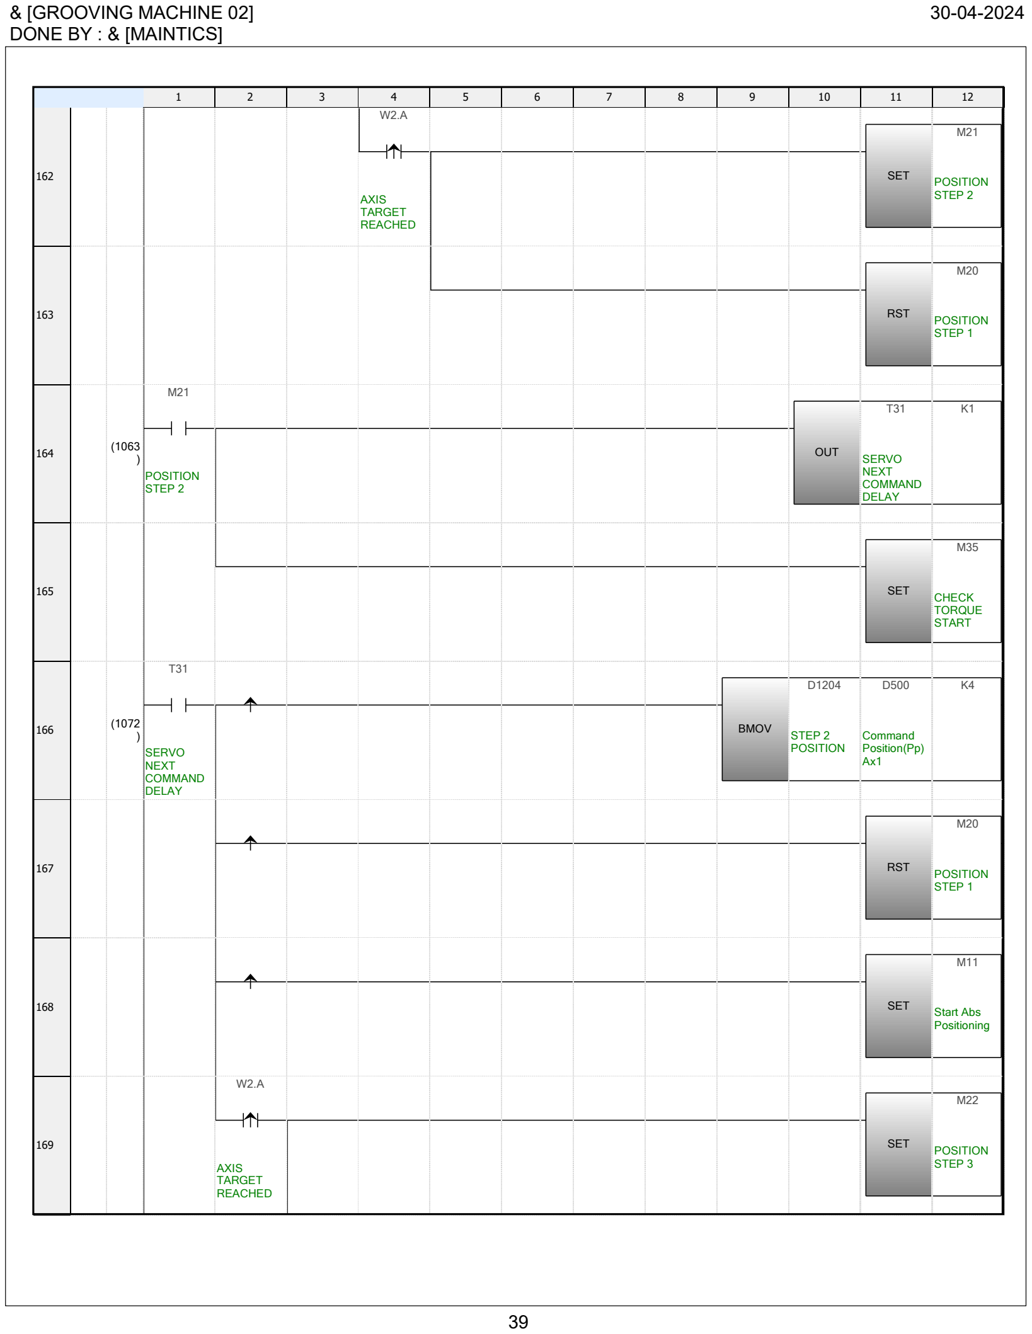
[picture p129: page 39]

39

1 | 2 | 3 | 4 | 5 | 6 | 7 | 8 | 9 | 10 | 11 | 12

162

W2.A

AXIS
TARGET
REACHED

SET

M21

POSITION
STEP 2

163 RST

M20

POSITION
STEP 1

164 (1063
)

)

M21

POSITION
STEP 2

OUT

T31

SERVO
NEXT
COMMAND
DELAY

K1

165 SET

M35

CHECK
TORQUE
START

166 (1072

T31

SERVO
NEXT
COMMAND
DELAY

BMOV

D1204

STEP 2
POSITION

D500

Command
Position(Pp)
Ax1

K4

167 RST

M20

POSITION
STEP 1

168 SET

M11

Start Abs
Positioning

169

W2.A

AXIS
TARGET
REACHED

SET

M22

POSITION
STEP 3

& [GROOVING MACHINE 02] | 30-04-2024

## DONE BY : & [MAINTICS]

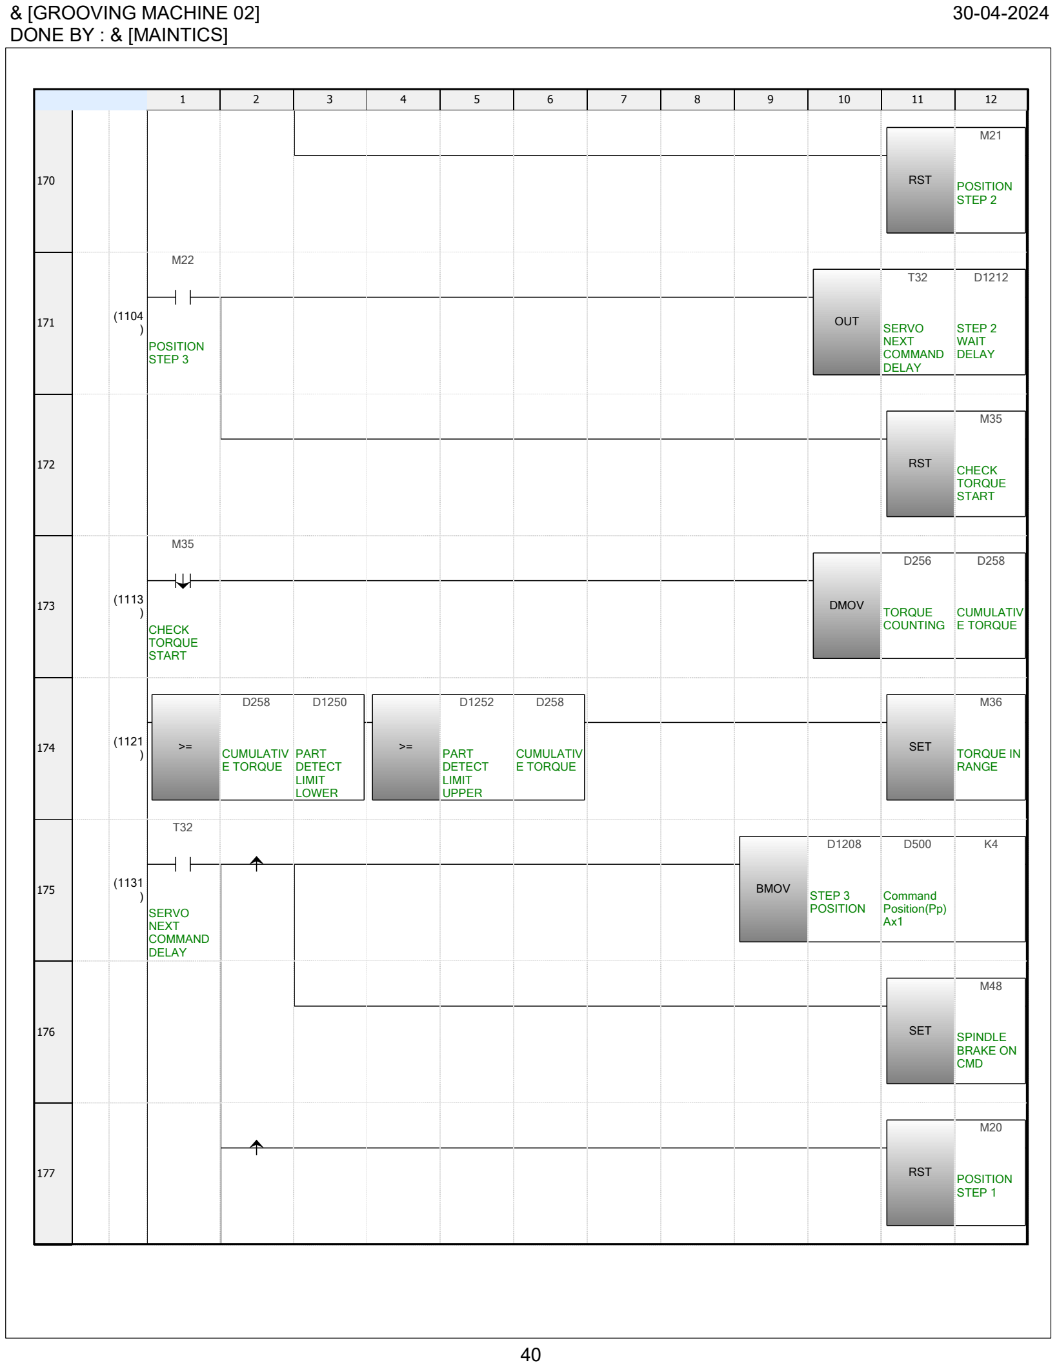
[picture p130: page 40]

40

1 | 2 | 3 | 4 | 5 | 6 | 7 | 8 | 9 | 10 | 11 | 12

170 RST

M21

POSITION
STEP 2

171 (1104

) | M22
) ) | M35

POSITION
STEP 3

OUT

T32

SERVO
NEXT
COMMAND
DELAY

D1212

STEP 2
WAIT
DELAY

172 RST

M35

CHECK
TORQUE
START

173 (1113

CHECK
TORQUE
START

DMOV

D256

TORQUE
COUNTING

D258

CUMULATIV
E TORQUE

174 (1121
>=

D258

CUMULATIV
E TORQUE

D1250

PART
DETECT
LIMIT
LOWER

>=

D1252

PART
DETECT
LIMIT
UPPER

D258

CUMULATIV
E TORQUE

SET

M36

TORQUE IN
RANGE

175 (1131
)

T32

SERVO
NEXT
COMMAND
DELAY

BMOV

D1208

STEP 3
POSITION

D500

Command
Position(Pp)
Ax1

K4

176 SET

M48

SPINDLE
BRAKE ON
CMD

177 RST

M20

POSITION
STEP 1

& [GROOVING MACHINE 02] | 30-04-2024

## DONE BY : & [MAINTICS]

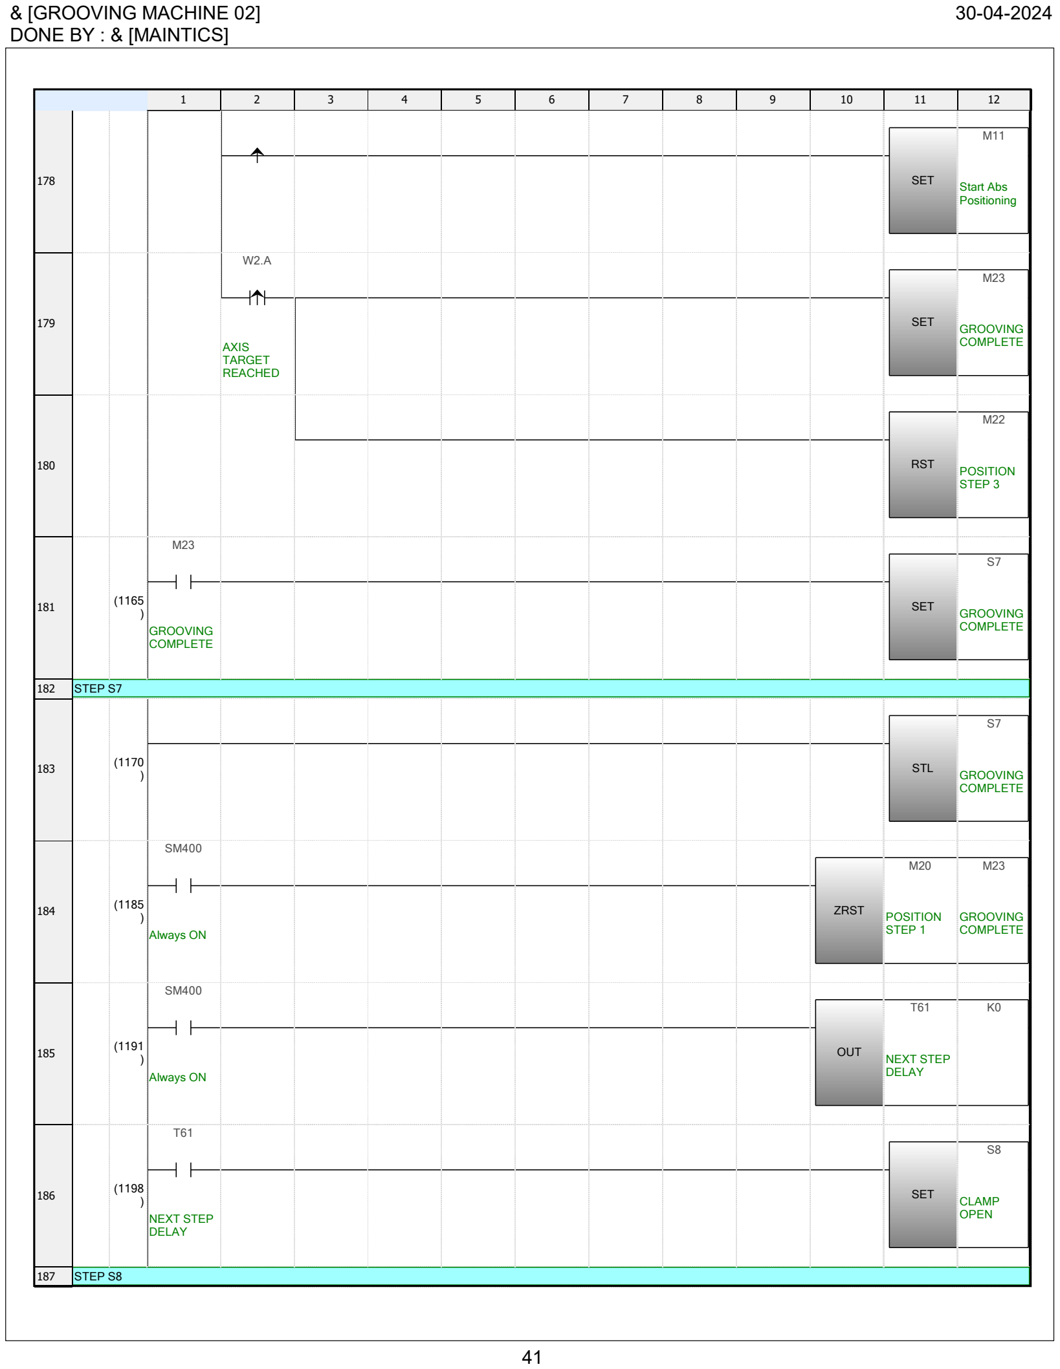
[picture p131: page 41]

41

1 | 2 | 3 | 4 | 5 | 6 | 7 | 8 | 9 | 10 | 11 | 12

178 SET

M11

Start Abs
Positioning

179

W2.A

AXIS
TARGET
REACHED

SET

M23

GROOVING
COMPLETE

180 RST

M22

POSITION
STEP 3

181 (1165
)

M23

GROOVING
COMPLETE

SET

S7

GROOVING
COMPLETE

182 STEP S7

183 (1170
)

STL

S7

GROOVING
COMPLETE

184 (1185
)

SM400

Always ON

ZRST

M20

POSITION
STEP 1

M23

GROOVING
COMPLETE

185 (1191
)

SM400

Always ON

OUT

T61

NEXT STEP
DELAY

K0

186 (1198
)

T61

NEXT STEP
DELAY

SET

S8

CLAMP
OPEN

187 STEP S8

& [GROOVING MACHINE 02] | 30-04-2024

## DONE BY : & [MAINTICS]

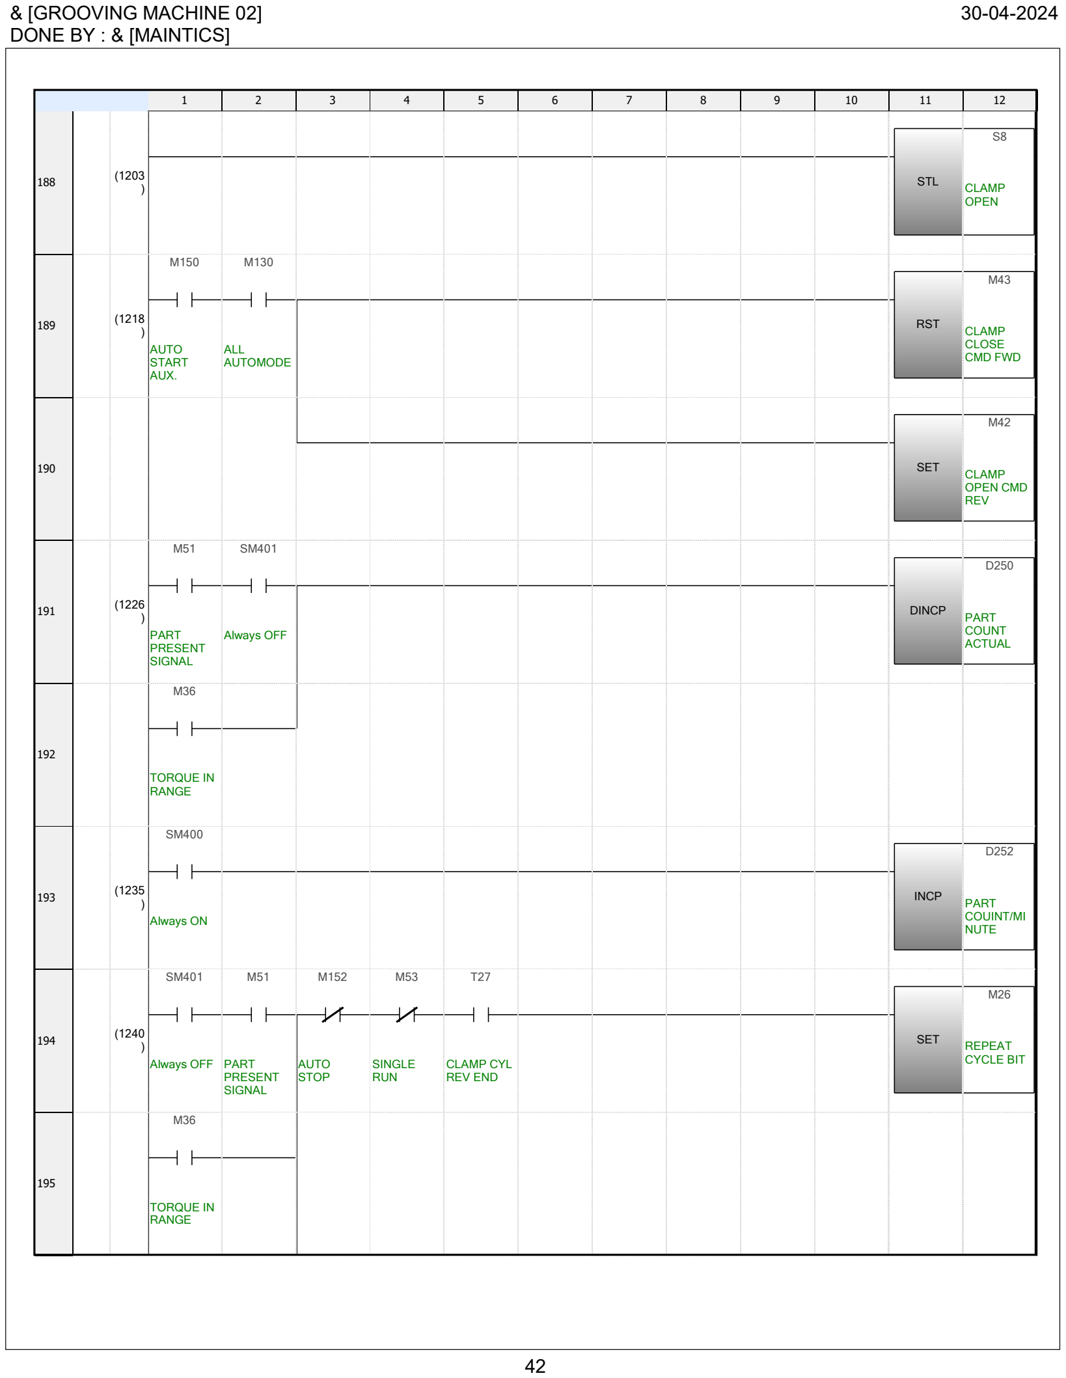
[picture p132: page 42]

42

1 | 2 | 3 | 4 | 5 | 6 | 7 | 8 | 9 | 10 | 11 | 12

188 (1203
) )

STL

S8

CLAMP
OPEN

189 (1218

M150 M130

| ) | M51 SM401

AUTO
START
AUX.

ALL
AUTOMODE

RST

M43

CLAMP
CLOSE
CMD FWD

190 SET

M42

CLAMP
OPEN CMD
REV

191 (1226

PART
PRESENT
SIGNAL

Always OFF

DINCP

D250

PART
COUNT
ACTUAL

192

M36

TORQUE IN
RANGE

193 (1235
)

SM400

Always ON

INCP

D252

PART
COUINT/MI
NUTE

194 (1240
)

SM401

Always OFF

M51

PART
PRESENT
SIGNAL

M152

AUTO
STOP

M53

SINGLE
RUN

T27

CLAMP CYL
REV END

SET

M26

REPEAT
CYCLE BIT

195

M36

TORQUE IN
RANGE

& [GROOVING MACHINE 02] | 30-04-2024

## DONE BY : & [MAINTICS]

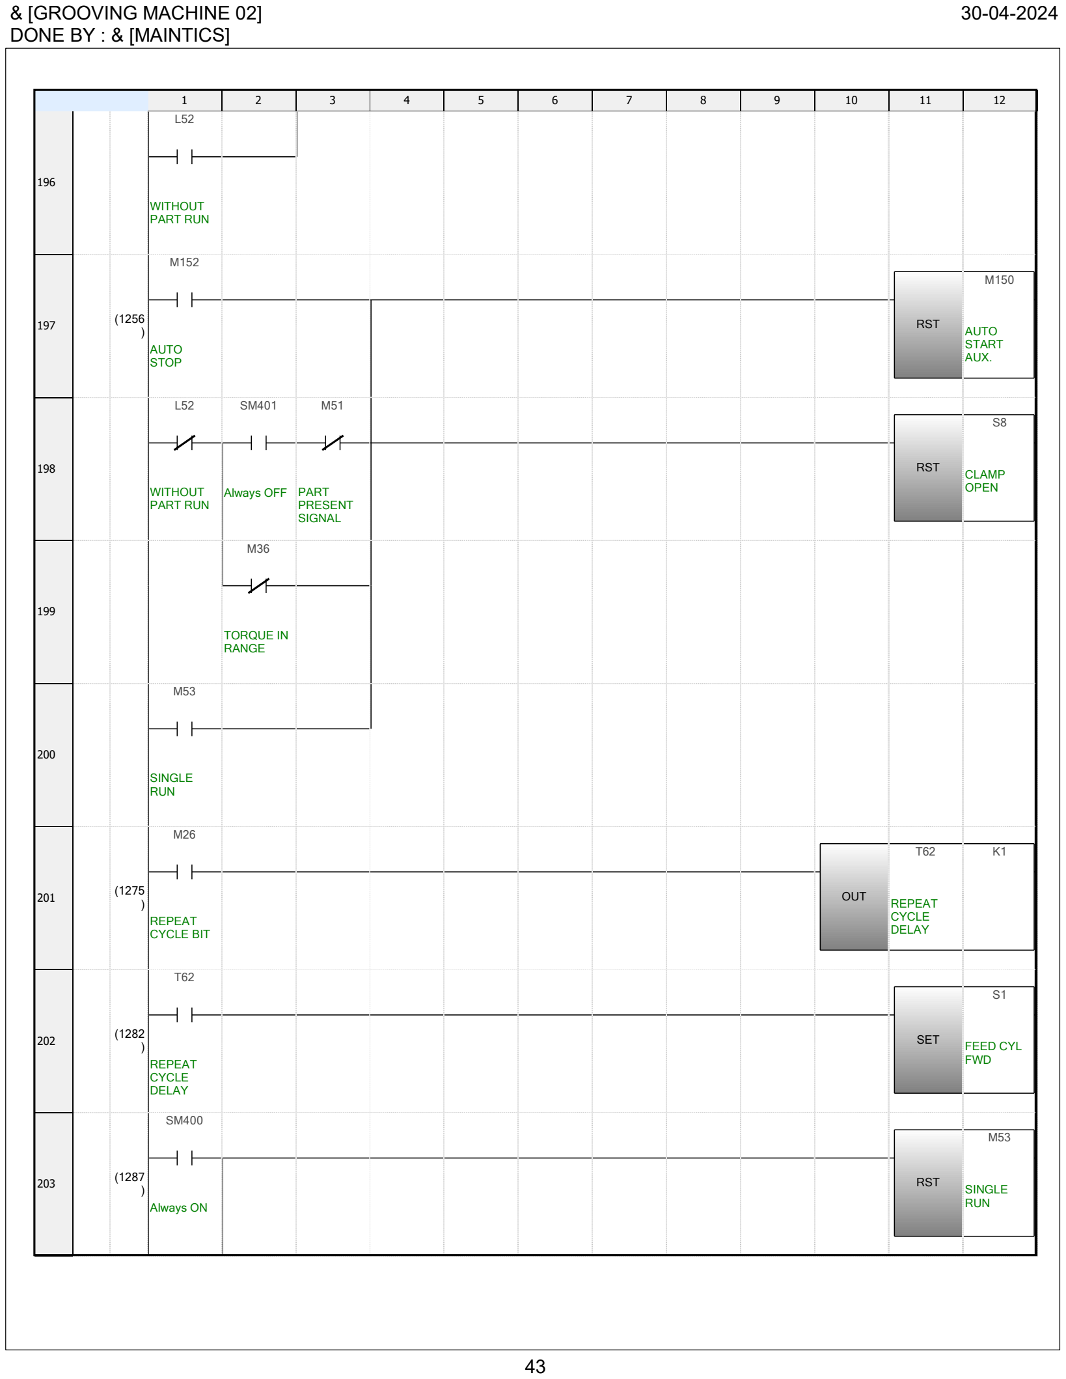
[picture p133: page 43]

43

1 | 2 | 3 | 4 | 5 | 6 | 7 | 8 | 9 | 10 | 11 | 12

196

L52

WITHOUT
PART RUN

197 (1256

) | M152
| M53

AUTO
STOP

RST

M150

AUTO
START
AUX.

198

L52

WITHOUT
PART RUN

SM401

Always OFF

M51

PART
PRESENT
SIGNAL

RST

S8

CLAMP
OPEN

199

M36

TORQUE IN
RANGE

200

SINGLE
RUN

201 (1275
)

M26

REPEAT
CYCLE BIT

OUT

T62

REPEAT
CYCLE
DELAY

K1

202 (1282
)

T62

REPEAT
CYCLE
DELAY

SET

S1

FEED CYL
FWD

203 (1287
)

SM400

Always ON

RST

M53

SINGLE
RUN

& [GROOVING MACHINE 02] | 30-04-2024

## DONE BY : & [MAINTICS]

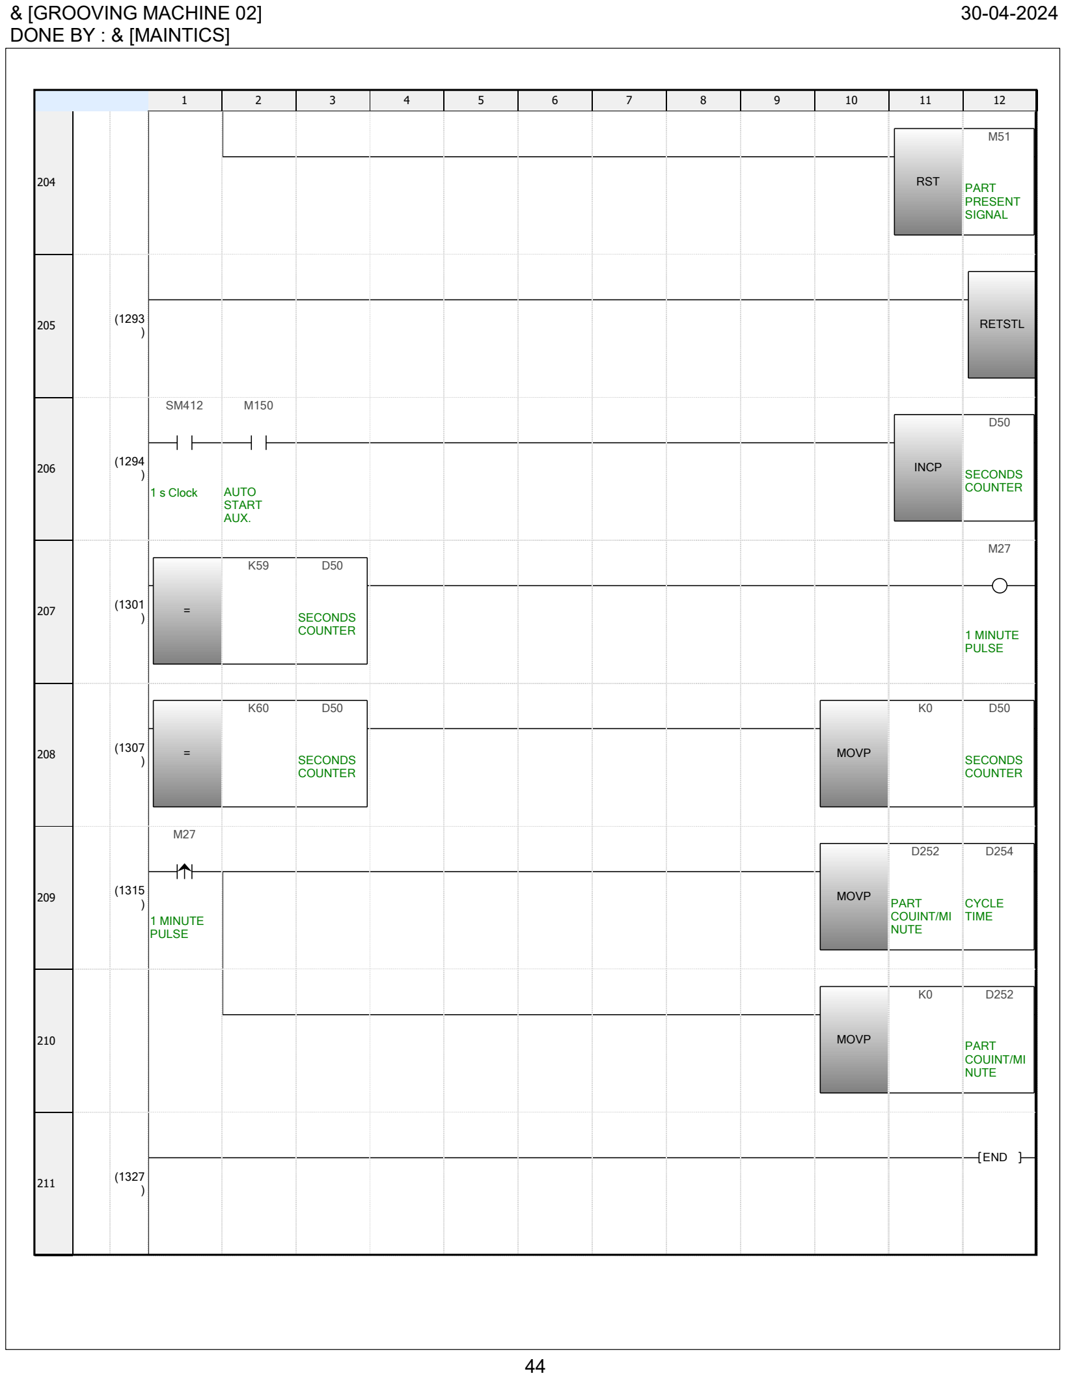
[picture p134: page 44]

44

1 | 2 | 3 | 4 | 5 | 6 | 7 | 8 | 9 | 10 | 11 | 12

204 RST

M51

PART
PRESENT
SIGNAL

205 (1293
) )

) )

RETSTL

206 (1294

SM412

### 1 s Clock

M150

AUTO
START
AUX.

INCP

D50

SECONDS
COUNTER

207 (1301
=
K59 | D50

SECONDS
COUNTER

M27

### 1 MINUTE

PULSE

208 (1307
=
K60 | D50

SECONDS
COUNTER

MOVP

K0 | D50

SECONDS
COUNTER

209 (1315
)

M27

### 1 MINUTE

PULSE

MOVP

D252

PART
COUINT/MI
NUTE

D254

CYCLE
TIME

210 MOVP

K0 | D252

PART
COUINT/MI
NUTE

211 (1327
)

END
