amandalal143/github-demo-noval/Grooving Servo Machine/4. Drawing and Manual/PAROGRAM PRINT.pdf

& [GROOVING MACHINE 02] | 30-04-2024

## DONE BY : & [MAINTICS]

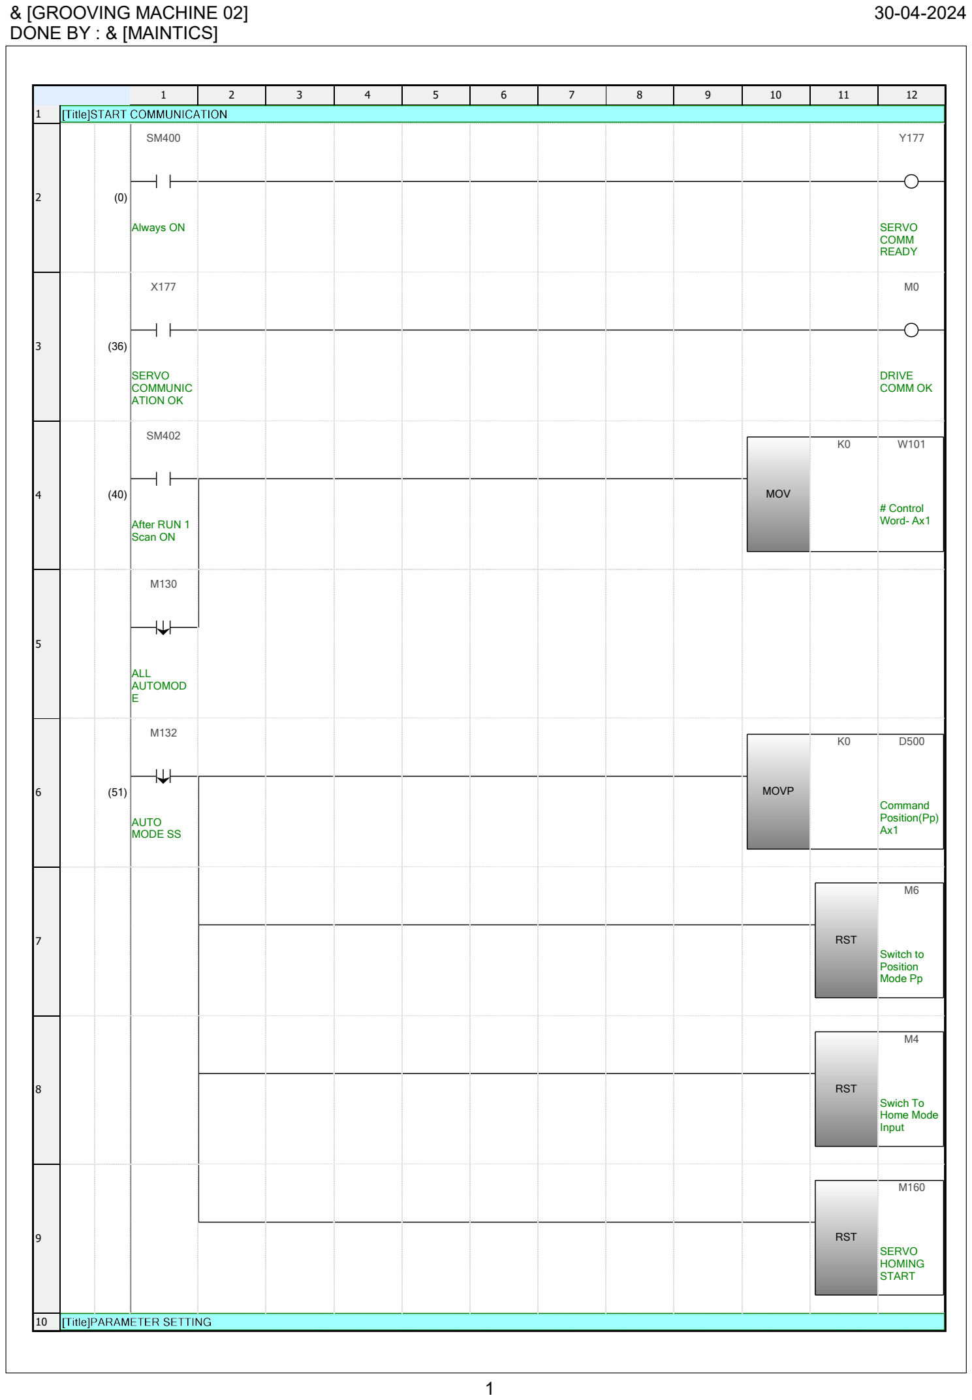
[picture p135: page 1]

1

1 | 2 | 3 | 4 | 5 | 6 | 7 | 8 | 9 | 10 | 11 | 12
1

2 (0)

SM400

Always ON

Y177

SERVO
COMM
READY

3 (36)

X177

SERVO
COMMUNIC
ATION OK

M0

DRIVE
COMM OK

4 (40)

SM402

After RUN 1
Scan ON

MOV

K0 | W101

# Control

Word- Ax1

5

M130

ALL
AUTOMOD
E

6 (51)

M132

AUTO
MODE SS

MOVP

K0 | D500

Command
Position(Pp)
Ax1

### 7 RST

M6

Switch to
Position
Mode Pp

### 8 RST

M4

Swich To
Home Mode
Input

### 9 RST

M160

SERVO
HOMING
START

10

& [GROOVING MACHINE 02] | 30-04-2024

## DONE BY : & [MAINTICS]

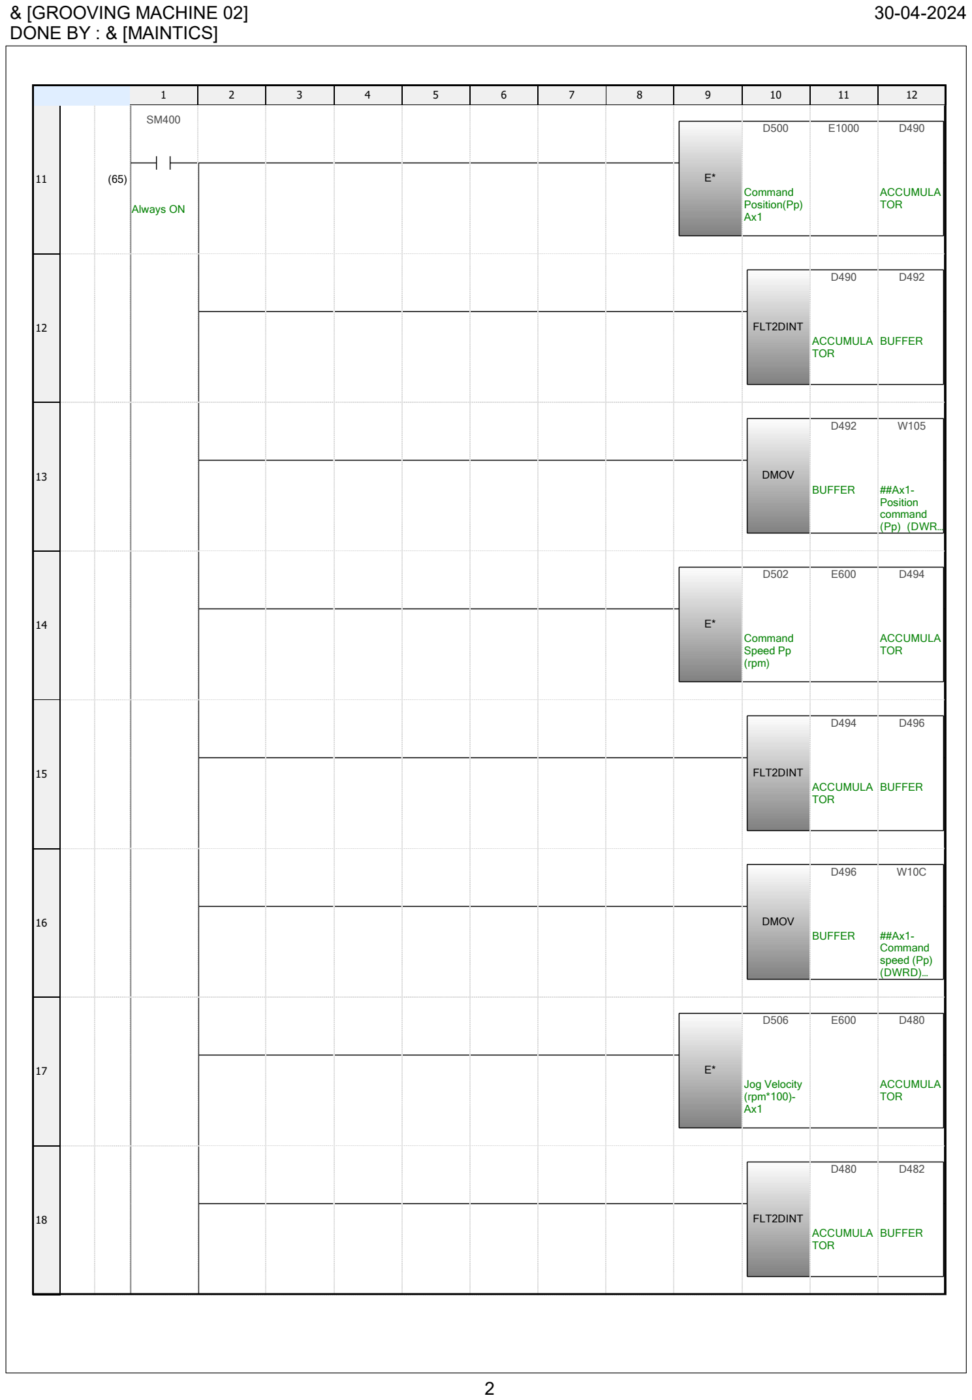
[picture p136: page 2]

2

1 | 2 | 3 | 4 | 5 | 6 | 7 | 8 | 9 | 10 | 11 | 12

11 (65)

SM400

Always ON

E*

D500

Command
Position(Pp)
Ax1
E1000 | D490

ACCUMULA
TOR

### 12 FLT2DINT

D490

ACCUMULA
TOR

D492

BUFFER

### 13 DMOV

D492

BUFFER

W105

##Ax1-

Position
command
(Pp) (DWR…

### 14 E*

D502

Command
Speed Pp
(rpm)
E600 | D494

ACCUMULA
TOR

### 15 FLT2DINT

D494

ACCUMULA
TOR

D496

BUFFER

### 16 DMOV

D496

BUFFER

W10C

##Ax1-

Command
speed (Pp)
(DWRD)…

### 17 E*

D506

Jog Velocity
(rpm*100)-
Ax1
E600 | D480

ACCUMULA
TOR

### 18 FLT2DINT

D480

ACCUMULA
TOR

D482

BUFFER

& [GROOVING MACHINE 02] | 30-04-2024

## DONE BY : & [MAINTICS]

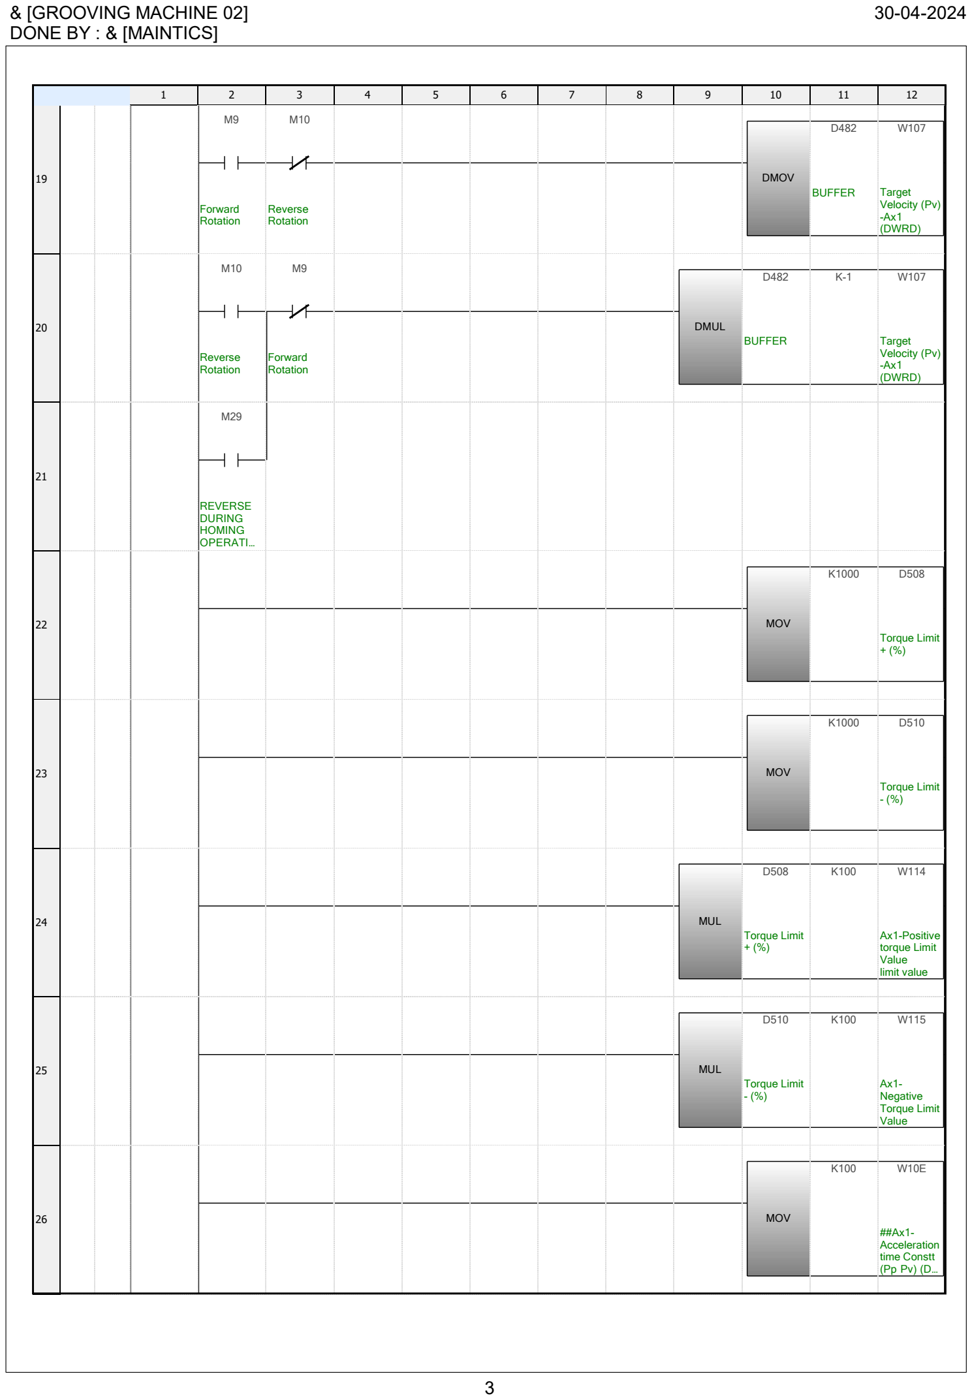
[picture p137: page 3]

3

1 | 2 | 3 | 4 | 5 | 6 | 7 | 8 | 9 | 10 | 11 | 12

19

M9

Forward
Rotation

M10

Reverse
Rotation

DMOV

D482

BUFFER

W107

Target
Velocity (Pv)
-Ax1
(DWRD)

20

M10

Reverse
Rotation

M9

Forward
Rotation

DMUL

D482

BUFFER

K-1 | W107

Target
Velocity (Pv)
-Ax1
(DWRD)

21

M29

REVERSE
DURING
HOMING
OPERATI…

### 22 MOV

K1000 | D508

Torque Limit
+ (%)

### 23 MOV

K1000 | D510

Torque Limit
- (%)

### 24 MUL

D508

Torque Limit
+ (%)
K100 | W114

Ax1-Positive
torque Limit
Value
limit value

### 25 MUL

D510

Torque Limit
- (%)
K100 | W115

Ax1-
Negative
Torque Limit
Value

### 26 MOV

K100 | W10E

##Ax1-

Acceleration
time Constt
(Pp Pv) (D…

& [GROOVING MACHINE 02] | 30-04-2024

## DONE BY : & [MAINTICS]

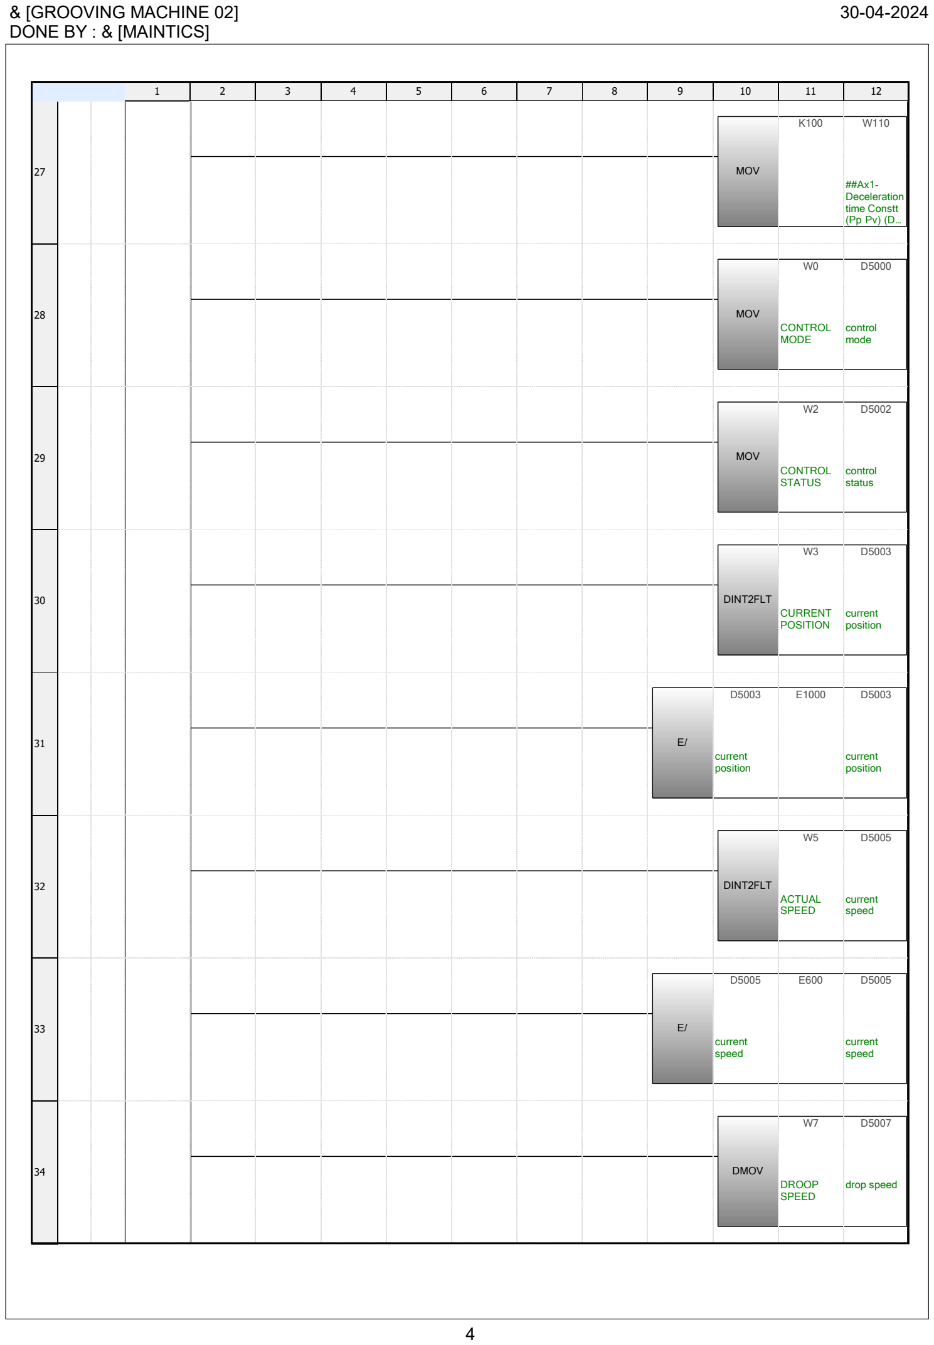
[picture p138: page 4]

4

1 | 2 | 3 | 4 | 5 | 6 | 7 | 8 | 9 | 10 | 11 | 12

### 27 MOV

K100 | W110

##Ax1-

Deceleration
time Constt
(Pp Pv) (D…

### 28 MOV

W0

CONTROL
MODE

D5000

control
mode

### 29 MOV

W2

CONTROL
STATUS

D5002

control
status

### 30 DINT2FLT

W3

CURRENT
POSITION

D5003

current
position

### 31 E/

D5003

current
position
E1000 | D5003

current
position

### 32 DINT2FLT

W5

ACTUAL
SPEED

D5005

current
speed

### 33 E/

D5005

current
speed
E600 | D5005

current
speed

### 34 DMOV

W7

DROOP
SPEED

D5007

drop speed

& [GROOVING MACHINE 02] | 30-04-2024

## DONE BY : & [MAINTICS]

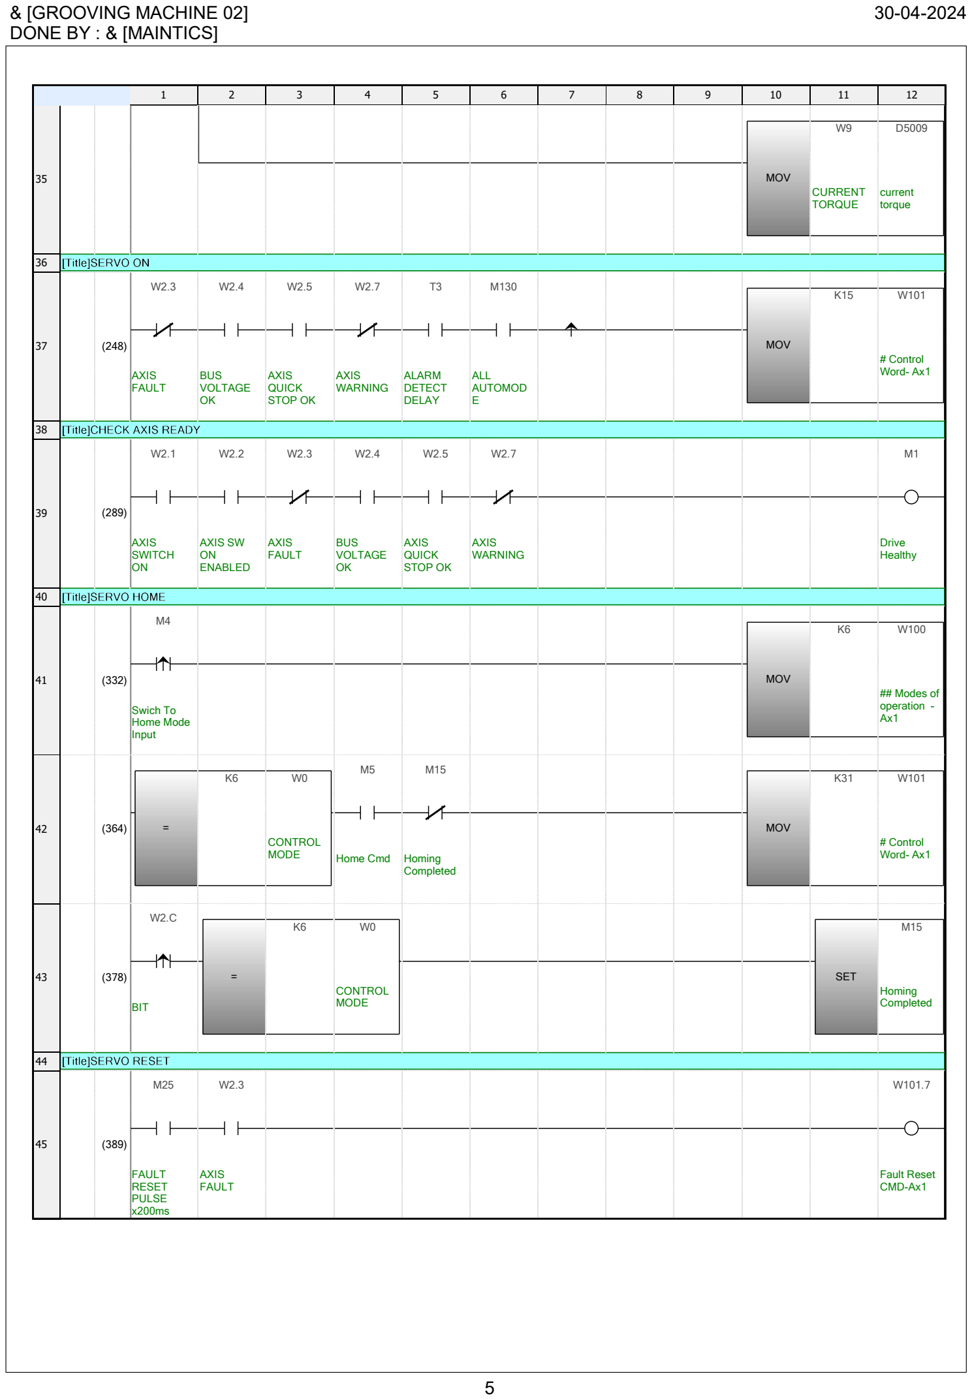
[picture p139: page 5]

5

1 | 2 | 3 | 4 | 5 | 6 | 7 | 8 | 9 | 10 | 11 | 12

### 35 MOV

W9

CURRENT
TORQUE

D5009

current
torque

36

37 (248)

W2.3

AXIS
FAULT

W2.4

BUS
VOLTAGE
OK

W2.5

AXIS
QUICK
STOP OK

W2.7

AXIS
WARNING

T3

ALARM
DETECT
DELAY

M130

ALL
AUTOMOD
E

MOV

K15 | W101

# Control

Word- Ax1

38

39 (289)

W2.1

AXIS
SWITCH
ON

W2.2

AXIS SW
ON
ENABLED

W2.3

AXIS
FAULT

W2.4

BUS
VOLTAGE
OK

W2.5

AXIS
QUICK
STOP OK

W2.7

AXIS
WARNING

M1

Drive
Healthy

40

41 (332)

M4

Swich To
Home Mode
Input

MOV

K6 | W100

## Modes of

operation -
Ax1
42 | (364) | =
K6 | W0

CONTROL
MODE

M5

Home Cmd

M15

Homing
Completed

MOV

K31 | W101

# Control

Word- Ax1

43 (378)

W2.C

BIT

=

K6 | W0

CONTROL
MODE

SET

M15

Homing
Completed

44

45 (389)

M25

FAULT
RESET
PULSE
x200ms

W2.3

AXIS
FAULT

W101.7

Fault Reset
CMD-Ax1

& [GROOVING MACHINE 02] | 30-04-2024

## DONE BY : & [MAINTICS]

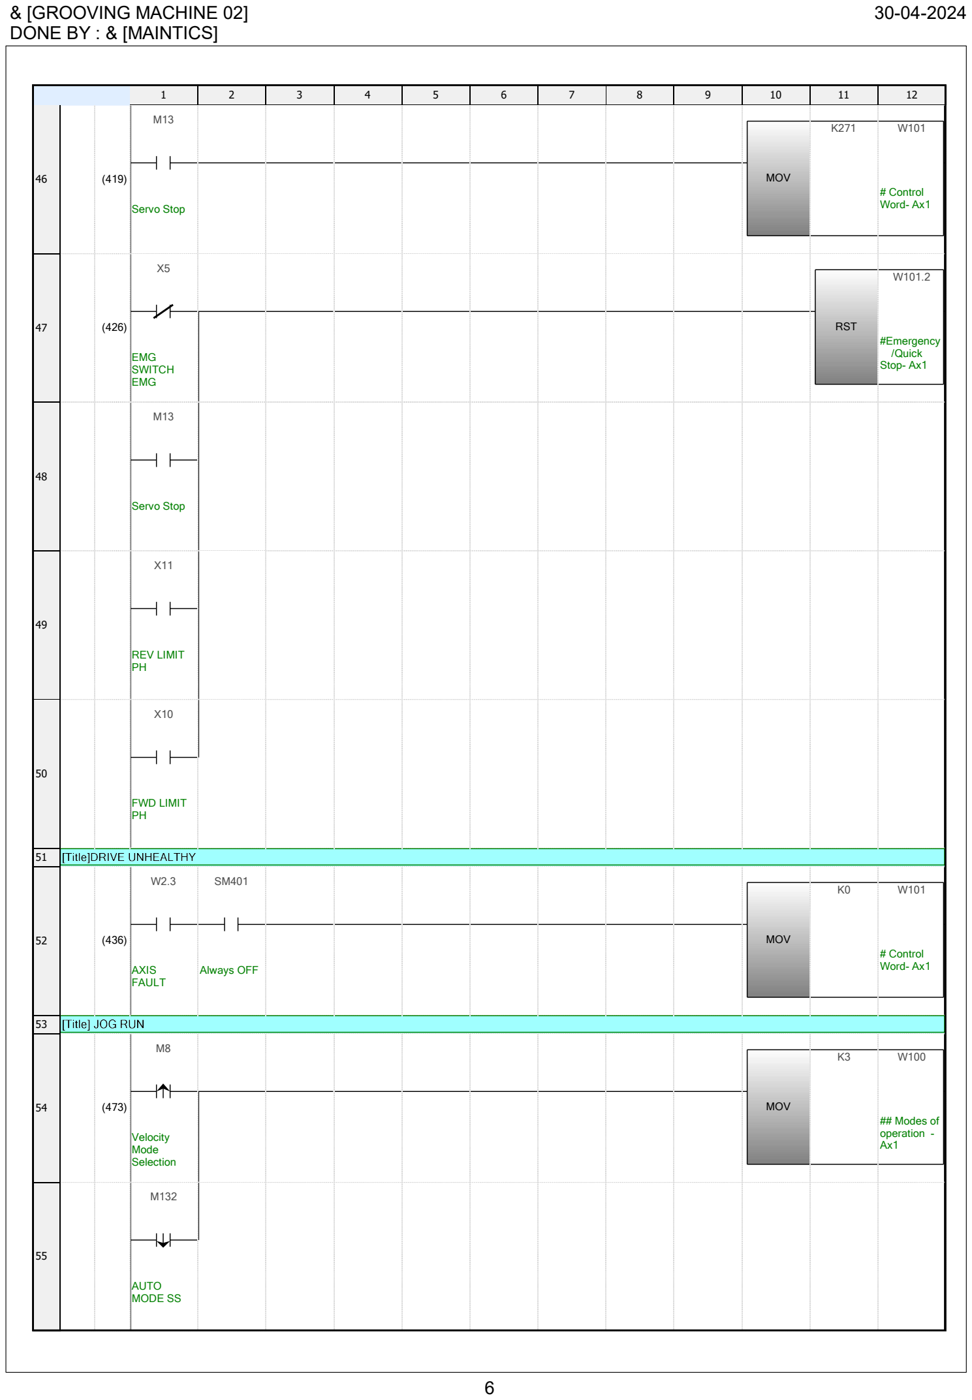
[picture p140: page 6]

6

1 | 2 | 3 | 4 | 5 | 6 | 7 | 8 | 9 | 10 | 11 | 12

46 (419)

M13

Servo Stop

MOV

K271 | W101

# Control

Word- Ax1

47 (426)

X5

EMG
SWITCH
EMG

RST

W101.2

#Emergency

/Quick
Stop- Ax1

48

M13

Servo Stop

49

X11

REV LIMIT
PH

50

X10

FWD LIMIT
PH

51

52 (436)

W2.3

AXIS
FAULT

SM401

Always OFF

MOV

K0 | W101

# Control

Word- Ax1

53

54 (473)

M8

Velocity
Mode
Selection

MOV

K3 | W100

## Modes of

operation -
Ax1

55

M132

AUTO
MODE SS

& [GROOVING MACHINE 02] | 30-04-2024

## DONE BY : & [MAINTICS]

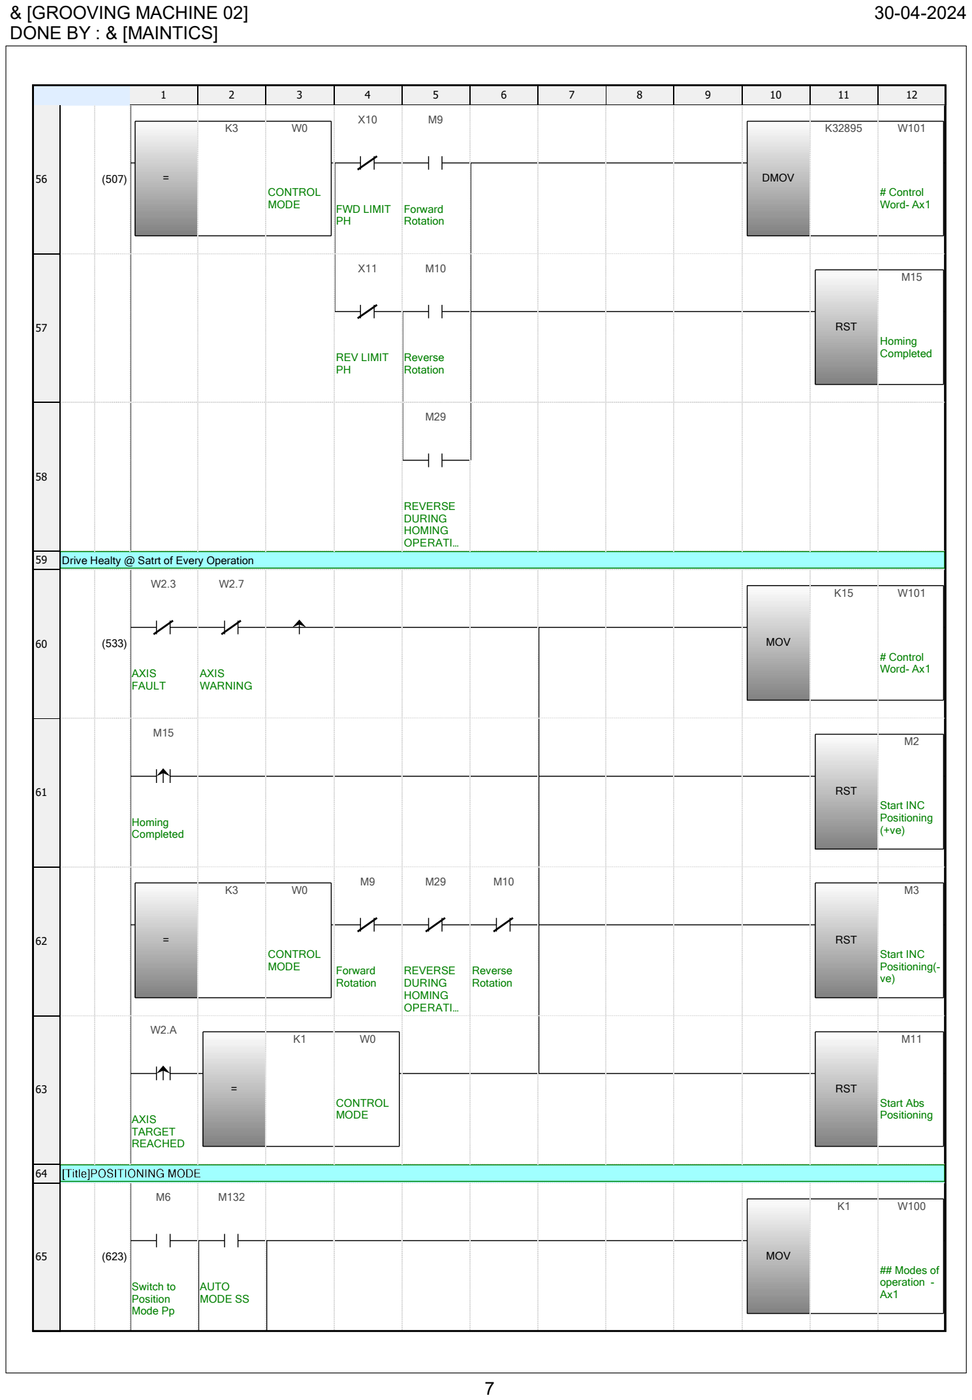
[picture p141: page 7]

7

1 | 2 | 3 | 4 | 5 | 6 | 7 | 8 | 9 | 10 | 11 | 12
56 | (507) | =
K3 | W0

CONTROL
MODE

X10

FWD LIMIT
PH

M9

Forward
Rotation

DMOV

K32895 W101

# Control

Word- Ax1

57

X11

REV LIMIT
PH

M10

Reverse
Rotation

RST

M15

Homing
Completed

58

M29

REVERSE
DURING
HOMING
OPERATI…

### 59 Drive Healty @ Satrt of Every Operation

60 (533)

W2.3

AXIS
FAULT

W2.7

AXIS
WARNING

MOV

K15 | W101

# Control

Word- Ax1

61

M15

Homing
Completed

RST

M2

Start INC
Positioning
(+ve)

62 =

K3 | W0

CONTROL
MODE

M9

Forward
Rotation

M29

REVERSE
DURING
HOMING
OPERATI…

M10

Reverse
Rotation

RST

M3

Start INC
Positioning(-
ve)

63

W2.A

AXIS
TARGET
REACHED

=

K1 | W0

CONTROL
MODE

RST

M11

Start Abs
Positioning

64

65 (623)

M6

Switch to
Position
Mode Pp

M132

AUTO
MODE SS

MOV

K1 | W100

## Modes of

operation -
Ax1

& [GROOVING MACHINE 02] | 30-04-2024

## DONE BY : & [MAINTICS]

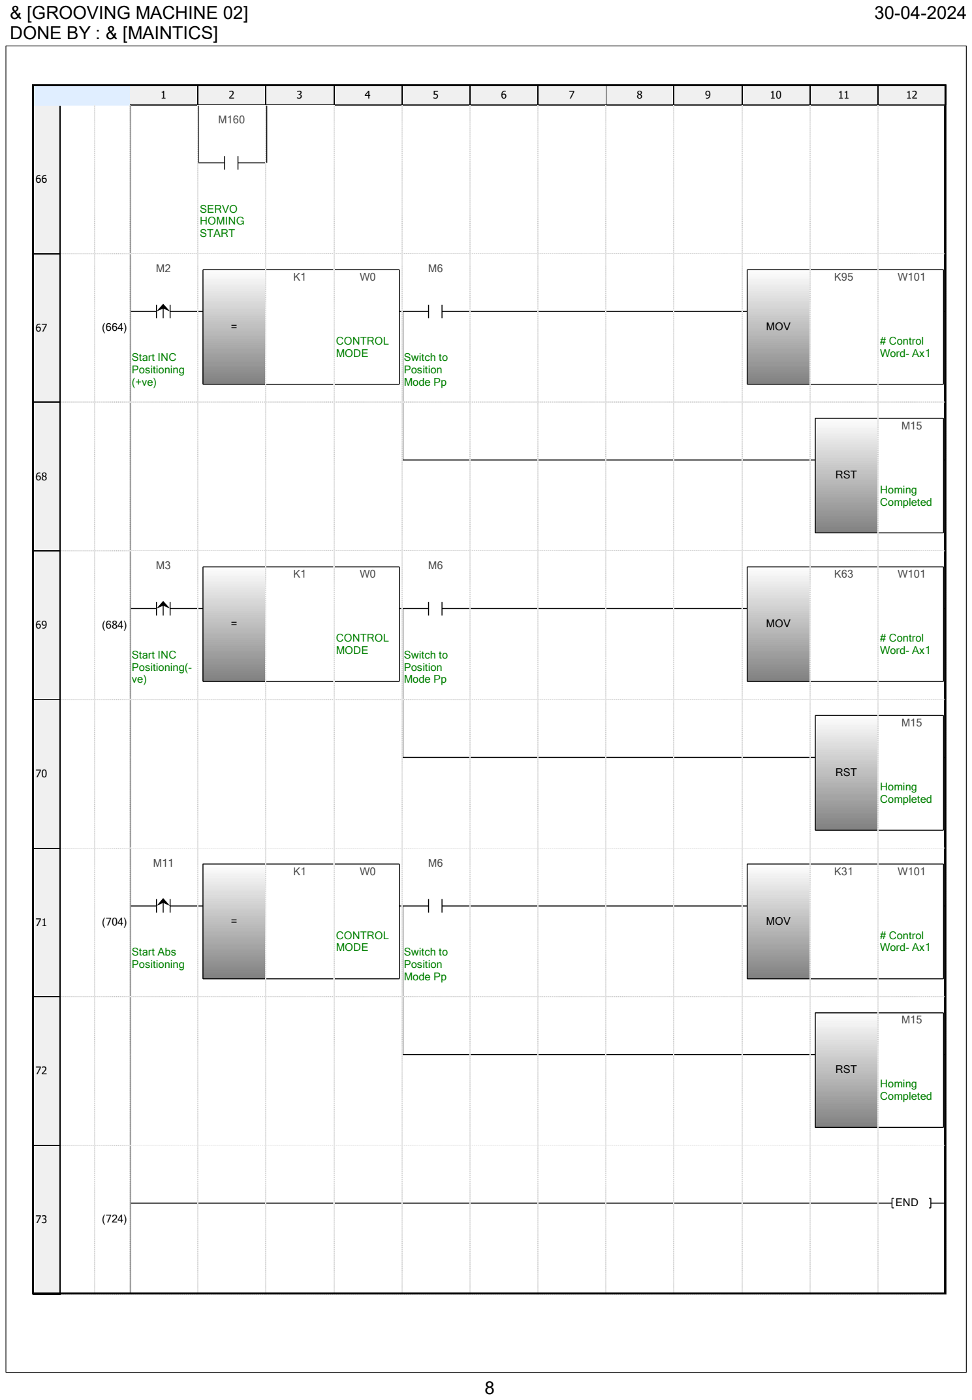
[picture p142: page 8]

8

1 | 2 | 3 | 4 | 5 | 6 | 7 | 8 | 9 | 10 | 11 | 12

66

M160

SERVO
HOMING
START

67 (664)

M2

Start INC
Positioning
(+ve)

=

K1 | W0

CONTROL
MODE

M6

Switch to
Position
Mode Pp

MOV

K95 | W101

# Control

Word- Ax1

### 68 RST

M15

Homing
Completed

69 (684)

M3

Start INC
Positioning(-
ve)

=

K1 | W0

CONTROL
MODE

M6

Switch to
Position
Mode Pp

MOV

K63 | W101

# Control

Word- Ax1

### 70 RST

M15

Homing
Completed

71 (704)

M11

Start Abs
Positioning

=

K1 | W0

CONTROL
MODE

M6

Switch to
Position
Mode Pp

MOV

K31 | W101

# Control

Word- Ax1

### 72 RST

M15

Homing
Completed

73 (724)

END

& [GROOVING MACHINE 02] | 30-04-2024

## DONE BY : & [MAINTICS]

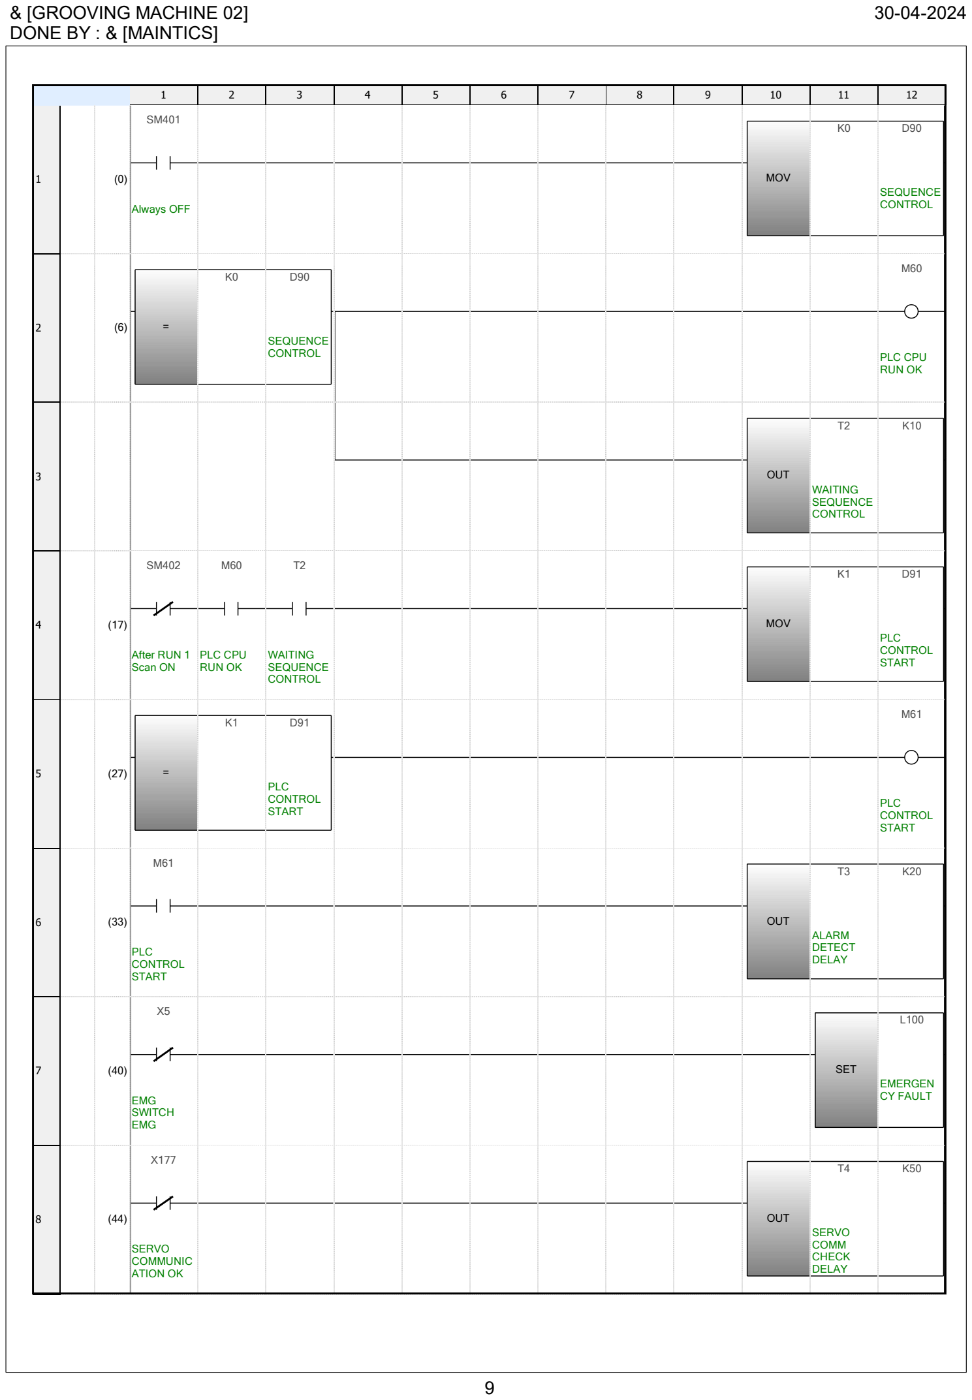
[picture p143: page 9]

9

1 | 2 | 3 | 4 | 5 | 6 | 7 | 8 | 9 | 10 | 11 | 12

1 (0)

SM401

Always OFF

MOV

K0 | D90

SEQUENCE
CONTROL
2 | (6) | =
K0 | D90

SEQUENCE
CONTROL

M60

PLC CPU
RUN OK

### 3 OUT

T2

WAITING
SEQUENCE
CONTROL

K10

4 (17)

SM402

After RUN 1
Scan ON

M60

PLC CPU
RUN OK

T2

WAITING
SEQUENCE
CONTROL

MOV

K1 | D91

PLC
CONTROL
START
5 | (27) | =
K1 | D91

PLC
CONTROL
START

M61

PLC
CONTROL
START

6 (33)

M61

PLC
CONTROL
START

OUT

T3

ALARM
DETECT
DELAY

K20

7 (40)

X5

EMG
SWITCH
EMG

SET

L100

EMERGEN
CY FAULT

8 (44)

X177

SERVO
COMMUNIC
ATION OK

OUT

T4

SERVO
COMM
CHECK
DELAY

K50

& [GROOVING MACHINE 02] | 30-04-2024

## DONE BY : & [MAINTICS]

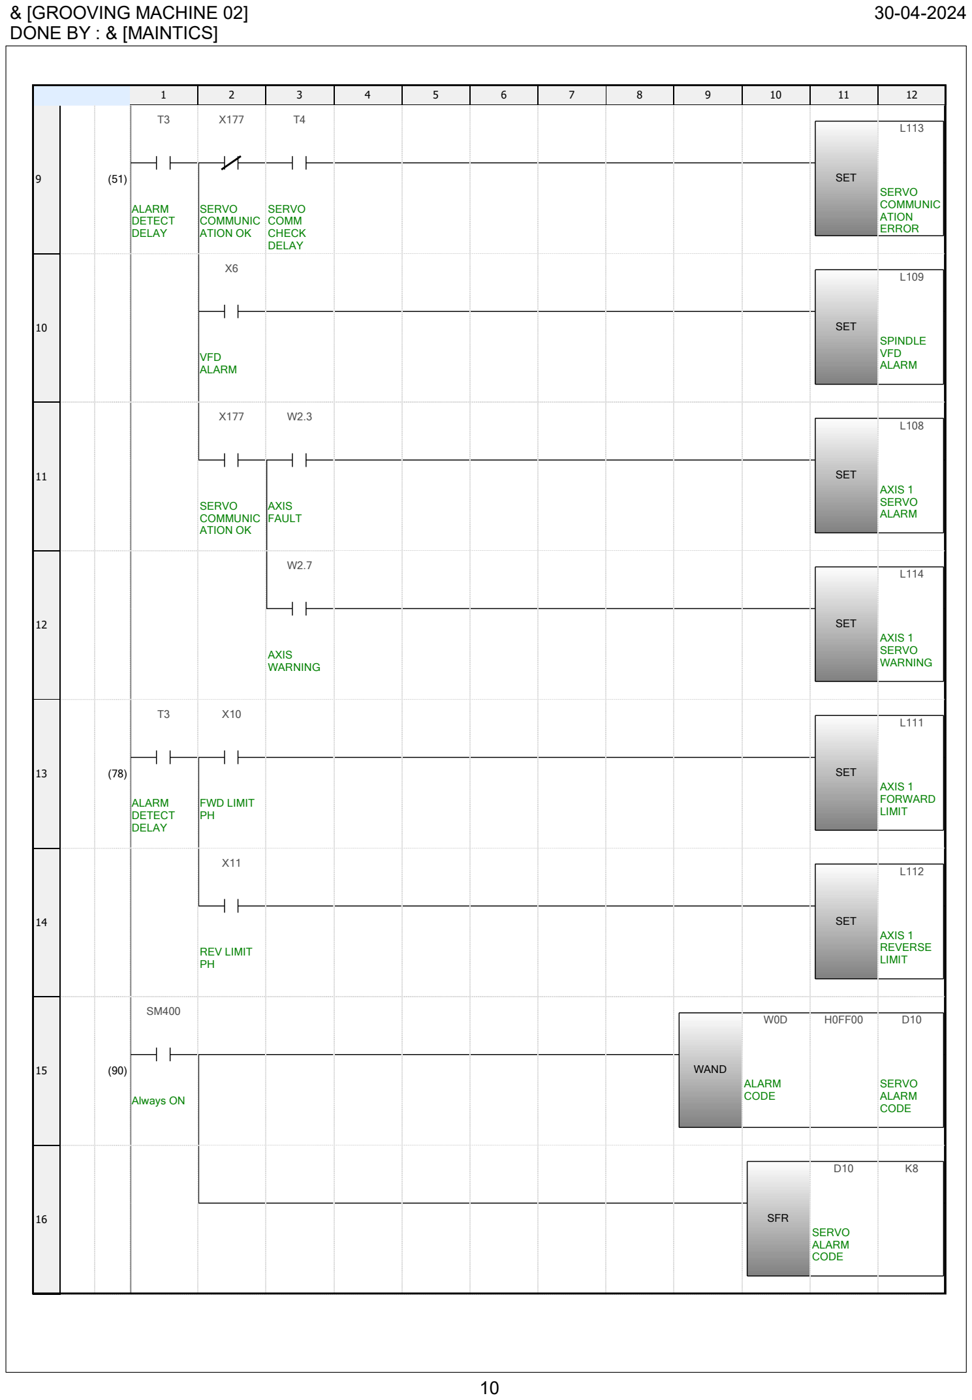
[picture p144: page 10]

10

1 | 2 | 3 | 4 | 5 | 6 | 7 | 8 | 9 | 10 | 11 | 12

9 (51)

T3

ALARM
DETECT
DELAY

X177

SERVO
COMMUNIC
ATION OK

T4

SERVO
COMM
CHECK
DELAY

SET

L113

SERVO
COMMUNIC
ATION
ERROR

10

X6

VFD
ALARM

SET

L109

SPINDLE
VFD
ALARM

11

X177

SERVO
COMMUNIC
ATION OK

W2.3

AXIS
FAULT

SET

L108

AXIS 1
SERVO
ALARM

12

W2.7

AXIS
WARNING

SET

L114

AXIS 1
SERVO
WARNING

13 (78)

T3

ALARM
DETECT
DELAY

X10

FWD LIMIT
PH

SET

L111

AXIS 1
FORWARD
LIMIT

14

X11

REV LIMIT
PH

SET

L112

AXIS 1
REVERSE
LIMIT

15 (90)

SM400

Always ON

WAND

W0D

ALARM
CODE
H0FF00 | D10

SERVO
ALARM
CODE

### 16 SFR

D10

SERVO
ALARM
CODE

K8

& [GROOVING MACHINE 02] | 30-04-2024

## DONE BY : & [MAINTICS]

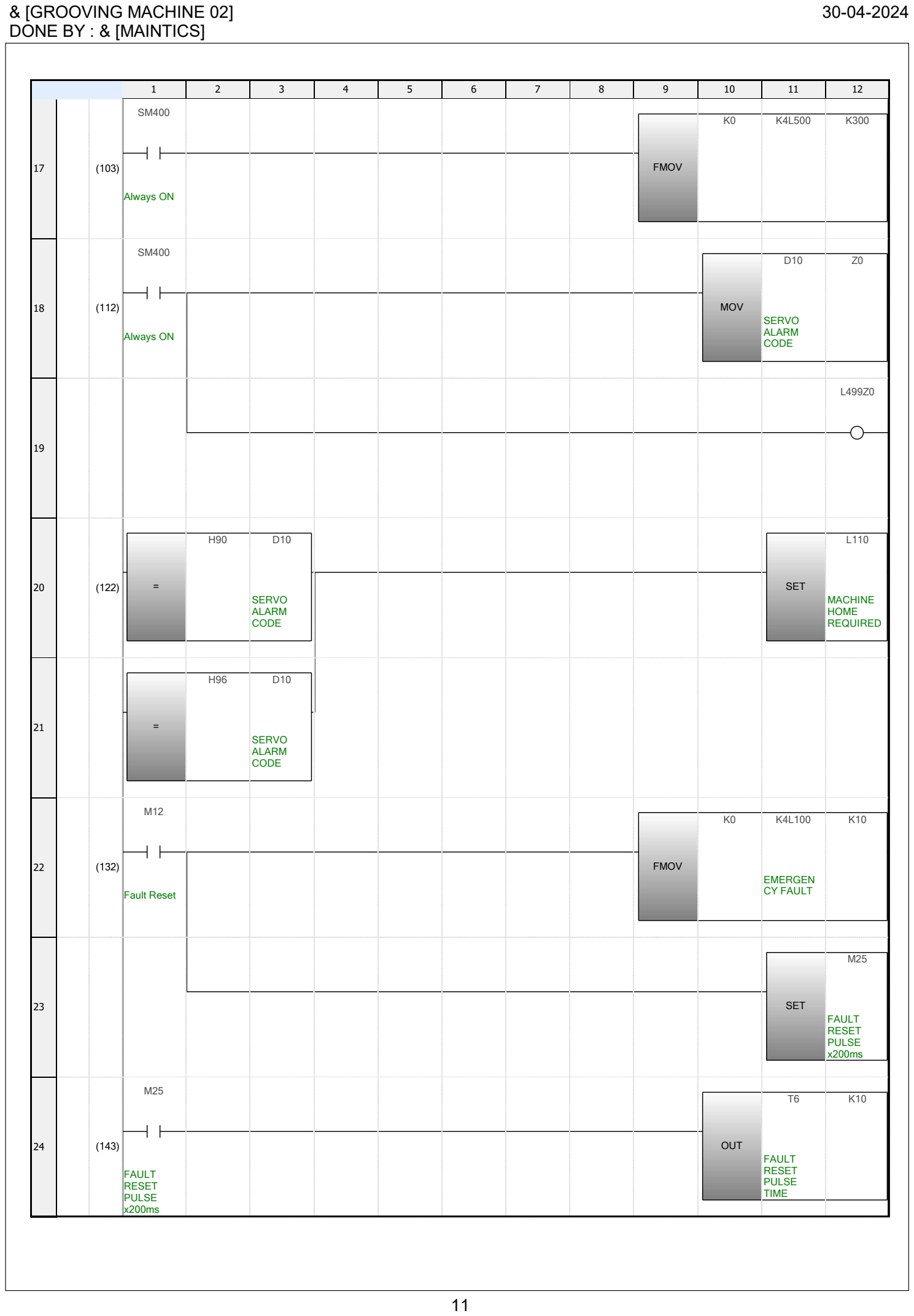
[picture p145: page 11]

11

1 | 2 | 3 | 4 | 5 | 6 | 7 | 8 | 9 | 10 | 11 | 12

17 (103)

SM400

Always ON

FMOV

K0 | K4L500 | K300

18 (112)

SM400

Always ON

MOV

D10

SERVO
ALARM
CODE

Z0

19

L499Z0

20 | (122) | =
H90 | D10

SERVO
ALARM
CODE

SET

L110

MACHINE
HOME
REQUIRED

21 =

H96 | D10

SERVO
ALARM
CODE

22 (132)

M12

Fault Reset

FMOV

K0 | K4L100

EMERGEN
CY FAULT

K10

### 23 SET

M25

FAULT
RESET
PULSE
x200ms

24 (143)

M25

FAULT
RESET
PULSE
x200ms

OUT

T6

FAULT
RESET
PULSE
TIME

K10

& [GROOVING MACHINE 02] | 30-04-2024

## DONE BY : & [MAINTICS]

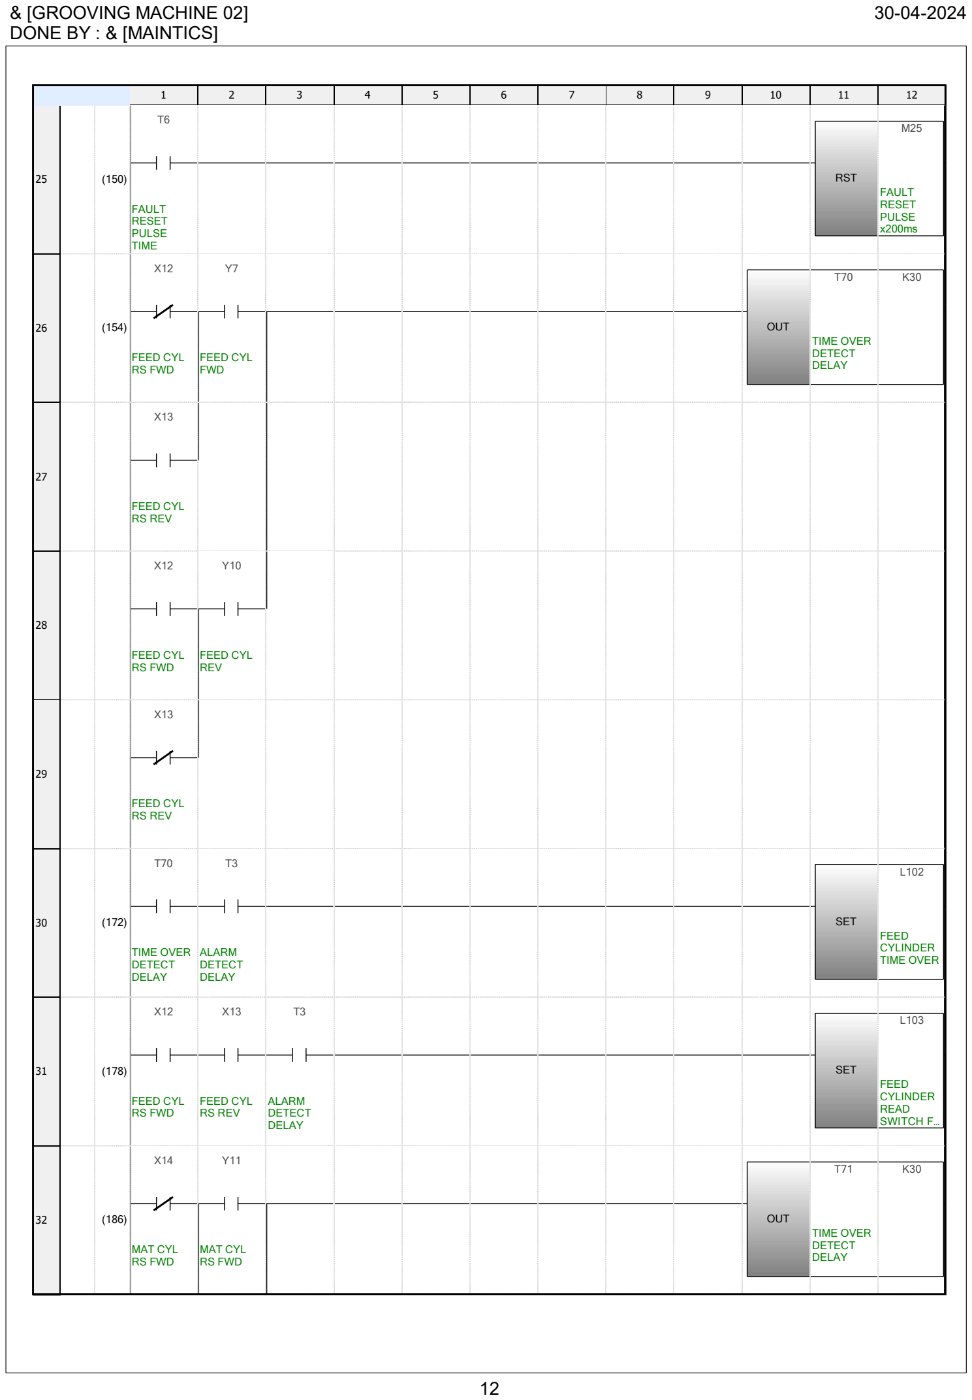
[picture p146: page 12]

12

1 | 2 | 3 | 4 | 5 | 6 | 7 | 8 | 9 | 10 | 11 | 12

25 (150)

T6

FAULT
RESET
PULSE
TIME

RST

M25

FAULT
RESET
PULSE
x200ms

26 (154)

X12

FEED CYL
RS FWD

Y7

FEED CYL
FWD

OUT

T70

TIME OVER
DETECT
DELAY

K30

27

X13

FEED CYL
RS REV

28

X12

FEED CYL
RS FWD

Y10

FEED CYL
REV

29

X13

FEED CYL
RS REV

30 (172)

T70

TIME OVER
DETECT
DELAY

T3

ALARM
DETECT
DELAY

SET

L102

FEED
CYLINDER
TIME OVER

31 (178)

X12

FEED CYL
RS FWD

X13

FEED CYL
RS REV

T3

ALARM
DETECT
DELAY

SET

L103

FEED
CYLINDER
READ
SWITCH F…

32 (186)

X14

MAT CYL
RS FWD

Y11

MAT CYL
RS FWD

OUT

T71

TIME OVER
DETECT
DELAY

K30

& [GROOVING MACHINE 02] | 30-04-2024

## DONE BY : & [MAINTICS]

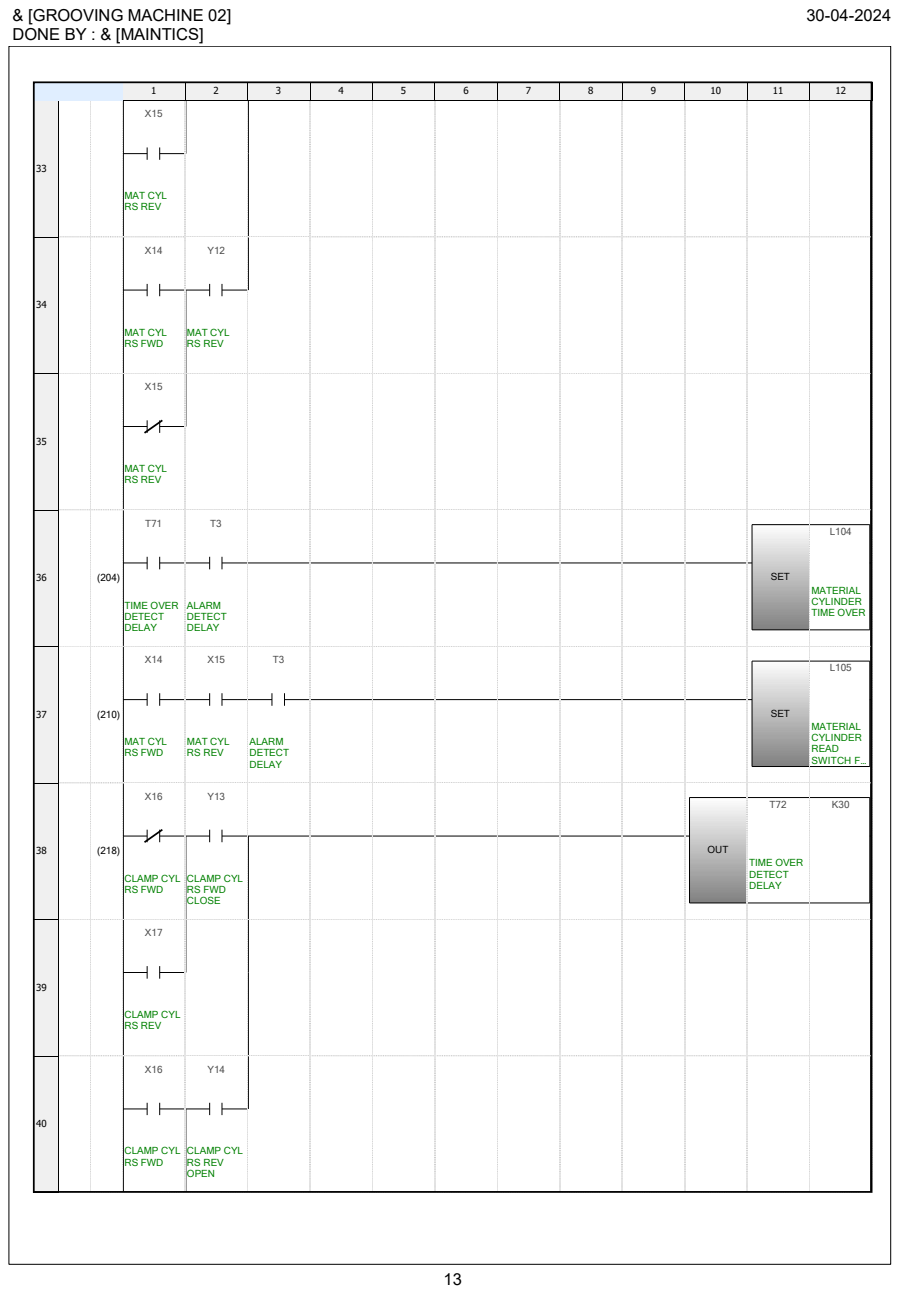
[picture p147: page 13]
MAT CYL RS REV; MAT CYL RS FWD; TIME OVER DETECT DELAY; ALARM DETECT DELAY; SET; MATERIAL CYLINDER TIME OVER; MATERIAL CYLINDER READ SWITCH F…; CLAMP CYL RS FWD; CLAMP CYL RS FWD CLOSE; OUT; CLAMP CYL RS REV; CLAMP CYL RS REV OPEN

& [GROOVING MACHINE 02] | 30-04-2024

## DONE BY : & [MAINTICS]

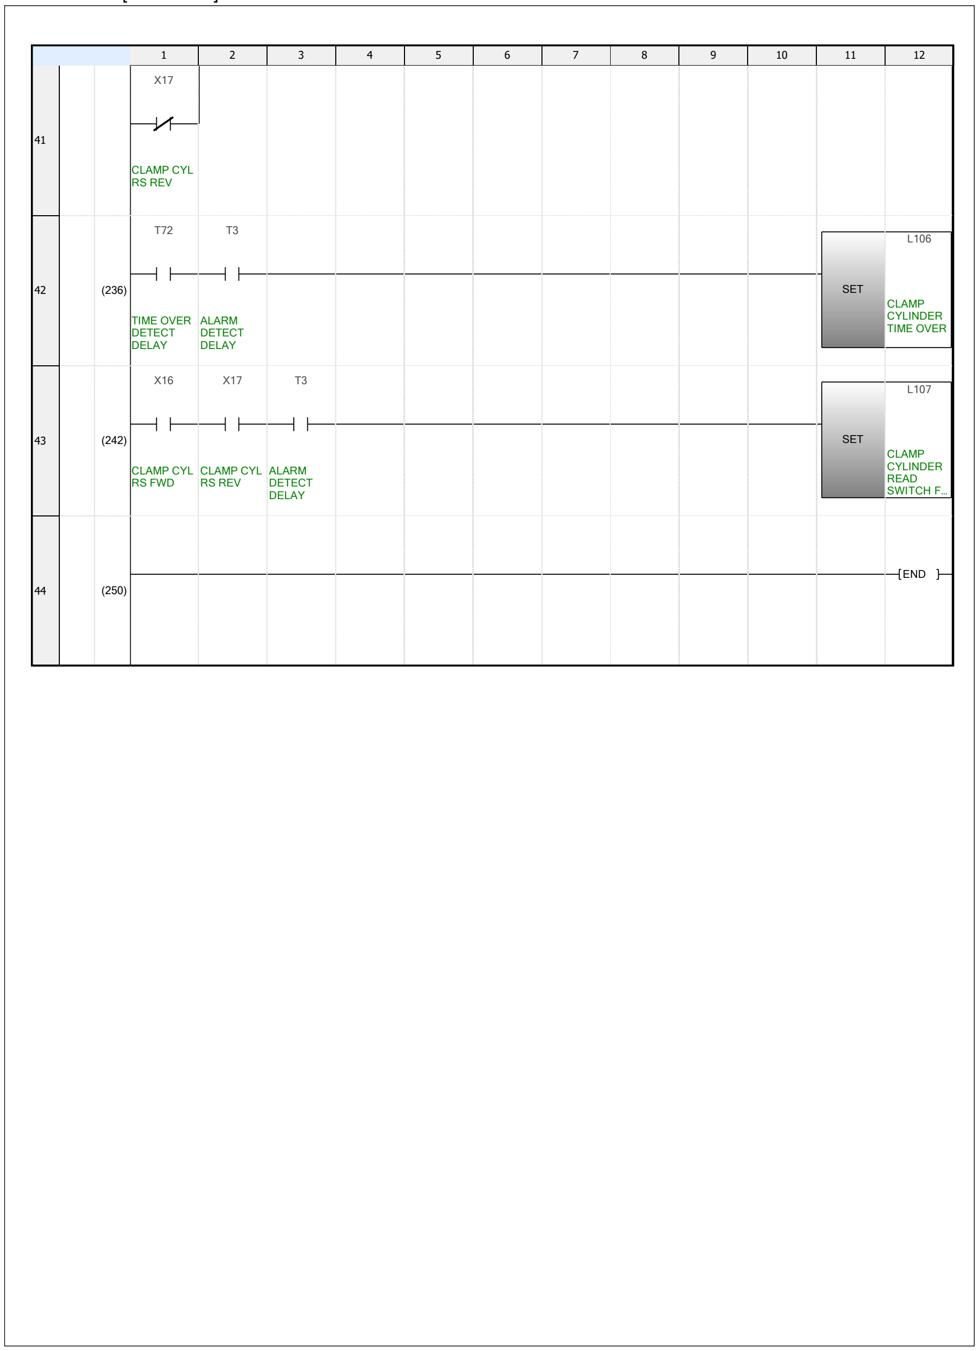
[picture p148: figure]
CLAMP CYL RS REV; TIME OVER DETECT DELAY; ALARM DETECT DELAY; SET; CLAMP CYLINDER TIME OVER; CLAMP CYL RS FWD; CLAMP CYLINDER READ SWITCH F…; END

14

& [GROOVING MACHINE 02] | 30-04-2024

## DONE BY : & [MAINTICS]

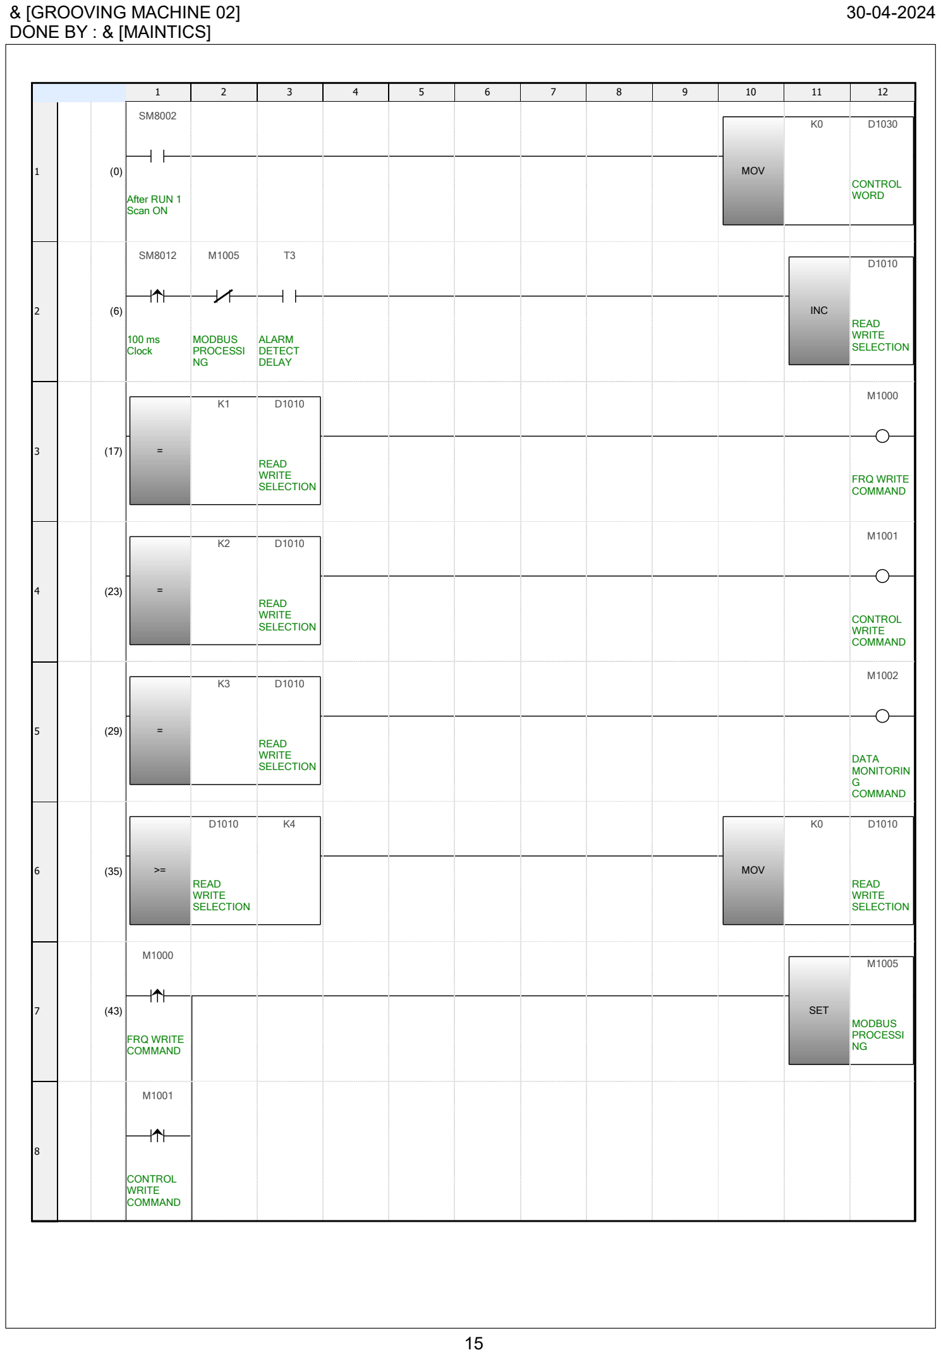
[picture p149: page 15]

15

1 | 2 | 3 | 4 | 5 | 6 | 7 | 8 | 9 | 10 | 11 | 12

1 (0)

SM8002

After RUN 1
Scan ON

MOV

K0 | D1030

CONTROL
WORD

2 (6)

SM8012

100 ms
Clock

M1005

MODBUS
PROCESSI
NG

T3

ALARM
DETECT
DELAY

INC

D1010

READ
WRITE
SELECTION
3 | (17) | =
K1 | D1010

READ
WRITE
SELECTION

M1000

FRQ WRITE
COMMAND
4 | (23) | =
K2 | D1010

READ
WRITE
SELECTION

M1001

CONTROL
WRITE
COMMAND
5 | (29) | =
K3 | D1010

READ
WRITE
SELECTION

M1002

DATA
MONITORIN
G
COMMAND
6 | (35) | >=

D1010

READ
WRITE
SELECTION

K4

MOV

K0 | D1010

READ
WRITE
SELECTION

7 (43)

M1000

FRQ WRITE
COMMAND

SET

M1005

MODBUS
PROCESSI
NG

8

M1001

CONTROL
WRITE
COMMAND

& [GROOVING MACHINE 02] | 30-04-2024

## DONE BY : & [MAINTICS]

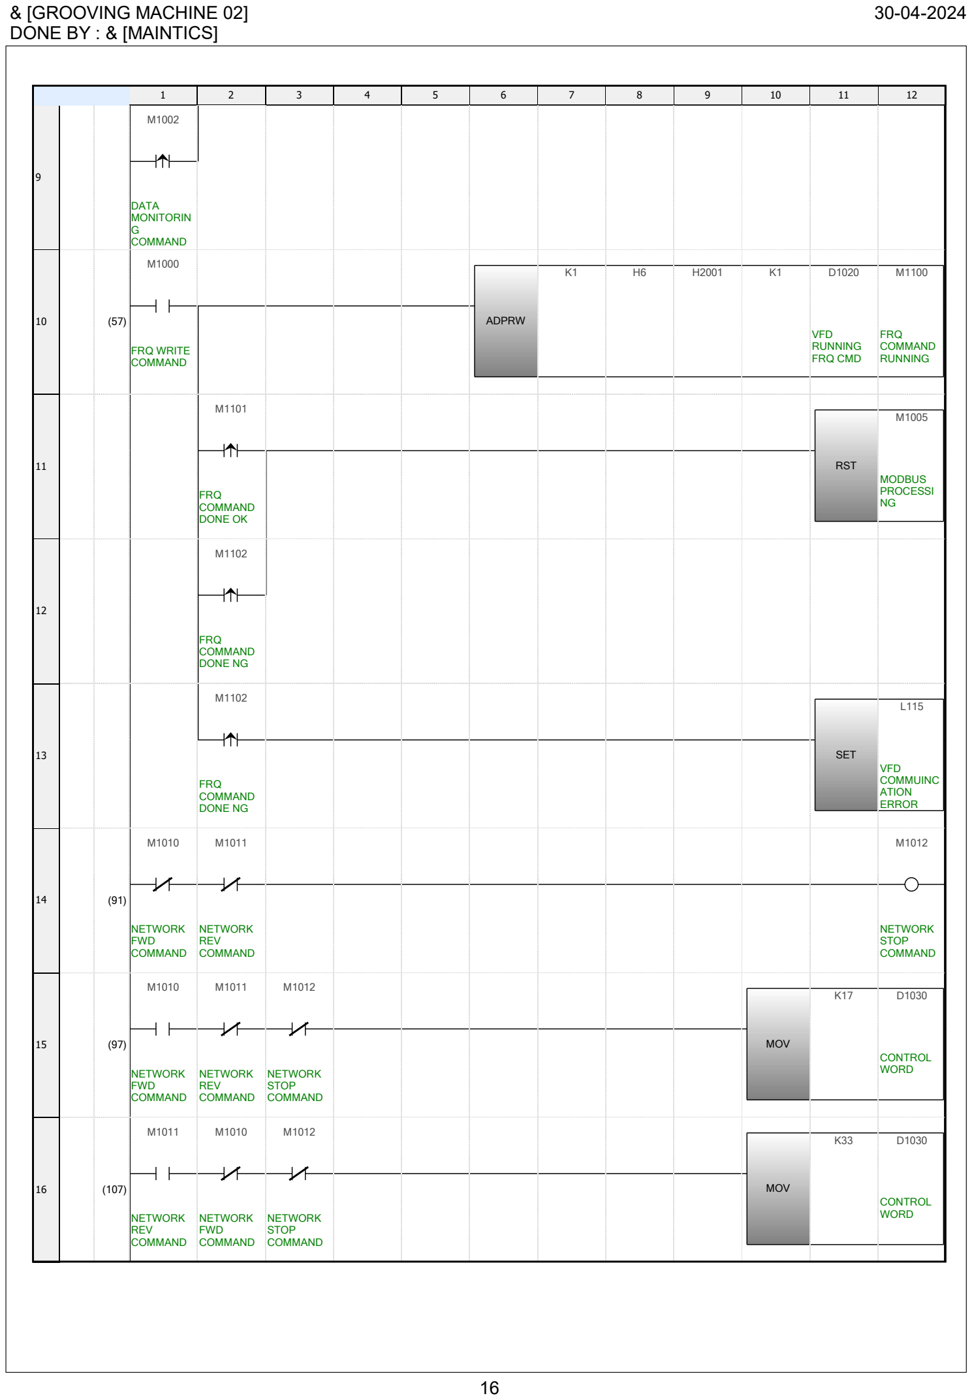
[picture p150: page 16]

16

1 | 2 | 3 | 4 | 5 | 6 | 7 | 8 | 9 | 10 | 11 | 12

9

M1002

DATA
MONITORIN
G
COMMAND

10 (57)

M1000

FRQ WRITE
COMMAND

ADPRW

K1 | H6 | H2001 | K1 | D1020

VFD
RUNNING
FRQ CMD

M1100

FRQ
COMMAND
RUNNING

11

M1101

FRQ
COMMAND
DONE OK

RST

M1005

MODBUS
PROCESSI
NG

12

M1102

FRQ
COMMAND
DONE NG

13

M1102

FRQ
COMMAND
DONE NG

SET

L115

VFD
COMMUINC
ATION
ERROR

14 (91)

M1010

NETWORK
FWD
COMMAND

M1011

NETWORK
REV
COMMAND

M1012

NETWORK
STOP
COMMAND

15 (97)

M1010

NETWORK
FWD
COMMAND

M1011

NETWORK
REV
COMMAND

M1012

NETWORK
STOP
COMMAND

MOV

K17 | D1030

CONTROL
WORD

16 (107)

M1011

NETWORK
REV
COMMAND

M1010

NETWORK
FWD
COMMAND

M1012

NETWORK
STOP
COMMAND

MOV

K33 | D1030

CONTROL
WORD

& [GROOVING MACHINE 02] | 30-04-2024

## DONE BY : & [MAINTICS]

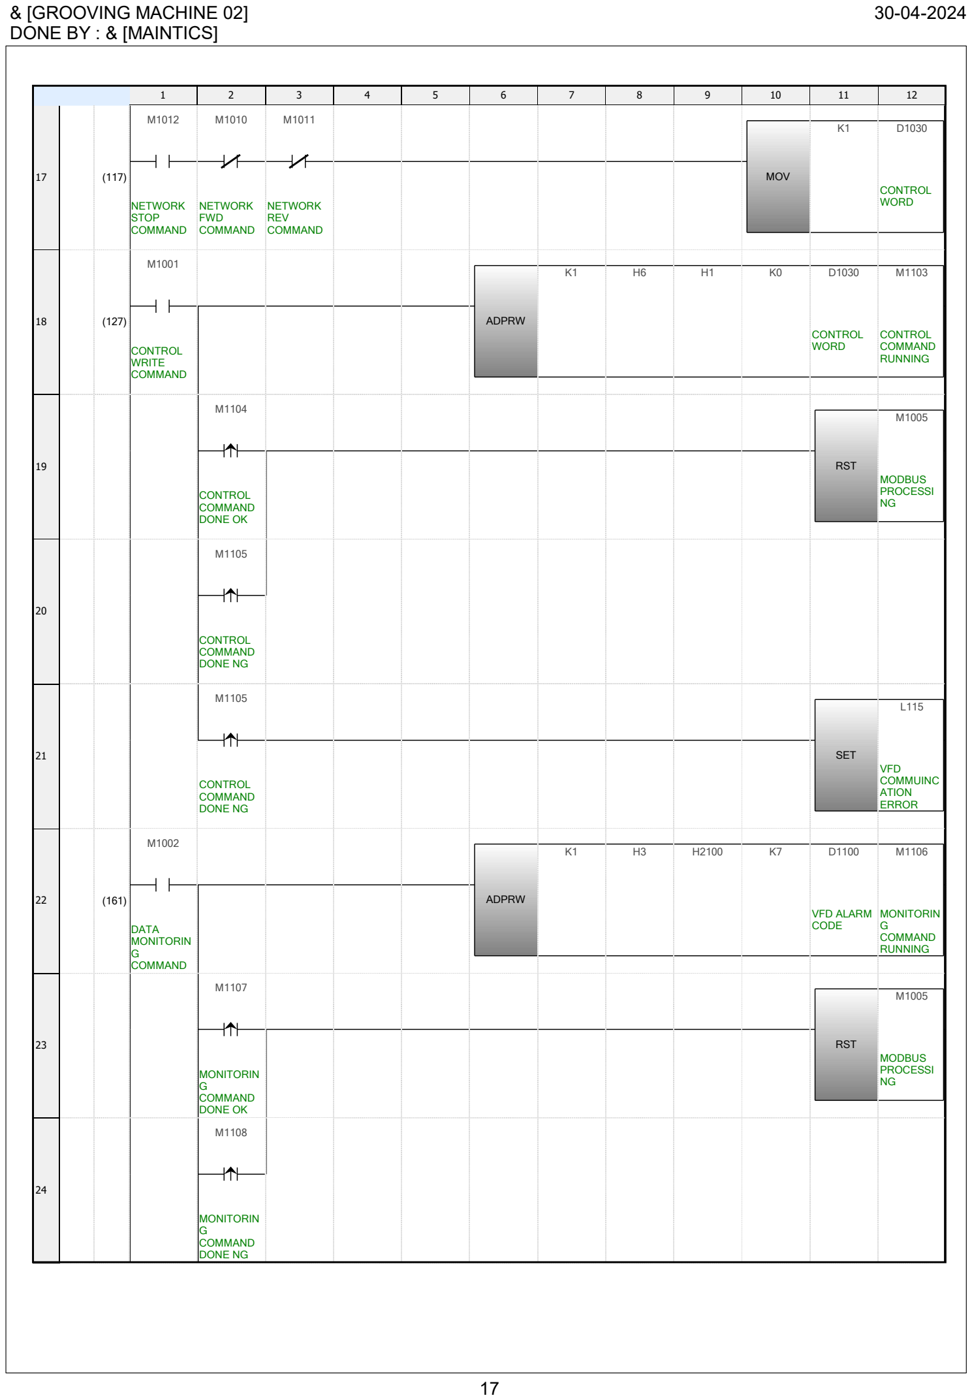
[picture p151: page 17]

17

1 | 2 | 3 | 4 | 5 | 6 | 7 | 8 | 9 | 10 | 11 | 12

17 (117)

M1012

NETWORK
STOP
COMMAND

M1010

NETWORK
FWD
COMMAND

M1011

NETWORK
REV
COMMAND

MOV

K1 | D1030

CONTROL
WORD

18 (127)

M1001

CONTROL
WRITE
COMMAND

ADPRW

K1 | H6 | H1 | K0 | D1030

CONTROL
WORD

M1103

CONTROL
COMMAND
RUNNING

19

M1104

CONTROL
COMMAND
DONE OK

RST

M1005

MODBUS
PROCESSI
NG

20

M1105

CONTROL
COMMAND
DONE NG

21

M1105

CONTROL
COMMAND
DONE NG

SET

L115

VFD
COMMUINC
ATION
ERROR

22 (161)

M1002

DATA
MONITORIN
G
COMMAND

ADPRW

K1 | H3 | H2100 | K7 | D1100

VFD ALARM
CODE

M1106

MONITORIN
G
COMMAND
RUNNING

23

M1107

MONITORIN
G
COMMAND
DONE OK

RST

M1005

MODBUS
PROCESSI
NG

24

M1108

MONITORIN
G
COMMAND
DONE NG

& [GROOVING MACHINE 02] | 30-04-2024

## DONE BY : & [MAINTICS]

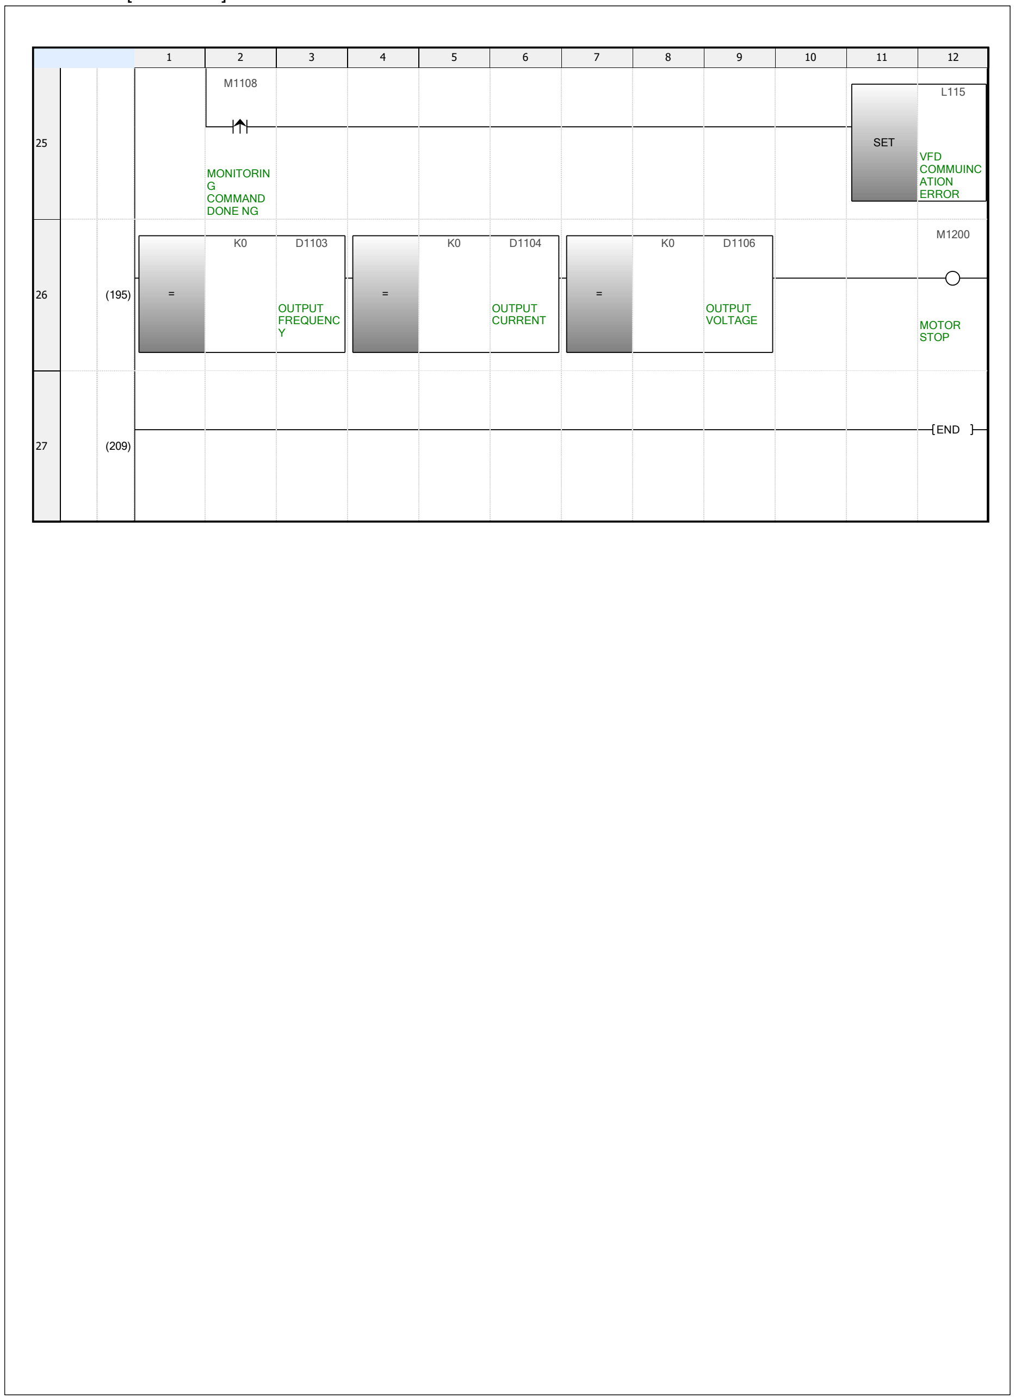
[picture p152: figure]
MONITORIN G COMMAND DONE NG; SET; VFD COMMUINC ATION ERROR; OUTPUT FREQUENC Y; OUTPUT CURRENT; OUTPUT VOLTAGE; MOTOR STOP; END

18

& [GROOVING MACHINE 02] | 30-04-2024

## DONE BY : & [MAINTICS]

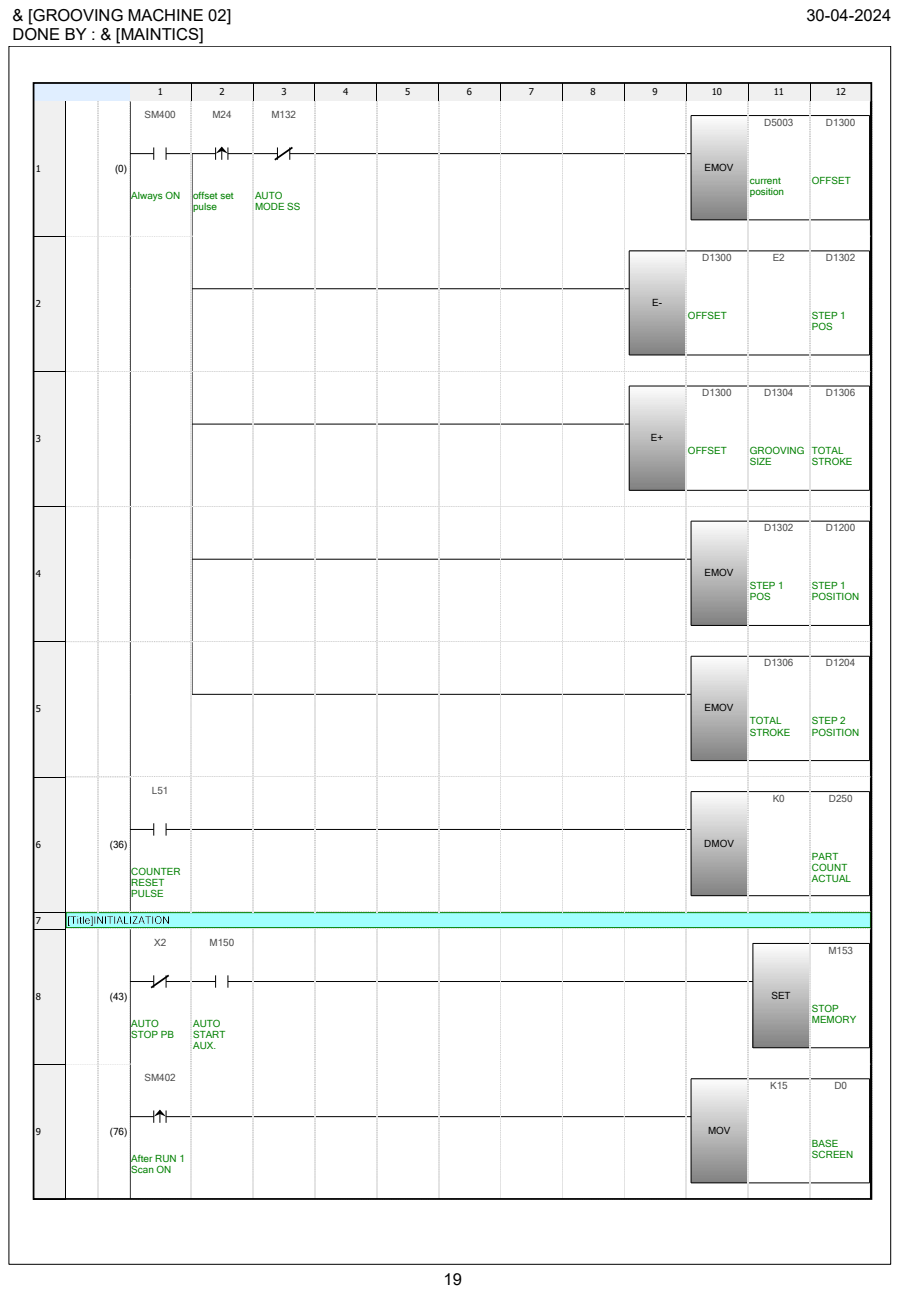
[picture p153: page 19]

& [GROOVING MACHINE 02] | 30-04-2024

## DONE BY : & [MAINTICS]

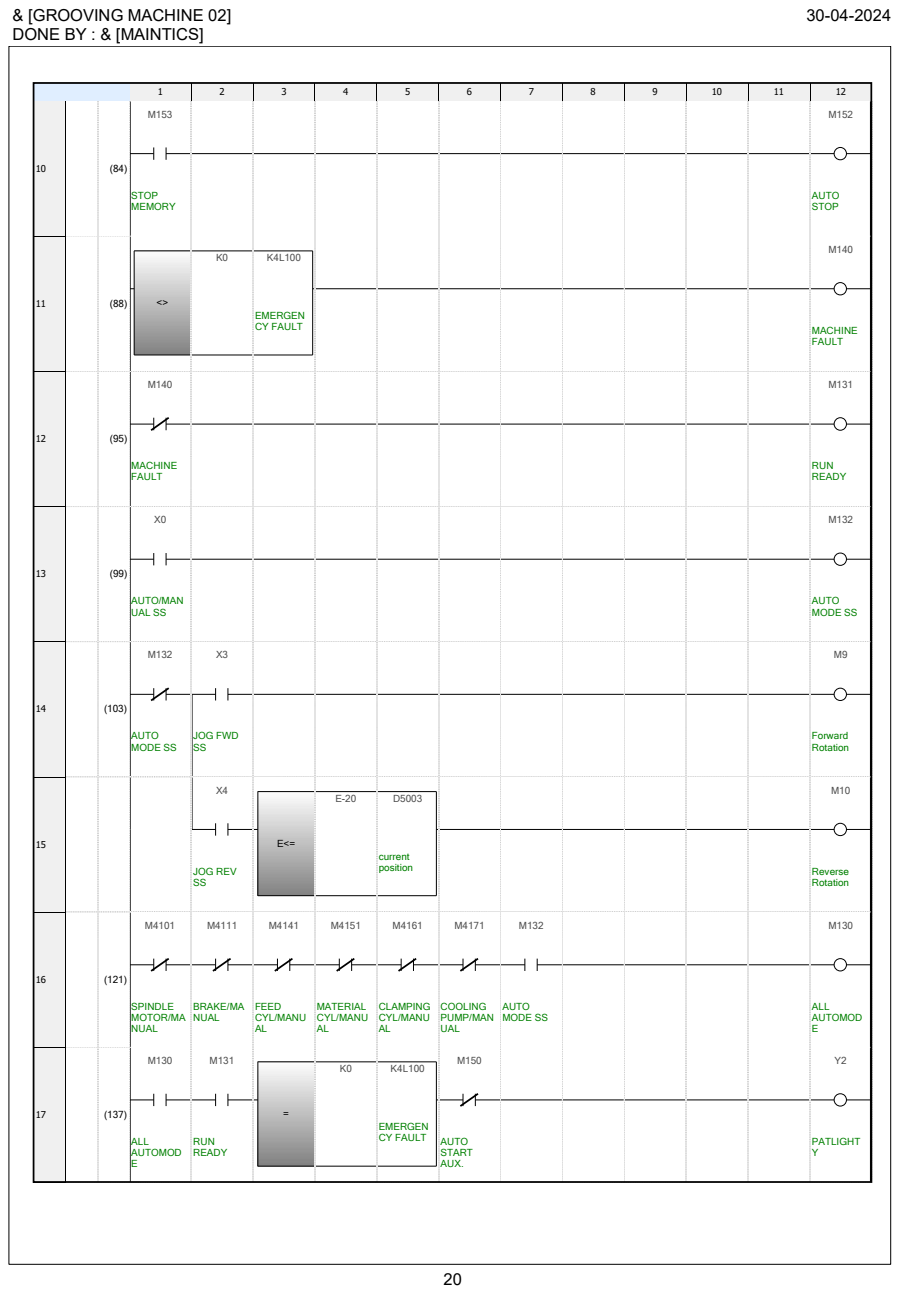
[picture p154: page 20]
STOP MEMORY; AUTO STOP; EMERGEN CY FAULT; MACHINE FAULT; RUN READY; AUTO/MAN UAL SS; AUTO MODE SS; JOG FWD SS; Forward Rotation; JOG REV SS; current position; Reverse Rotation; SPINDLE MOTOR/MA NUAL; BRAKE/MA NUAL; FEED CYL/MANU AL; MATERIAL CYL/MANU AL; CLAMPING CYL/MANU AL; COOLING PUMP/MAN UAL; ALL AUTOMOD E; AUTO START AUX.; PATLIGHT Y

& [GROOVING MACHINE 02] | 30-04-2024

## DONE BY : & [MAINTICS]

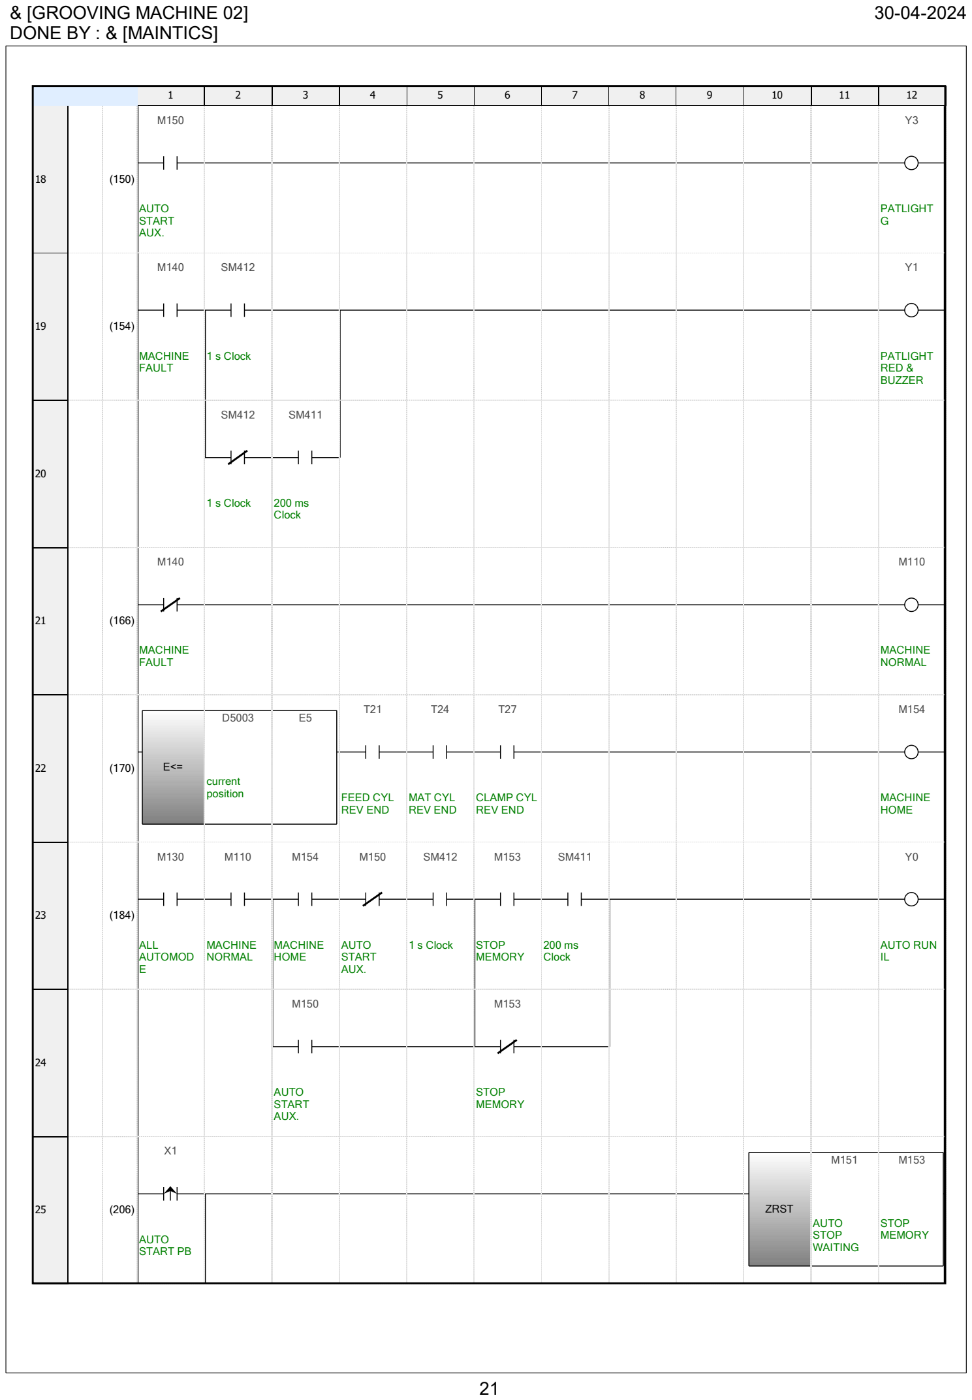
[picture p155: page 21]

21

1 | 2 | 3 | 4 | 5 | 6 | 7 | 8 | 9 | 10 | 11 | 12

18 (150)

M150

AUTO
START
AUX.

Y3

PATLIGHT
G

19 (154)

M140

MACHINE
FAULT

SM412

### 1 s Clock

Y1

PATLIGHT
RED &
BUZZER

20

SM412

### 1 s Clock

SM411

200 ms
Clock

21 (166)

M140

MACHINE
FAULT

M110

MACHINE
NORMAL
22 | (170) | E<=

D5003

current
position

E5

T21

FEED CYL
REV END

T24

MAT CYL
REV END

T27

CLAMP CYL
REV END

M154

MACHINE
HOME

23 (184)

M130

ALL
AUTOMOD
E

M110

MACHINE
NORMAL

M154

MACHINE
HOME

M150

AUTO
START
AUX.

SM412

### 1 s Clock

M153

STOP
MEMORY

SM411

200 ms
Clock

Y0

AUTO RUN
IL

24

M150

AUTO
START
AUX.

M153

STOP
MEMORY

25 (206)

X1

AUTO
START PB

ZRST

M151

AUTO
STOP
WAITING

M153

STOP
MEMORY

& [GROOVING MACHINE 02] | 30-04-2024

## DONE BY : & [MAINTICS]

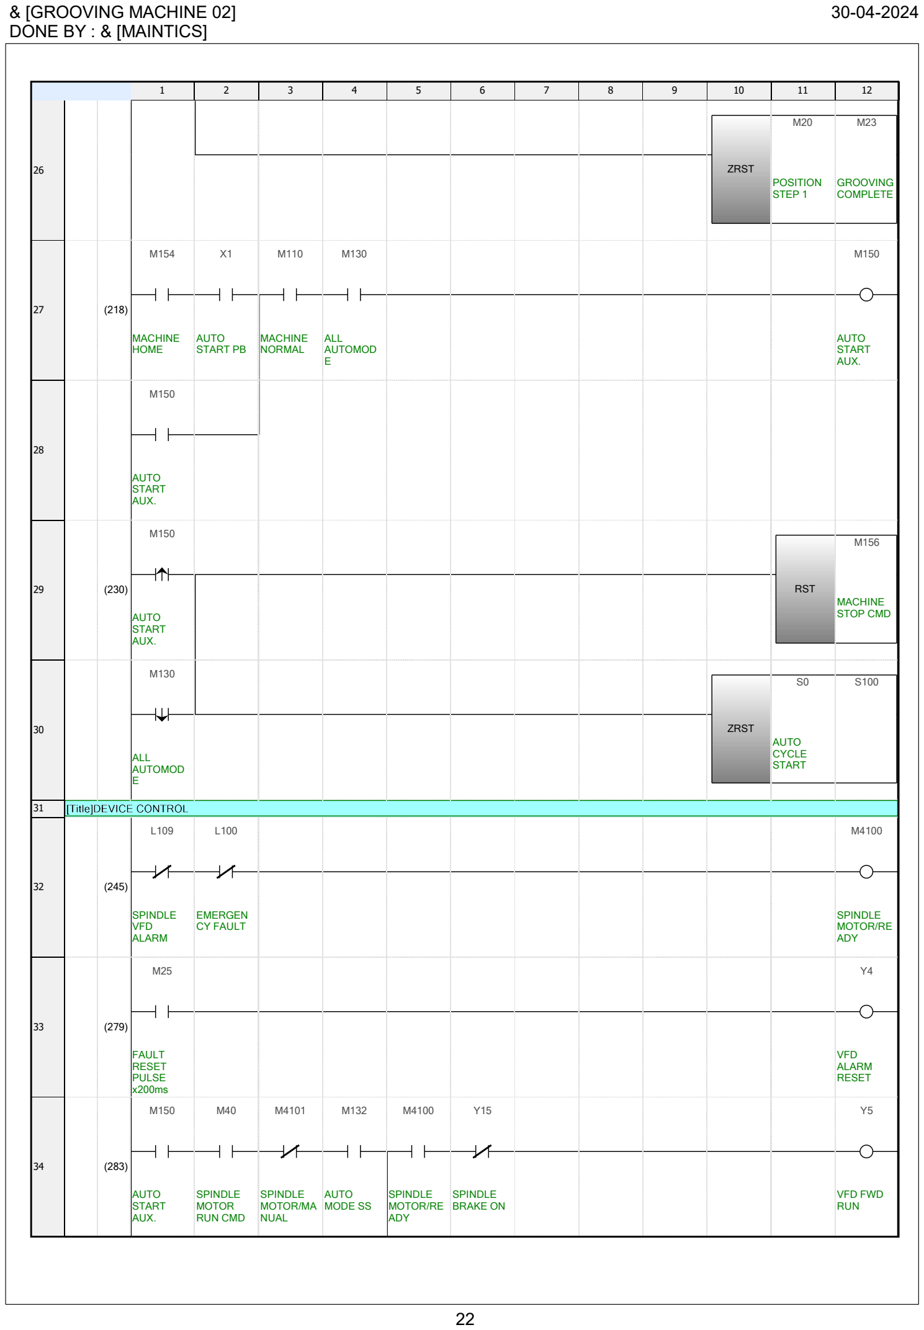
[picture p156: page 22]

22

1 | 2 | 3 | 4 | 5 | 6 | 7 | 8 | 9 | 10 | 11 | 12

### 26 ZRST

M20

POSITION
STEP 1

M23

GROOVING
COMPLETE

27 (218)

M154

MACHINE
HOME

X1

AUTO
START PB

M110

MACHINE
NORMAL

M130

ALL
AUTOMOD
E

M150

AUTO
START
AUX.

28

M150

AUTO
START
AUX.

29 (230)

M150

AUTO
START
AUX.

RST

M156

MACHINE
STOP CMD

30

M130

ALL
AUTOMOD
E

ZRST

S0

AUTO
CYCLE
START

S100

31

32 (245)

L109

SPINDLE
VFD
ALARM

L100

EMERGEN
CY FAULT

M4100

SPINDLE
MOTOR/RE
ADY

33 (279)

M25

FAULT
RESET
PULSE
x200ms

Y4

VFD
ALARM
RESET

34 (283)

M150

AUTO
START
AUX.

M40

SPINDLE
MOTOR
RUN CMD

M4101

SPINDLE
MOTOR/MA
NUAL

M132

AUTO
MODE SS

M4100

SPINDLE
MOTOR/RE
ADY

Y15

SPINDLE
BRAKE ON

Y5

VFD FWD
RUN

& [GROOVING MACHINE 02] | 30-04-2024

## DONE BY : & [MAINTICS]

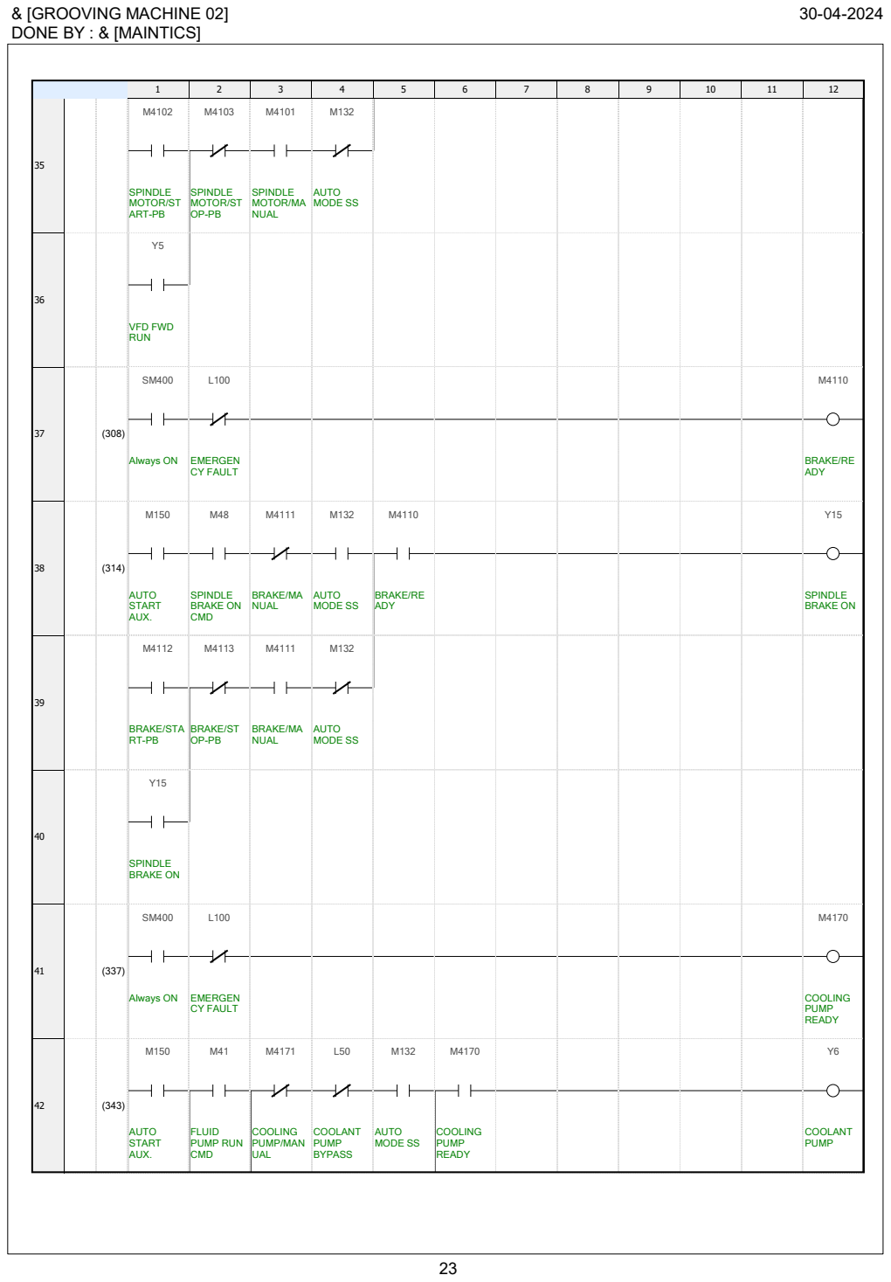
[picture p157: page 23]

23

1 | 2 | 3 | 4 | 5 | 6 | 7 | 8 | 9 | 10 | 11 | 12

35

M4102

SPINDLE
MOTOR/ST
ART-PB

M4103

SPINDLE
MOTOR/ST
OP-PB

M4101

SPINDLE
MOTOR/MA
NUAL

M132

AUTO
MODE SS

36

Y5

VFD FWD
RUN

37 (308)

SM400

Always ON

L100

EMERGEN
CY FAULT

M4110

BRAKE/RE
ADY

38 (314)

M150

AUTO
START
AUX.

M48

SPINDLE
BRAKE ON
CMD

M4111

BRAKE/MA
NUAL

M132

AUTO
MODE SS

M4110

BRAKE/RE
ADY

Y15

SPINDLE
BRAKE ON

39

M4112

BRAKE/STA
RT-PB

M4113

BRAKE/ST
OP-PB

M4111

BRAKE/MA
NUAL

M132

AUTO
MODE SS

40

Y15

SPINDLE
BRAKE ON

41 (337)

SM400

Always ON

L100

EMERGEN
CY FAULT

M4170

COOLING
PUMP
READY

42 (343)

M150

AUTO
START
AUX.

M41

FLUID
PUMP RUN
CMD

M4171

COOLING
PUMP/MAN
UAL

L50

COOLANT
PUMP
BYPASS

M132

AUTO
MODE SS

M4170

COOLING
PUMP
READY

Y6

COOLANT
PUMP

& [GROOVING MACHINE 02] | 30-04-2024

## DONE BY : & [MAINTICS]

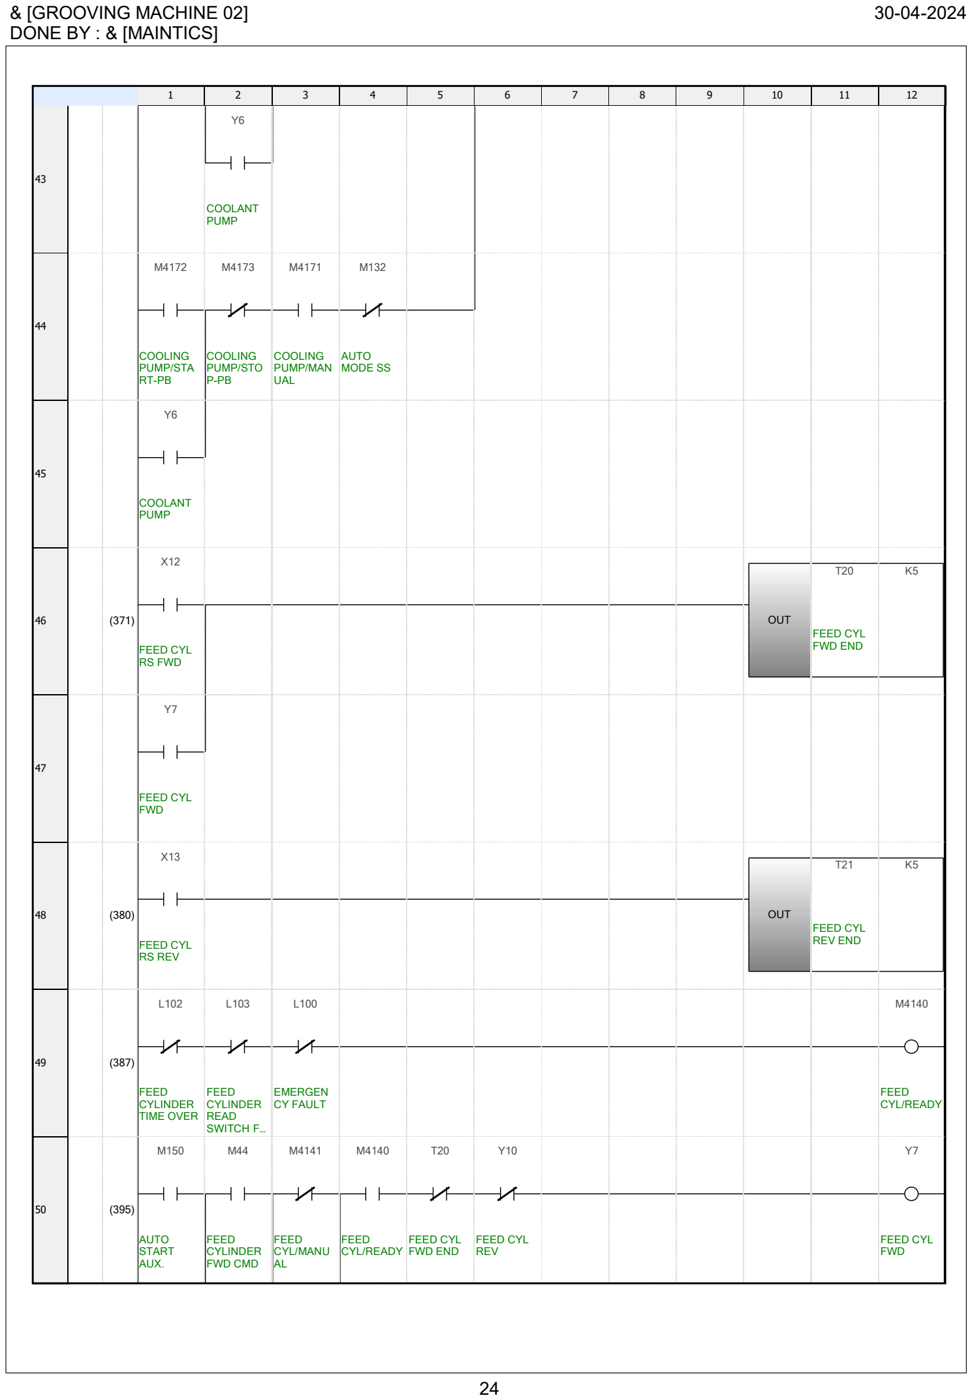
[picture p158: page 24]

24

1 | 2 | 3 | 4 | 5 | 6 | 7 | 8 | 9 | 10 | 11 | 12

43

Y6

COOLANT
PUMP

44

M4172

COOLING
PUMP/STA
RT-PB

M4173

COOLING
PUMP/STO
P-PB

M4171

COOLING
PUMP/MAN
UAL

M132

AUTO
MODE SS

45

Y6

COOLANT
PUMP

46 (371)

X12

FEED CYL
RS FWD

OUT

T20

FEED CYL
FWD END

K5

47

Y7

FEED CYL
FWD

48 (380)

X13

FEED CYL
RS REV

OUT

T21

FEED CYL
REV END

K5

49 (387)

L102

FEED
CYLINDER
TIME OVER

L103

FEED
CYLINDER
READ
SWITCH F…

L100

EMERGEN
CY FAULT

M4140

FEED
CYL/READY

50 (395)

M150

AUTO
START
AUX.

M44

FEED
CYLINDER
FWD CMD

M4141

FEED
CYL/MANU
AL

M4140

FEED
CYL/READY

T20

FEED CYL
FWD END

Y10

FEED CYL
REV

Y7

FEED CYL
FWD

& [GROOVING MACHINE 02] | 30-04-2024

## DONE BY : & [MAINTICS]

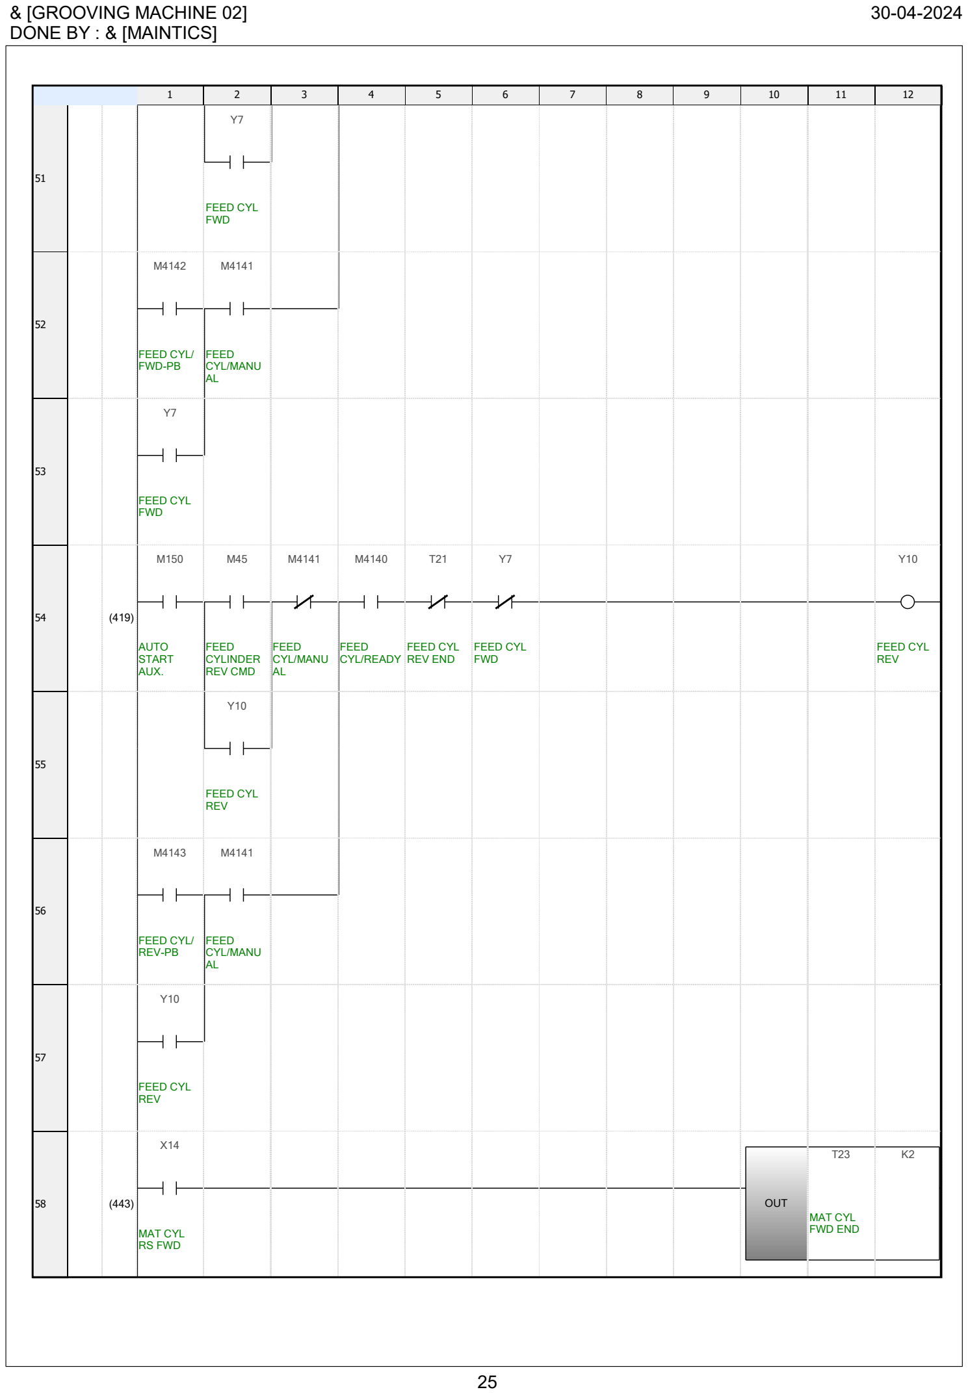
[picture p159: page 25]

25

1 | 2 | 3 | 4 | 5 | 6 | 7 | 8 | 9 | 10 | 11 | 12

51

Y7

FEED CYL
FWD

52

M4142 FEED CYL/

M150

FWD-PB

M4141

FEED
CYL/MANU
AL

53

Y7

FEED CYL
FWD

54 (419)

AUTO
START
AUX.

M45

FEED
CYLINDER
REV CMD

M4141

FEED
CYL/MANU
AL

M4140

FEED
CYL/READY

T21

FEED CYL
REV END

Y7

FEED CYL
FWD

Y10

FEED CYL
REV

55

Y10

FEED CYL
REV

56

M4143

FEED CYL/
REV-PB

M4141

FEED
CYL/MANU
AL

57

Y10

FEED CYL
REV

58 (443)

X14

MAT CYL
RS FWD

OUT

T23

MAT CYL
FWD END

K2

& [GROOVING MACHINE 02] | 30-04-2024

## DONE BY : & [MAINTICS]

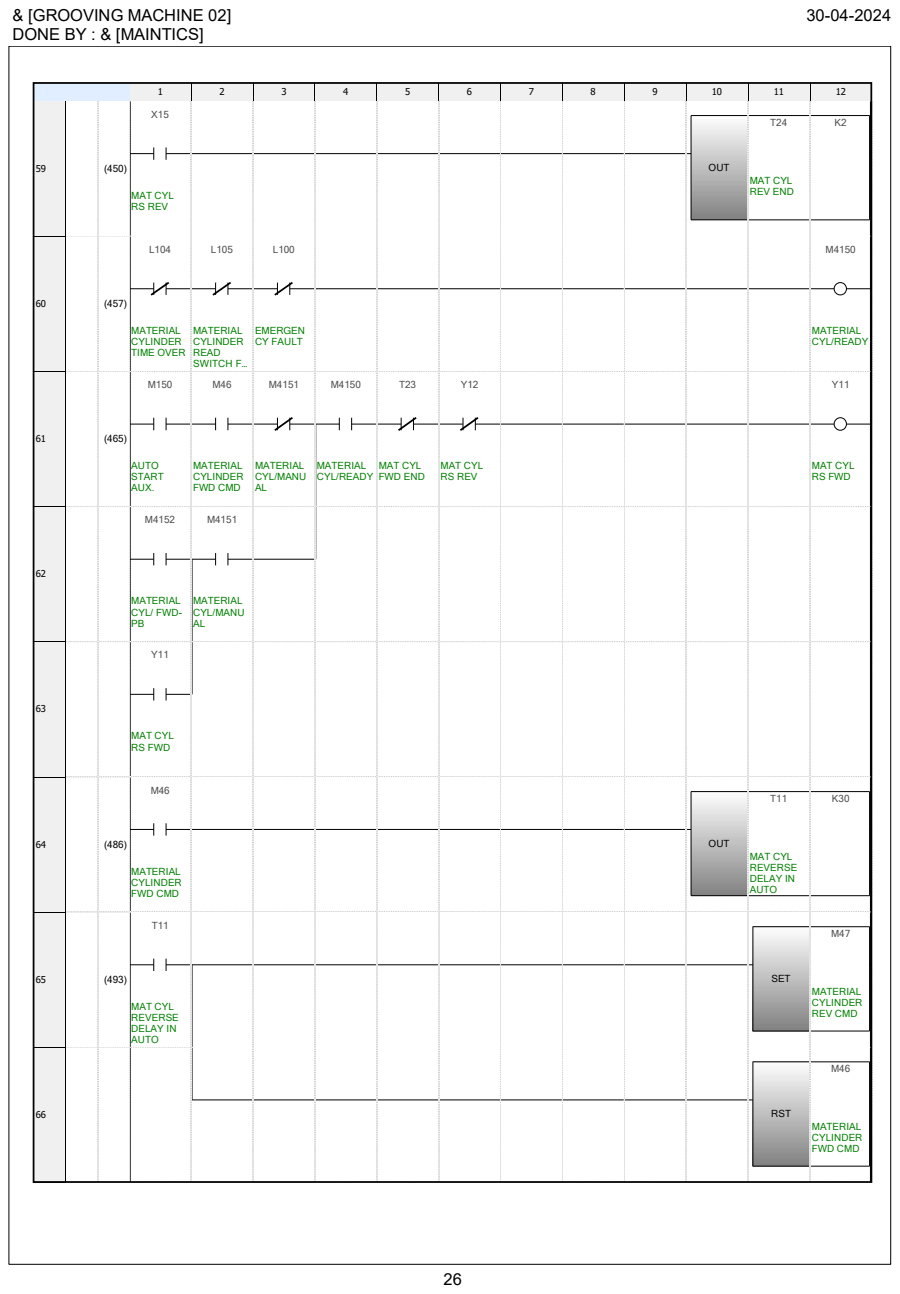
[picture p160: page 26]
MAT CYL RS REV; OUT; MAT CYL REV END; MATERIAL CYLINDER TIME OVER; MATERIAL CYLINDER READ SWITCH F…; EMERGEN CY FAULT; MATERIAL CYL/READY; AUTO START AUX.; MATERIAL CYLINDER FWD CMD; MATERIAL CYL/MANU AL; MAT CYL FWD END; MAT CYL RS FWD; MATERIAL CYL/ FWD- PB; MAT CYL REVERSE DELAY IN AUTO; SET; MATERIAL CYLINDER REV CMD; 66 RST

& [GROOVING MACHINE 02] | 30-04-2024

## DONE BY : & [MAINTICS]

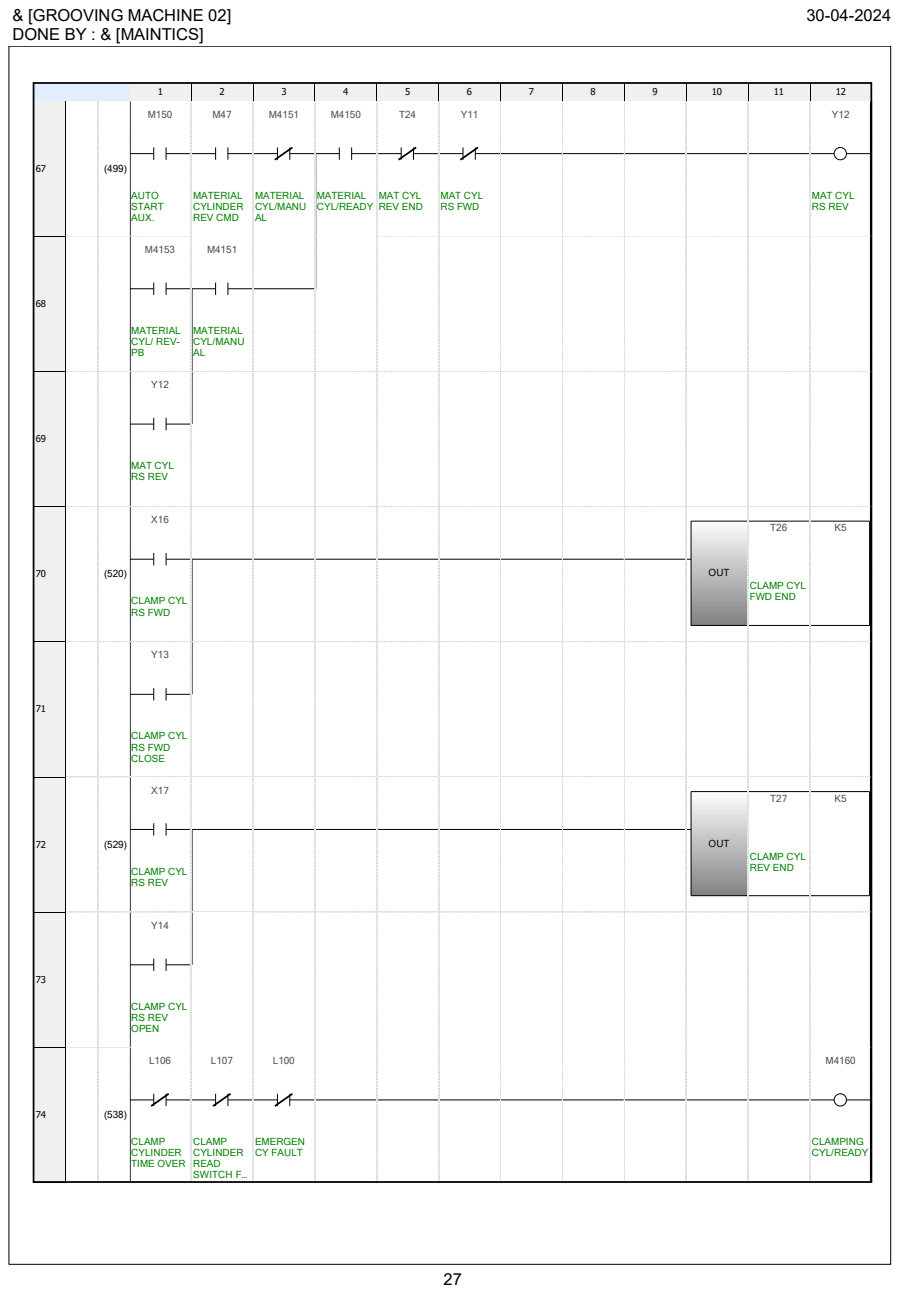
[picture p161: page 27]
AUTO START AUX.; MATERIAL CYLINDER REV CMD; MATERIAL CYL/MANU AL; MATERIAL CYL/READY; MAT CYL REV END; MAT CYL RS FWD; MAT CYL RS REV; MATERIAL CYL/ REV- PB; CLAMP CYL RS FWD; OUT; CLAMP CYL FWD END; CLAMP CYL RS FWD CLOSE; CLAMP CYL RS REV; CLAMP CYL REV END; CLAMP CYL RS REV OPEN; CLAMP CYLINDER TIME OVER; CLAMP CYLINDER READ SWITCH F…; EMERGEN CY FAULT; CLAMPING CYL/READY

& [GROOVING MACHINE 02] | 30-04-2024

## DONE BY : & [MAINTICS]

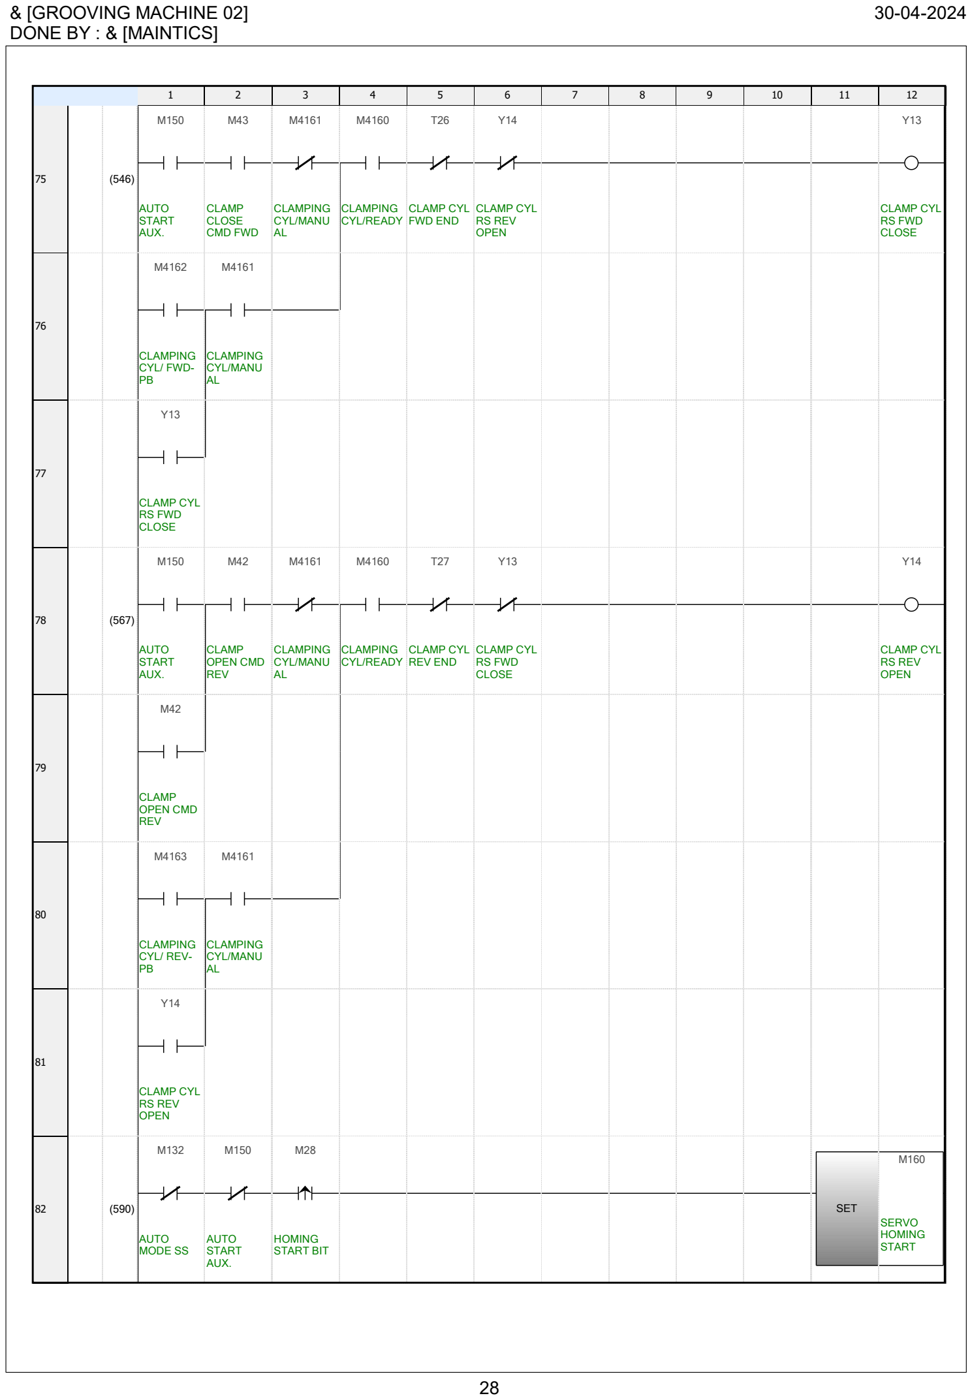
[picture p162: page 28]

28

1 | 2 | 3 | 4 | 5 | 6 | 7 | 8 | 9 | 10 | 11 | 12

75 (546)

M150

AUTO
START
AUX.

M43

CLAMP
CLOSE
CMD FWD

M4161

CLAMPING
CYL/MANU
AL

M4160

CLAMPING
CYL/READY

T26

CLAMP CYL
FWD END

Y14

CLAMP CYL
RS REV
OPEN

Y13

CLAMP CYL
RS FWD
CLOSE

76

M4162

CLAMPING
CYL/ FWD-PB

M4161

CLAMPING
CYL/MANU
AL

77

Y13

CLAMP CYL
RS FWD
CLOSE

78 (567)

M150

AUTO
START
AUX.

M42

CLAMP
OPEN CMD
REV

M4161

CLAMPING
CYL/MANU
AL

M4160

CLAMPING
CYL/READY

T27

CLAMP CYL
REV END

Y13

CLAMP CYL
RS FWD
CLOSE

Y14

CLAMP CYL
RS REV
OPEN

79

M42

CLAMP
OPEN CMD
REV

80

M4163

CLAMPING
CYL/ REV-PB

M4161

CLAMPING
CYL/MANU
AL

81

Y14

CLAMP CYL
RS REV
OPEN

82 (590)

M132

AUTO
MODE SS

M150

AUTO
START
AUX.

M28

HOMING
START BIT

SET

M160

SERVO
HOMING
START

& [GROOVING MACHINE 02] | 30-04-2024

## DONE BY : & [MAINTICS]

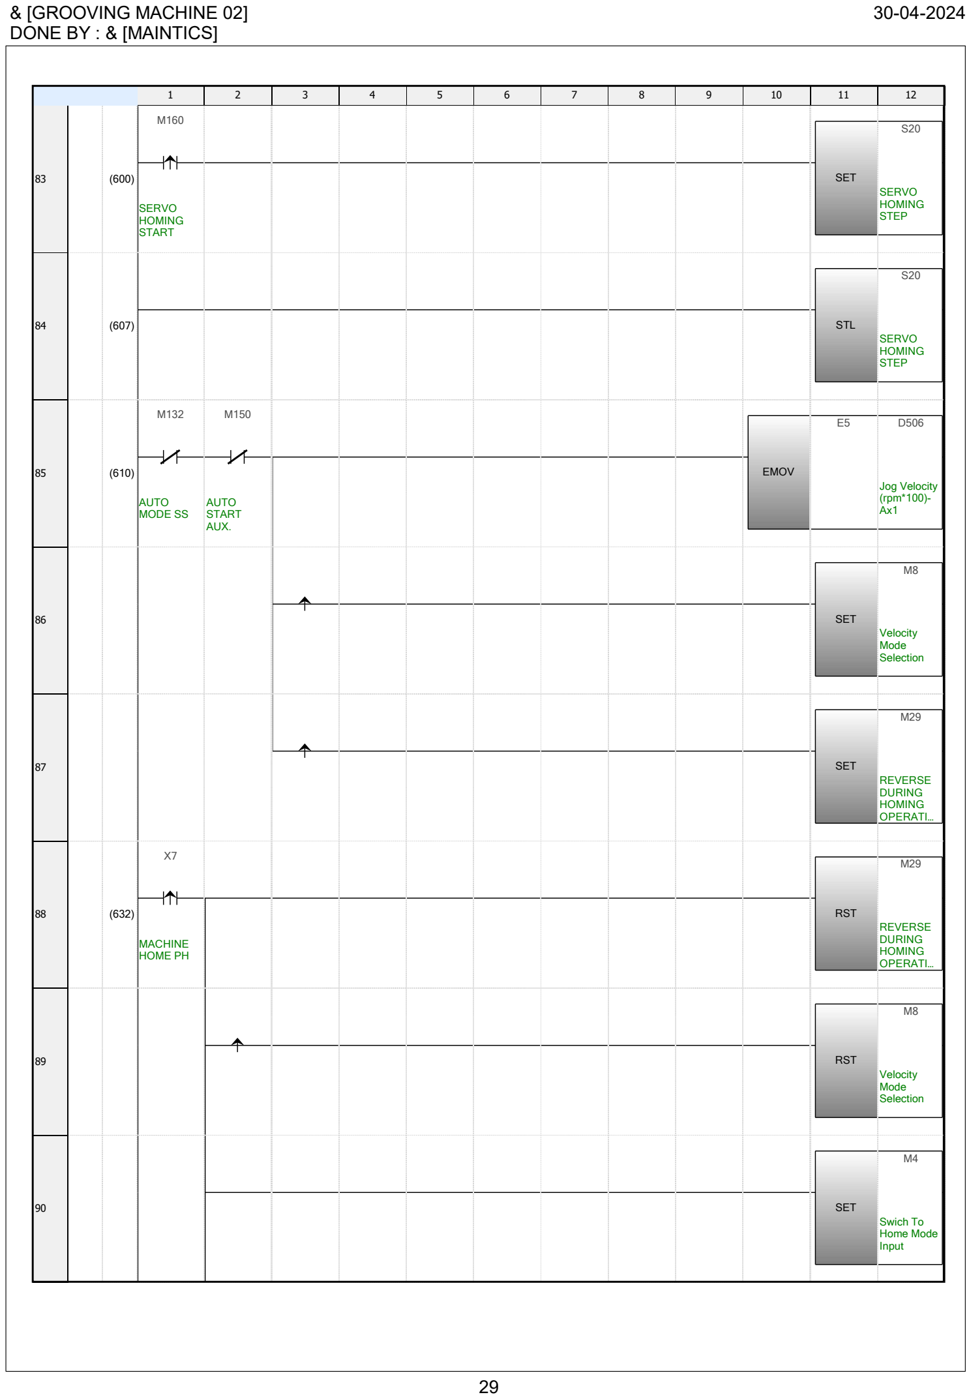
[picture p163: page 29]

29

1 | 2 | 3 | 4 | 5 | 6 | 7 | 8 | 9 | 10 | 11 | 12

83 (600)

M160

SERVO
HOMING
START

SET

S20

SERVO
HOMING
STEP
84 | (607) | STL

S20

SERVO
HOMING
STEP

85 (610)

M132

AUTO
MODE SS

M150

AUTO
START
AUX.

EMOV

E5 | D506

Jog Velocity
(rpm*100)-
Ax1

### 86 SET

M8

Velocity
Mode
Selection

### 87 SET

M29

REVERSE
DURING
HOMING
OPERATI…

88 (632)

X7

MACHINE
HOME PH

RST

M29

REVERSE
DURING
HOMING
OPERATI…

### 89 RST

M8

Velocity
Mode
Selection

### 90 SET

M4

Swich To
Home Mode
Input

& [GROOVING MACHINE 02] | 30-04-2024

## DONE BY : & [MAINTICS]

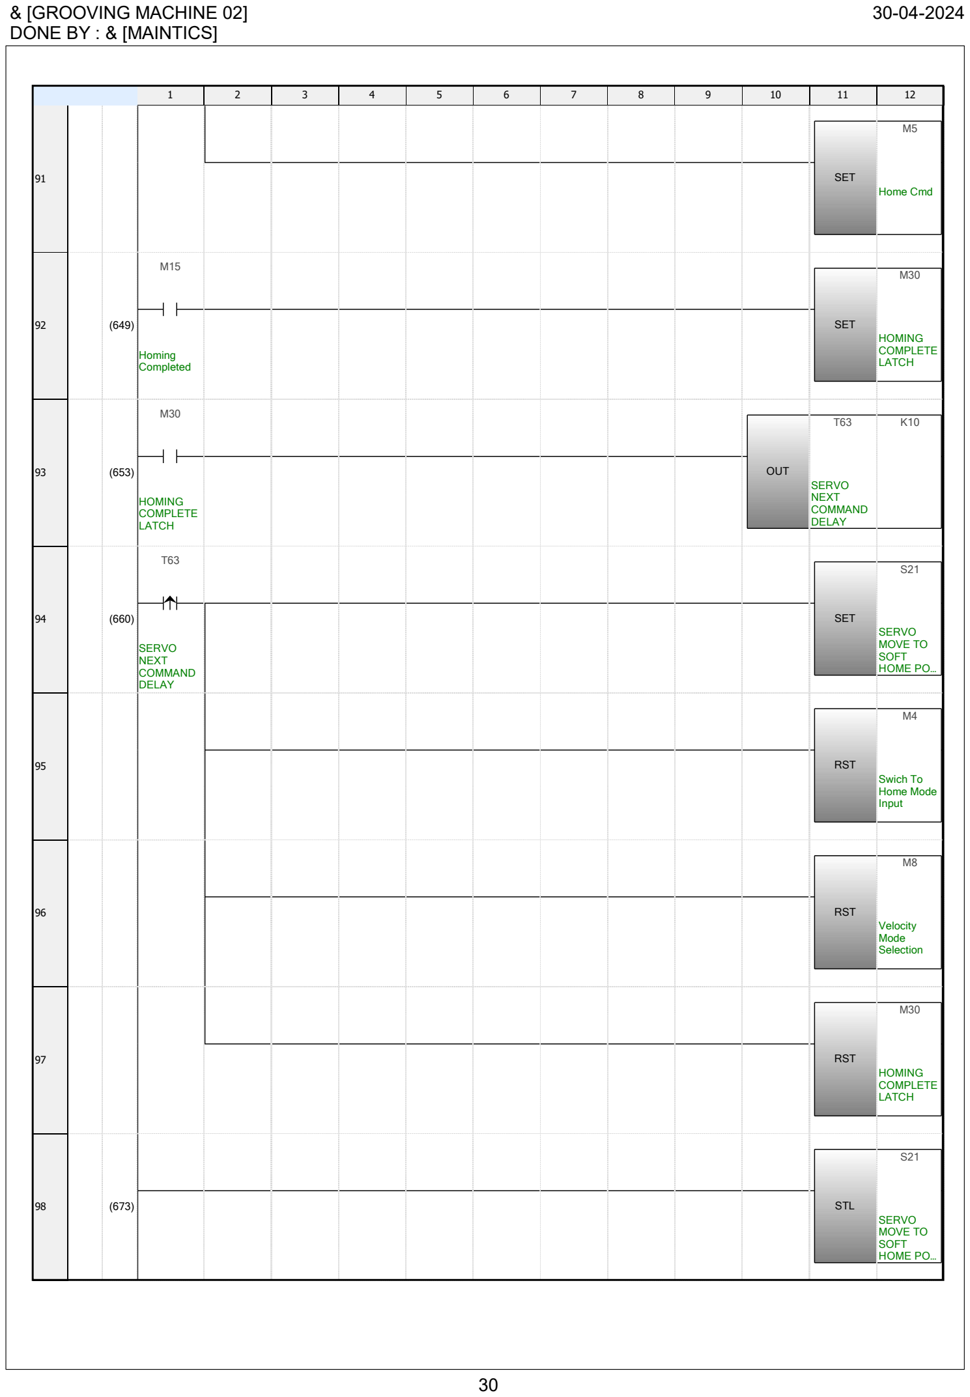
[picture p164: page 30]

30

1 | 2 | 3 | 4 | 5 | 6 | 7 | 8 | 9 | 10 | 11 | 12

### 91 SET

M5

Home Cmd

92 (649)

M15

Homing
Completed

SET

M30

HOMING
COMPLETE
LATCH

93 (653)

M30

HOMING
COMPLETE
LATCH

OUT

T63

SERVO
NEXT
COMMAND
DELAY

K10

94 (660)

T63

SERVO
NEXT
COMMAND
DELAY

SET

S21

SERVO
MOVE TO
SOFT
HOME PO…

### 95 RST

M4

Swich To
Home Mode
Input

### 96 RST

M8

Velocity
Mode
Selection

### 97 RST

M30

HOMING
COMPLETE
LATCH
98 | (673) | STL

S21

SERVO
MOVE TO
SOFT
HOME PO…

& [GROOVING MACHINE 02] | 30-04-2024

## DONE BY : & [MAINTICS]

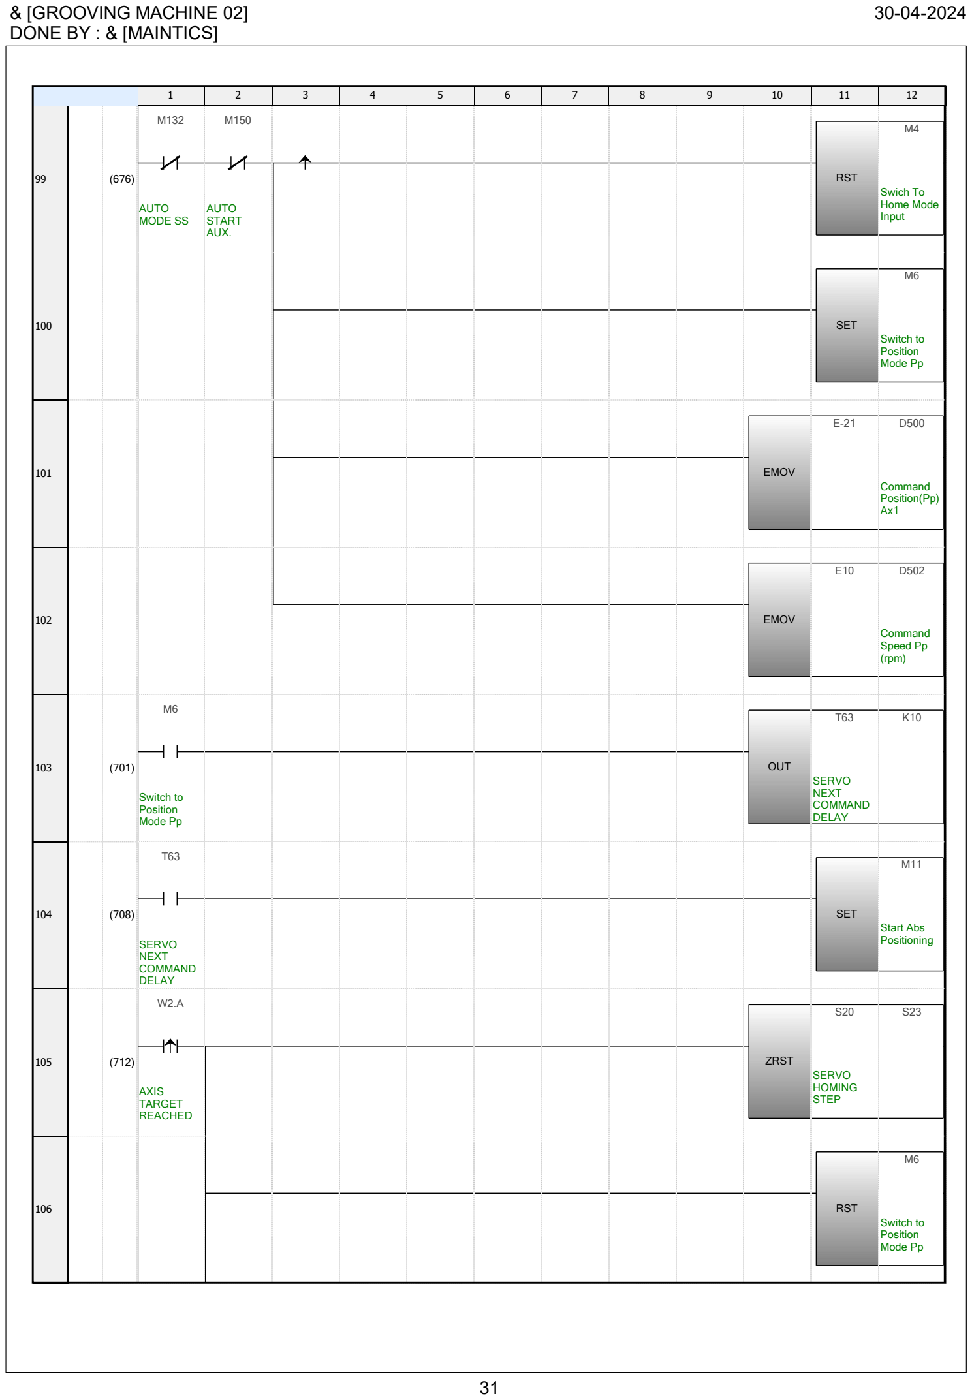
[picture p165: page 31]

31

1 | 2 | 3 | 4 | 5 | 6 | 7 | 8 | 9 | 10 | 11 | 12

99 (676)

M132

AUTO
MODE SS

M150

AUTO
START
AUX.

RST

M4

Swich To
Home Mode
Input

100 SET

M6

Switch to
Position
Mode Pp

101 EMOV

E-21 | D500

Command
Position(Pp)
Ax1

102 EMOV

E10 | D502

Command
Speed Pp
(rpm)

103 (701)

M6

Switch to
Position
Mode Pp

OUT

T63

SERVO
NEXT
COMMAND
DELAY

K10

104 (708)

T63

SERVO
NEXT
COMMAND
DELAY

SET

M11

Start Abs
Positioning

105 (712)

W2.A

AXIS
TARGET
REACHED

ZRST

S20

SERVO
HOMING
STEP

S23

106 RST

M6

Switch to
Position
Mode Pp

& [GROOVING MACHINE 02] | 30-04-2024

## DONE BY : & [MAINTICS]

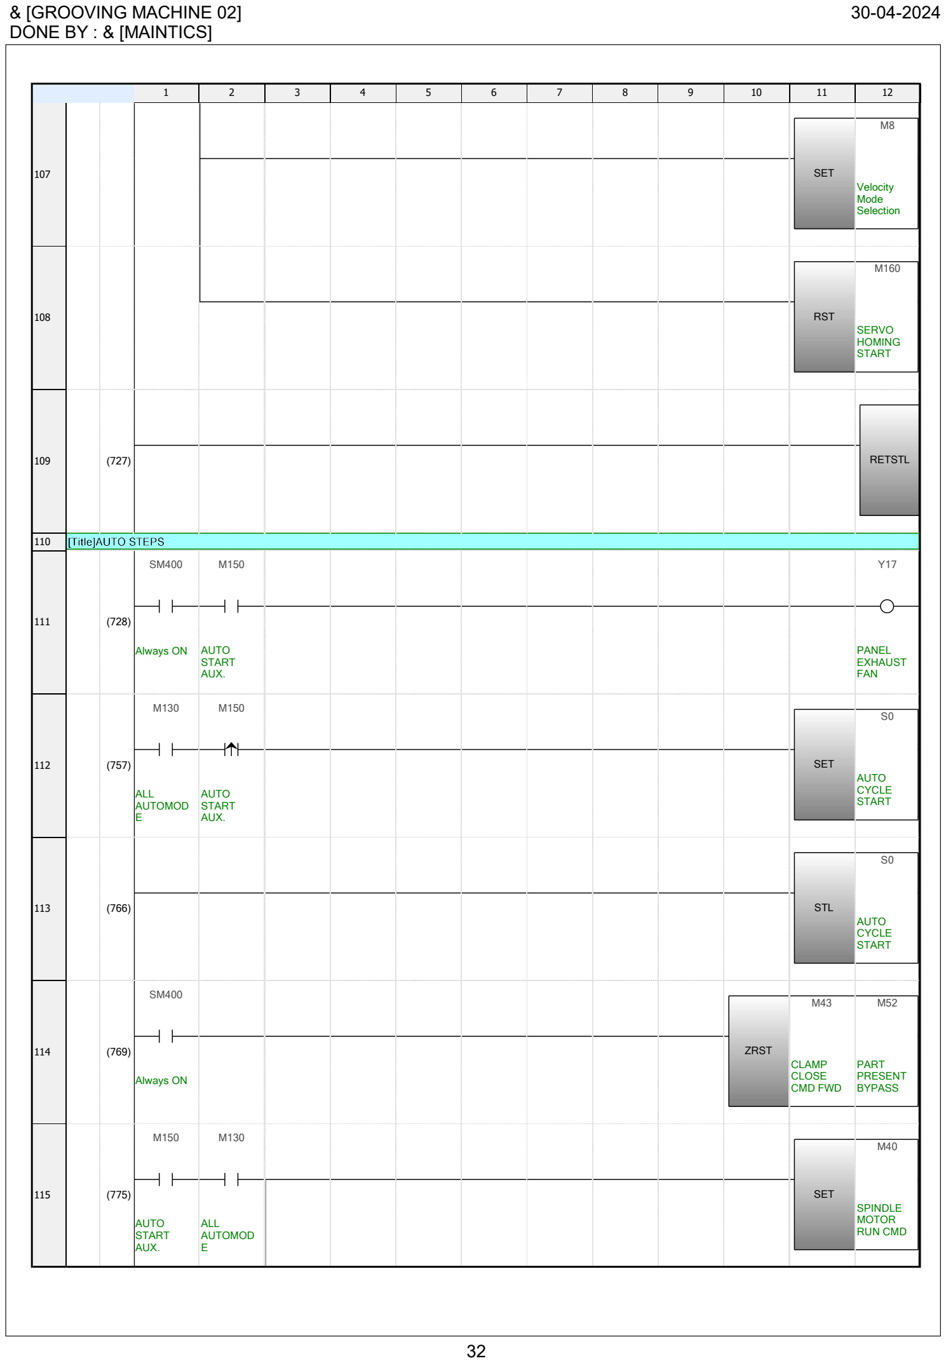
[picture p166: page 32]

32

1 | 2 | 3 | 4 | 5 | 6 | 7 | 8 | 9 | 10 | 11 | 12

107 SET

M8

Velocity
Mode
Selection

108 RST

M160

SERVO
HOMING
START
109 | (727) | RETSTL

110

111 (728)

SM400

Always ON

M150

AUTO
START
AUX.

Y17

PANEL
EXHAUST
FAN

112 (757)

M130

ALL
AUTOMOD
E

M150

AUTO
START
AUX.

SET

S0

AUTO
CYCLE
START
113 | (766) | STL

S0

AUTO
CYCLE
START

114 (769)

SM400

Always ON

ZRST

M43

CLAMP
CLOSE
CMD FWD

M52

PART
PRESENT
BYPASS

115 (775)

M150

AUTO
START
AUX.

M130

ALL
AUTOMOD
E

SET

M40

SPINDLE
MOTOR
RUN CMD

& [GROOVING MACHINE 02] | 30-04-2024

## DONE BY : & [MAINTICS]

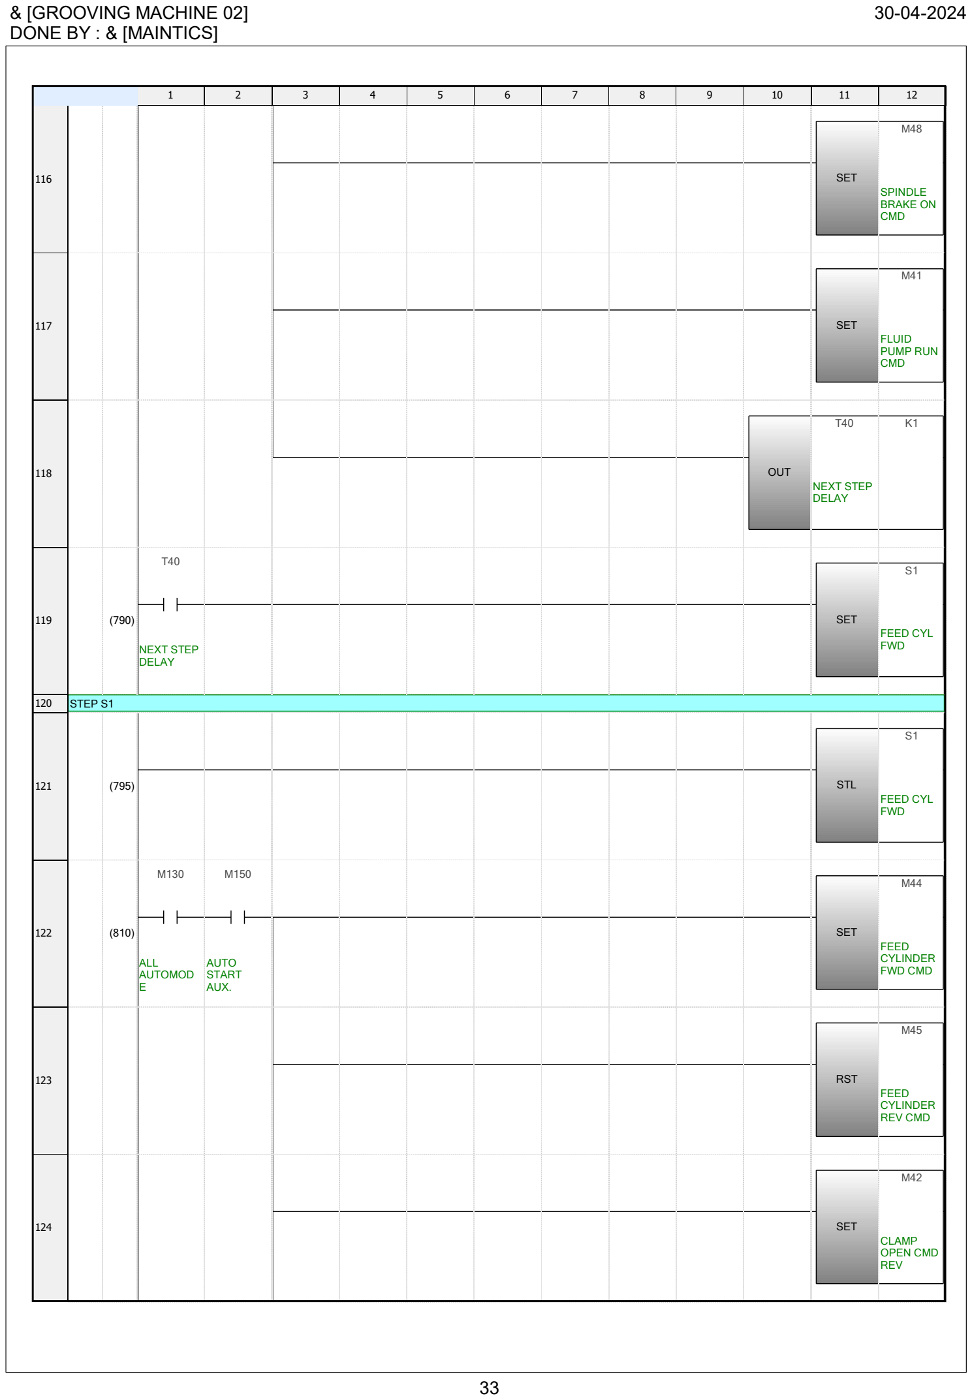
[picture p167: page 33]

33

1 | 2 | 3 | 4 | 5 | 6 | 7 | 8 | 9 | 10 | 11 | 12

116 SET

M48

SPINDLE
BRAKE ON
CMD

117 SET

M41

FLUID
PUMP RUN
CMD

118 OUT

T40

NEXT STEP
DELAY

K1

119 (790)

T40

NEXT STEP
DELAY

SET

S1

FEED CYL
FWD

120 STEP S1

121 | (795) | STL

S1

FEED CYL
FWD

122 (810)

M130

ALL
AUTOMOD
E

M150

AUTO
START
AUX.

SET

M44

FEED
CYLINDER
FWD CMD

123 RST

M45

FEED
CYLINDER
REV CMD

124 SET

M42

CLAMP
OPEN CMD
REV

& [GROOVING MACHINE 02] | 30-04-2024

## DONE BY : & [MAINTICS]

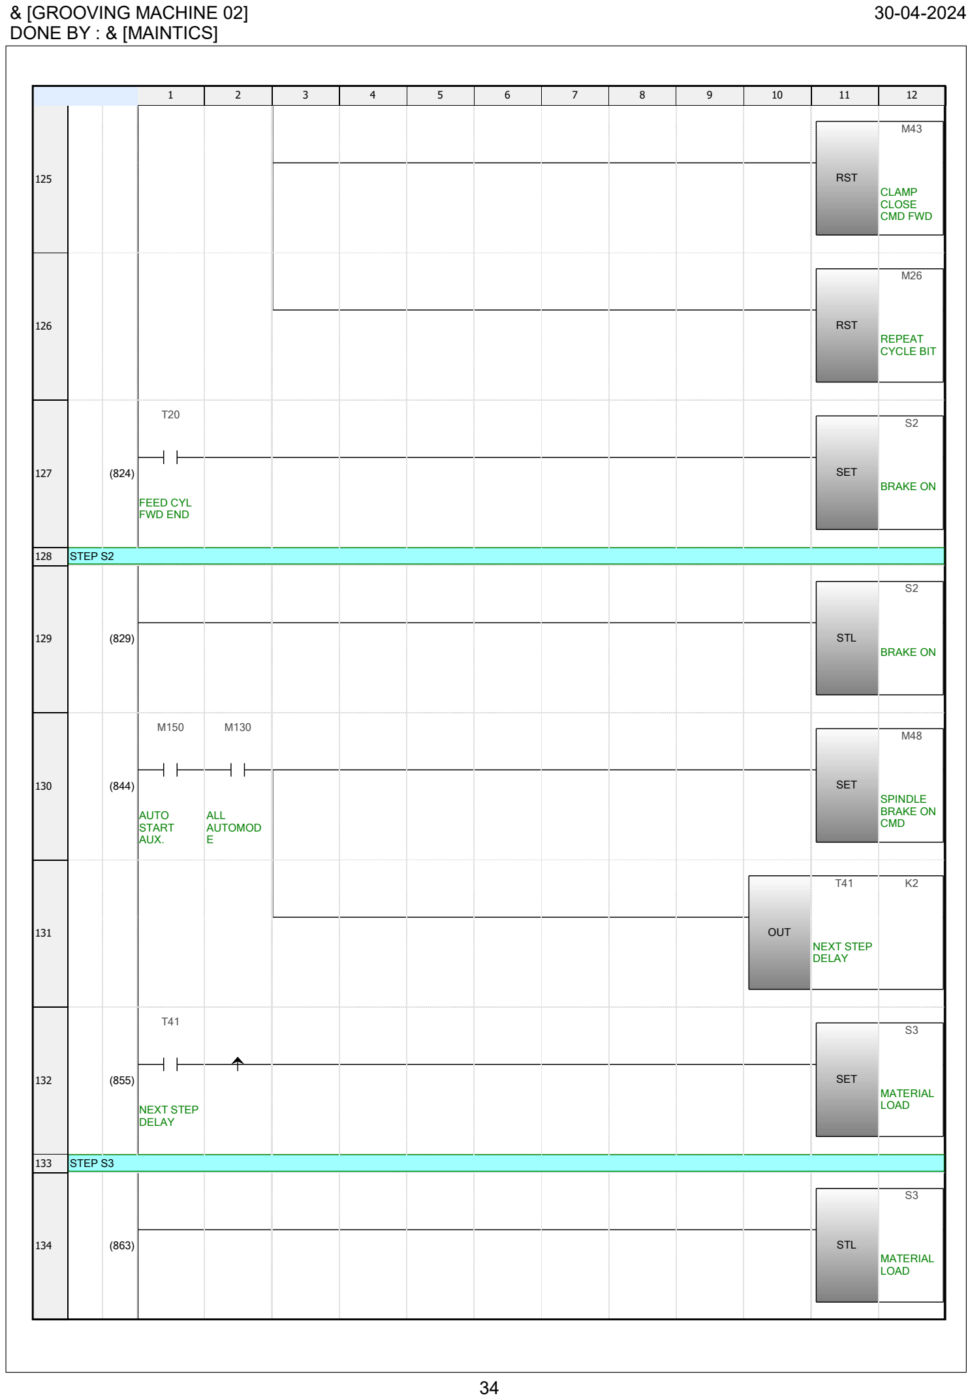
[picture p168: page 34]

34

1 | 2 | 3 | 4 | 5 | 6 | 7 | 8 | 9 | 10 | 11 | 12

125 RST

M43

CLAMP
CLOSE
CMD FWD

126 RST

M26

REPEAT
CYCLE BIT

127 (824)

T20

FEED CYL
FWD END

SET

S2

BRAKE ON

128 STEP S2

129 | (829) | STL

S2

BRAKE ON

130 (844)

M150

AUTO
START
AUX.

M130

ALL
AUTOMOD
E

SET

M48

SPINDLE
BRAKE ON
CMD

131 OUT

T41

NEXT STEP
DELAY

K2

132 (855)

T41

NEXT STEP
DELAY

SET

S3

MATERIAL
LOAD

133 STEP S3

134 | (863) | STL

S3

MATERIAL
LOAD

& [GROOVING MACHINE 02] | 30-04-2024

## DONE BY : & [MAINTICS]

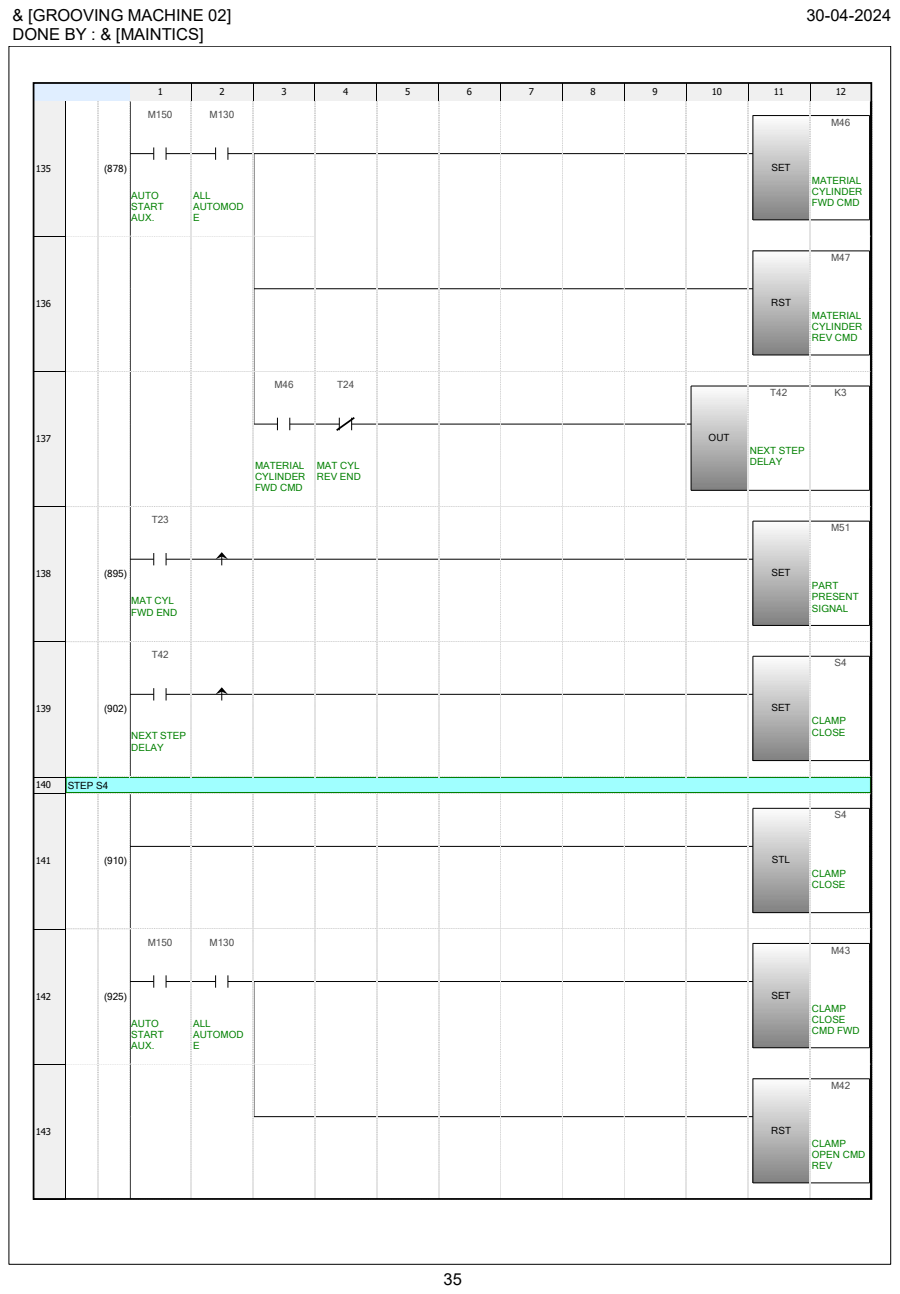
[picture p169: page 35]
AUTO START AUX.; ALL AUTOMOD E; SET; MATERIAL CYLINDER FWD CMD; 136 RST; MATERIAL CYLINDER REV CMD; MAT CYL REV END; OUT; NEXT STEP DELAY; MAT CYL FWD END; PART PRESENT SIGNAL; CLAMP CLOSE; 140 STEP S4; STL; CLAMP CLOSE CMD FWD; 143 RST; CLAMP OPEN CMD REV

& [GROOVING MACHINE 02] | 30-04-2024

## DONE BY : & [MAINTICS]

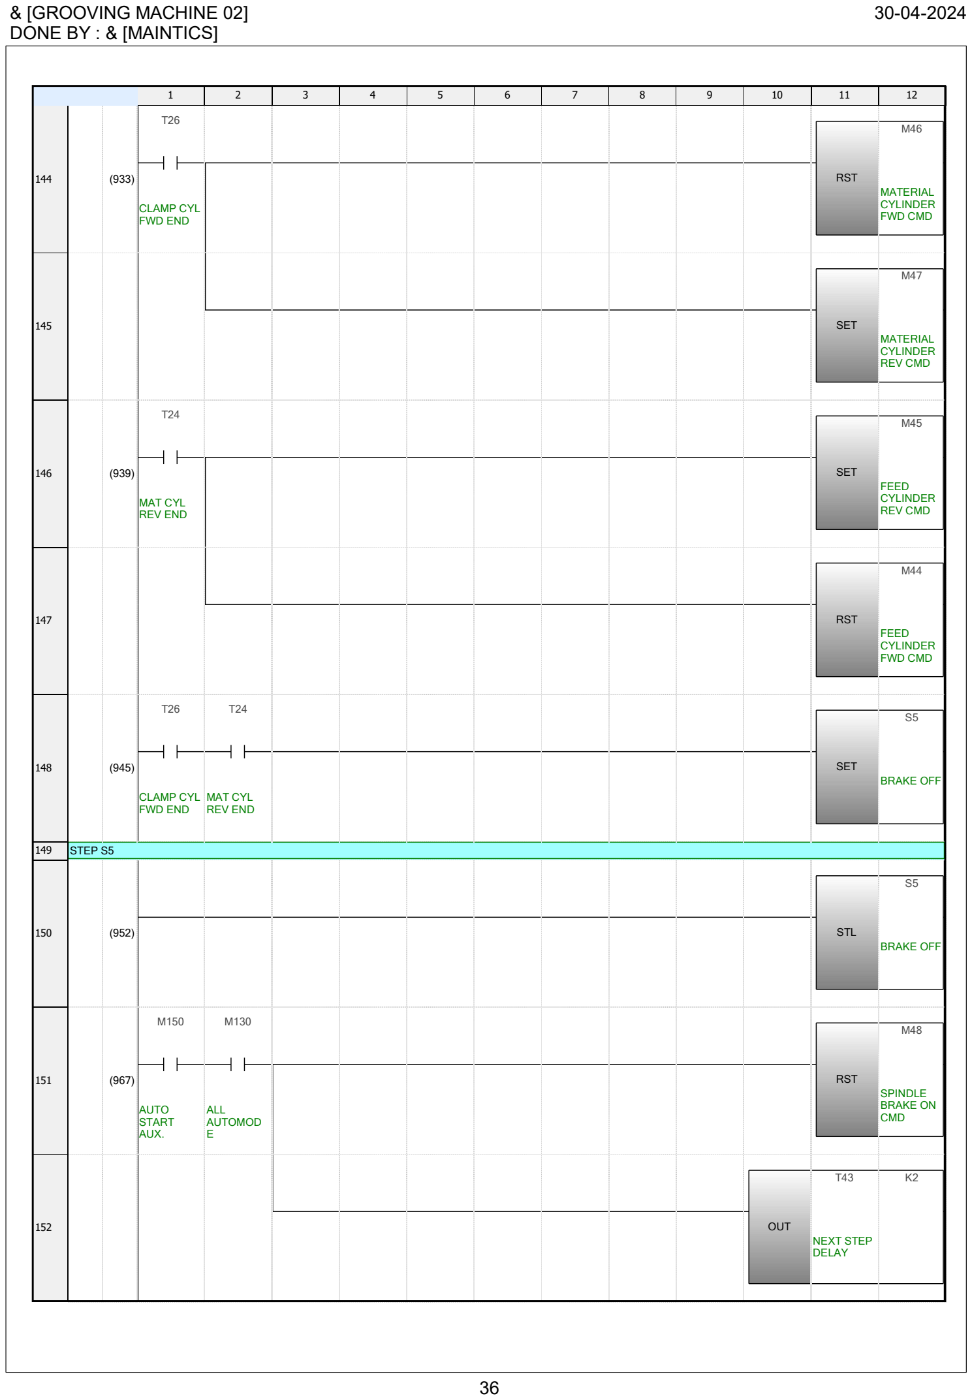
[picture p170: page 36]

36

1 | 2 | 3 | 4 | 5 | 6 | 7 | 8 | 9 | 10 | 11 | 12

144 (933)

T26

CLAMP CYL
FWD END

RST

M46

MATERIAL
CYLINDER
FWD CMD

145 SET

M47

MATERIAL
CYLINDER
REV CMD

146 (939)

T24

MAT CYL
REV END

SET

M45

FEED
CYLINDER
REV CMD

147 RST

M44

FEED
CYLINDER
FWD CMD

148 (945)

T26

CLAMP CYL
FWD END

T24

MAT CYL
REV END

SET

S5

BRAKE OFF

149 STEP S5

150 | (952) | STL

S5

BRAKE OFF

151 (967)

M150

AUTO
START
AUX.

M130

ALL
AUTOMOD
E

RST

M48

SPINDLE
BRAKE ON
CMD

152 OUT

T43

NEXT STEP
DELAY

K2

& [GROOVING MACHINE 02] | 30-04-2024

## DONE BY : & [MAINTICS]

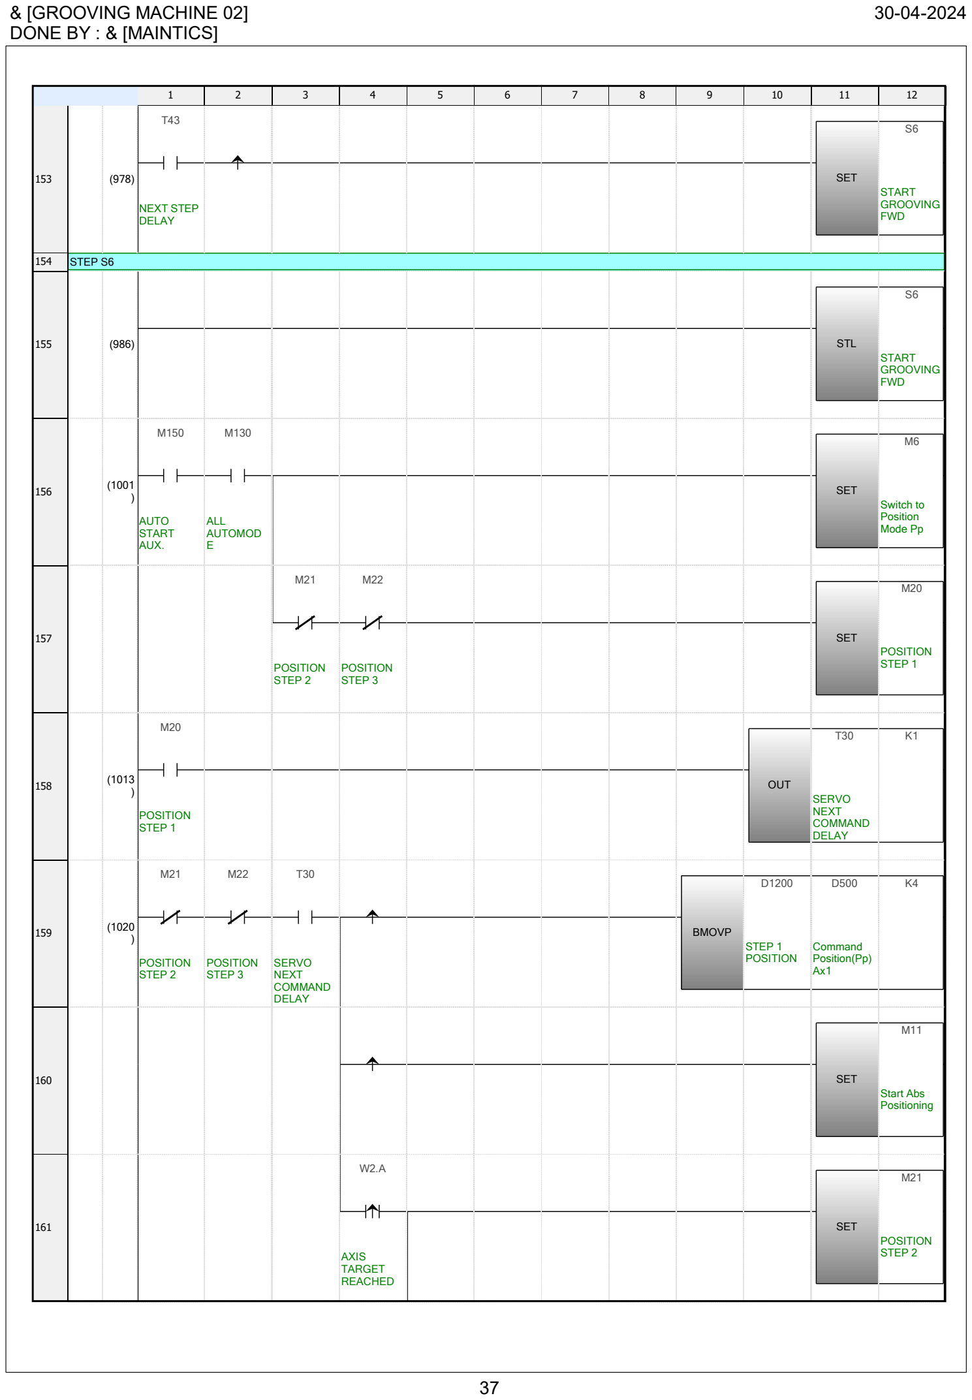
[picture p171: page 37]

37

1 | 2 | 3 | 4 | 5 | 6 | 7 | 8 | 9 | 10 | 11 | 12

153 (978)

T43

NEXT STEP
DELAY

SET

S6

START
GROOVING
FWD

154 STEP S6

155 | (986) | STL

S6

START
GROOVING
FWD

156 (1001
)

M150

AUTO
START
AUX.

M130

ALL
AUTOMOD
E

SET

M6

Switch to
Position
Mode Pp

157

M21

POSITION
STEP 2

M22

POSITION
STEP 3

SET

M20

POSITION
STEP 1

158 (1013
)

M20

POSITION
STEP 1

OUT

T30

SERVO
NEXT
COMMAND
DELAY

K1

159 (1020
)

M21

POSITION
STEP 2

M22

POSITION
STEP 3

T30

SERVO
NEXT
COMMAND
DELAY

BMOVP

D1200

STEP 1
POSITION

D500

Command
Position(Pp)
Ax1

K4

160 SET

M11

Start Abs
Positioning

161

W2.A

AXIS
TARGET
REACHED

SET

M21

POSITION
STEP 2

& [GROOVING MACHINE 02] | 30-04-2024

## DONE BY : & [MAINTICS]

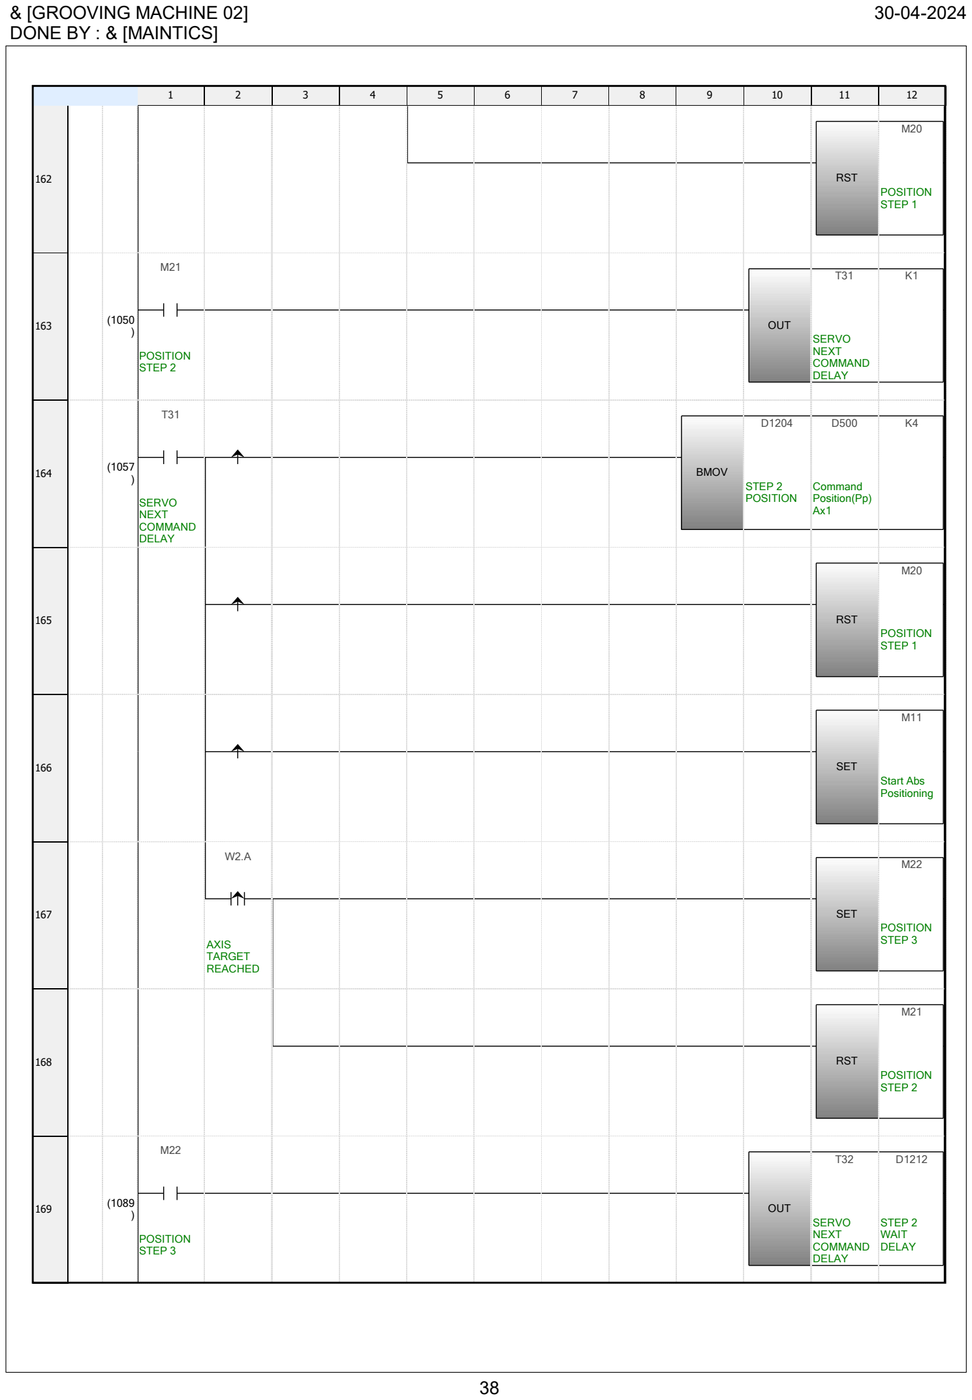
[picture p172: page 38]

38

1 | 2 | 3 | 4 | 5 | 6 | 7 | 8 | 9 | 10 | 11 | 12

162 RST

M20

POSITION
STEP 1

163 (1050
)

)

M21

POSITION
STEP 2

OUT

T31

SERVO
NEXT
COMMAND
DELAY

K1

164 (1057

T31

SERVO
NEXT
COMMAND
DELAY

BMOV

D1204

STEP 2
POSITION

D500

Command
Position(Pp)
Ax1

K4

165 RST

M20

POSITION
STEP 1

166 SET

M11

Start Abs
Positioning

167

W2.A

AXIS
TARGET
REACHED

SET

M22

POSITION
STEP 3

168 RST

M21

POSITION
STEP 2

169 (1089
)

M22

POSITION
STEP 3

OUT

T32

SERVO
NEXT
COMMAND
DELAY

D1212

STEP 2
WAIT
DELAY

& [GROOVING MACHINE 02] | 30-04-2024

## DONE BY : & [MAINTICS]

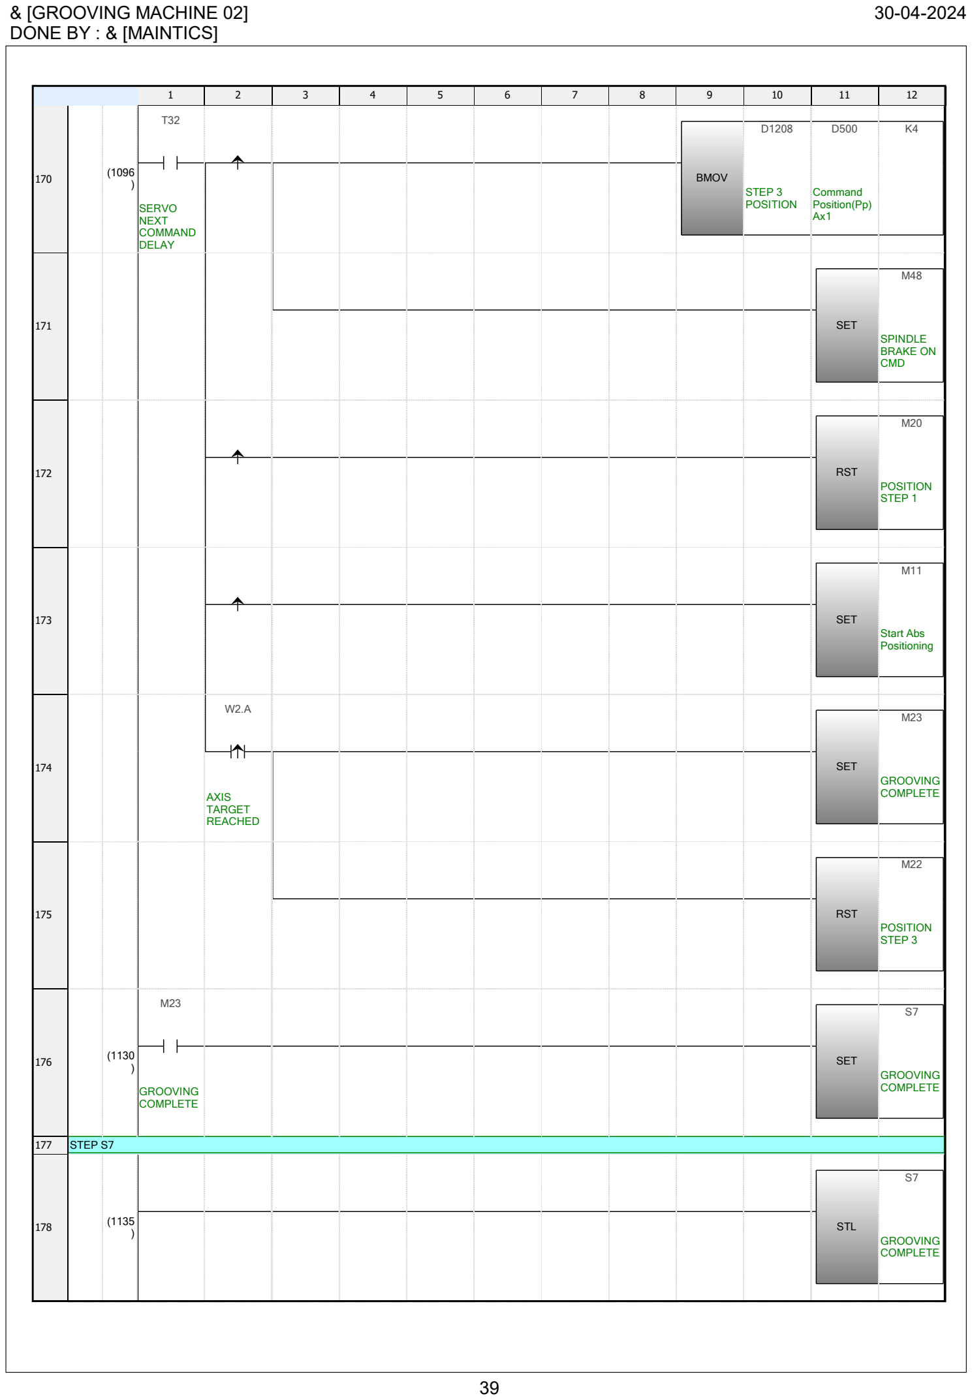
[picture p173: page 39]

39

1 | 2 | 3 | 4 | 5 | 6 | 7 | 8 | 9 | 10 | 11 | 12

170 (1096
)

T32

SERVO
NEXT
COMMAND
DELAY

BMOV

D1208

STEP 3
POSITION

D500

Command
Position(Pp)
Ax1

K4

171 SET

M48

SPINDLE
BRAKE ON
CMD

172 RST

M20

POSITION
STEP 1

173 SET

M11

Start Abs
Positioning

174

W2.A

AXIS
TARGET
REACHED

SET

M23

GROOVING
COMPLETE

175 RST

M22

POSITION
STEP 3

176 (1130
)

M23

GROOVING
COMPLETE

SET

S7

GROOVING
COMPLETE

177 STEP S7

178 (1135
)

STL

S7

GROOVING
COMPLETE

& [GROOVING MACHINE 02] | 30-04-2024

## DONE BY : & [MAINTICS]

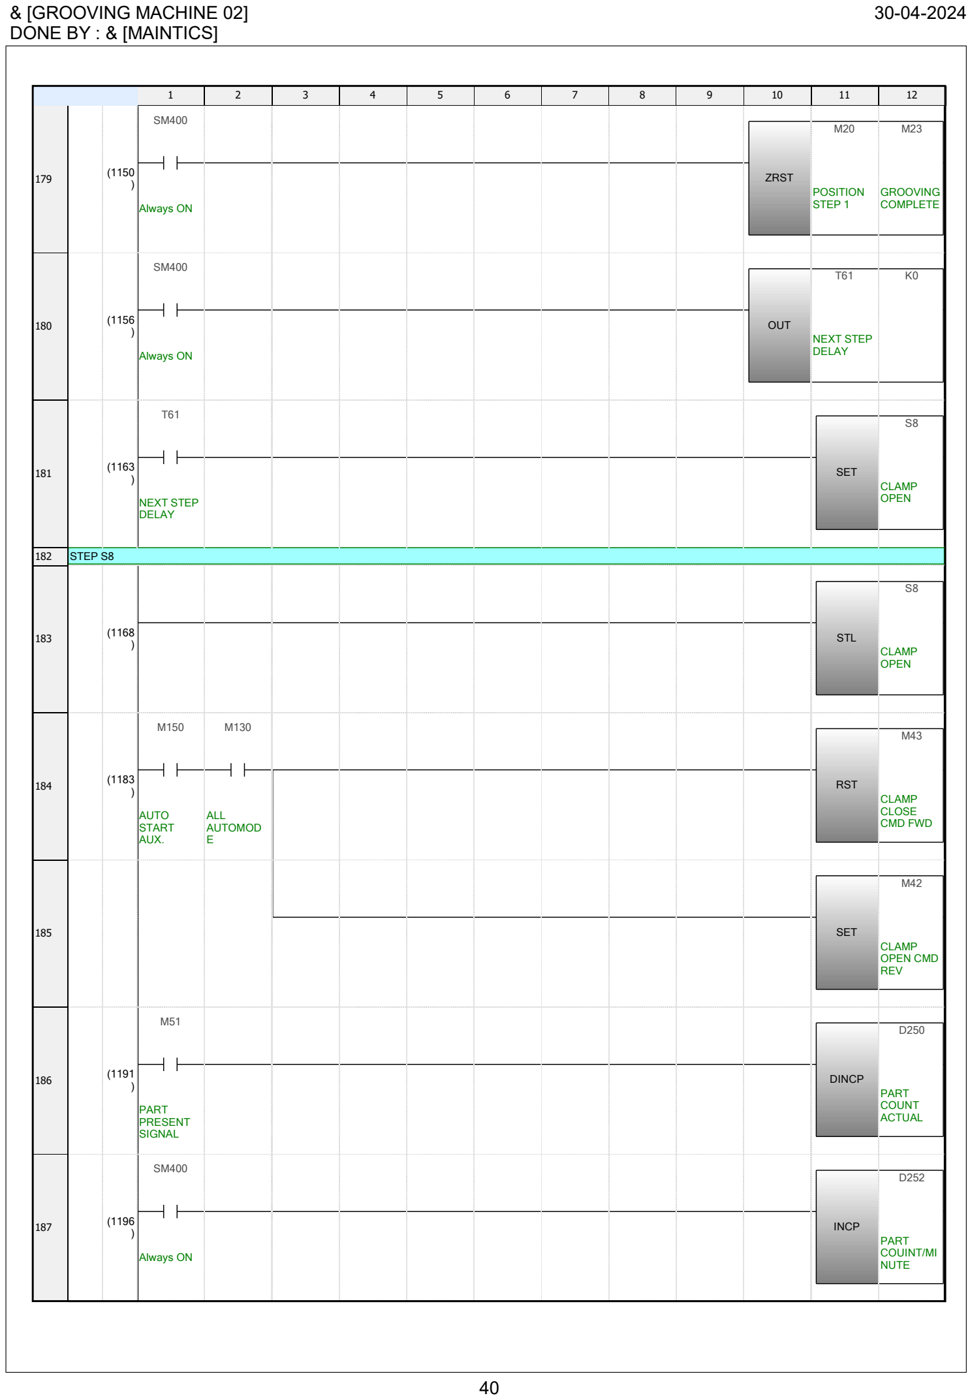
[picture p174: page 40]

40

1 | 2 | 3 | 4 | 5 | 6 | 7 | 8 | 9 | 10 | 11 | 12

179 (1150
)

SM400

Always ON

ZRST

M20

POSITION
STEP 1

M23

GROOVING
COMPLETE

180 (1156
)

SM400

Always ON

OUT

T61

NEXT STEP
DELAY

K0

181 (1163
)

T61

NEXT STEP
DELAY

SET

S8

CLAMP
OPEN

182 STEP S8

183 (1168
)

STL

S8

CLAMP
OPEN

184 (1183
)

M150

AUTO
START
AUX.

M130

ALL
AUTOMOD
E

RST

M43

CLAMP
CLOSE
CMD FWD

185 SET

M42

CLAMP
OPEN CMD
REV

186 (1191
)

M51

PART
PRESENT
SIGNAL

DINCP

D250

PART
COUNT
ACTUAL

187 (1196
)

SM400

Always ON

INCP

D252

PART
COUINT/MI
NUTE

& [GROOVING MACHINE 02] | 30-04-2024

## DONE BY : & [MAINTICS]

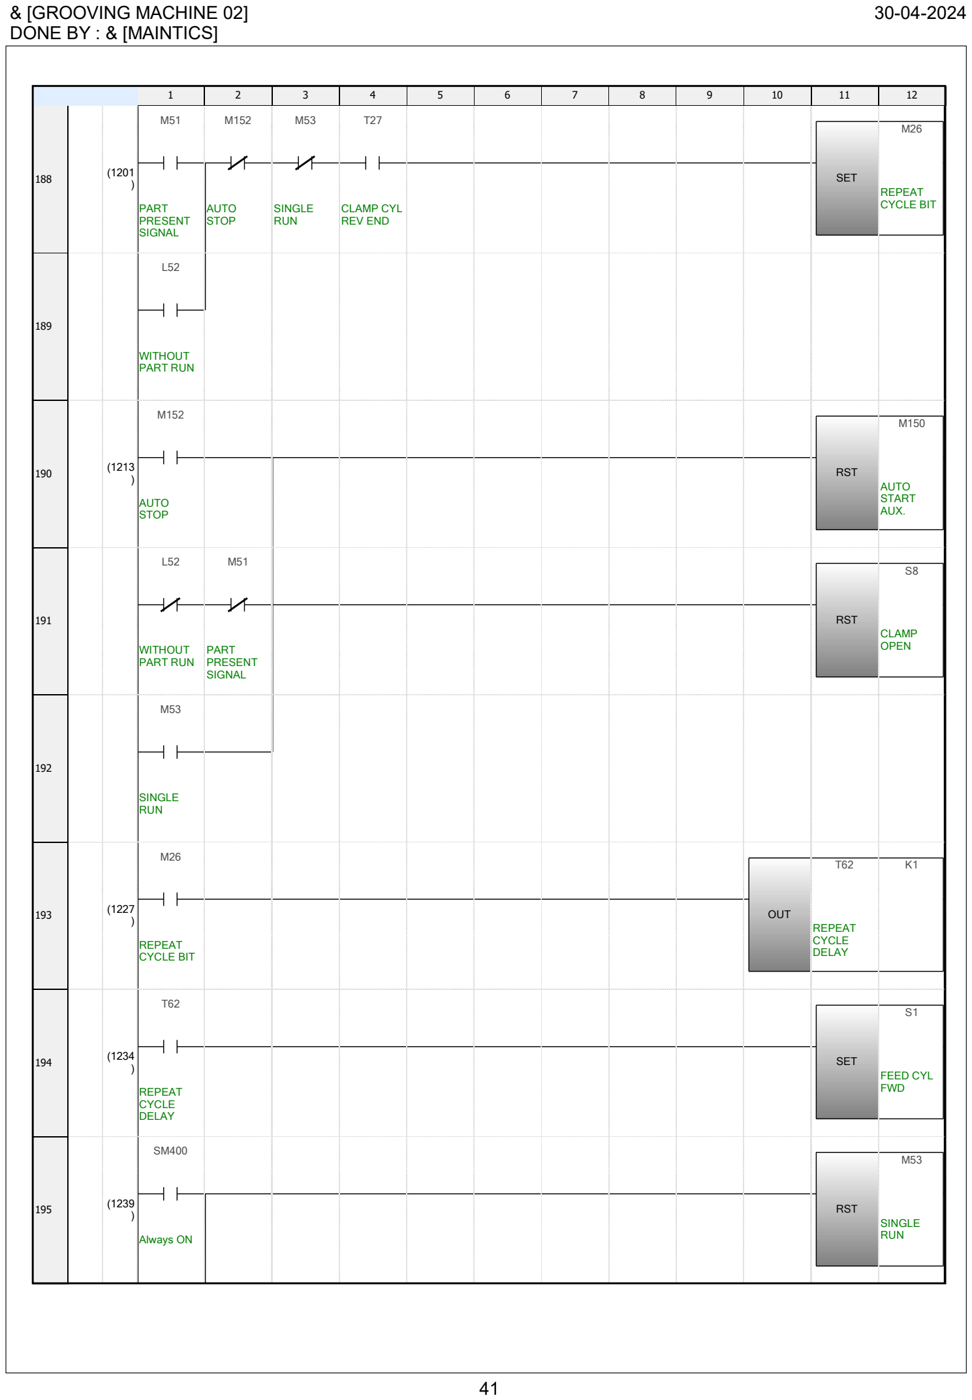
[picture p175: page 41]

41

1 | 2 | 3 | 4 | 5 | 6 | 7 | 8 | 9 | 10 | 11 | 12

188 (1201
)

)

M51

PART
PRESENT
SIGNAL

M152

AUTO
STOP

M53

SINGLE
RUN

T27

CLAMP CYL
REV END

SET

M26

REPEAT
CYCLE BIT

189

L52

WITHOUT
PART RUN

190 (1213

M152

AUTO
STOP

RST

M150

AUTO
START
AUX.

191

L52

WITHOUT
PART RUN

M51

PART
PRESENT
SIGNAL

RST

S8

CLAMP
OPEN

192

M53

SINGLE
RUN

193 (1227
)

M26

REPEAT
CYCLE BIT

OUT

T62

REPEAT
CYCLE
DELAY

K1

194 (1234
)

T62

REPEAT
CYCLE
DELAY

SET

S1

FEED CYL
FWD

195 (1239
)

SM400

Always ON

RST

M53

SINGLE
RUN

& [GROOVING MACHINE 02] | 30-04-2024

## DONE BY : & [MAINTICS]

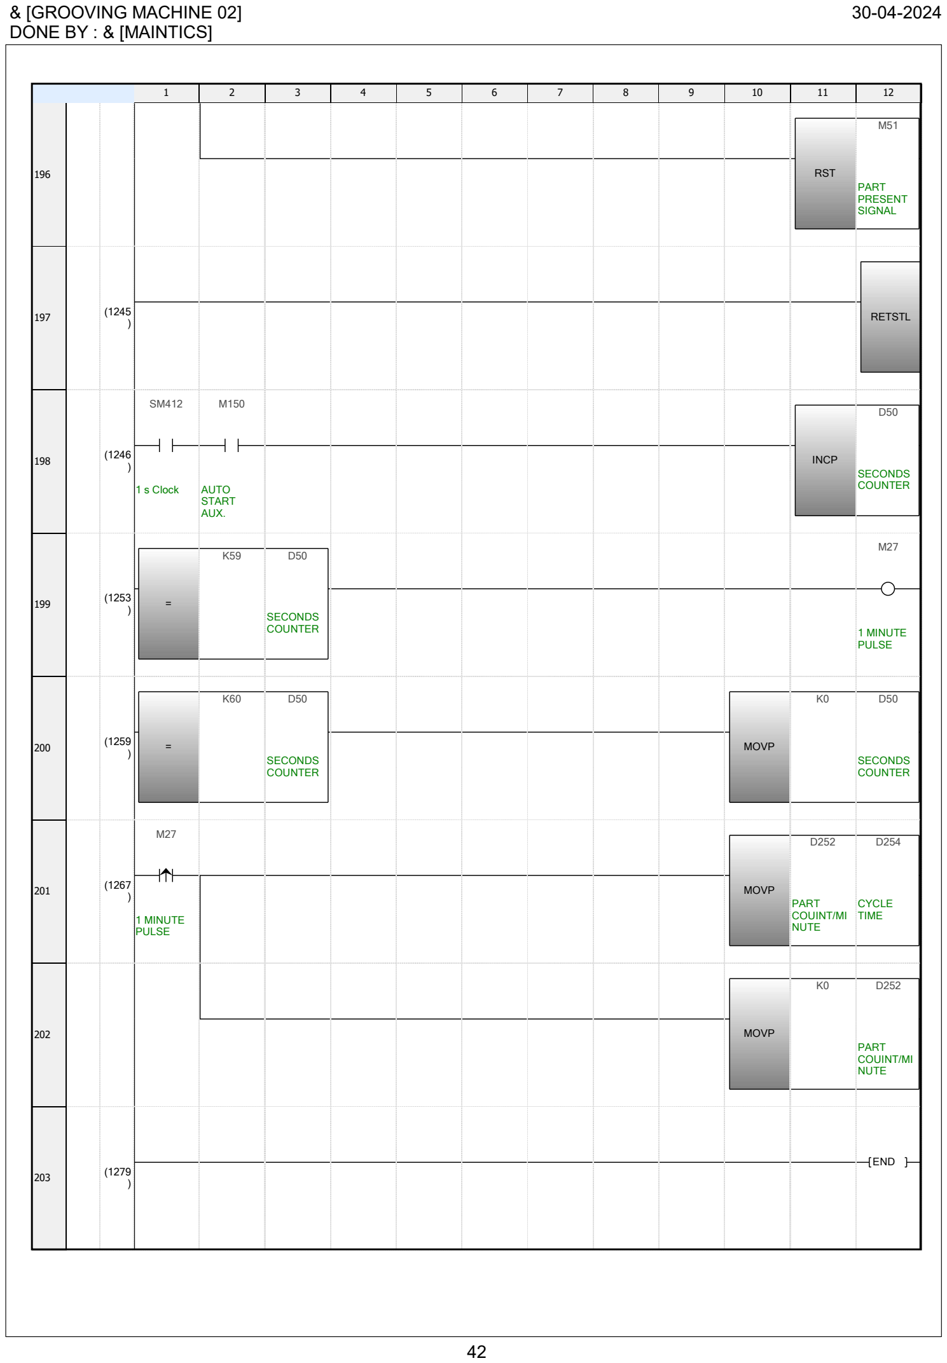
[picture p176: page 42]

42

1 | 2 | 3 | 4 | 5 | 6 | 7 | 8 | 9 | 10 | 11 | 12

196 RST

M51

PART
PRESENT
SIGNAL

197 (1245
)

) ) )

RETSTL

198 (1246

SM412

### 1 s Clock

M150

AUTO
START
AUX.

INCP

D50

SECONDS
COUNTER

199 (1253
=
K59 | D50

SECONDS
COUNTER

M27

### 1 MINUTE

PULSE

200 (1259
=
K60 | D50

SECONDS
COUNTER

MOVP

K0 | D50

SECONDS
COUNTER

201 (1267
)

M27

### 1 MINUTE

PULSE

MOVP

D252

PART
COUINT/MI
NUTE

D254

CYCLE
TIME

202 MOVP

K0 | D252

PART
COUINT/MI
NUTE

203 (1279
)

END
