amandalal143/github-demo-noval/Grooving Servo Machine/4. Drawing and Manual/Device Status.xlsx

Sheet: Sheet1
Sr. No. | Parameter Name | State 0 | State 1 | State 2 | Remarks
1 | Machine Ready | Not Ready | Ready |  | Machine ready status
2 | Manual Mode | Manual Mode | Auto Mode |  | Machine Auto/Manual Status
4 | Device Status | Device Off | Device ON
5 | Device Status | Device Ready | Device Alarm
6
7
8
9
10
11
12
13
14

Sheet: Sheet1 (2)
Sr. No. | Parameter Name | State 0 | State 1 | State 2 | Remarks
1 | Machine Ready | Not Ready | Ready |  | Machine ready status
2 | Manual Mode | Manual Mode | Auto Mode |  | Machine Auto/Manual Status
4 | Device Status | Device Off | Device ON
5 | Device Status | Device Ready | Device Alarm
6
7
8
9
10
11
12
13
14
