amandalal143/github-demo-noval/Grooving Servo Machine/4. Drawing and Manual/Maadhav Operation Manual02 v2.pptx

MAADHAV AUTOMOTIVE
FASTENERS PVT. LTD.

Product Manual

GROOVING MACHINE 02
(Electrical Renewal Project)
Done By
MAINTICS AUTOMATION & ROBOTICS LLP


## Table Of Contents

- Operation Manual
- Electrical Drawing
- Troubleshooting Guide
- BOM (Bill of Material)

(C) Maintics Automation & Robotics LLP

## Slide 3

Operation Manual

## Company Profile Screen


At first when you turn on the Machine this screen will open.
This is the Company Introduction screen.
Click anywhere in the screen to navigate on Main Menu

## 1. MAIN MENU SCREEN


This Screen is for Navigation inside the HMI of below screens.
Below are the list of all available screen in the HMI.
1. MACHINE MONITOR
2. DRIVE MONITOR
3. PART PROGRAM
4. MACHINE MODE SWITCH
5. SERVO SETTING
6. SERVO LOAD ANALYSIS
7. SERVO ALARM HISTORY
8. MANUAL OPERATION
9. INPUT MONITOR
10. OUTPUT MONITOR
11. MACHINE ALARMS
12. VFD ALARMS HISTORY

## 2. PROCESS MONITOR SCREEN


This screen is to Monitor Whole machine at Single Place

1. Machine Ready Status
2. Machine Auto / Manual Mode Status
3. Machine Auto Running Status
4. Device Running Status
5. Home Position Indication and Fault Indication

Machine at Home

Not Ready

Ready

Manual Mode

Auto Mode

Machine Stopped

Auto Running

Device OFF

Device Running

Not at Home

Normal

Machine Fault

## Slide 7

2. PROCESS MONITOR SCREEN

This screen is to Monitor Whole machine at Single Place

6. Total Parts count & Cumulative Counter and Cycle time … Parts/min.
7. Machine Inputs Monitoring (Cylinder Reed switch)
8. Navigation Bar

Here you can monitor all reed switch condition On or Off.
- Feed Cylinder
- Material Cylinder
- Clamp Cylinder
- X Axis Servo position
- SPINDLE MOTOR STATUS
(Monitor Running Frequency & Current)

Used to easily navigate from one screen to another screen


## Slide 8

2. PROCESS MONITOR SCREEN

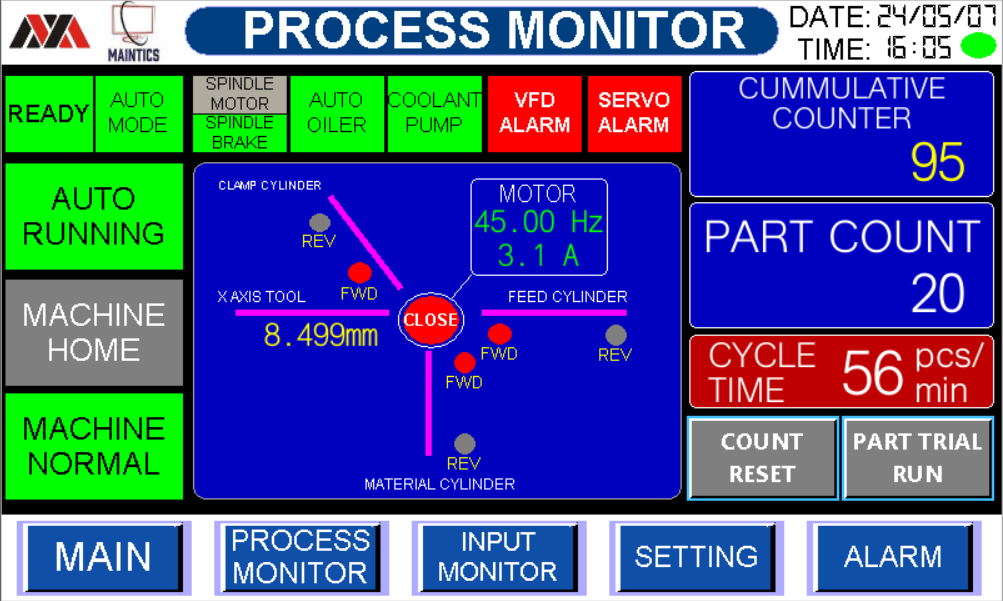
[picture p177: figure]

This screen is used to Machine Monitor current alarms & Status

1. Servo & VFD Alarm Status

Servo & VFD Alarm ON SERVO & VFD Is Ready to Use

2. COUNTER RESET & PART TRIAL RUN Status

*Counter Reset Button is ON

To Reset Part Count, Press this Button for 2second.

*Part trial Button is ON


This Button used for part trial.

(Machine for run for 1cycle only)

## Slide 9

3. INPUT MONITOR SCREEN


This screen is to monitor all PLC Inputs total 16 Nos.

1. All inputs status from Off to On is as below.

INPUT OFF

INPUT ON

MACHINE EMARGENCY PRESSED

MACHINE EMARGENCY NOT PRRESSED

## Slide 10

4. OUTPUT MONITOR SCREEN


This screen is to monitor all PLC Outputs total 16Nos.

1. All Output status from Off to On is as below.

OFF
ON

## Slide 11

5. ALARM MONITOR SCREEN


This screen is used to monitor machine current alarms

1. Alarm screen navigation buttons
2. Reset button to reset current Alarms
3. Alarm History Screen access Button

## Slide 12

5. ALARM HISTORY SCREEN


This screen is used to monitor machine current alarms

1. Alarm screen navigation buttons
2. Reset button to reset current Alarms
3. Alarm History Screen access Button

## Slide 13

6. MODE SELECT SETTING SCREEN

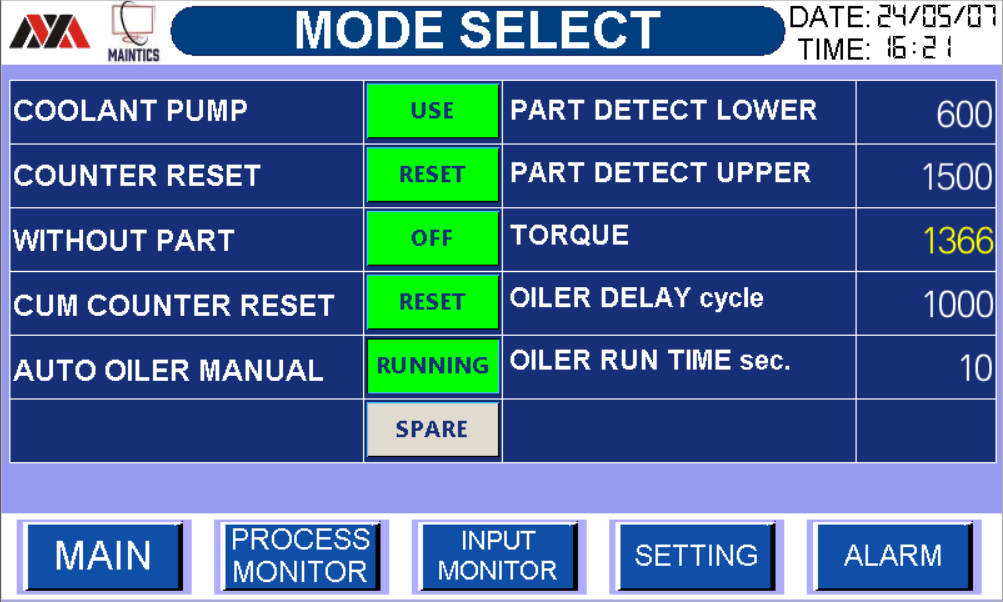
[picture p178: figure]

Machine Settings can be done from this screen.

1. COOLENT PUMP ON Condition
2. COOLENT PUMP Off (Bypass) Condition
3. COUNTER RESET BUTTION
4. WITHOUT Part OFF Condition
5. WTIHOUT Part ON Condition (Machine run without part also)

## Slide 14

6. MODE SELECT SETTING SCREEN

Machine Settings can be done from this screen.

1. PART DETECT LOWER
* Here You Can Change part Detect Lower Value.
2. PART DETECT UPPER
* Here You Can Change Part Detect Upper Value.
3. Here You Can Chack Live SERVO MOTOR TORQUE.
* Make sure current torque is with in the range
of part detect lower & upper value then it part
is counted by counter And if this condition is not
satisfied the part will not count.

## Slide 15

6. MODE SELECT SETTING SCREEN

Machine Settings can be done from this screen.

4. OILER DELAY Cycle
* Here you can change Oiler Delay Cycle value.
(After 1000 parts cycle Oiler pump will ON)
5 OILER RUN TIME Sec.
* Here you can change Oiler Run Time Sec.
(After 1000 parts pump ON for 10sec.)
6. COMMULATIVE COUNTER RESET BUTTION
7. AUTO OILER ON Condition (Press this button to run pump manually )

## Slide 16

7. MANUAL OPEARTION 1 SCREEN


Manual Operation of all device can be performed using this screen

1. Steps for manual operation
  a. First check Fault Light it should be Off
  b. Now check Ready Light it should be Green
  c. Now press Auto Manual selector switch to change mode from Auto to manual
  d. Now Press Start Button to Start the Device
  e. It will glow green if device is started.

## Slide 17

8. PART PROGRAM SCREEN


1. Here you can change grooving Program
a) DWELL VALUE. * (Here you Can Change Dwell
time 2.5sec wait Delay Value.)
b) OFFSET VALUE. * (Here you can set Part Offset
Value.)
c) GRONING DATA VALUE. * (Here you can set Grooving
Data Value.)
d) FORWARD SPEED VALUE. * (Here you can set Servo
Forward SPEED VALUE.)
e) GROOVING SPEED VALUE. * (Here you can set Servo
Grooving SPEED VALUE.)

## Slide 18

8. PART PROGRAM SCREEN

1. Here you can change grooving Program

f) Reverse SPEED VALUE (Here you can change
Servo Reverse Speed
Value. )

2. Here you can monitor POSITIONING MODE &
JOG MODE
a) Here You can monitor
POSITION MODE is ON .
b) Here You can monitor Jog
MODE is ON .

## Slide 19

9. SERVO LOAD SCREEN


1. SERVO LOAD GRAPH
  a. You Can monitor servo Torque Trend live.

## Slide 20

10. SERVO SETTING SCREEN


* Here you can enter the Required Password.

- Here you can monitor entered Password is correct
. And after homing complete 1cycle Logout Automatically.

2 SERVO MOTOR JOG SPEED.
JOG SPEED MIN MAX
(0.01mm/s) (10.00mm/s)

## Slide 21

10. SERVO SETTING SCREEN

1 SERVO MOTOR HOMING Monitoring STATUS
a) SERVO CURRENT OPSOTION (10.000mm)
b) SERVO CURRENT SPEED (-0.170mm/s)
c) SERVO CURRENT TORQUE (1.1%)

3 Servo Homing

a) Here you can enter password by clicking on Login Button, Now Press START HOMING Button for 2 Second and servo will Start homing Automatically (Pass: 12345)

* Machine Homing Button OFF.

* Machine Homing is in progress.

* Machine Homing Mode is ON.

## Slide 22

11. DRIVE MONITOR SCREEN


DRIVE MONITOR STATUS
1. Here you can monitor SERVO & VFD STATUS
SERVO .
a) Here you can monitor servo current position.
b) Here you can monitor servo current speed.
c) Here you can monitor servo Current Torque.
VFD
a) Here you can monitor VFD Frequency.
b) Here you can monitor VFD Voltage.
c) Here you can monitor VFD Current.
d) Here you can monitor VFD Alarm Code.
2. Here you can change SPINDLE SPEED Using Frequency (Hz)
MIN MAX
25Hz 60Hz

## Electrical Drawings

## Troubleshooting Guide

## Slide 25

1. HMI ALARM GUIDE

## Slide 26

2. MACHINE AUTO RUNNING FLOW

STOP

START PB

MACHINE HOME

MACHINE AUTO

Check Reed Switch
X20, X22 if NO

NO

YES

Check Manual Screen
If NO

NO

YES

Check Alarm Screen
For any alarm reset alarm before if NO

MACHINE NORMAL

NO (FAULT)

YES

AUTO RUNNING

## BOM (BILL OF MATERIAL)

## Slide 28

1. LIST OF ITEMS USED
