amandalal143/github-demo-noval/Grooving Servo Machine/4. Drawing and Manual/HMI ALARMS troubleshoot details for madhav.xlsx

Sr. No. | FAULT | CAUSE | CHECK METHOD | Check Result | ACTION
1 | EMERGENCY FAULT | 1.Emergency button is pressed | Check emergency button, it should be released | Pressed | Release EMG button
 |  |  |  | Released | check step 2
 |  | 2.CP01 is trip | Check CP01 ,it should be on | Off | Turn on the CP01
 |  |  |  | ON | Check step 03
 |  | 3.Wiring disconnect | Check wiring | Wiring OK | Replace the Emergency Switch
 |  |  |  | Wiring NG | Correct the wiring as per wiring diagram
2 | FEED CYLINDER TIME OVER | 1.Air pressure low | Check main air pressure | NG | Check air pipe or supply pressure
 |  |  |  | OK | check step 02
 |  | 2. Cylinder stuck in mid way | Any obstacle available in the way of feed cylinder | NG | clear obstacle in way of cylinder
 |  |  |  | OK | check step 03
 |  | 3.Read Switch position incorrect | Check read switch position on cylinder | NG | correct the read switch position
 |  |  |  | OK | check step 04
 |  | 4.Read switch wiring | Check read switch wiring | NG | correct the wiring
 |  |  |  | OK | Replace the Read switch
3 | FEED CYLINDER READ SWITCH FAULT | 1.Read Switch position incorrect | Check read switch position on cylinder | NG | correct the read switch position
 |  |  |  | OK | check step 02
 |  | 2.Read switch wiring | Check read switch wire condition for any cut | NG | correct the read switch wiring
 |  |  |  | OK | check step 03
 |  | 3. Read switch short circuit | Always on signal available | NG | Replace Read Switch
4 | MATERIAL CYLINDER TIME OVER | 1.Air pressure low | Check main air pressure | NG | Check air pipe or supply pressure
 |  |  |  | OK | check step 02
 |  | 2. Cylinder stuck in mid way | Any obstacle available in the way of material cylinder | NG | clear obstacle in way of cylinder
 |  |  |  | OK | check step 03
 |  | 3.Read Switch position incorrect | Check read switch position on cylinder | NG | correct the read switch position
 |  |  |  | OK | check step 03
 |  | 4.Read switch wiring | Check read switch wiring | NG | correct the wiring
 |  |  |  | OK | Replace the Read switch
5 | MATERIAL CYLINDER READ SWITCH FAULT | 1.Read Switch position incorrect | Check read switch position on cylinder | NG | correct the read switch position
 |  |  |  | OK | check step 02
 |  | 2.Read switch wiring |  | NG | correct the read switch wiring
 |  |  |  | OK | check step 03
 |  | 3. Read switch short circuit | Always on signal available | NG | Replace the Read Switch
6 | CLAMP CYLINDER TIME OVER | 1.Air pressure low | Check main air pressure | NG | Check air pipe or supply pressure
 |  |  |  | OK | check step 02
 |  | 2. Cylinder stuck in mid way | Any obstacle available in the way of clamp cylinder | NG | clear obstacle in way of cylinder
 |  |  |  | OK | check step 03
 |  | 3.Read Switch position incorrect | Check read switch position on cylinder | NG | correct the read switch position
 |  |  |  | OK | check step 03
 |  | 4.Read switch wiring | Check read switch wiring | NG | correct the wiring
 |  |  |  | OK | Replace the Read switch
7 | CLAMP CYLINDER READ SWITCH FAULT | 1.Read Switch position incorrect | Check read switch position on cylinder | NG | correct the read switch position
 |  |  |  | OK | check step 02
 |  | 2.Read switch wiring |  | NG | correct the read switch wiring
 |  |  |  | OK | check step 03
 |  | 3. Read switch short circuit | Always on signal available | NG | Replace Read Switch
8 | AXIS 1 SERVO ALARM | Fault present on servo amplifier | Check servo alarm history screen in HMI |  | Troubleshoot according to alarm description as per device model manual
9 | SPINDLE VFD ALARM | Fault present on spindle VFD | Check VFD alarm history screen in HMI |  | Troubleshoot according to alarm description as per device model manual
10 | MACHINE HOME REQUIRED | Servo absolute position data lost due to encoder cable disconnection or amplifier battery disconnection. | 1.Check Encoder cable connection from servo amplifier to servo motor |  | Do homing from HMI after checking all check points refer manual for homing process
 |  |  | 2.Check Servo battery connection
 |  |  | 3.Check servo alarm history for actual reason behind the fault
11 | AXIS 1 FORWARD LIMIT | 1.Servo is trying to move beyond forward limit | Check part program in HMI |  | Check grooving data ,it may be entered incorrectly, if it ok go to step 2
 |  | 2.Forward limit sensor faulty | Check sensor range using metal part detection method |  | If sensor is working properly go to step 3
 |  | 3.Forward limit sensor cable faulty | Check sensor cable healthy or faulty |  | If cable is faulty, Replace the cable ,If cable is healthy go to step 4
 |  | 4.Metal dust on sensor | Check dust on the sensor |  | Clean the sensor
12 | AXIS 1 REVERSE LIMIT | 1.Servo is trying to move beyond Reverse limit | Check part program in HMI |  | Check grooving data ,it may be entered incorrectly, if it ok go to step 2
 |  | 2.Reverse limit sensor faulty | Check sensor range using metal part detection method |  | If sensor is working properly go to step 3
 |  | 3.Reverse limit sensor cable faulty | Check sensor cable healthy or faulty |  | If cable is faulty, Replace the cable ,If cable is healthy go to step 4
 |  | 4.Metal dust on sensor | Check dust on the sensor |  | Clean the sensor
13 | SERVO COMMUNICATION ERROR | 1.Servo communication signal lost | Check servo LAN cable and connection | NG | Correct the LAN cable
 |  |  |  | OK | Check step 2
 |  | 2.Parameter setting incorrect | Check the parameter setting(like IP) (contact MAINTICS for this task) |  | Correct the parameter setting according to device model manual
 |  | 3.Drive power off | Check drive MCB status | NG | Turn ON the MCB
 |  |  |  | OK | CONTACT MAINTICS
14 | AXIS 1 SERVO WARNING | 1.Fault present on servo amplifier | Check servo alarm history screen in HMI |  | Troubleshoot according to alarm description as per device model manual
15 | VFD COMMUINCATION ERROR | VFD communication signal lost | Check VFD RS-485 cable connection | NG | Correct the RS-485 cable
 |  |  |  | OK | Check step 2
 |  | Parameter setting incorrect | Check parameter setting | NG | Correct the parameter setting
 |  |  |  | OK | Check step 3 & CONTACT MAINTICS.
 |  | Drive power off | Check drive MCB status | NG | Turn ON the MCB
 |  |  |  | OK | CONTACT MAINTICS
